ultrazohm/uz_a_ltc2311-16/-5V_PCB/PowerManagement_neg5V/Project Outputs for PowerManagement_neg5V/BOM/BOM_PowerManagement_neg5V_1v03.xls

Quantity | Comment | Designator | MF | MPN | Value | Description | Footprint | Package | Voltage | Dielectric | Supplier 1 | Supplier Part Number 1 | Supplier 2 | Supplier Part Number 2 | Supplier 3 | Supplier Part Number 3
3 | 220µF | C1, C8, C20 | Würth Elektronik | 860020574012 | 220 µF | WCAP-ATG5 Aluminum Electrolytic Capacitors, 8x11.5mm, 35 Vdc, 220 uF | WCAP-ATG5_8x11.5x3.5 |  | 35 Vdc, 35Vdc |  | Mouser | 710-860020574012
2 | 10nF | C2, C14 | Würth | 885012206065 | 10nF |  | CAPC1608X07N | 603 | 25V | X7R | Mouser | 710-885012206065 | Digi-Key | 732-7983-1-ND
2 | 7.5nF | C3, C15 | KEMET | C0603C752J3GACTU | 7.5nF |  | CAPC1608X07N | 603 | 25V | C0G | Mouser | 80-C0603C752J3GACTU
4 | 10µF | C4, C5, C16, C17 | Murata Electronics | GRT31CC8YA106KE01L | 10µF | Capacitor 1206 | C_1206 | 1206 | 35V | X6S | Mouser | 81-GRT31CC8YA106KE1L
7 | 100nF | C6, C9, C21, C31, C32, C33, C34 | Würth | 885012206071 | 100nF |  | CAPC1608X07N | 603 | 25V | X7R | Mouser | 710-885012206071 | Digi-Key, [NoValue] | 732-7989-1-ND, [NoValue]
2 | 0.027µF | C7, C19 | Murata Electronics | GRM3195C1H273JA01D | 0.027µF | Capacitor 1206 | C_1206 | 1206 | 50V | C0G | Mouser | 81-GRM315C1H273JA01D
4 | 47µF | C10, C11, C22, C23 | Murata Electronics | GRM31CR61A476ME15L | 47µF | Capacitor 1206 | C_1206 | 1206 | 10V | X5R | Mouser | 81-GRM31CR61A476ME5L
4 | 1µF | C12, C13, C24, C25 | Murata Electronics | GRT188R61H105KE13D | 1µF |  | CAPC1608X07N | 603 | 50V | X5R | Mouser | 81-GRT188R61H105KE3D | Digi-Key | 490-12330-1-ND
1 | 100nF | C18 | Taiyo Yuden | GMK107B7104KAHT | 100nF |  | CAPC1608X07N | 603 | 35V | X7R | Mouser | 963-GMK107B7104KAHT | Digi-Key | 587-3354-1-ND
2 | 56pF | C26, C30 | Vishay | VJ0603A560JXACW1BC | 56pF |  | CAPC1608X07N | 603 | 50V | C0G | Mouser | 77-VJ0603A560JXACBC
2 | 680pF | C27, C29 | Vishay | VJ0603A681GXJCW1BC | 680pF |  | CAPC1608X07N | 603 | 16V | C0G | Mouser | 77-VJ0603A681GXJCBC
1 | 470pF | C28 | Vishay | VJ0603A471JXJCW1BC | 470pF |  | CAPC1608X07N | 603 | 16V | C0G | Mouser | 77-VJ0603A471JXJCBC
2 | BYS12-90 | D1, D2 | Vishay | BYS12-90-E3/TR3 |  | Schottky Diode | DIOM4227X23N | DO-214AC |  |  | Farnell | 2889144 | Mouser | 625-BYS12-90-E3/TR3 | Digi-Key | BYS12-90-E3/GICT-ND
2 | 1714955 | J1, J2 |  |  |  | Conn Terminal Blocks 2 POS 6.35mm Solder ST Thru-Hole 32A | PHOE-1714955_V |  | 300V |  | Mouser | 651-1714955
2 | TSW-102-07-S-S | J3, J8 |  |  |  | SAMTEC TSW-102-07-S-S CONNECTOR, HEADER, 2 POSITION, 1ROW, 2.54MM | SMTC-TSW-102-07-S-S |  |  |  | Mouser | 200-TSW10207SS
4 | 5-1634503-1 | J4, J5, J6, J7 |  |  |  | BNC Str PCB Skt 50Ohm Nickel Pltd | TECO-5-1634503-1_V |  |  |  | Mouser | 571-5-1634503-1
2 | 600Ω | L1, L3 | Würth Elektronik, Wurth Elektronik | 742792040 | 600Ω | WE-CBF SMD EMI Suppression Ferrite Bead, 0805, 600Ω | WE-CBF_0805_High Current |  |  |  | Farnell | 2761567, 1635735 | Mouser | 710-742792040 | Digi-Key | 732-1620-1-ND
2 | 150µH | L2, L4 | EPCOS / TDK | B82464G4154M | 150µH | SMT power Inductor, 150uH, 320m DRC | SMT_inductor_1050_Performance |  |  |  | Mouser | 871-B82464G4154M
4 | mounting hole 3,4mm | MH1, MH2, MH3, MH4 |  |  |  | Non plated through hole, 3.4mm | MH_3.4
2 | 162k | R1, R7 | Bourns | CR0603-FX-1623ELF | 162k |  | RESC1608X06N | 603 |  |  | Mouser | 652-CR0603-FX1623ELF
2 | 75k | R2, R8 | Yageo | AC0603FR-1375KL | 75k |  | RESC1608X06N | 603 |  |  | Mouser | 603-AC0603FR-1375KL
8 | 1k | R3, R6, R9, R12, R13, R14, R18, R21 | Vishay / Dale | CRCW06031K00JNEAC | 1k |  | RESC1608X06N | 603 |  |  | Mouser | 71-CRCW06031K00JNEAC
4 | dnp | R4, R10, R20, R23 |  |  | dnp |  | RESC1608X06N | 603
2 | 133k | R5, R11 | Bourns | CR0603-FX-1333ELF | 133k |  | RESC1608X06N | 603 |  |  | Mouser | 652-CR0603FX-1333ELF
2 | 24R9 | R15, R17 | Yageo | RC0603FR-1324R9L | 24R9 |  | RESC1608X06N | 603 |  |  | Mouser | 603-RC0603FR-1324R9L
1 | dnp | R16 | ARCOL/Ohmite | APC1206B200RN | dnp | WID SMD 1M 5% 0,25W | RESC3216X65N |  |  |  | Mouser | 284-APC1206B200RN
1 | 0R | R19 | Vishay / Dale | CRCW06030000Z0EBC | 0R |  | RESC1608X06N | 603 |  |  | Mouser | 71-CRCW06030000Z0EBC
2 | 10k | R22, R24 | Vishay / Dale | CRCW060310K0FKEAC | 10k |  | RESC1608X06N | 603 |  |  | Mouser | 71-CRCW060310K0FKEAC
1 | 24V_P | TP1 |  |  |  | Test Point; Compact; THM; PC; .350 L; .125 OD; Heat Resistant Nylon 46; Black | TP_5006 |  |  |  | Mouser | 534-5006
1 | +5V | TP2 |  |  |  | Test Point; Compact; THM; PC; .350 L; .125 OD; Heat Resistant Nylon 46; Black | TP_5006 |  |  |  | Mouser | 534-5006
2 | GND | TP3, TP11 |  |  |  | Test Point; Compact; THM; PC; .350 L; .125 OD; Heat Resistant Nylon 46; Black | TP_5006 |  |  |  | Mouser | 534-5006
1 | SW_N | TP4 |  |  |  | Test Point; Compact; THM; PC; .350 L; .125 OD; Heat Resistant Nylon 46; Black | TP_5006 |  |  |  | Mouser | 534-5006
1 | 24V_N | TP5 |  |  |  | Test Point; Compact; THM; PC; .350 L; .125 OD; Heat Resistant Nylon 46; Black | TP_5006 |  |  |  | Mouser | 534-5006
1 | FB_N | TP6 |  |  |  | Test Point; Compact; THM; PC; .350 L; .125 OD; Heat Resistant Nylon 46; Black | TP_5006 |  |  |  | Mouser | 534-5006
1 | -5V | TP7 |  |  |  | Test Point; Compact; THM; PC; .350 L; .125 OD; Heat Resistant Nylon 46; Black | TP_5006 |  |  |  | Mouser | 534-5006
1 | AMP+ | TP8 |  |  |  | Test Point; Compact; THM; PC; .350 L; .125 OD; Heat Resistant Nylon 46; Black | TP_5006 |  |  |  | Mouser | 534-5006
1 | AMP- | TP9 |  |  |  | Test Point; Compact; THM; PC; .350 L; .125 OD; Heat Resistant Nylon 46; Black | TP_5006 |  |  |  | Mouser | 534-5006
1 | PD | TP10 |  |  |  | Test Point; Compact; THM; PC; .350 L; .125 OD; Heat Resistant Nylon 46; Black | TP_5006 |  |  |  | Mouser | 534-5006
2 | LM5007 | U1, U2 | Texas Instruments | LM5007MM/NOPB |  | Buck Converter, 9-75Vin, 2.5-73Vout | TSOP65P490X110-8N | VSSOP-8 |  |  | Farnell | 3007210 | Mouser | 926-LM5007MM/NOPB | Digi-Key | 296-LM5007MM/NOPBCT-ND
1 | LT6203 | U3 | Analog Devices / Linear Technology | LT6203CMS8#PBF |  | 2 Ch Low Noise, Low Power OpAmp | MSOP8_3x3-8N | MSOP-8 |  |  | Mouser | 584-LT6203CMS8#PBF
1 | THS4521 | U4 |  |  |  | IC AMP RRO NEG OUT VLP 8VSSOP (Single Channel fully differential Amplifier) | DGK0008A_N |  |  |  | Mouser | 595-THS4521IDGKR
