ultrazohm/uz_a_ltc2311-16/Bestuecker_Files/Rev.06/Haushofer_Beistellung_März2022.xlsx

Quantity per PCB | Comment | Designator | MF | Description | Benötigt für 20 PCBs | Aktuell im ZC Lager | Bestellungen | Beigestellte Menge | Shop | Bilanz | ETA
1 | LMK1C1108 | U5 | Texas Instruments | 4-channel output LVCMOS 1.8-V buffer | 20 | 9 | 125 | 25 | digi-key (100) & Mouser (25) | 114 | Mouser delivered | https://www.mouser.de/OrderHistory/OrderDetail.aspx | https://www.digikey.de/MyDigiKey/ReviewOrder | https://wwwapps.ups.com/tracking/tracking.cgi?tracknum=1ZWA47976635939104&requester=ST/trackdetails
1 | LP2985A-25 | U2 | Texas Instruments | 150mA, LDO, Vout = 2.5V, Vin,max = 16V | 20 | 8 | 50 | 50 | Mouser | 38 | delivered | https://www.mouser.de/OrderHistory/OrderDetail.aspx
1 | LT6654-5 | U3 | Analog Devices | 5V Spannungsreferenz | 20 | 0 | 25 | 25 | Mouser | 5 | delivered
1 | BUF634AIDR | U11 | Texas Instruments | IC OP AMP BUFFER 8SOIC | 20 | 0 | 25 | 25 | Mouser | 5 | delivered
8 | THS4561 | U15A, U15B, U15C, U15D, U15E, U15F, U15G, U15H | Texas Instruments | IC AMP RRO NEG OUT VLP 8VSSOP (Single Channel fully differential Amplifier) | 160 | 40 | 130 | 170 | Mouser | 10 | delivered
8 | LT6203 | U7A, U7B, U7C, U7D, U7E, U7F, U7G, U7H | Linear Technology | 2 Ch Low Noise, Low Power OpAmp | 160 | 13 | 170 | 170 | RS | 23 | delivered
1 | IPL1-108-01-L-D-RA-K | X2 | SAMTEC |  | 20 | 0 | 25 | 25 | SAMTEC | 5 | delivered
8 | LTC2311 | U6A, U6B, U6C, U6D, U6E, U6F, U6G, U6H | Analog Devices | 16 Bit SAR ADC, 5MSps | 160 | 80 | 111 | 191 | Verical/Arrow | 31 | delivered on Feb 14 | https://www.verical.com/account/order-detail/WEB-SO2847811 | https://www.fedex.com/fedextrack/?trknbr=566458541843&trkqual=2459621000~566458541843~FX
2 | LM5007 | U1, U4 | Texas Instruments | Buck Converter, 9-75Vin, 2.5-73Vout | 40 | 48 | 44 | 44 | Win-Source | 52 | delivered on Feb 7
1 | TPS7A49 | U9 | Texas Instruments | +36V, +150mA, Ultralow-Noise, Positive LINEAR REGULATOR, DGN0008D | 20 | 10 | 22 | 22 | Win-Source | 12 | delivered on Feb 7
1 | TPS7A30 | U8 | Texas Instruments | -36V, -200mA, Ultralow-Noise, High PSRR, Adjustable -1.18 to -33 V Output, Negative Linear Regulator, 8-pin MSOP (DGN), -40 to 125 degC, Green (RoHS & no Sb/Br) | 20 | 32 |  | 32 |  | 12
1 | LP2985A-50 | U10 | Texas Instruments | 150mA, LDO, Vout = 5V, Vin,max = 16V | 20 | 32 |  | 22 |  | 12
1 | LP2985A-18 | U14 | Texas Instruments | 150mA, LDO, Vout = 1.8V , Vin,max = 16V | 20 | 32 |  | 22 |  | 12
16 | D5V0L1B2WS-7 | D6 | DIODES INCORPORATED | ESD Suppressor Diode TVS Bi-Dir 5V 2-Pin SOD-323 T/R | 320 | 0 | 500 | 500 | Arrow | 180 | delivered | https://www.arrow.com/en/account/order/order-history-detail/WEB-SO25999510
 |  |  |  |  | Number of PCBs | 20
