ultrazohm/uz_a_ltc2311-16/Bode100_Measurements/ADC_Rev05_150kHz_2021-08-10T10_49_16.pdf

## Measurement: Gain / Phase

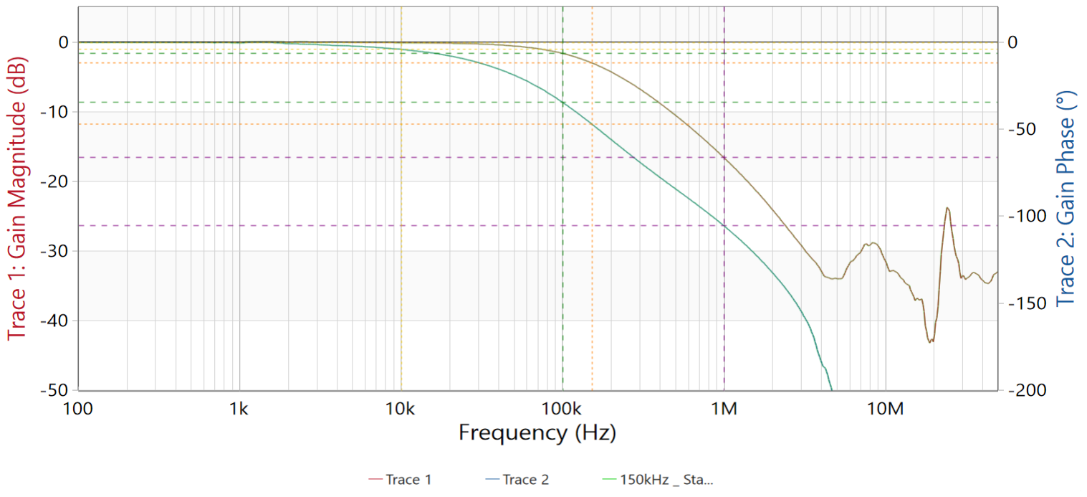
[picture p1: figure]

10.08.2021, 10:49 | ADC_Rev05_150kHz_2021-08-10T10_49_16.pdf | Page 1/1
10kHz | 100kHz | -3dB
Frequency | 10 kHz | 100 kHz | 152,169 kHz
Trace 1 | Magnitude (dB) | Magnitude (dB) | | Magnitude (dB)
Measurement | -104,986 mdB | -1,632 dB | | -3 dB
Trace 2 | Phase (°) | Phase (°) | | Phase (°)
Measurement | -4,184 ° | -34,582 ° | | -47,158 °

1MHz
Frequency | 1 MHz
Trace 1 | Magnitude (dB)
Measurement | -16,572 dB
Trace 2 | Phase (°)
Measurement | -105,458 °
Sweep | | Calibration | Full-Range | User-Range
Start frequency: | 100 Hz | Gain | Active | -
Stop frequency: | 50 MHz
Center frequency: | 25 MHz | Termination | Channel 1 | Channel 2
Span: | 50 MHz | Gain | 1 MΩ | 1 MΩ
Sweep mode: | Logarithmic
Numer of points: | 801 | Attenuator setting | Channel 1 | Channel 2
| | Transmission | 0 dB | 20 dB
Hardware setup
Device type: | Bode100R2 | Probe factor | Channel 1 | Channel 2
Serial number: | PG276H | Gain | 10: 1 | 1: 1
Receiver bandwidth: | 300 Hz
Output level: | 7 dBm
DUT settling time: | 1 ms
