ultrazohm/uz_a_ltc2311-16/-5V_PCB/Measurements/ADC_LTC2311-16_-5VTestingPCB_ExternalPowerSupply_VoltageFollowers.xlsx

Sheet: Single-ended
Single Ended vs GND |  |  |  |  | VCC+ | +5,196 V
Input: 100Ohm in series 100pF to GND, ±5.2V by external power supply |  |  |  |  | VCC- | -5,202 V |  |  |  | ! measurements vary in 10uV scope
Measurement without diff amp (just voltge-follower)
In_P | In_P
In_N | GND
LT1819 |  |  |  |  | AD8092 |  |  |  |  | ADA4851 |  |  |  |  | LT6203
In_P | Buf_P to GND | Buf_N to GND | Buf_P to Buf_N | abs deviation | In_P | Buf_P to GND | Buf_N to GND | Buf_P to Buf_N | abs deviation | In_P | Buf_P to GND | Buf_N to GND | Buf_P to Buf_N | abs deviation | In_P | Buf_P to GND | Buf_N to GND | Buf_P to Buf_N | abs deviation
5.20 | 4.643 | 3.7e-05 | 4.6429 | -557.10 mV | 5.20 | 4.5563 | 0.000368 | 4.5559 | -644.10 mV | 5.20 | 3.6049 | -0.000551 | 3.6047 | -1595.30 mV | 5.20 | 5.1909 | 0.000802 | 5.19 | -10.00 mV
5.10 | 4.643 | 3.8e-05 | 4.649 | -451.00 mV | 5.10 | 4.5563 | 0.00037 | 4.5559 | -544.10 mV | 5.10 | 3.6048 | -0.00055 | 3.6054 | -1494.60 mV | 5.10 | 5.1022 | 0.0008 | 5.1014 | 1.40 mV
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
