ultrazohm/uz_a_ltc2311-16/-5V_PCB/Measurements/ADC_LTC2311-16_-5VTestingPCB_InternalPowerSupply_5.2Vrails.xlsx

Sheet: Single-ended
Single Ended vs GND with 10kOhm, 0.1% feedback resistors |  |  |  | VCC+ | +5,196 V
Input: 100Ohm in series 100pF to GND, ±5.2V by internal power supply |  |  |  | VCC- | -5,203 V | L = 100uH | ! measurements vary in 10uV scope
In_P | In_P
In_N | GND
In_P | Vout P to N | abs deviation | rel deviation | Buf_P to GND | Buf_N to GND | Buf_P to Buf_N
5.20 | 5.14214 | -57.86 mV |  | 5.1856 | 0.000801 | 5.1848
5.10 | 5.10097 | 0.97 mV |  | 5.1022 | 0.000802 | 5.1014
5.00 | 5.0011 | 1.12 mV |  | 5.0021 | 0.000803 | 5.0013
4.90 | 4.9010 | 1.00 mV |  | 4.902 | 0.000804 | 4.9012
4.75 | 4.7512 | 1.20 mV |  | 4.7522 | 0.000803 | 4.7514
4.60 | 4.6011 | 1.07 mV |  | 4.602 | 0.000803 | 4.6013
4.50 | 4.5009 | 0.95 mV |  | 4.5019 | 0.000801 | 4.502
4.40 | 4.4009 | 0.87 mV |  | 4.4018 | 0.000802 | 4.401
4.00 | 3.9999 | -0.12 mV |  | 4.0009 | 0.000802 | 4.0009
3.75 | 3.7499 | -0.07 mV |  | 3.7509 | 0.0008 | 3.7501
3.50 | 3.5000 | 0.02 mV |  | 3.501 | 0.000799 | 3.5003
3.25 | 3.2498 | -0.20 mV |  | 3.2508 | 0.000799 | 3.25
3.00 | 2.9999 | -0.10 mV |  | 3.0009 | 0.000798 | 3.0001
2.00 | 1.9996 | -0.40 mV |  | 2.0006 | 0.000795 | 1.9998
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
