ultrazohm/uz_a_ltc2311-16/-5V_PCB/Measurements/ADC_LTC2311-16_-5VTestingPCB_InternalPowerSupply_5.2Vrails_BestFitCurve.xlsx

Sheet: Single-ended
Single Ended vs GND with 10kOhm, 0.1% feedback resistors |  |  |  |  | VCC+ | +5,196 V
Input: 100Ohm in series 100pF to GND, ±5.2V by internal power supply |  |  |  |  | VCC- | -5,203 V | L = 100uH | ! measurements vary in 10uV scope
In_P | In_P
In_N | GND
 |  |  | y = 0,9988x + 0,0001
In_P | Vout P to N | abs deviation | fitted formula x=(y-0,0001)/0,9988 | rel deviation %
5.20 | 5.14214 | -57.86 mV | 5.206147377 | -0.1182187856
5.10 | 5.10097 | 0.97 mV | 5.106027233 | -0.1181810329
5.00 | 5.0011 | 1.12 mV | 5.005907089 | -0.1181417701
4.90 | 4.9010 | 1.00 mV | 4.905786944 | -0.1181009048
4.75 | 4.7512 | 1.20 mV | 4.755606728 | -0.1180363805
4.60 | 4.6011 | 1.07 mV | 4.605426512 | -0.1179676481
4.50 | 4.5009 | 0.95 mV | 4.505306368 | -0.1179192809
4.40 | 4.4009 | 0.87 mV | 4.405186223 | -0.1178687152
4.00 | 3.9999 | -0.12 mV | 4.004705647 | -0.1176411694
3.75 | 3.7499 | -0.07 mV | 3.754405286 | -0.1174743025
3.50 | 3.5000 | 0.02 mV | 3.504104926 | -0.1172835975
3.25 | 3.2498 | -0.20 mV | 3.253804565 | -0.1170635532
3.00 | 2.9999 | -0.10 mV | 3.003504205 | -0.1168068349
2.00 | 1.9996 | -0.40 mV | 2.002302763 | -0.1151381658
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
