ultrazohm/uz_a_ltc2311-16/-5V_PCB/Measurements/ADC_LTC2311-16_-5VTestingPCB_InternalPowerSupply_BufferLT6203.xlsx

Sheet: Single-ended
Single Ended vs GND with 10kOhm, 0.1% feedback resistors |  |  |  |  |  | VCC+ | +5,196 V
Input: 100Ohm in series 100pF to GND, ±5.2V by internal power supply |  |  |  |  |  | VCC- | -5,203 V | L = 100uH |  |  |  | ! measurements vary in 10uV scope
In_P | In_P
In_N | GND
Measurement with diff amp connected to the LT6203 |  |  |  |  |  |  | Measurement without diff amp (just LT6203)
In_P | Vout P to N | abs deviation | Buf_P to GND | Buf_N to GND | Buf_P to Buf_N |  | In_P | Buf_P to GND | Buf_N to GND | Buf_P to Buf_N | IN P to N (after RC)
5.20 | 5.14214 | -57.86 mV | 5.1856 | 0.000801 | 5.1848 |  | 5.20 | 5.1909 | 0.000802 | 5.19 | 5.1997
5.10 | 5.10097 | 0.97 mV | 5.1022 | 0.000802 | 5.1014 |  | 5.10 | 5.1022 | 0.0008 | 5.1014 | 5.1
5.00 | 5.0011 | 1.12 mV | 5.0021 | 0.000803 | 5.0013 |  | 5.00 | 5.0021 | 0.0008 | 5.0013 | 4.9999
4.90 | 4.9010 | 1.00 mV | 4.902 | 0.000804 | 4.9012 |  | 4.90 | 4.902 | 0.0008 | 4.9012 | 4.8998
4.75 | 4.7512 | 1.20 mV | 4.7522 | 0.000803 | 4.7514 |  | 4.75 | 4.7522 | 0.0008 | 4.7514 | 4.75
4.60 | 4.6011 | 1.07 mV | 4.602 | 0.000803 | 4.6013 |  | 4.60 | 4.6021 | 0.0008 | 4.6013 | 4.5999
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
