ultrazohm/uz_a_ltc2311-16/-5V_PCB/Measurements/ADC_LTC2311-16_-5VTestingPCB_ExternalPowerSupply_FBresistors.xlsx

Sheet: 1kOhm 1%
Single Ended vs GND with 1kOhm, 1% feedback resistors
Input: 100pF to GND, ±5.0V by power supply unit
In_P | In_P
In_N | GND
In_P | Vout P to N | abs deviation | rel deviation
5.00 | 4.885 | -115.50 mV
4.90 | 4.883 | -17.27 mV
4.75 | 4.752 | 2.03 mV
4.60 | 4.602 | 1.66 mV
4.50 | 4.501 | 1.40 mV
4.40 | 4.401 | 1.14 mV
4.00 | 4.000 | 0.22 mV
3.00 | 2.998 | -2.10 mV
2.00 | 1.996 | -3.90 mV
1.00 | 0.995 | -5.33 mV
0.75 | 0.744 | -5.51 mV
0.50 | 0.494 | -6.04 mV
0.25 | 0.244 | -6.20 mV
0.10 | 0.093 | -6.51 mV
0.05 | 0.043 | -6.62 mV
0.02 | 0.013 | -6.53 mV
0.01 | 0.003 | -6.62 mV
0.00 | -0.006 | -6.33 mV
-0.01 | -0.017 | -6.92 mV
-0.02 | -0.027 | -6.98 mV
-0.05 | -0.057 | -6.86 mV
-0.10 | -0.107 | -6.84 mV
-0.25 | -0.257 | -6.72 mV
-0.50 | -0.506 | -6.21 mV
-0.75 | -0.756 | -6.08 mV
-1.00 | -1.006 | -5.90 mV
-2.00 | -2.004 | -4.30 mV
-3.00 | -3.003 | -3.50 mV
-4.00 | -4.003 | -2.82 mV
-4.40 | -4.403 | -2.68 mV
-4.50 | -4.503 | -2.67 mV
-4.60 | -4.603 | -2.64 mV
-4.75 | -4.753 | -2.62 mV
-4.90 | -4.881 | 19.35 mV
-5.00 | -4.884 | 115.93 mV
 | ! Negative In_P measurements might be better (reference GND of power supply unit)
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
