ultrazohm/uz_a_ltc2311-16/-5V_PCB/Measurements/ADC_LTC2311-16_-5VTestingPCB_InternalPowerSupply_5.0Vrails.xlsx

Sheet: Single-ended
Single Ended vs GND with 10kOhm, 0.1% feedback resistors |  |  |  | VCC+ | +5,005 V
Input: 100pF to GND, ±5.0V by internal power supply |  |  |  | VCC- | -5,001 V | L = 100uH | ! measurements vary in 10uV scope
In_P | In_P
In_N | GND
In_P | Vout P to N | abs deviation | rel deviation | Buf_P to GND | Buf_N to GND | Buf_P to Buf_N
5.00 | 4.9526 | -47.40 mV |  | 4.995 | 0.000624 | 4.9943
4.90 | 4.9014 | 1.40 mV |  | 4.9268 | 0.000625 | 4.9349
4.75 | 4.7516 | 1.65 mV |  | 4.7524 | 0.000625 | 4.7518
4.60 | 4.6015 | 1.50 mV |  | 4.6023 | 0.000625 | 4.6016
4.50 | 4.5014 | 1.40 mV |  | 4.5022 | 0.000627 | 4.5016
4.40 | 4.4013 | 1.29 mV |  | 4.4021 | 0.000625 | 4.4014
4.00 | 4.0009 | 0.87 mV |  | 4.0017 | 0.000626 | 4.001
3.75 | 3.7502 | 0.20 mV |  | 3.751 | 0.000627 | 3.7504
3.50 | 3.5003 | 0.30 mV |  | 3.5011 | 0.000627 | 3.5005
3.25 | 3.2500 | 0.02 mV |  | 3.2508 | 0.000625 | 3.2502
3.00 | 3.0000 | 0.04 mV |  | 3.0009 | 0.000625 | 3.0003
2.00 | 1.9997 | -0.28 mV |  | 2.0006 | 0.000625 | 2
1.00 | 0.9997 | -0.28 mV |  | 1.00063 | 0.000625 | 1
0.75 | 0.7499 | -0.09 mV |  | 0.75084 | 0.000625 | 0.7502
0.50 | 0.4997 | -0.27 mV |  | 0.50066 | 0.000625 | 0.50004
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
