ultrazohm/uz_a_ltc2311-16/-5V_PCB/Measurements/ADC_LTC2311-16_3v2_BufferAmplifiers.xlsx

Single Ended vs GND with 1kOhm, 0.1% feedback resistors |  |  |  |  | VCC+ | +5,196 V
±5.2V by internal power supply (without TVS-diode) |  |  |  |  | VCC- | -5,202 V
Tested on adapter board 3v02
In_P | In_P
In_N | GND
LT6203 |  |  |  |  |  | ADA4807
In_P | Buf_P to Buf_N | abs deviation | Out_P to Out_N | abs deviation |  | In_P | Buf_P to Buf_N | abs deviation | Out_P to Out_N | abs deviation
5.20 | 5.1851 | -14.90 mV | 5.09392 | -106.08 mV |  | 5.20 | 5.1858 | -14.20 mV | 5.09605 | -103.95 mV
5.10 | 5.1011 | 1.10 mV | 5.04148 | -58.52 mV |  | 5.10 | 5.0997 | -0.30 mV | 5.04191 | -58.09 mV
5.00 | 5.001 | 1.00 mV | 4.97523 | -24.77 mV |  | 5.00 | 5.0001 | 0.10 mV | 4.97588 | -24.12 mV
4.90 | 4.9009 | 0.90 mV | 4.90042 | 0.42 mV |  | 4.90 | 4.9 | 0.00 mV | 4.90052 | 0.52 mV
4.75 | 4.7511 | 1.10 mV | 4.75068 | 0.68 mV |  | 4.75 | 4.7502 | 0.20 mV | 4.75074 | 0.74 mV
4.60 | 4.601 | 1.00 mV | 4.60057 | 0.57 mV |  | 4.60 | 4.6001 | 0.10 mV | 4.60057 | 0.57 mV
4.50 | 4.5009 | 0.90 mV | 4.5005 | 0.50 mV |  | 4.50 | 4.5 | 0.00 mV | 4.50042 | 0.42 mV
4.40 | 4.4008 | 0.80 mV | 4.4004 | 0.40 mV |  | 4.40 | 4.3999 | -0.10 mV | 4.40031 | 0.31 mV
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
