ultrazohm/uz_a_ltc2311-16/-5V_PCB/Comparison_Circuit_FlaviuPoppNowak/ADDA5M_sch.pdf

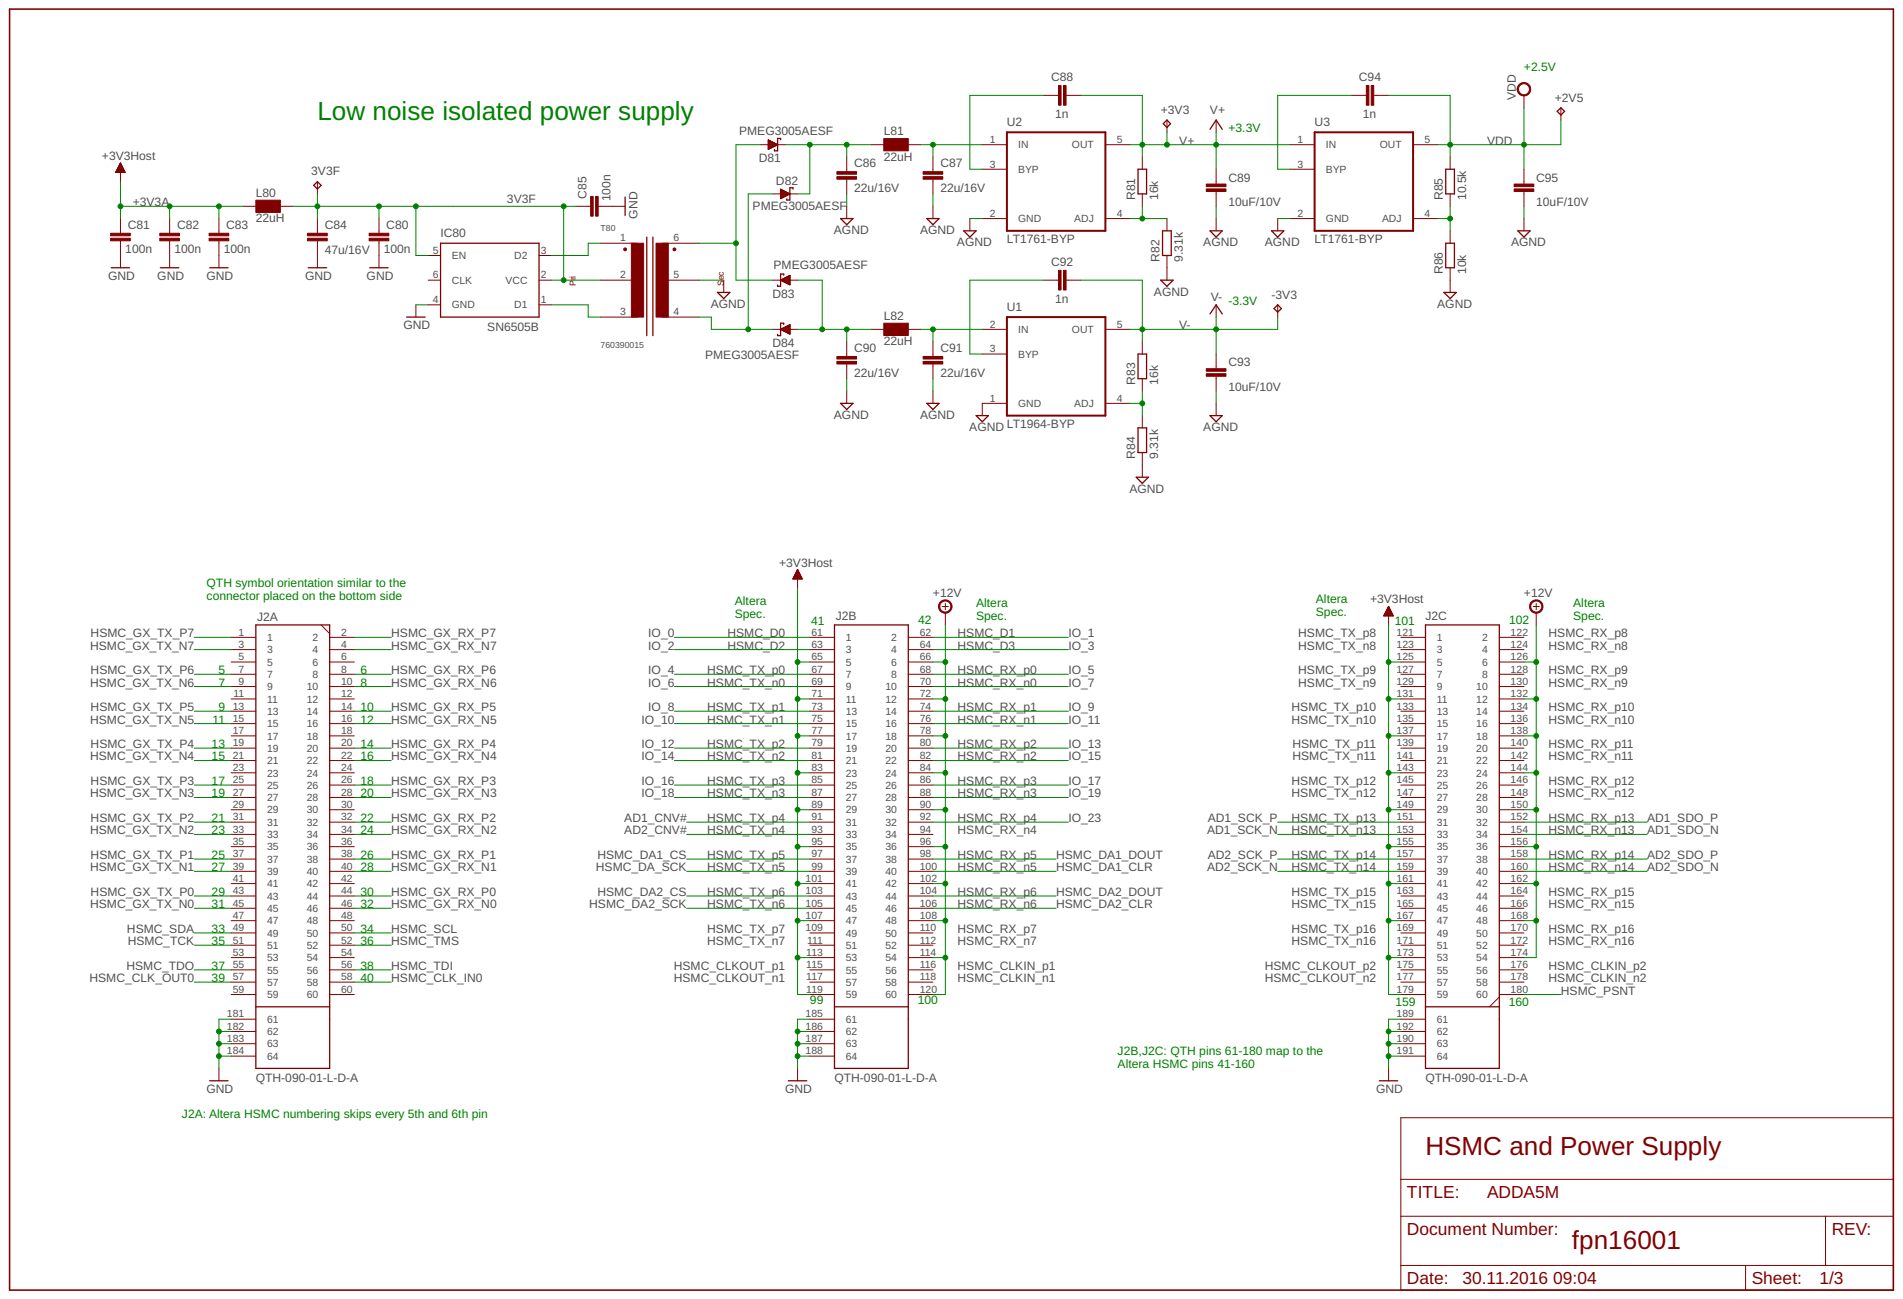
[picture p2: page 1]

+2.5V Low noise isolated power supply

QTH symbol orientation similar to the
connector placed on the bottom side
HSMC_GX_TX_P7 HSMC_GX_TX_N7 HSMC_GX_TX_P6 HSMC_GX_TX_N6 HSMC_GX_TX_P5 HSMC_GX_TX_N5 HSMC_GX_TX_P4 HSMC_GX_TX_N4 HSMC_GX_TX_P3 HSMC_GX_TX_N3 HSMC_GX_TX_P2 HSMC_GX_TX_N2 HSMC_GX_TX_P1 HSMC_GX_TX_N1

J2B,J2C: QTH pins 61-180 map to the Altera HSMC pins 41-160

J2A: Altera HSMC numbering skips every 5th and 6th pin

HSMC and Power Supply

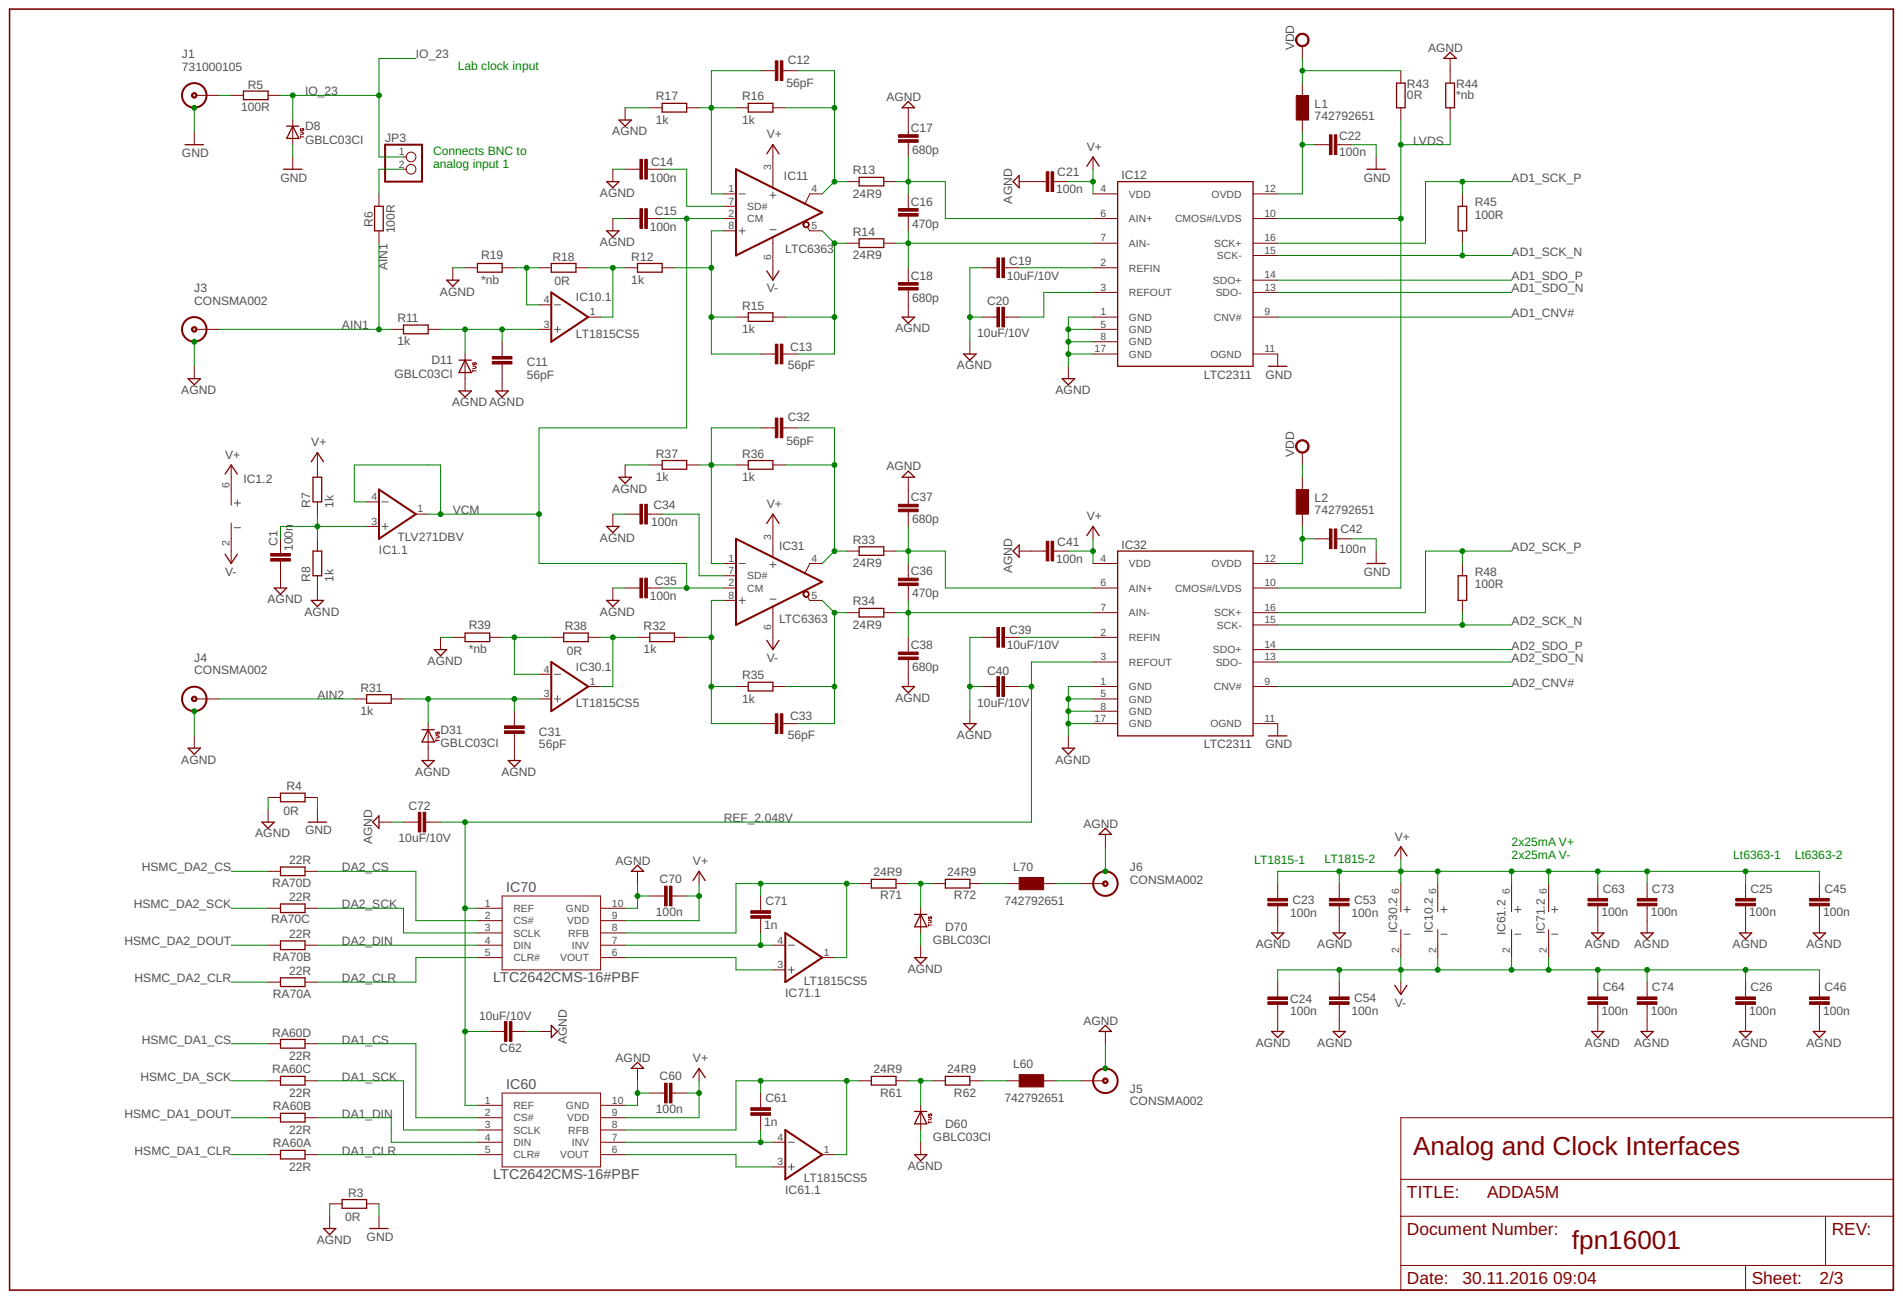
[picture p3: page 2]

Analog and Clock Interfaces

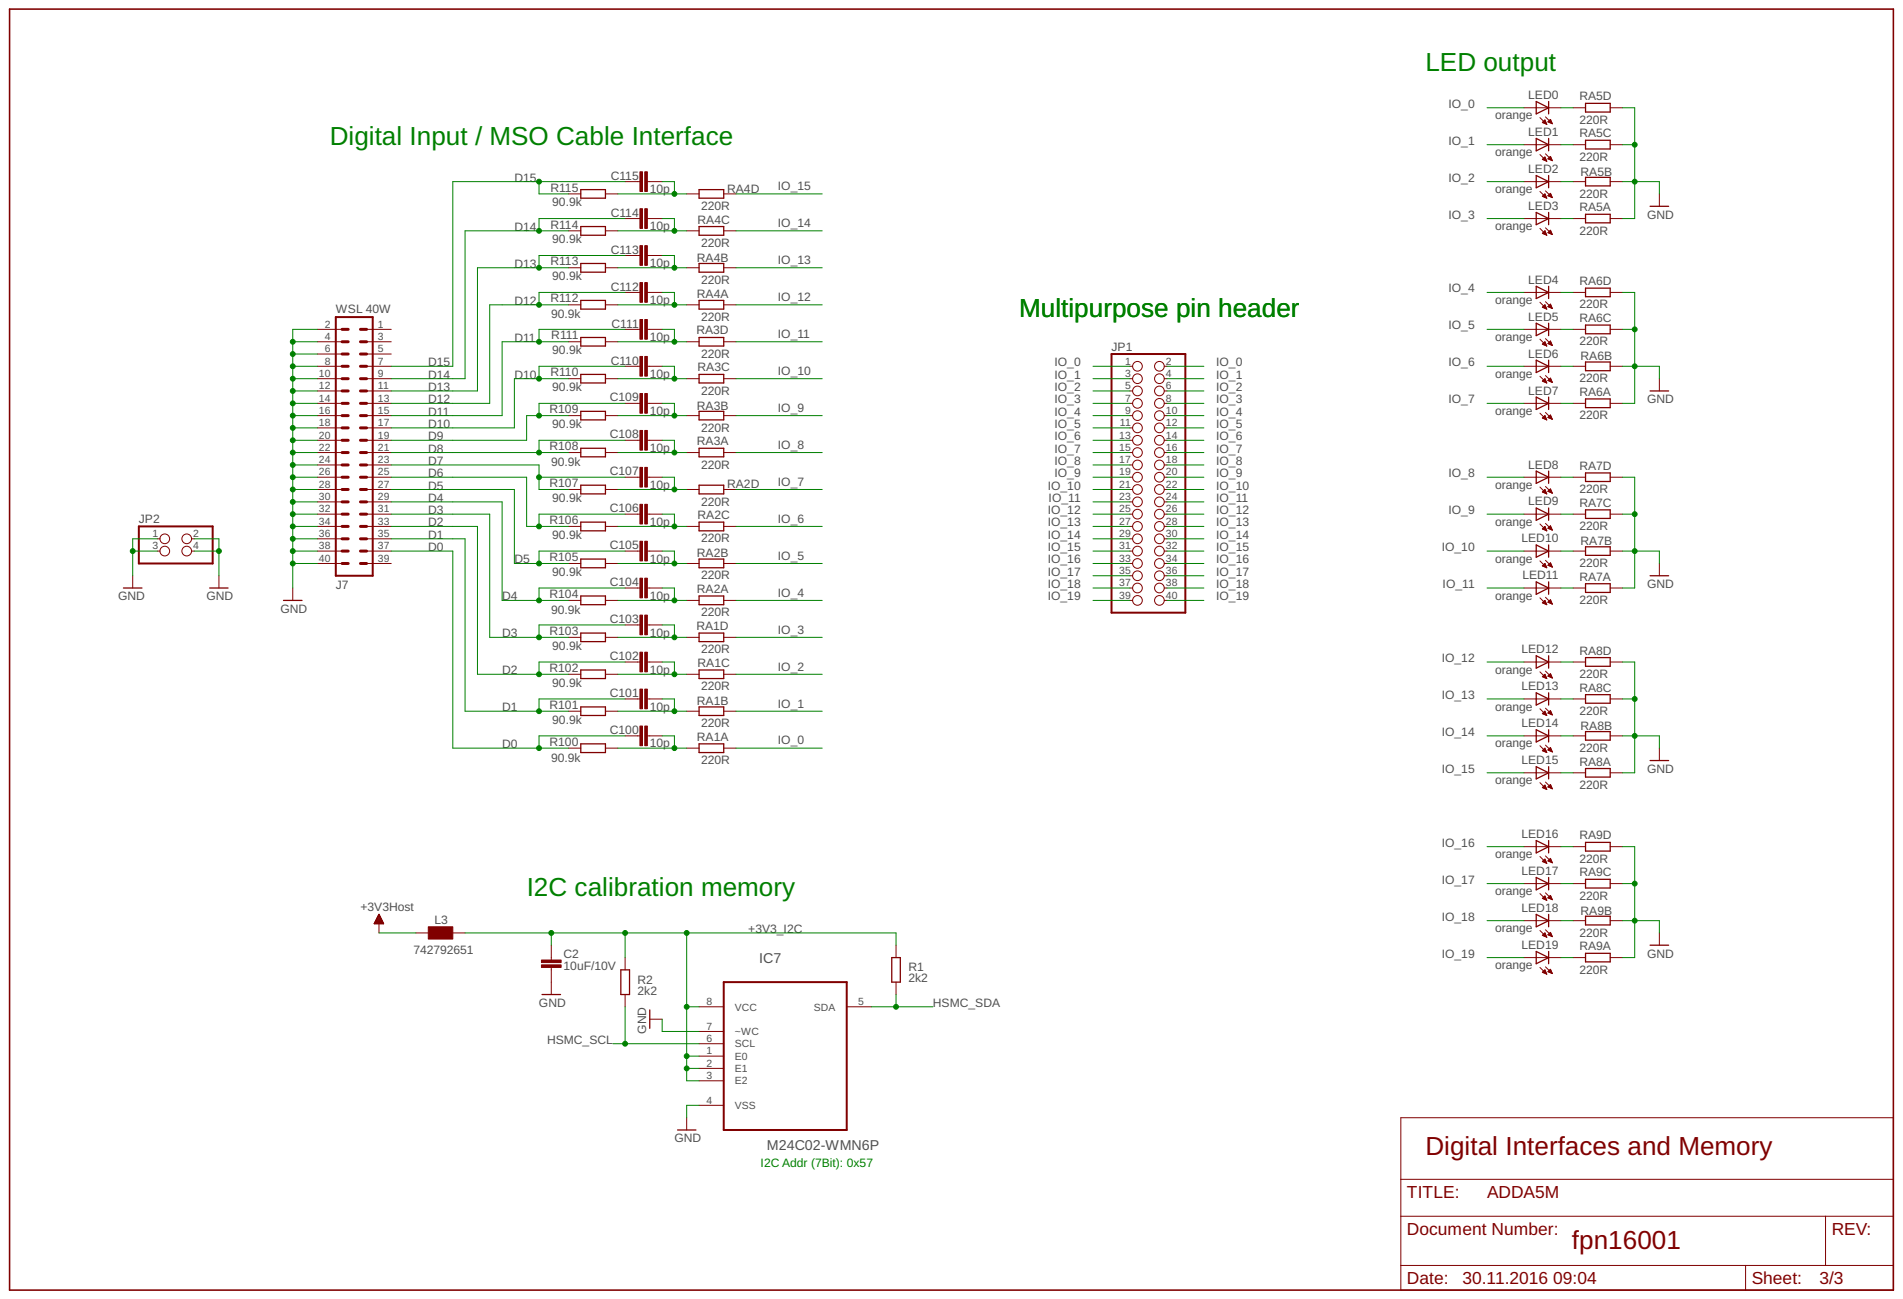
[picture p4: page 3]
