ultrazohm/uz_a_ltc2311-16/-5V_PCB/PowerManagement_neg5V/Project Outputs for PowerManagement_neg5V/SCH_PowerManagement_neg5V_1v03.PDF

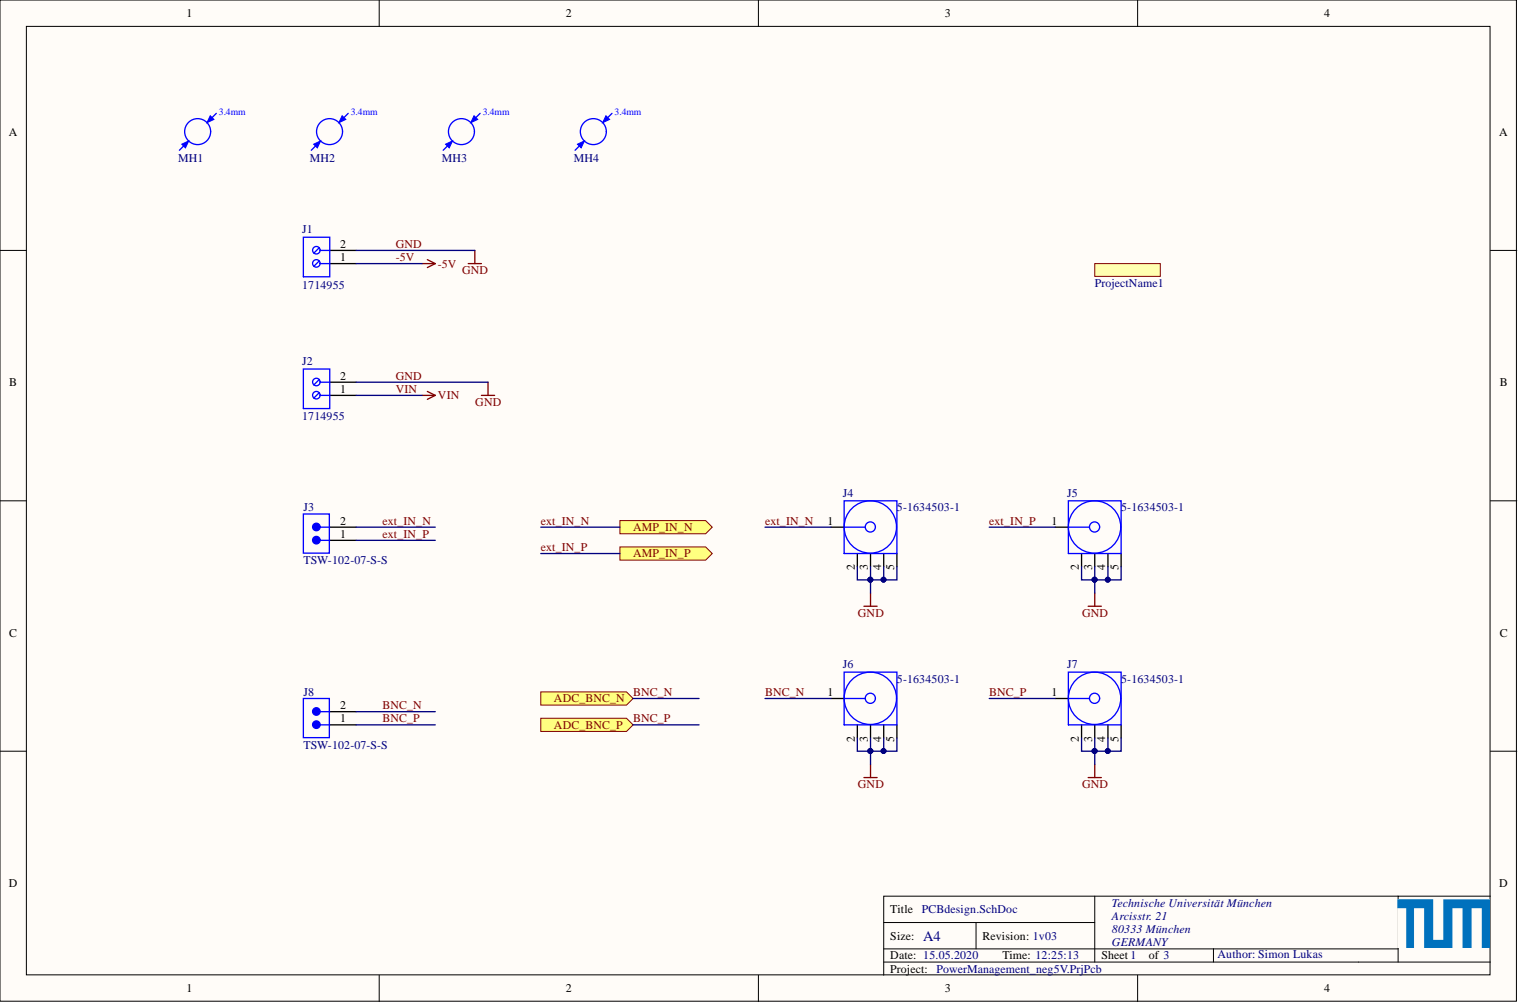
[picture p5: page 1]

Title PCBdesign.SchDoc | Technische Universität München Arcisstr. 21 80333 München GERMANY

Size: A4 | Revision: 1v03
Date: 15.05.2020 Time: 12:25:13 | Sheet of 3 | Author: Simon Lukas

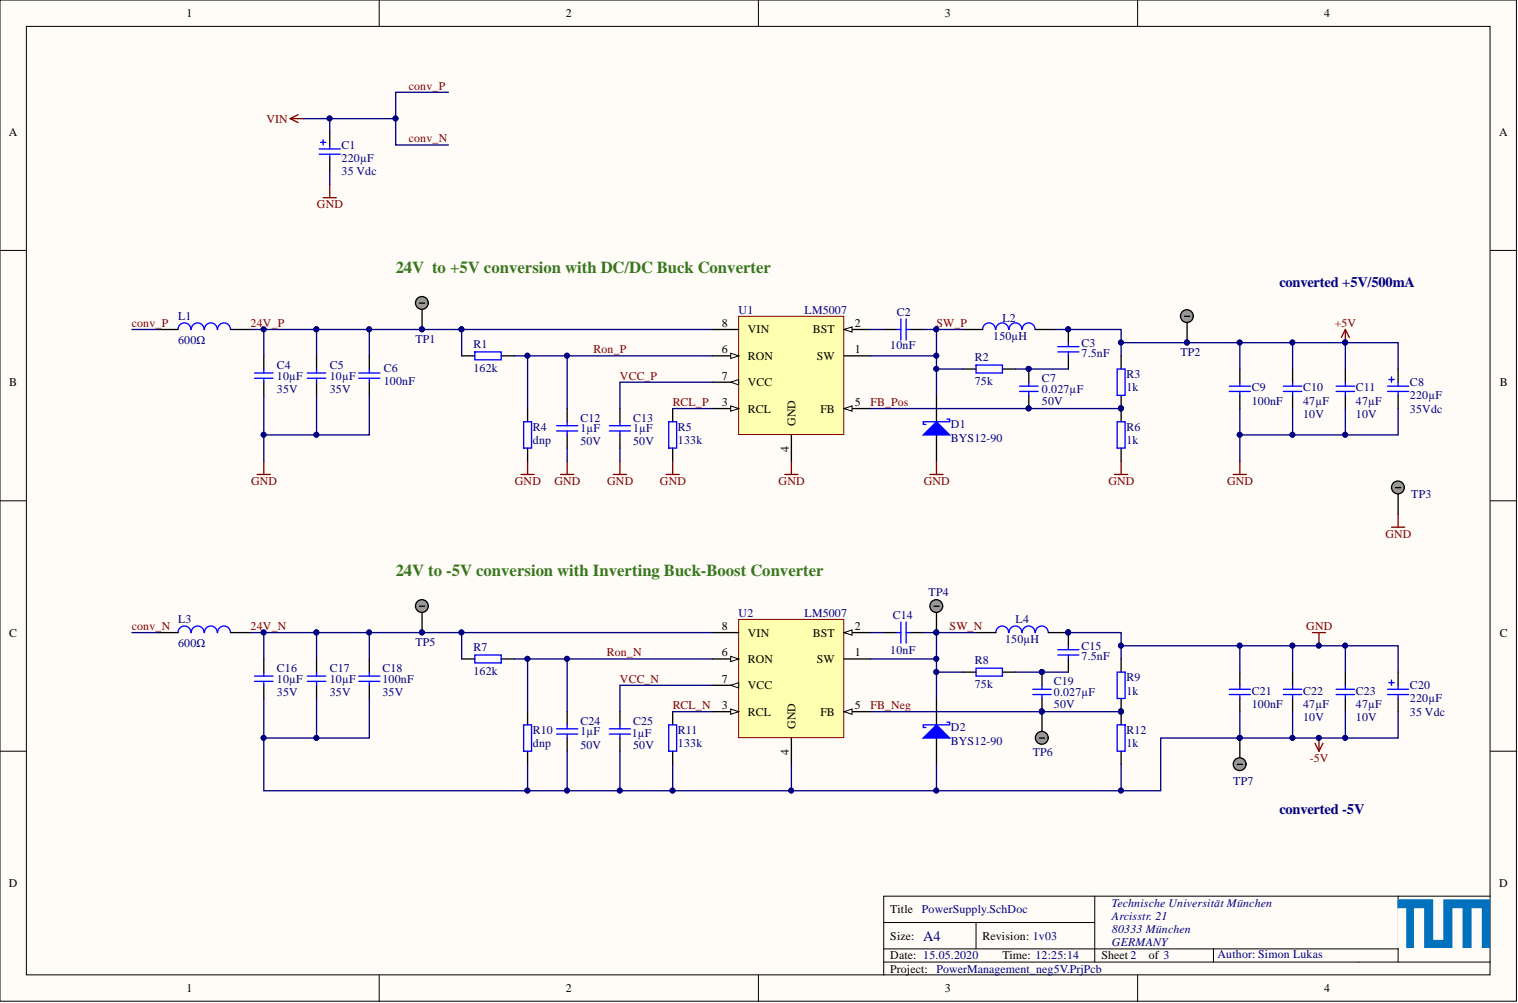
[picture p6: page 2]

24V to +5V conversion with DC/DC Buck Converter

VCC_P | VCC 7

RCL_P | | RCL 3

24V to -5V conversion with Inverting Buck-Boost Converter

VCC_N | VCC 7

RCL_N | | RCL 3

Title PowerSupply.SchDoc | Technische Universität München Arcisstr. 21 80333 München GERMANY

Size: A4 | Revision: 1v03
Date: 15.05.2020 Time: 12:25:14 | Sheet of 3 | Author: Simon Lukas

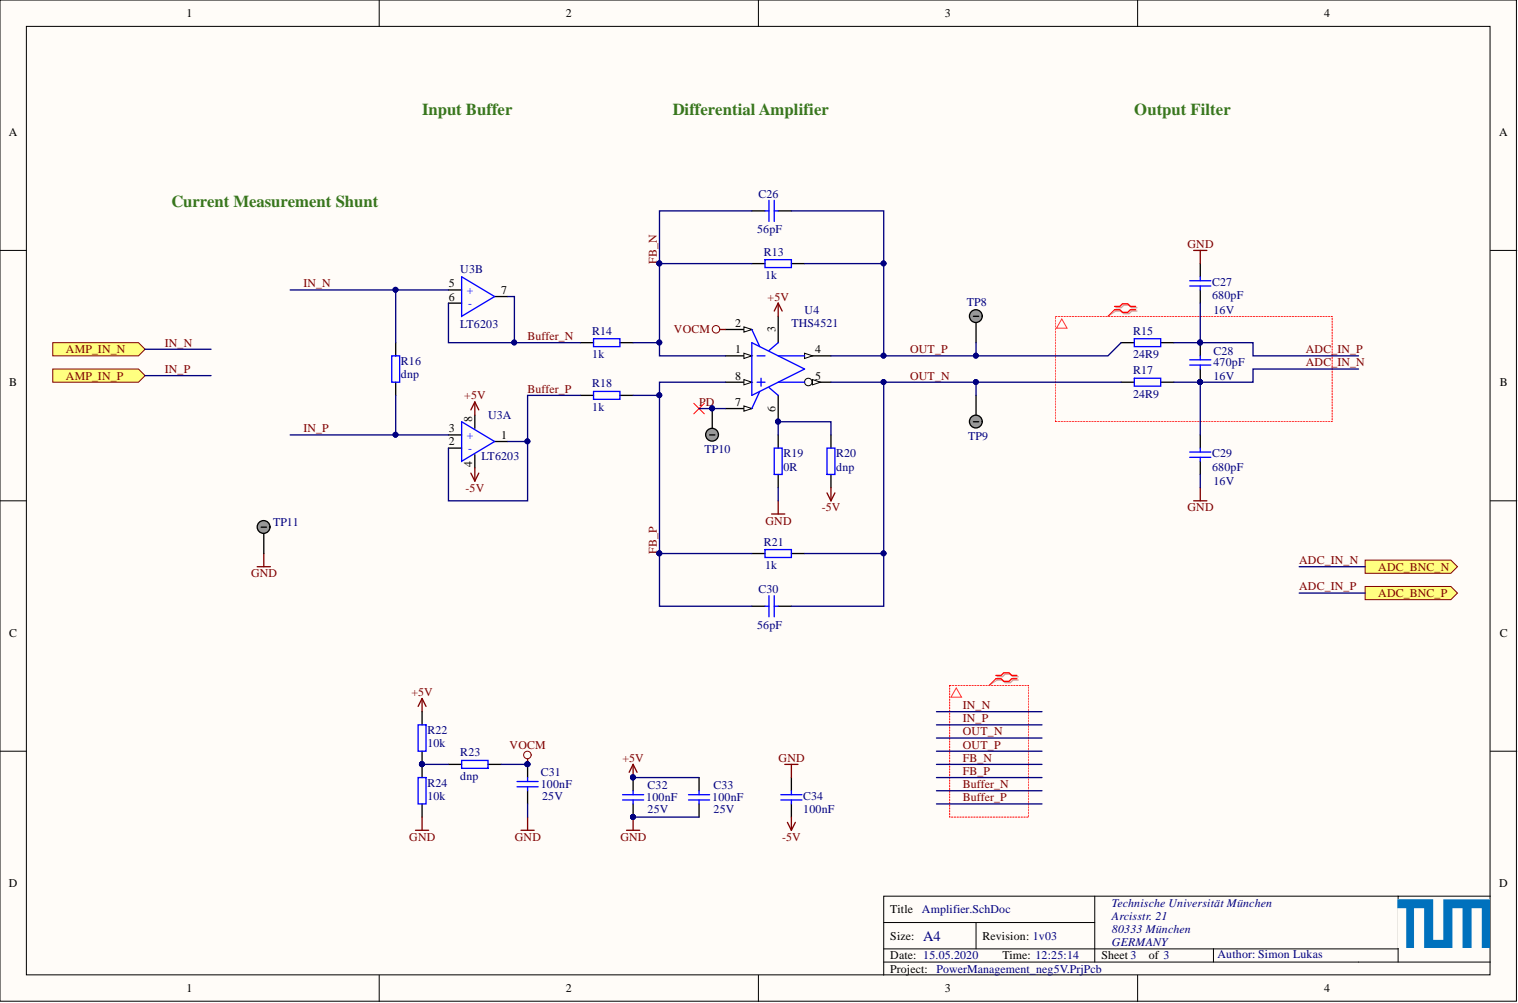
[picture p7: page 3]

T i t l e Amp l ifier.Sch D o c | Tech n i sche Un ivers i t ä t M ü nchen A rci s s t r. 2 1 3 M ü nchen G ER MANY

A | Rev i s i o n : v
5.0 5.2 T ime: : : | Sheet o f | A u t h or: Simo n L u kas
