ultrazohm/uz_a_ltc2311-16/-5V_PCB/Comparison_Circuit_FlaviuPoppNowak/ADDA5M2.pdf

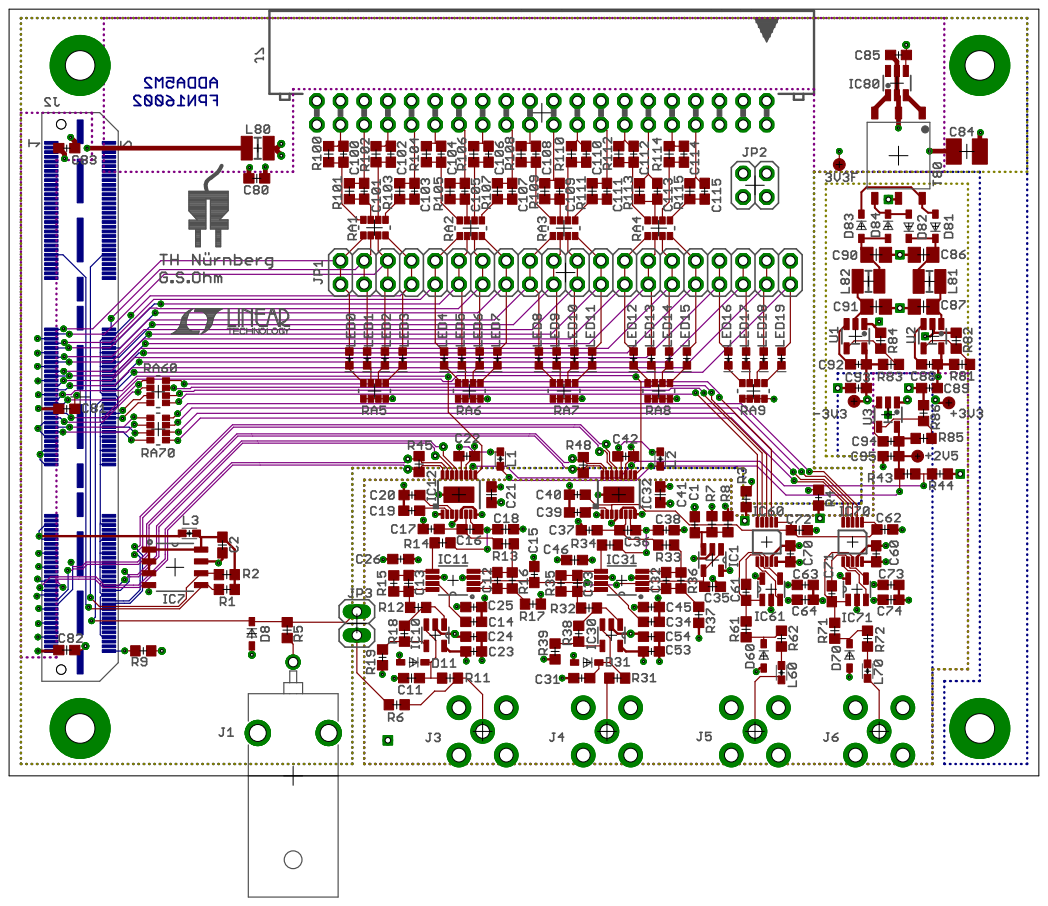
[picture p8: page 1]
