ultrazohm/uz_a_ltc2311-16/-5V_PCB/PowerManagement_neg5V/Project Outputs for PowerManagement_neg5V/ASM_PowerManagement_neg5V_1v03.PDF

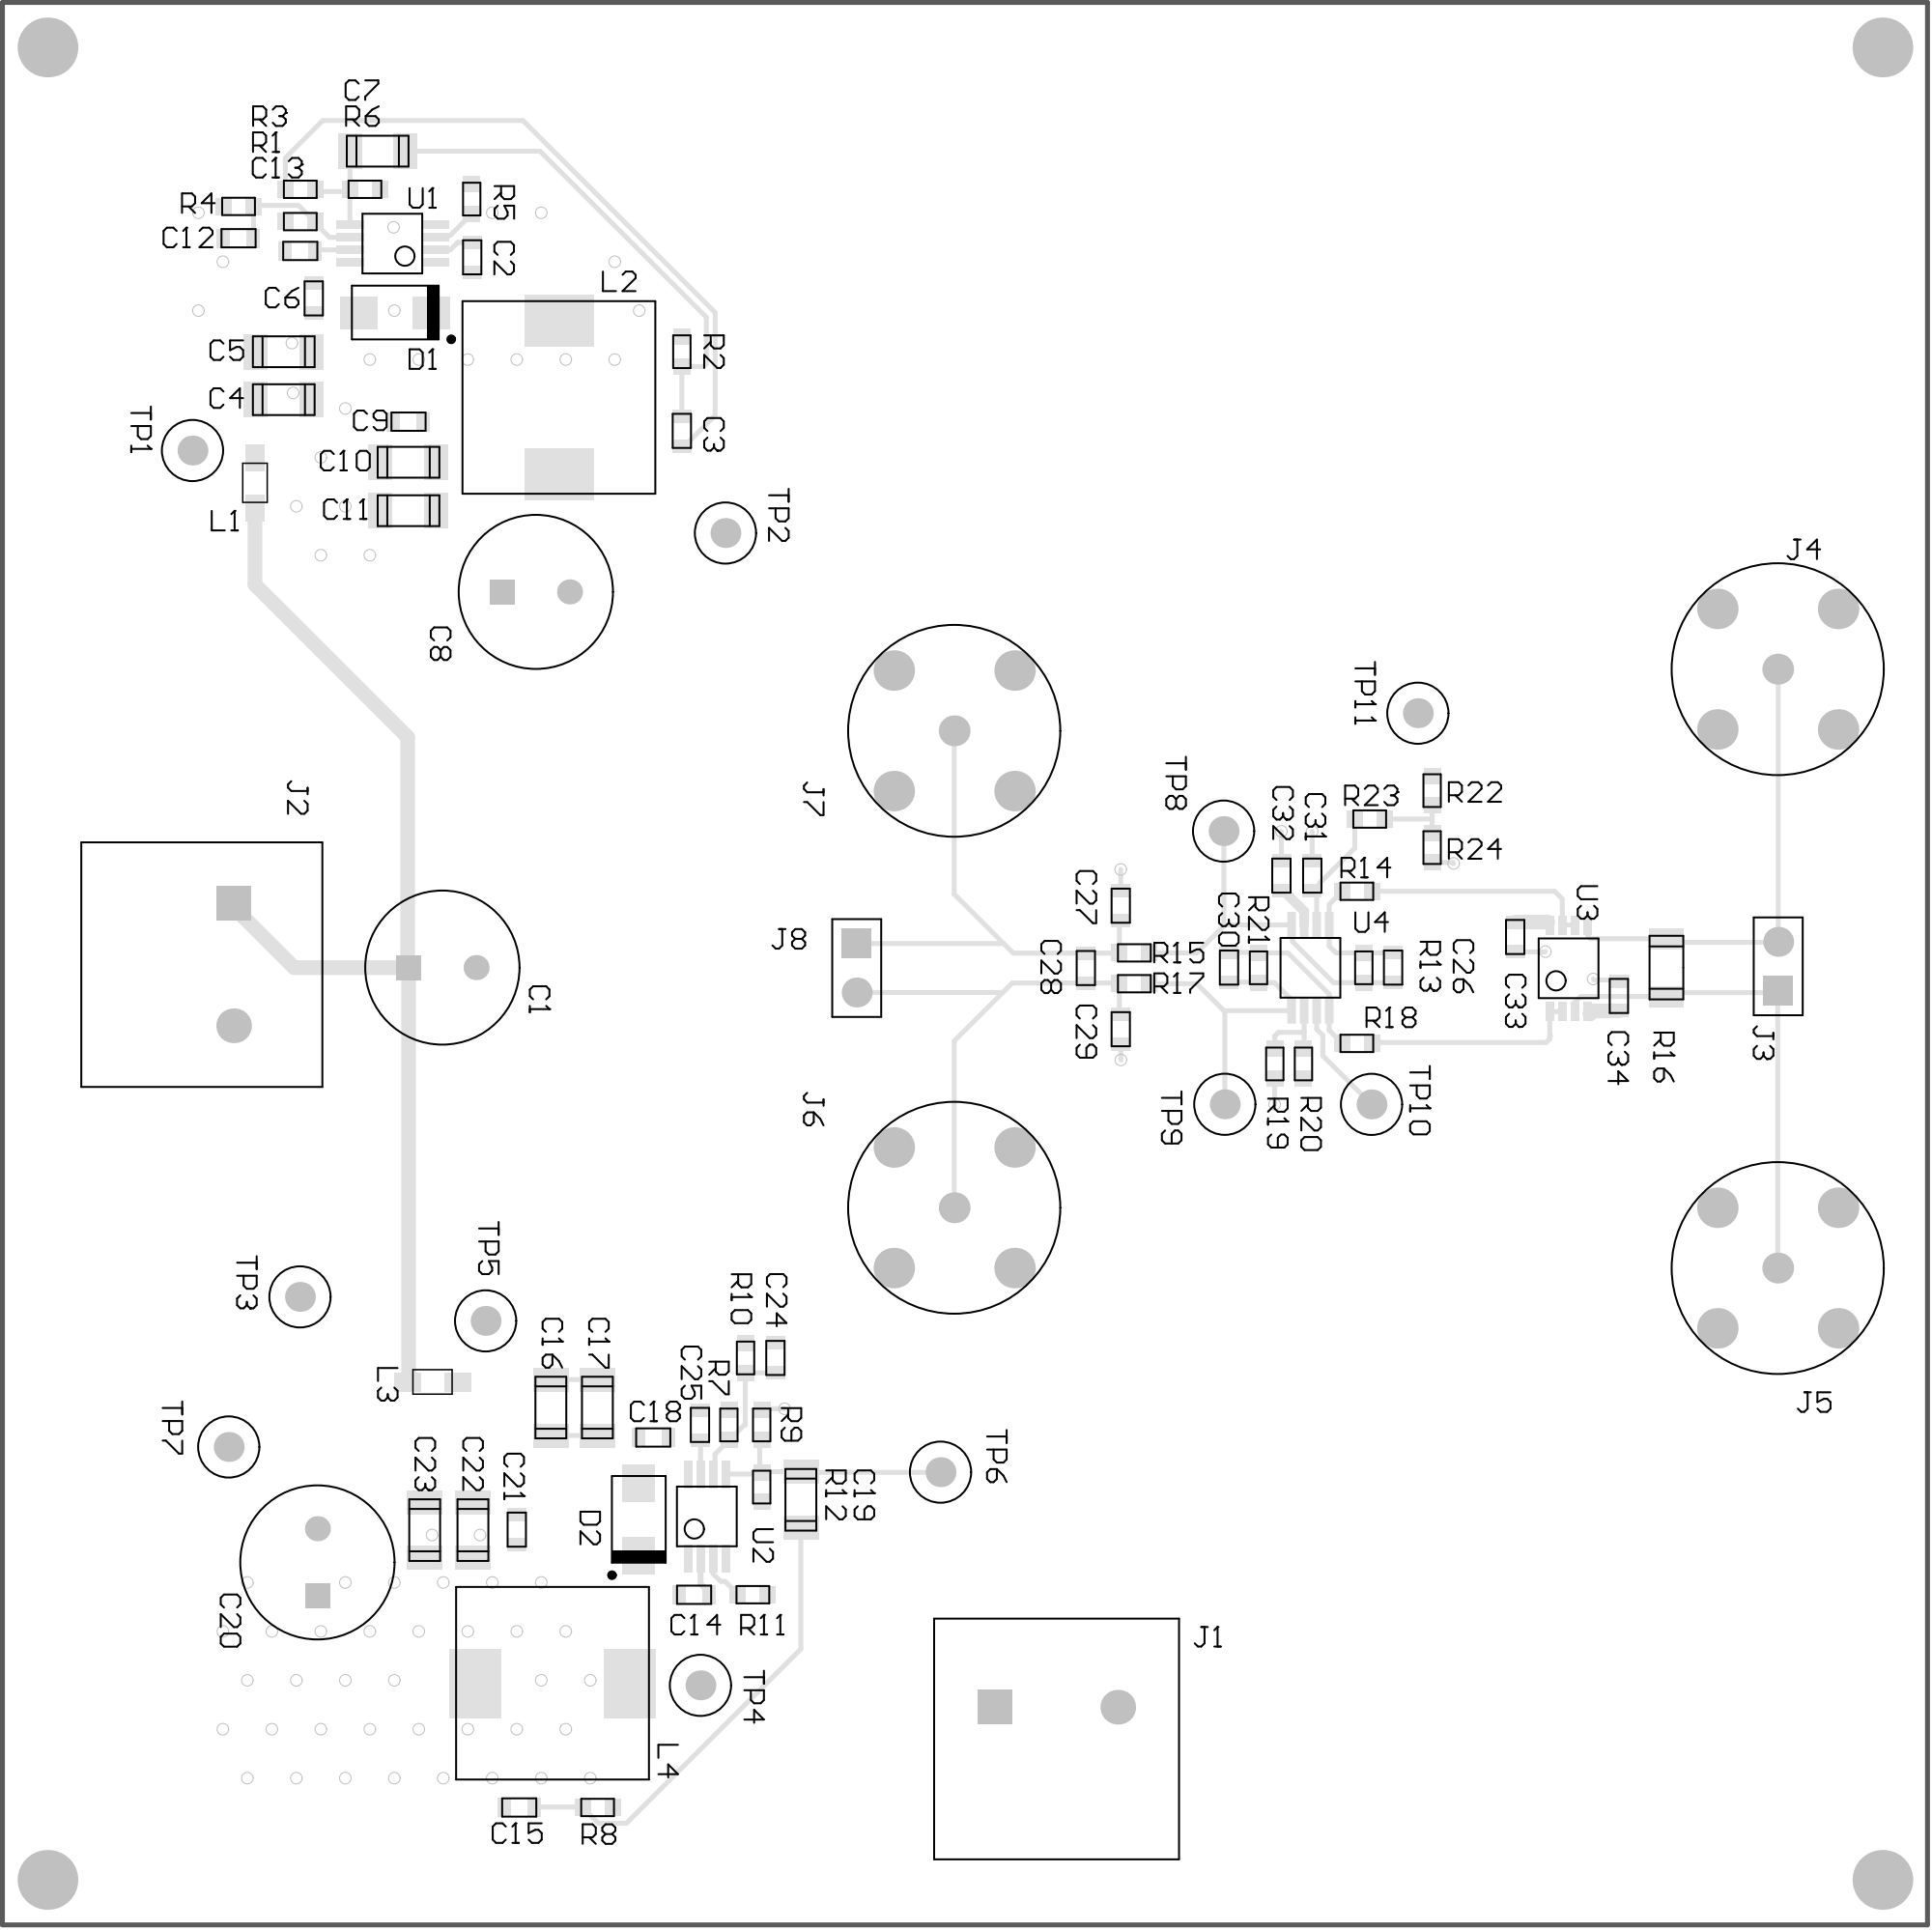
[picture p9: page 1]

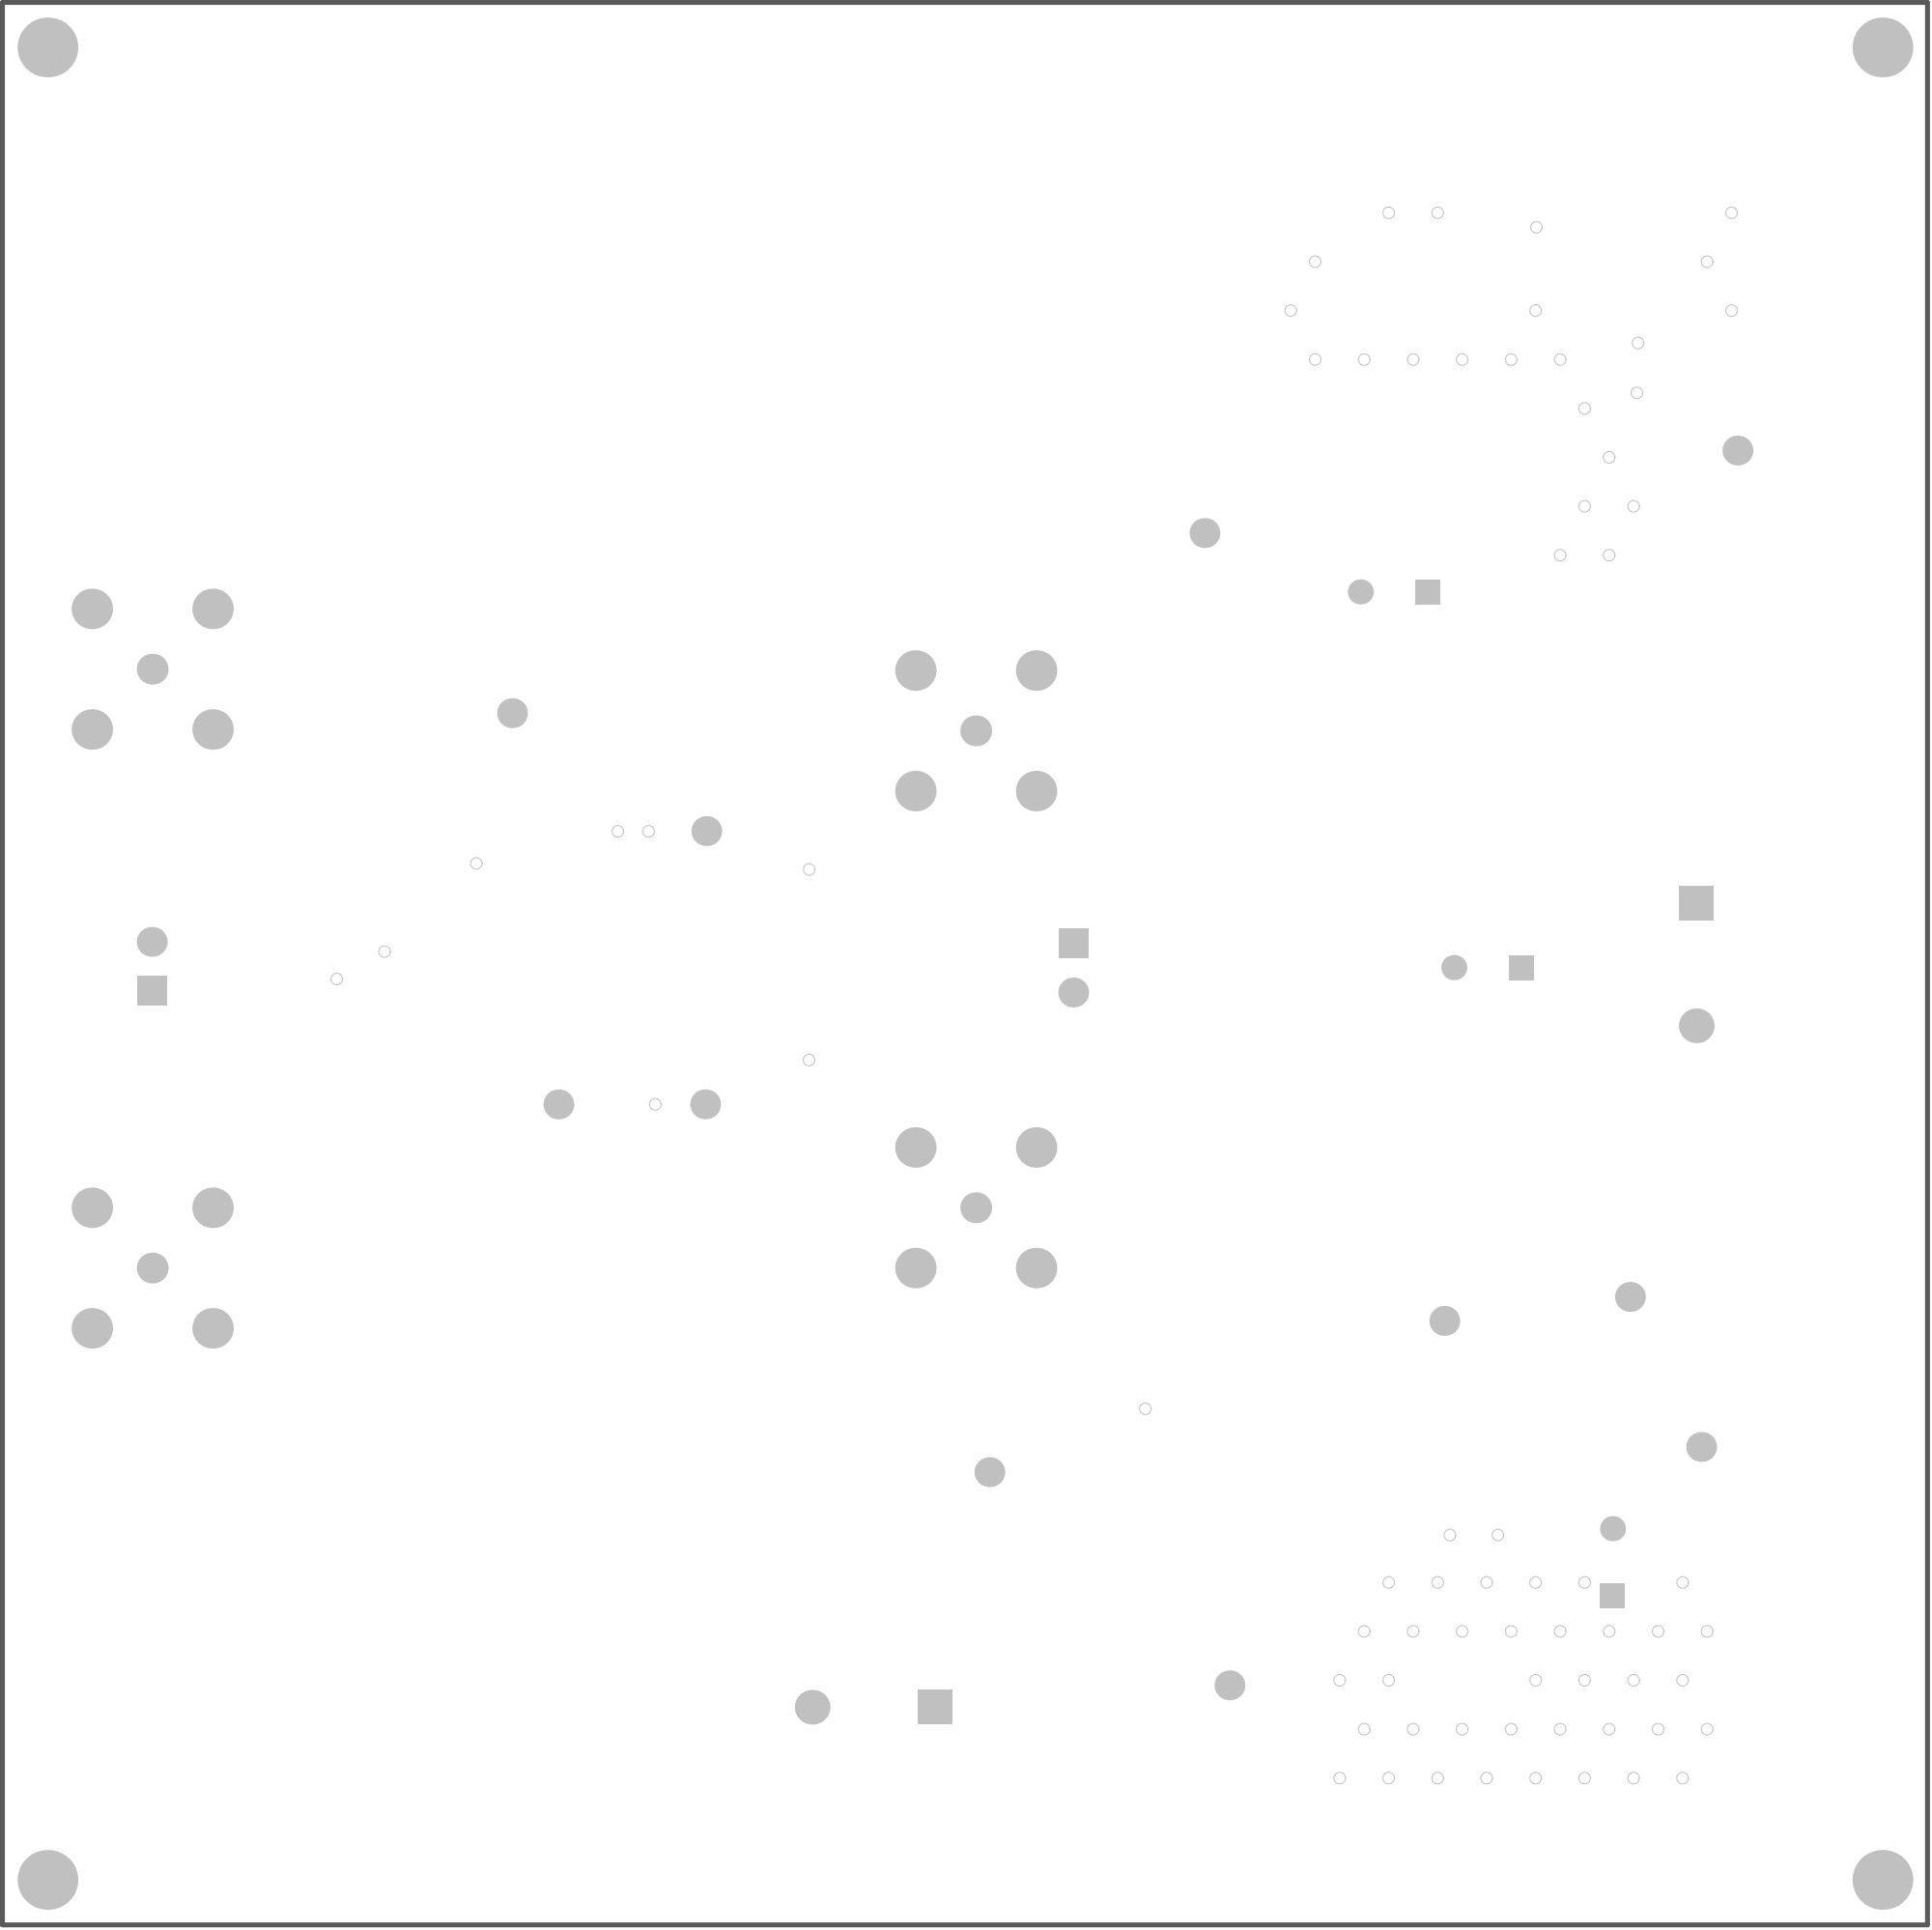
[picture p10: page 2]
