ultrazohm/uz_a_ltc2311-16/Project Outputs for UZ_A_LTC2311/Rev07/SCH_UZ_A_LTC2311_Standard_Rev07.PDF

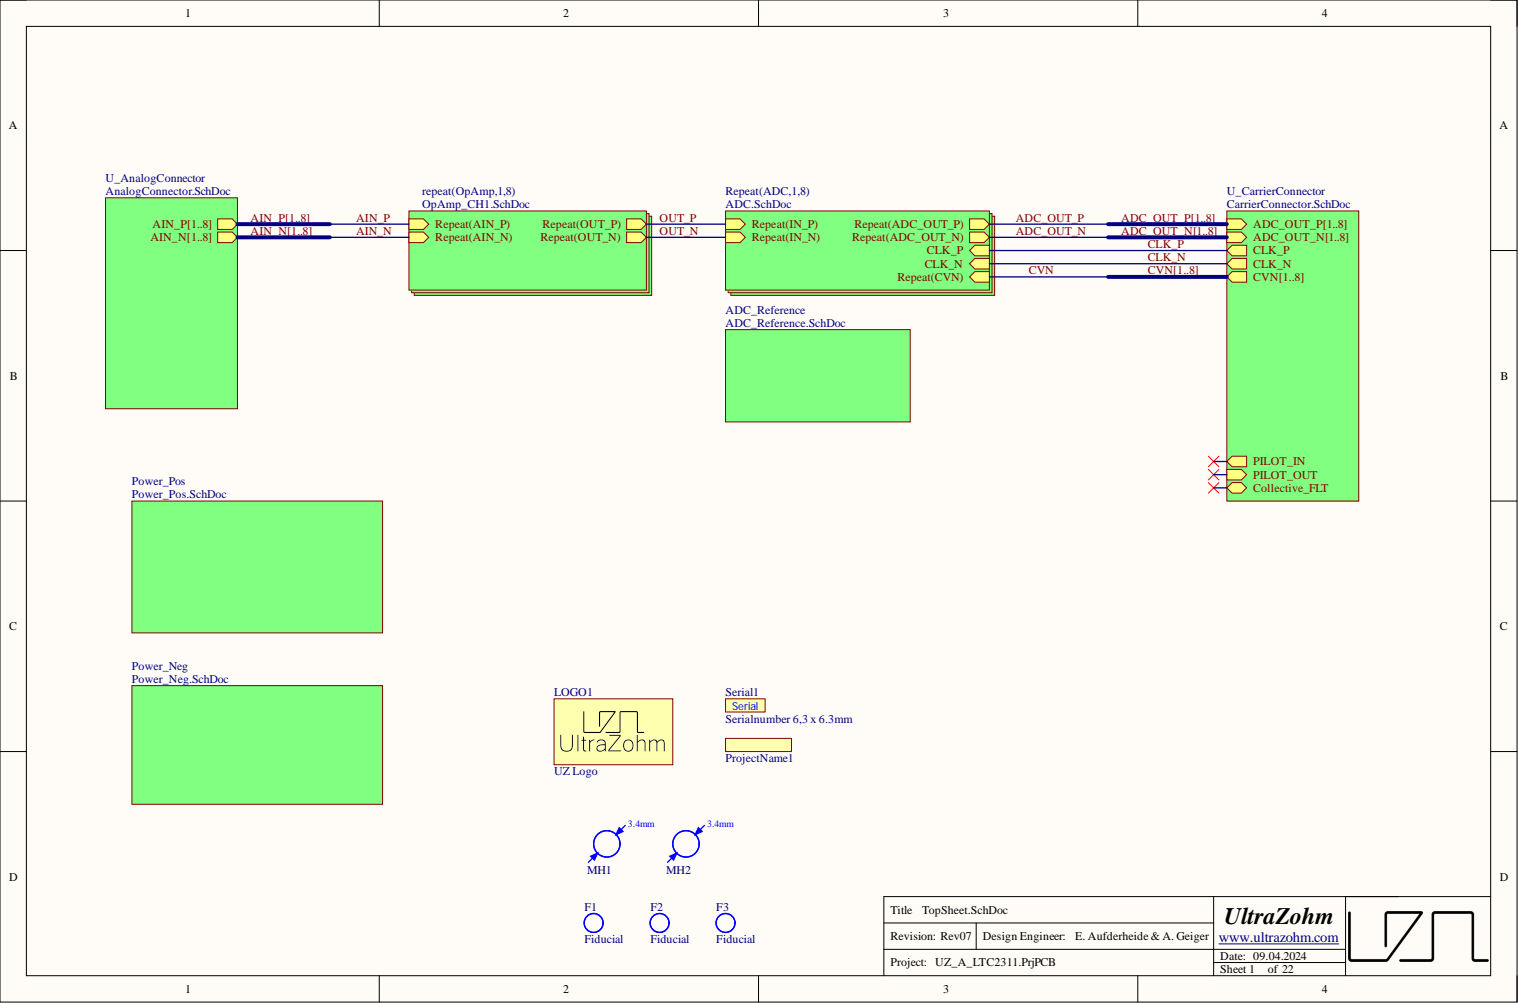
[picture p13: page 1]

Revision:

Date: 09.04.2024

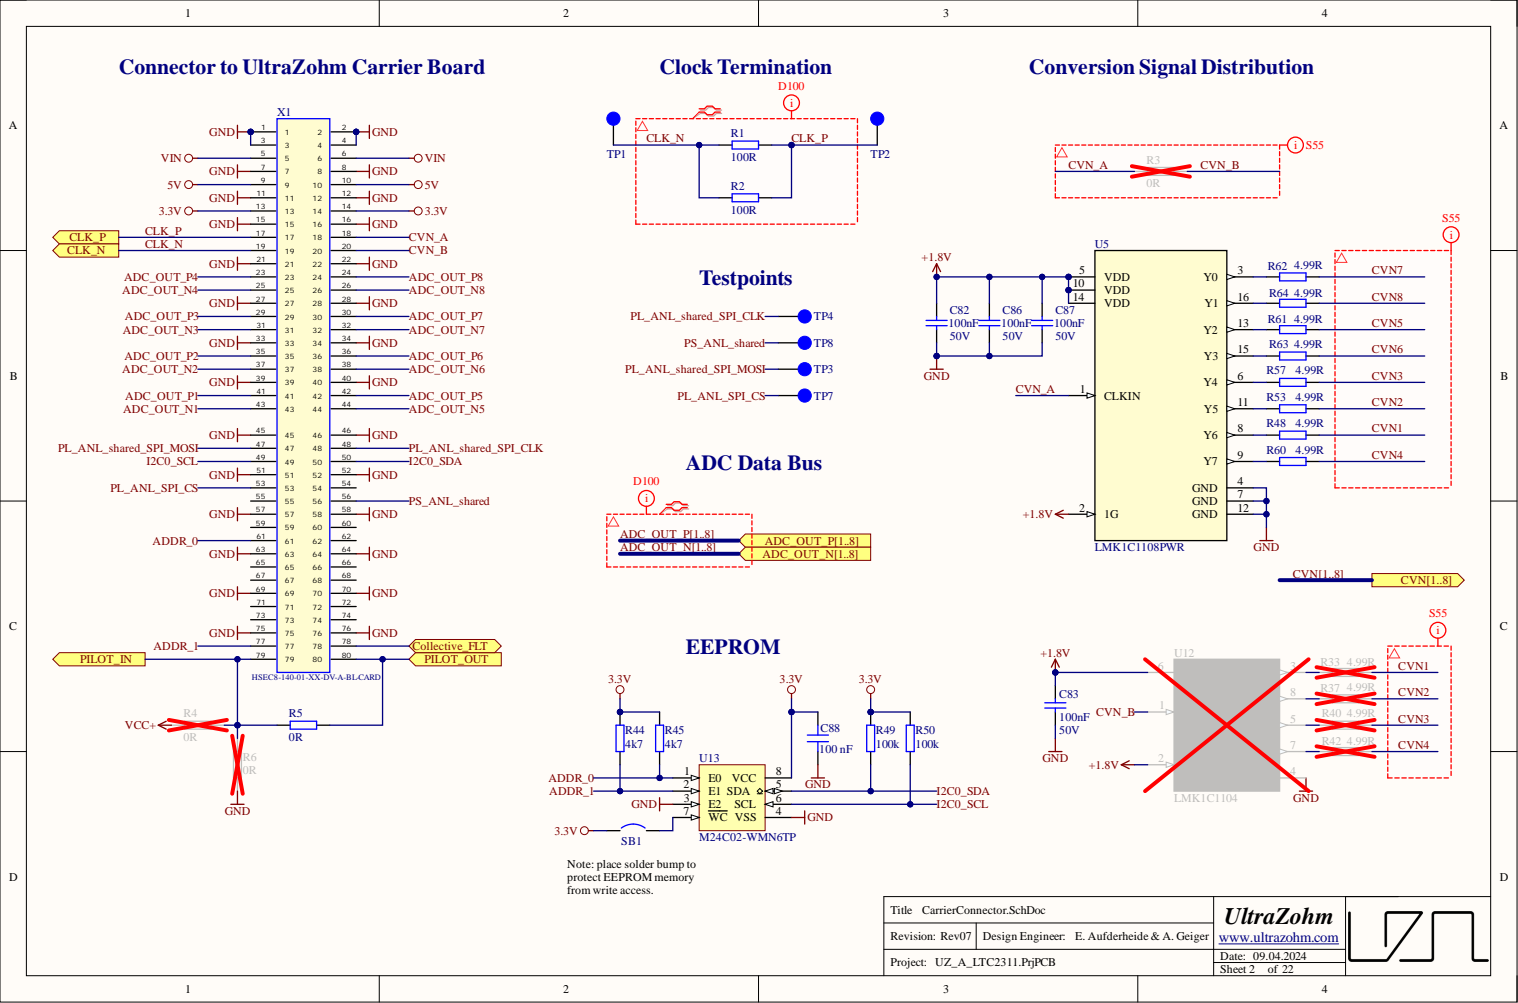
[picture p14: page 2]

Connector to UltraZohm Carrier Board

HSEC8-140-01-XX-DV-A-BL-CARD

Note: place solder bump to
protect EEPROM memory
from write access.

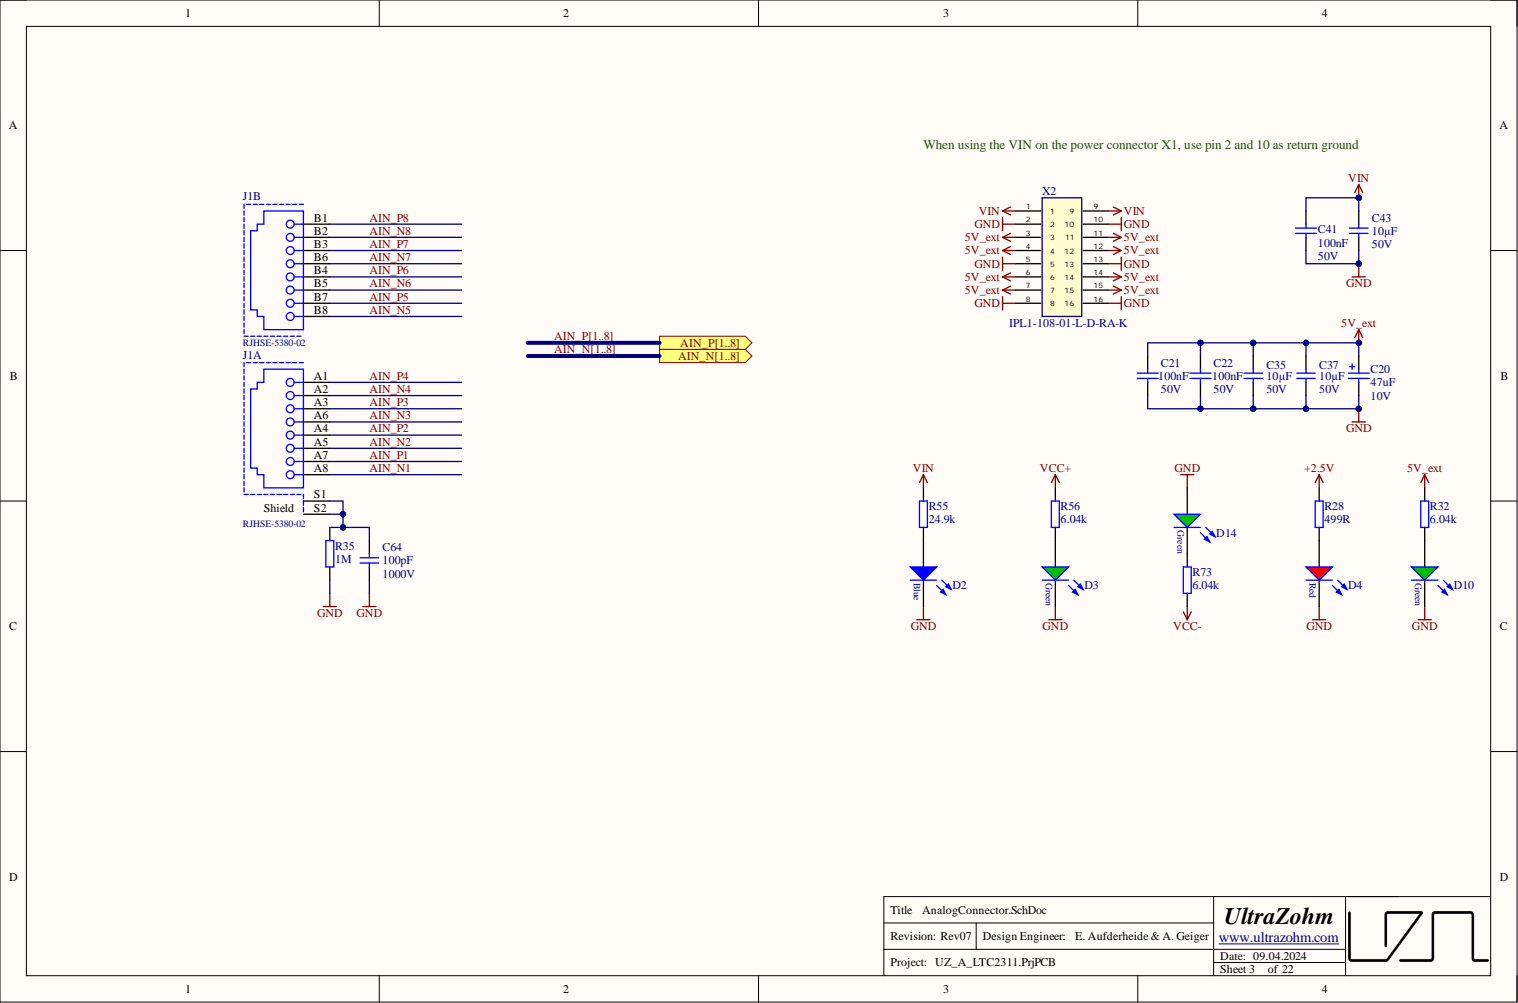
[picture p15: page 3]

Rev i s n

Dat e :

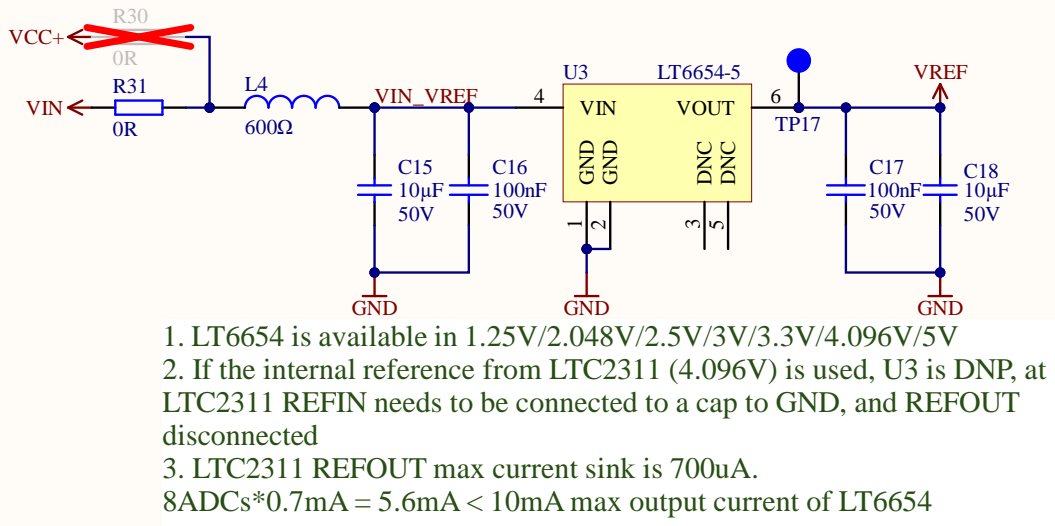
[picture p16: page 4]

max output current of

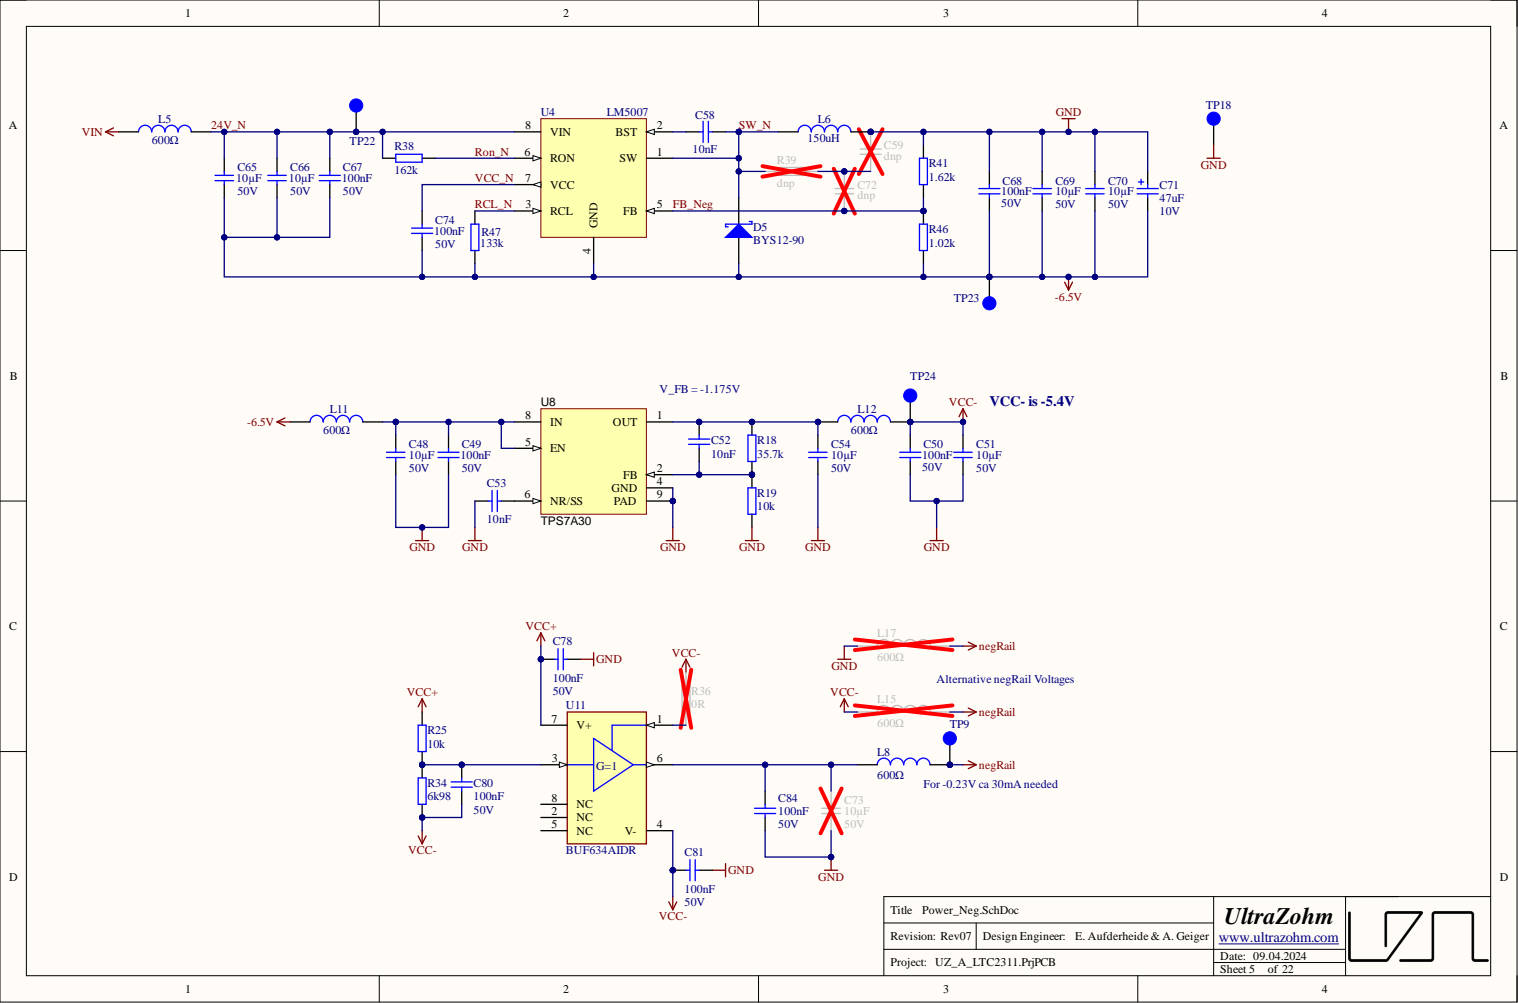
[picture p17: page 5]

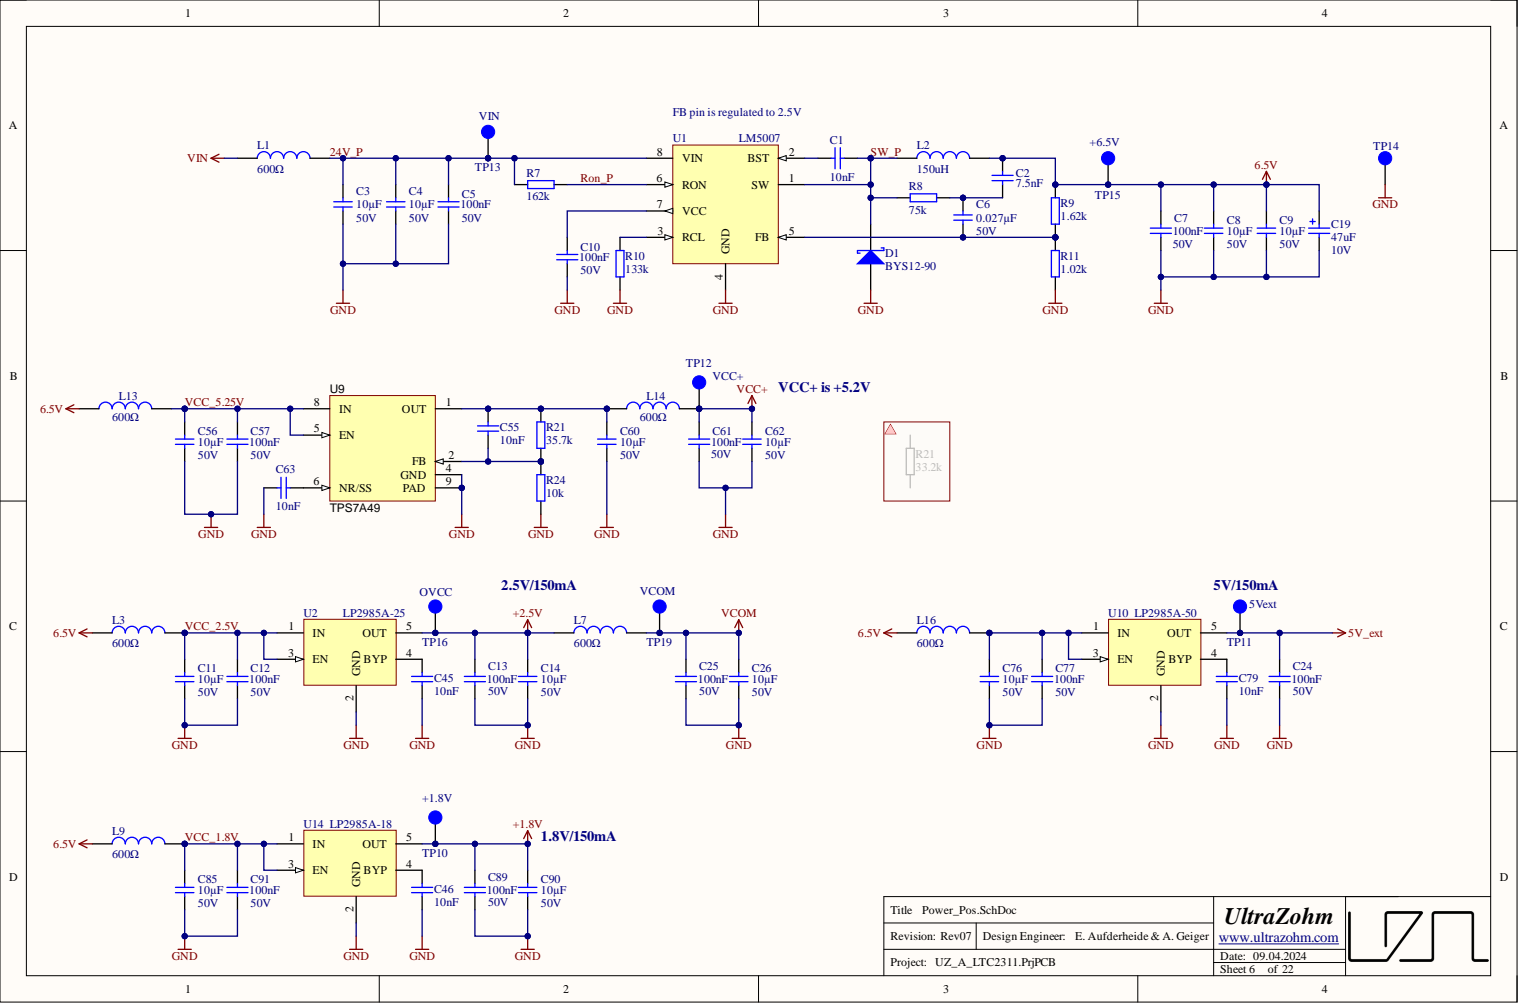
[picture p18: page 6]

FB pin is regulated to 2.5V

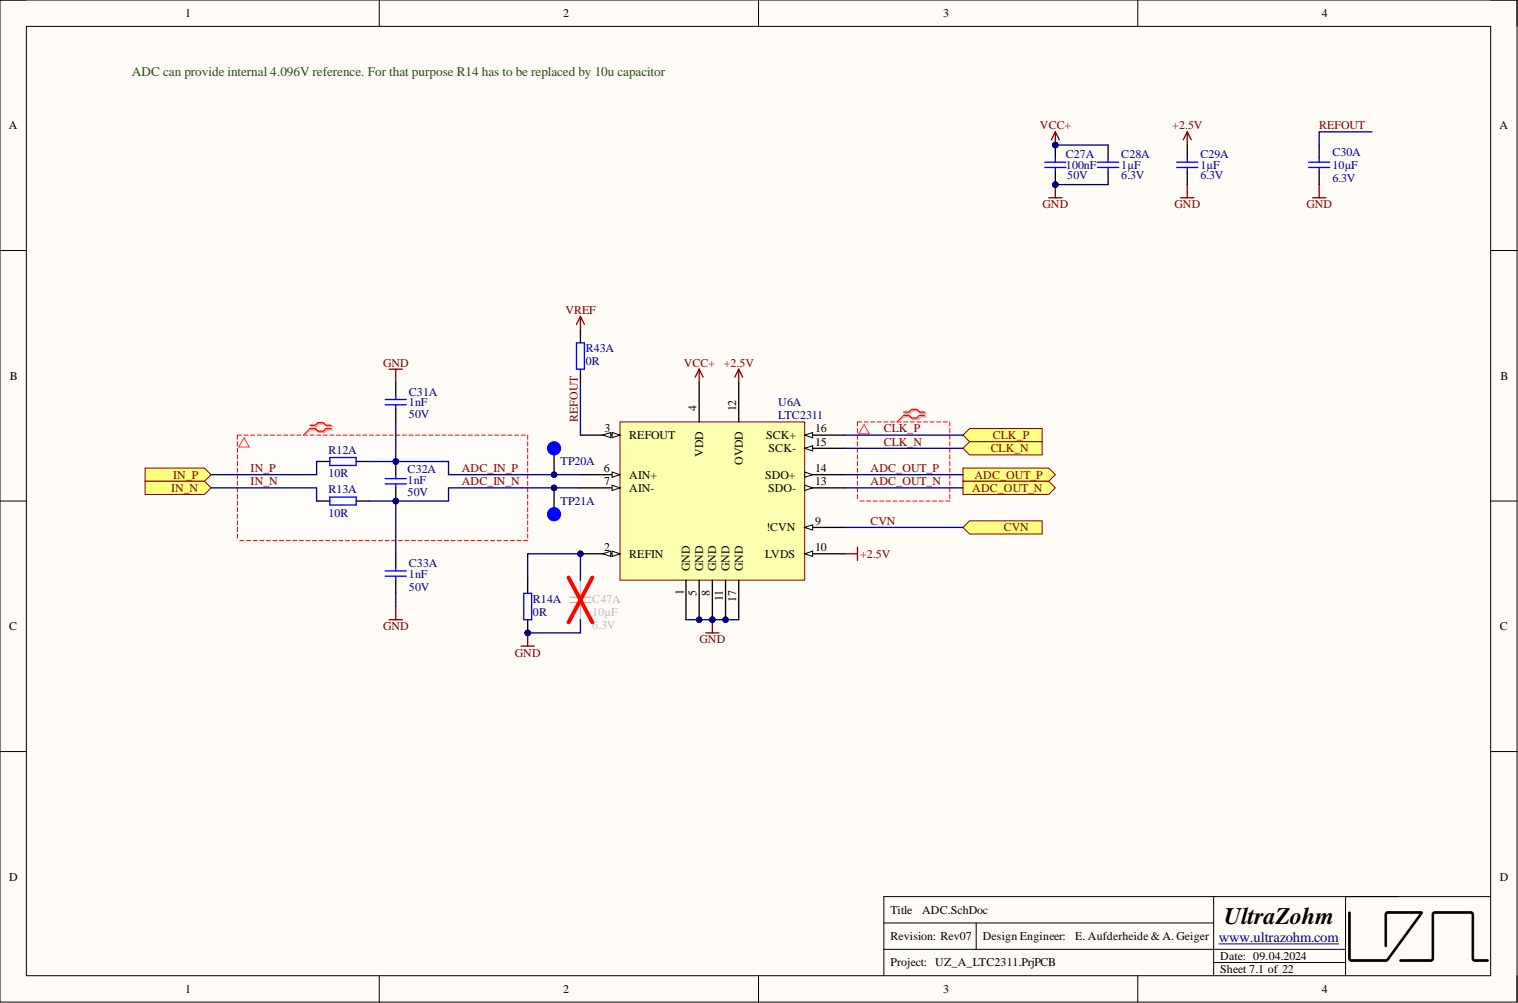
[picture p19: page 7]

IN _P | 1 n F
IN _N A DC_ IN_N | 7

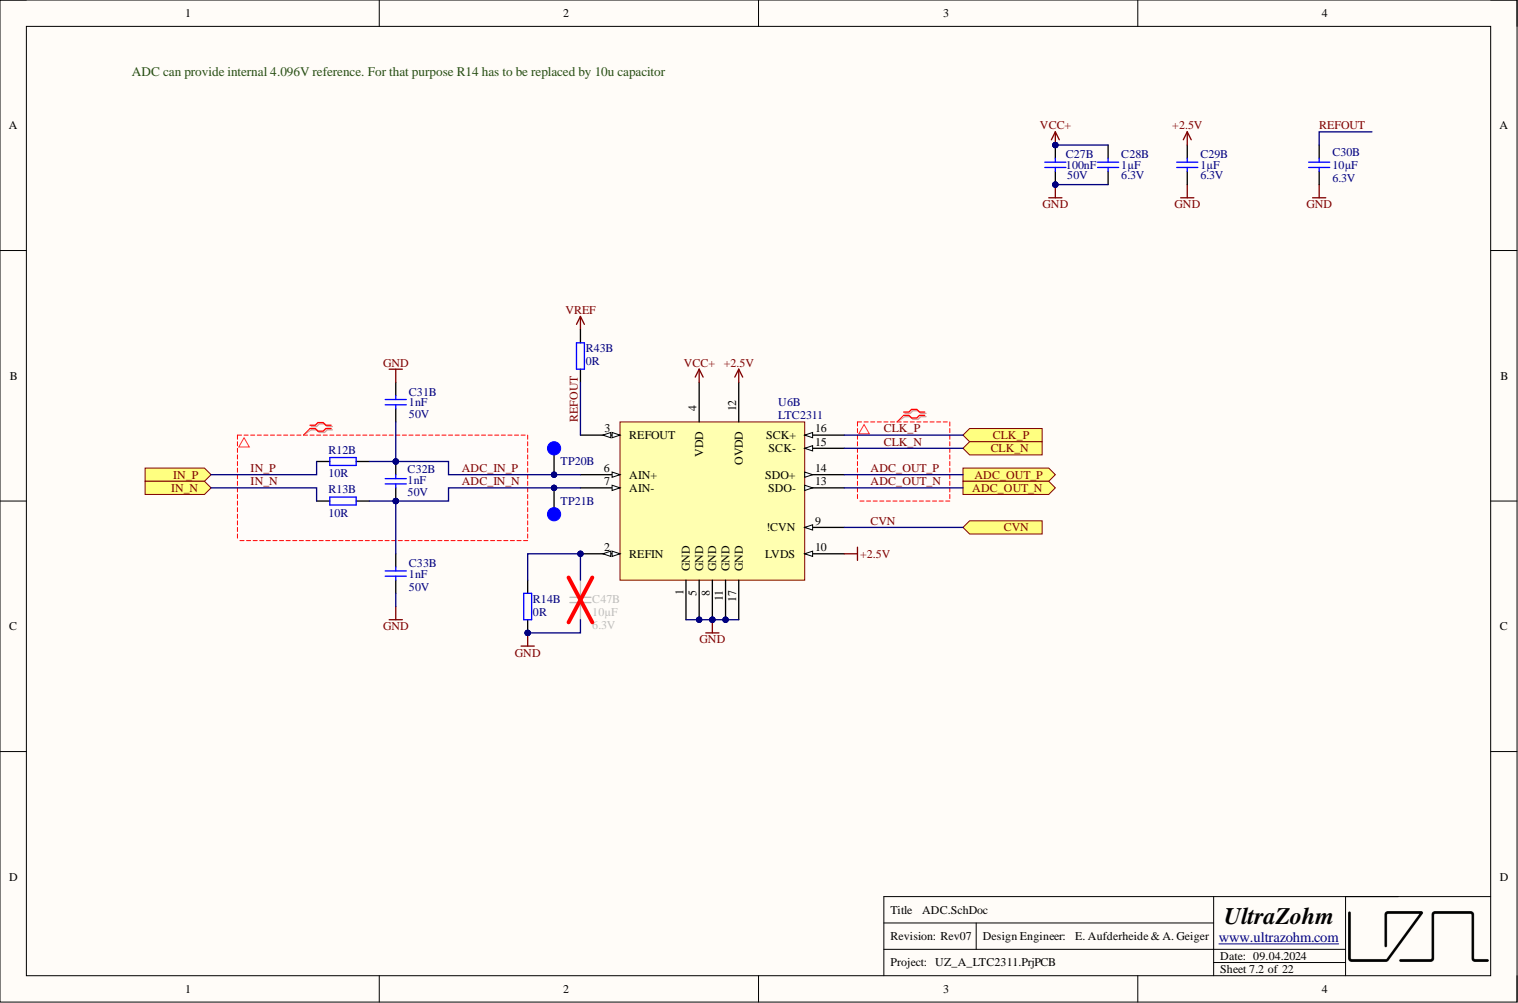
[picture p20: page 8]

IN _P | 1 n F
IN _N A DC_ IN_N | 7

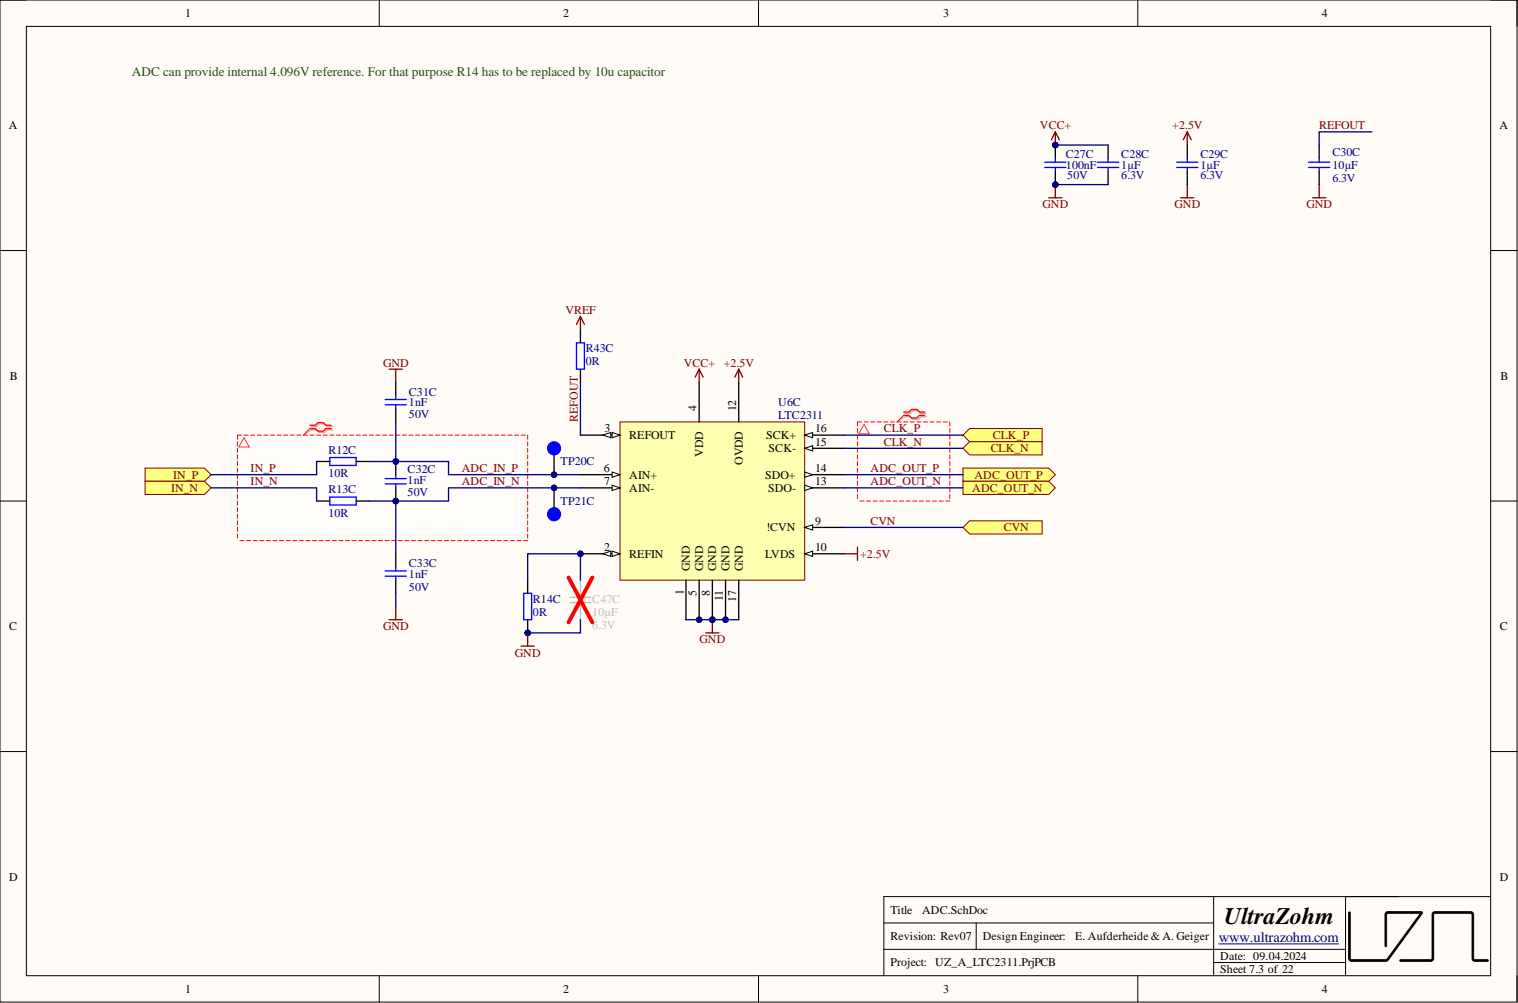
[picture p21: page 9]

IN _P | 1 n F
IN _N A DC_ IN_N | 7

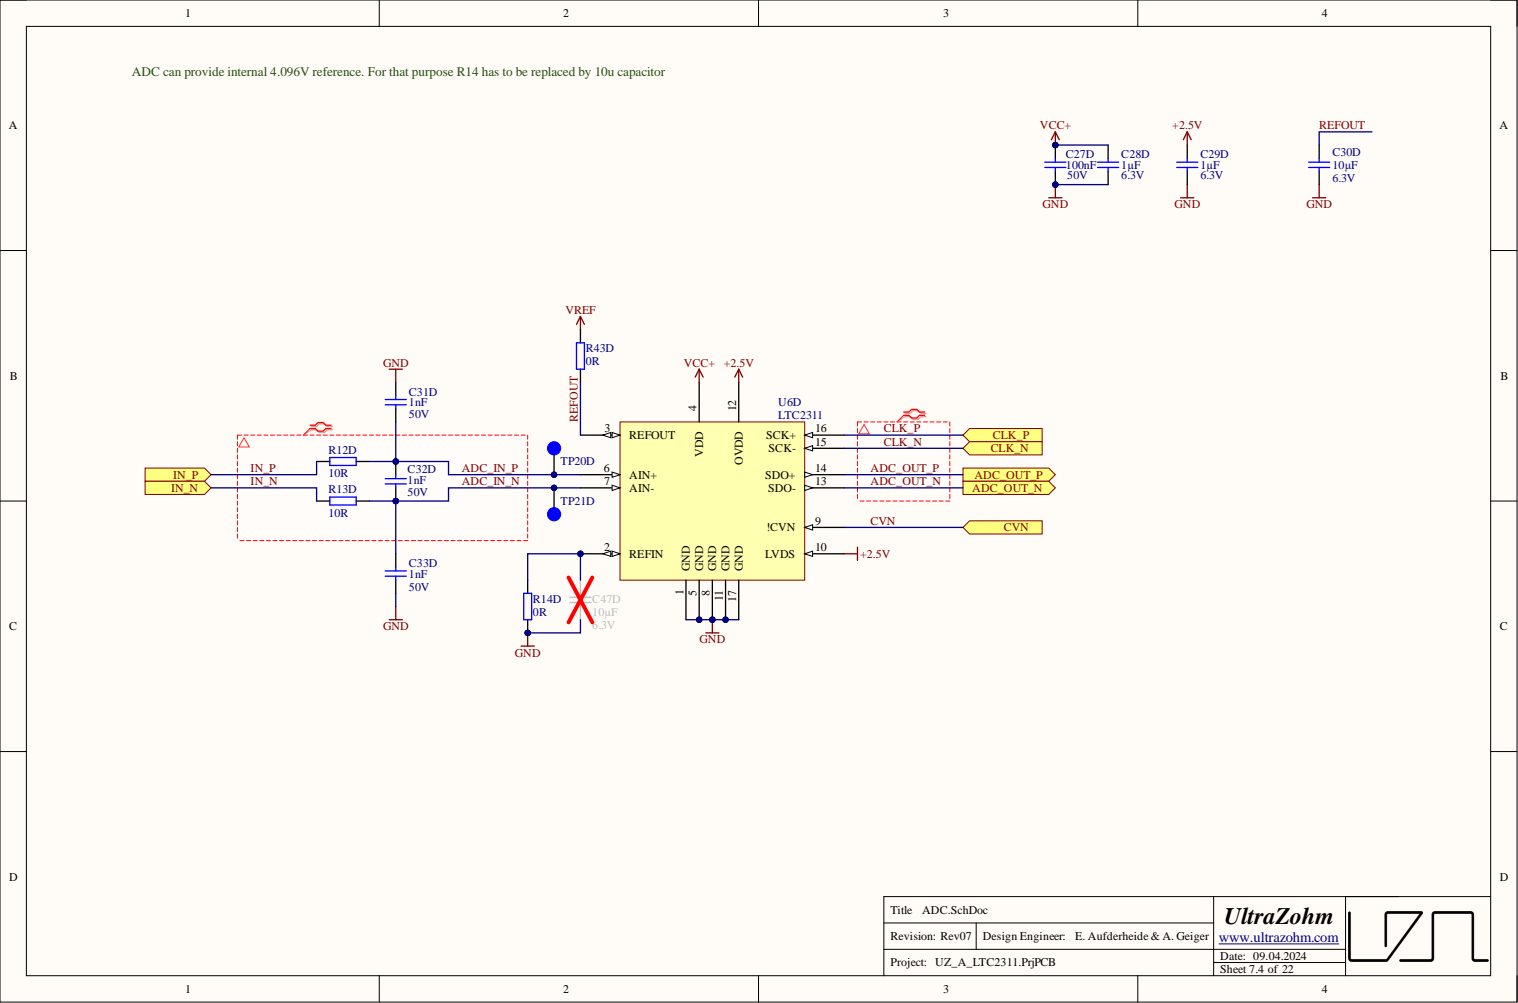
[picture p22: page 10]

IN _P | 1 n F
IN _N A DC_ IN_N | 7

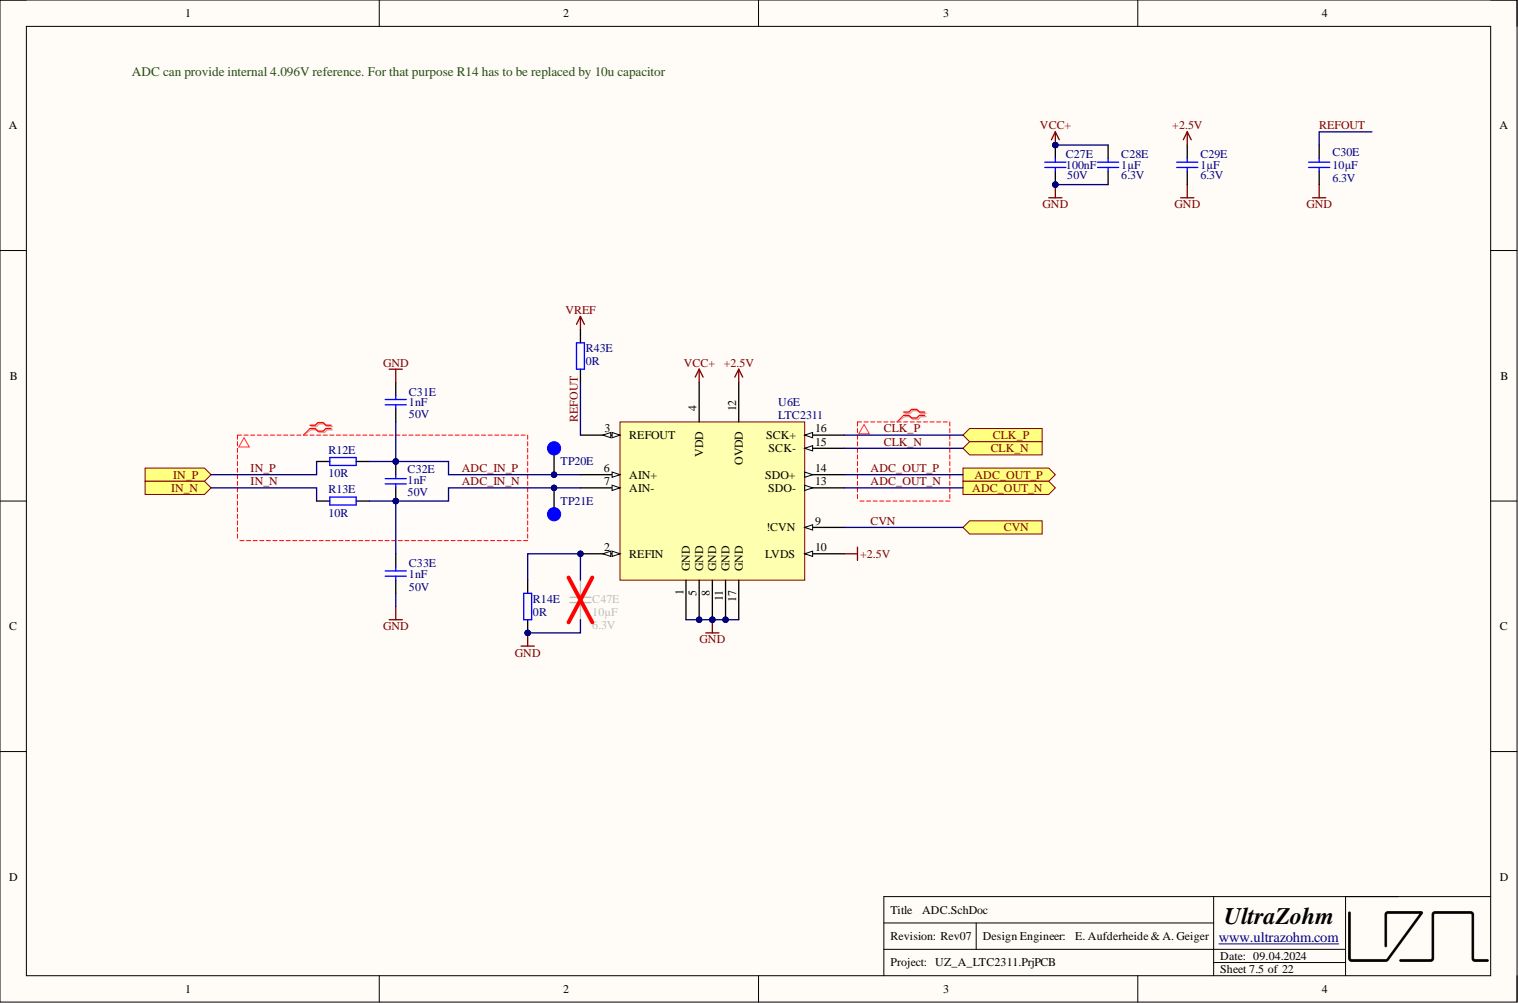
[picture p23: page 11]

IN _P | 1 n F
IN _N A DC_ IN_N | 7

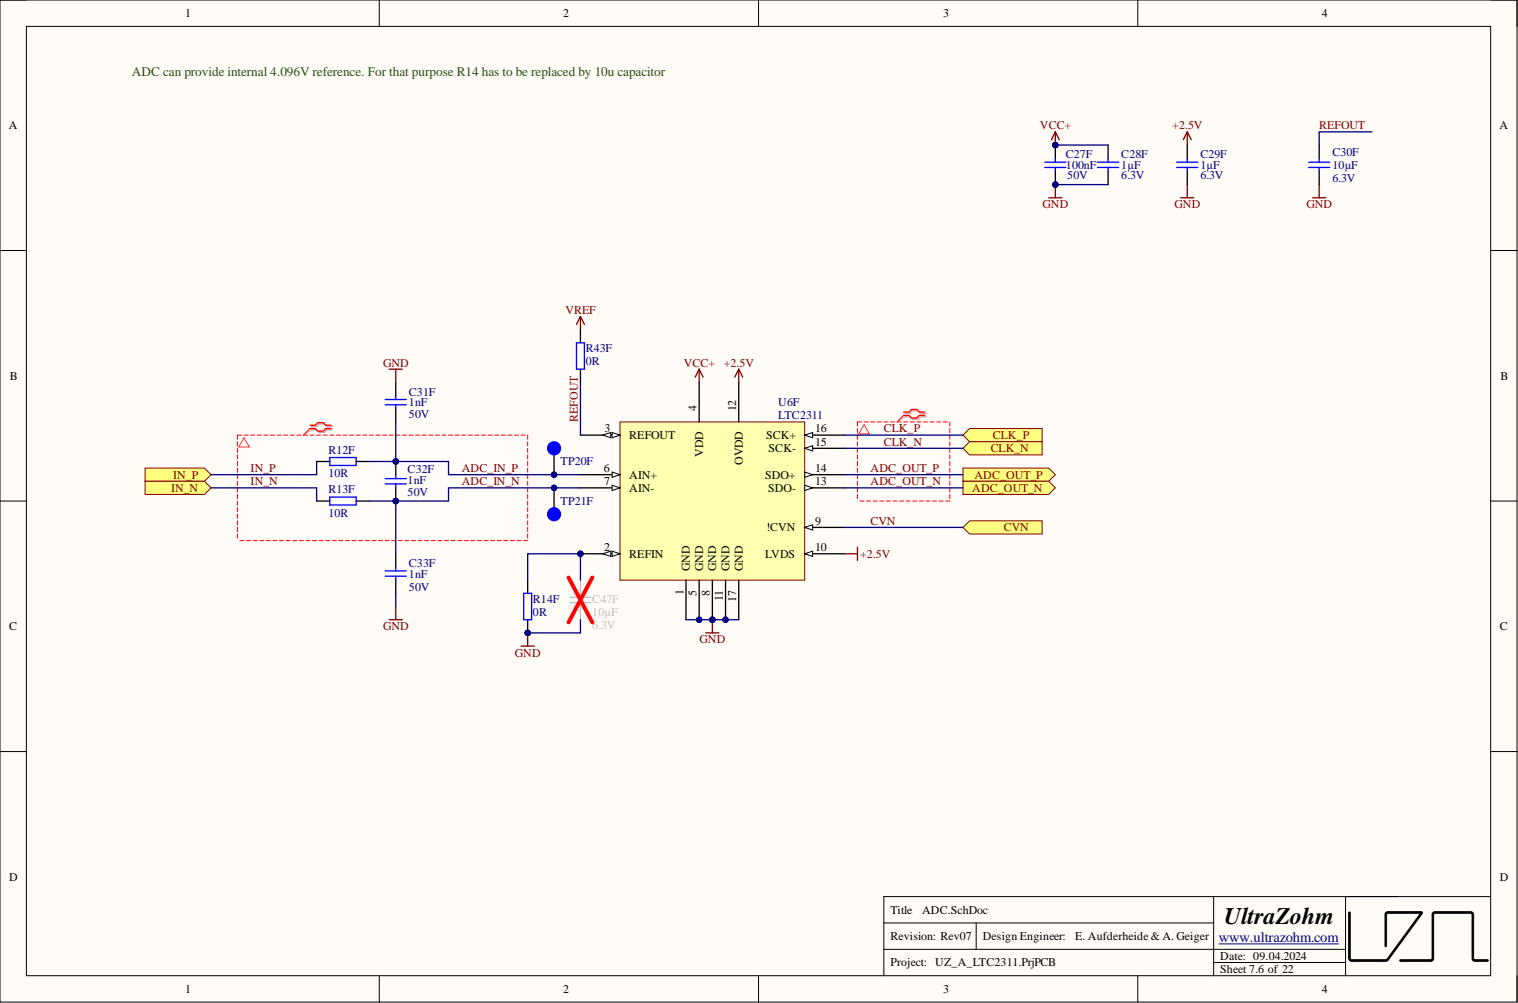
[picture p24: page 12]

IN _P | 1 n F
IN _N A DC_ IN_N | 7

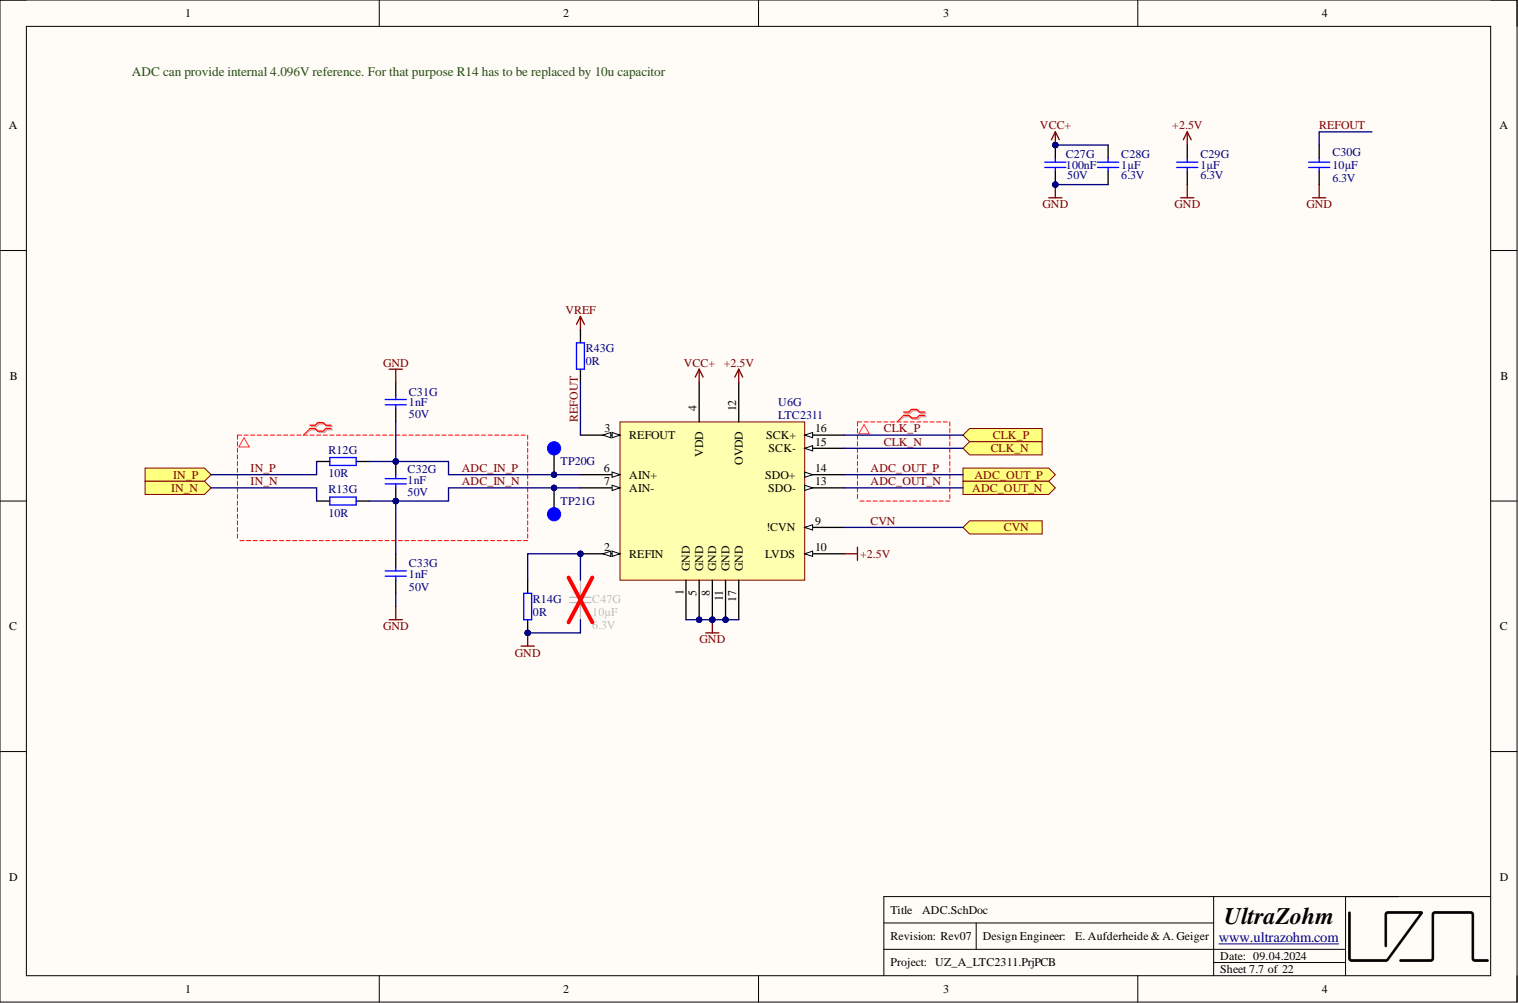
[picture p25: page 13]

IN _P | 1 n F
IN _N A DC_ IN_N | 7

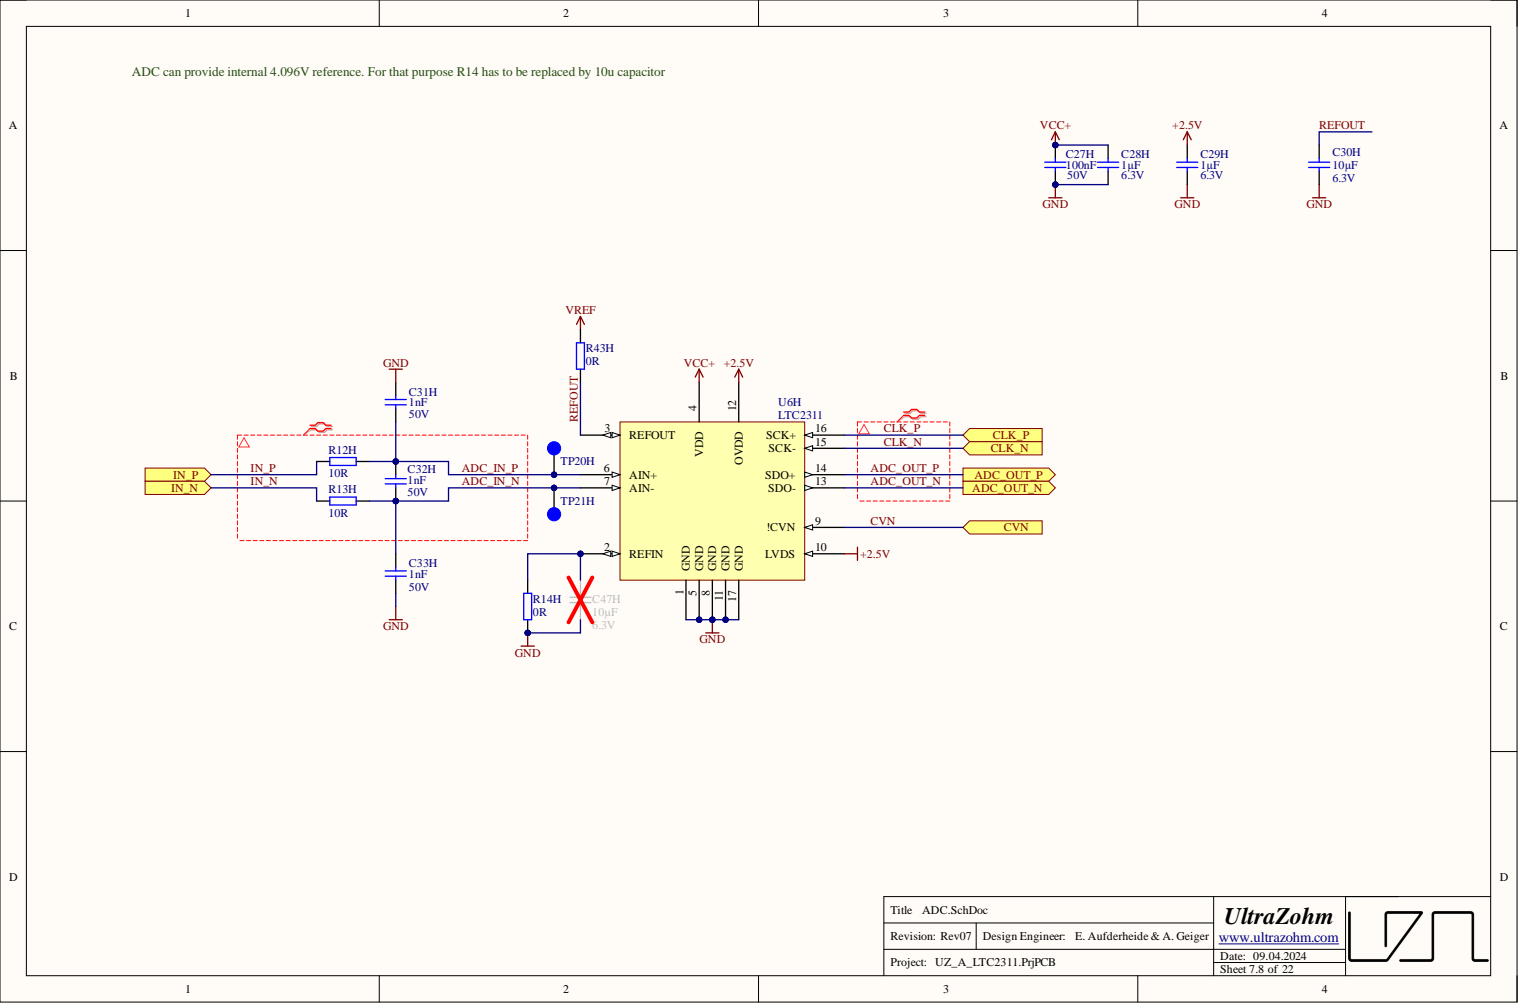
[picture p26: page 14]

IN _P | 1 n F
IN _N A DC_ IN_N | 7

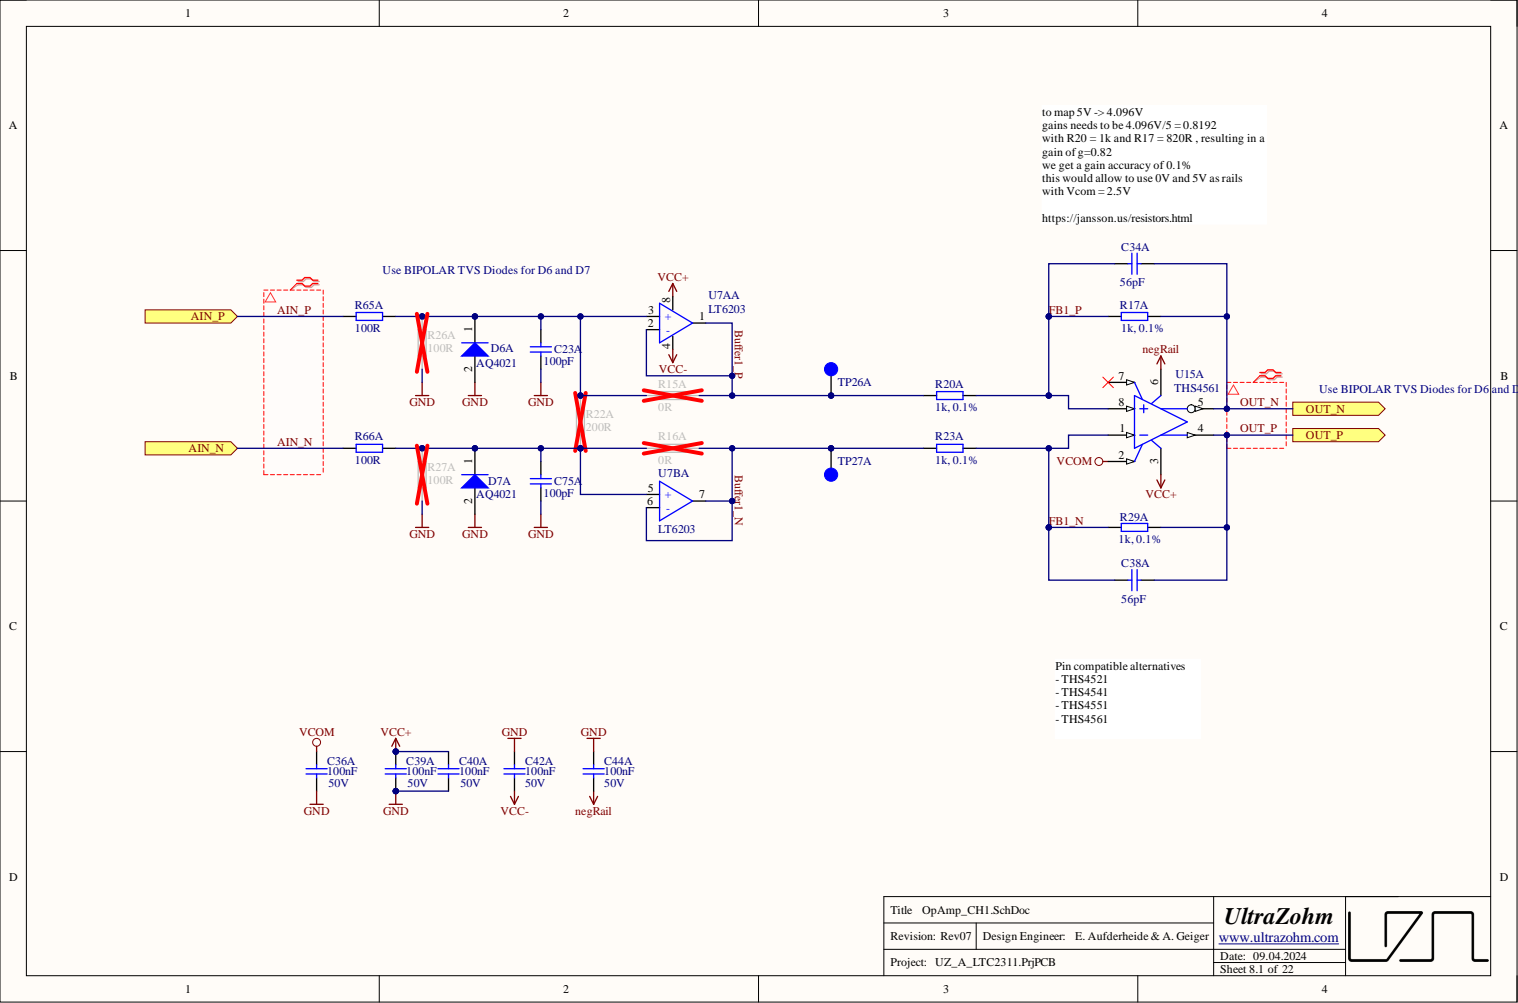
[picture p27: page 15]

to map 5V -> 4.096V
gains needs to be 4.096V/5 = 0.8192
with R20 = 1k and R17 = 820R , resulting in a
gain of g=0.82
we get a gain accuracy of 0.1%
this would allow to use 0V and 5V as rails
with Vcom = 2.5V

https://jansson.us/resistors.html

Use BIPOLAR TVS Diodes for D6 and D7

VCC-
R15A

Use BIPOLAR TVS Diodes for D6 and D8
OUT_N

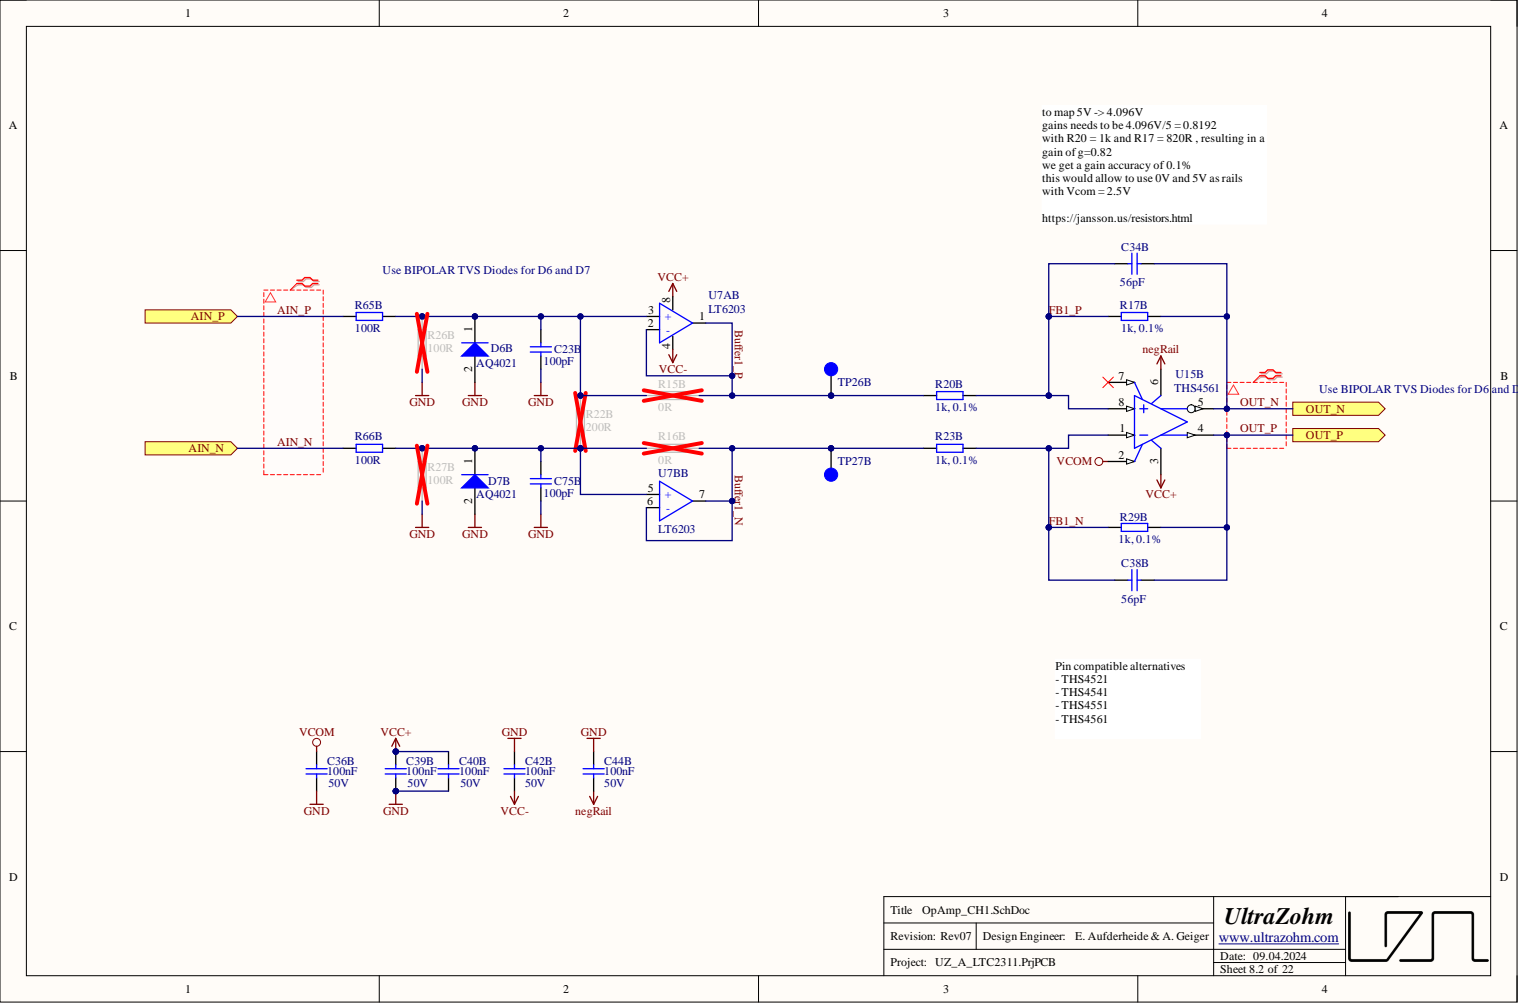
[picture p28: page 16]
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

https://jansson.us/resistors.html

Use BIPOLAR TVS Diodes for D6 and D7

VCC-
R15B

Use BIPOLAR TVS Diodes for D6 and D8
OUT_N

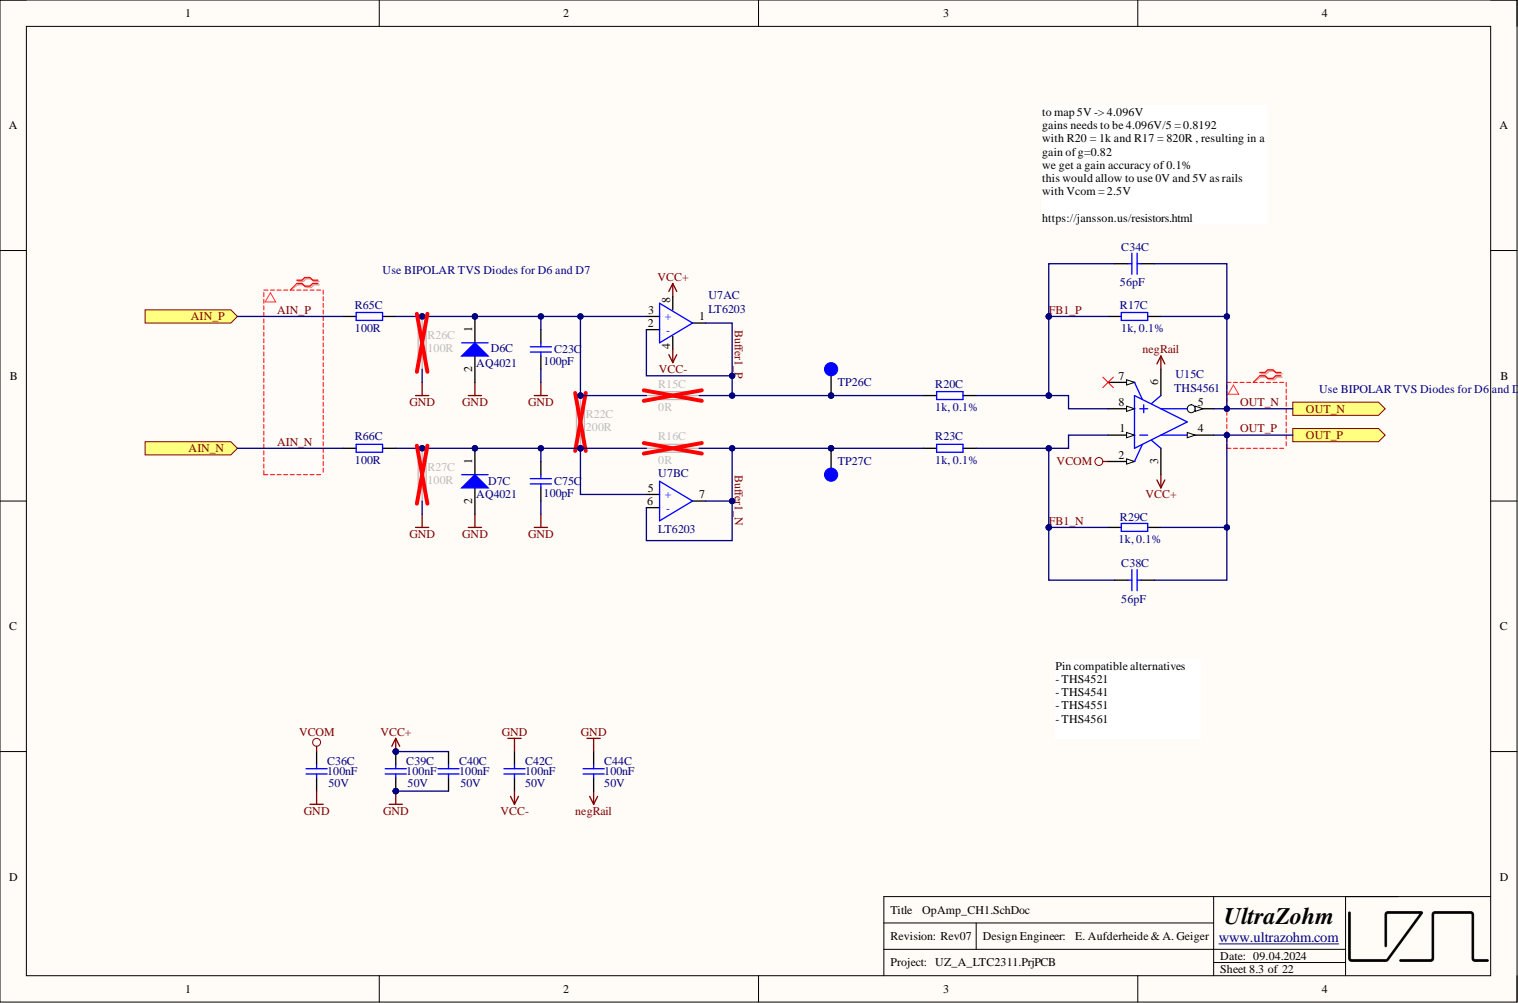
[picture p29: page 17]
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

https://jansson.us/resistors.html

Use BIPOLAR TVS Diodes for D6 and D7

VCC-
R15C

Use BIPOLAR TVS Diodes for D6 and D8
OUT_N

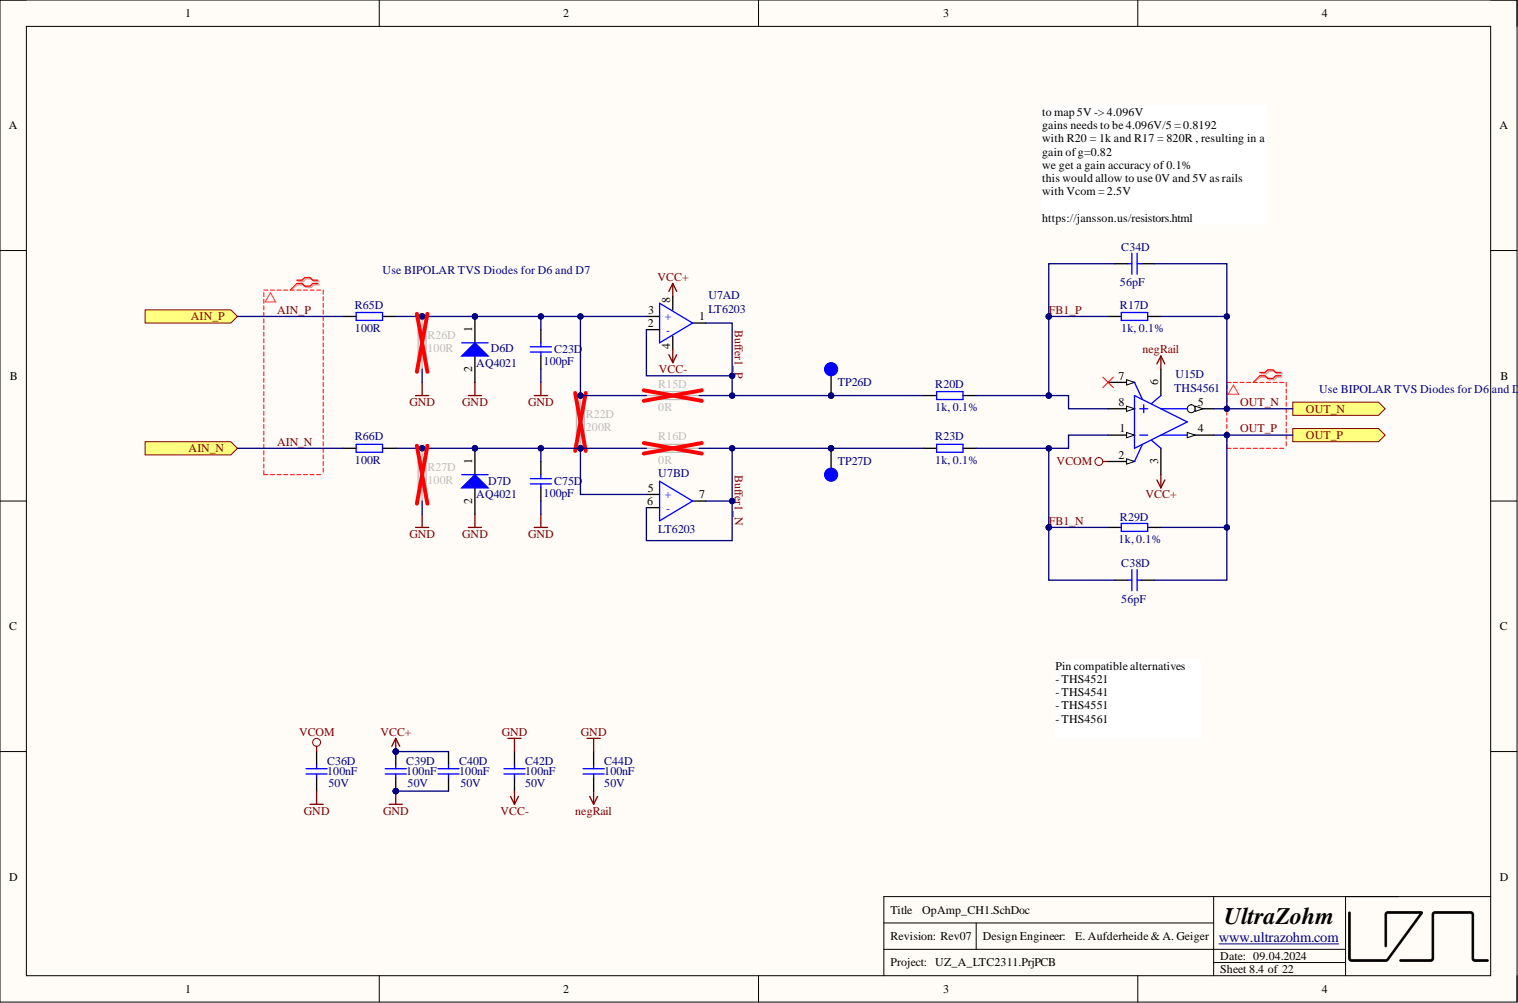
[picture p30: page 18]
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

https://jansson.us/resistors.html

Use BIPOLAR TVS Diodes for D6 and D7

VCC-
R15D

Use BIPOLAR TVS Diodes for D6 and D8
OUT_N

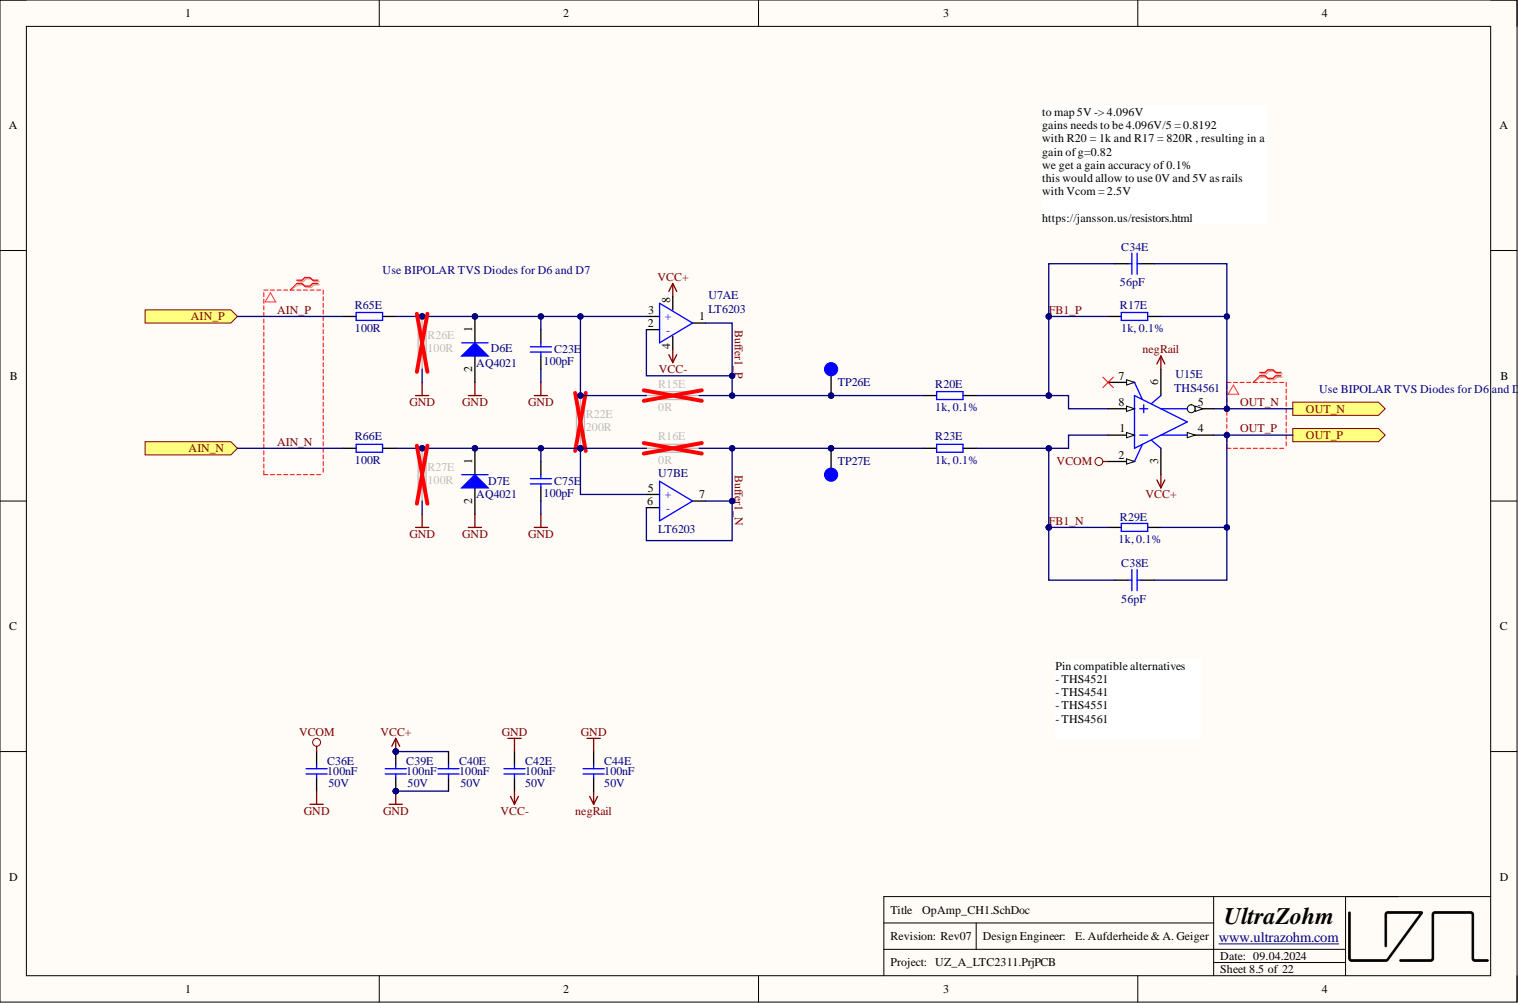
[picture p31: page 19]
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

https://jansson.us/resistors.html

Use BIPOLAR TVS Diodes for D6 and D7

VCC-
R15E

Use BIPOLAR TVS Diodes for D6 and D8
OUT_N

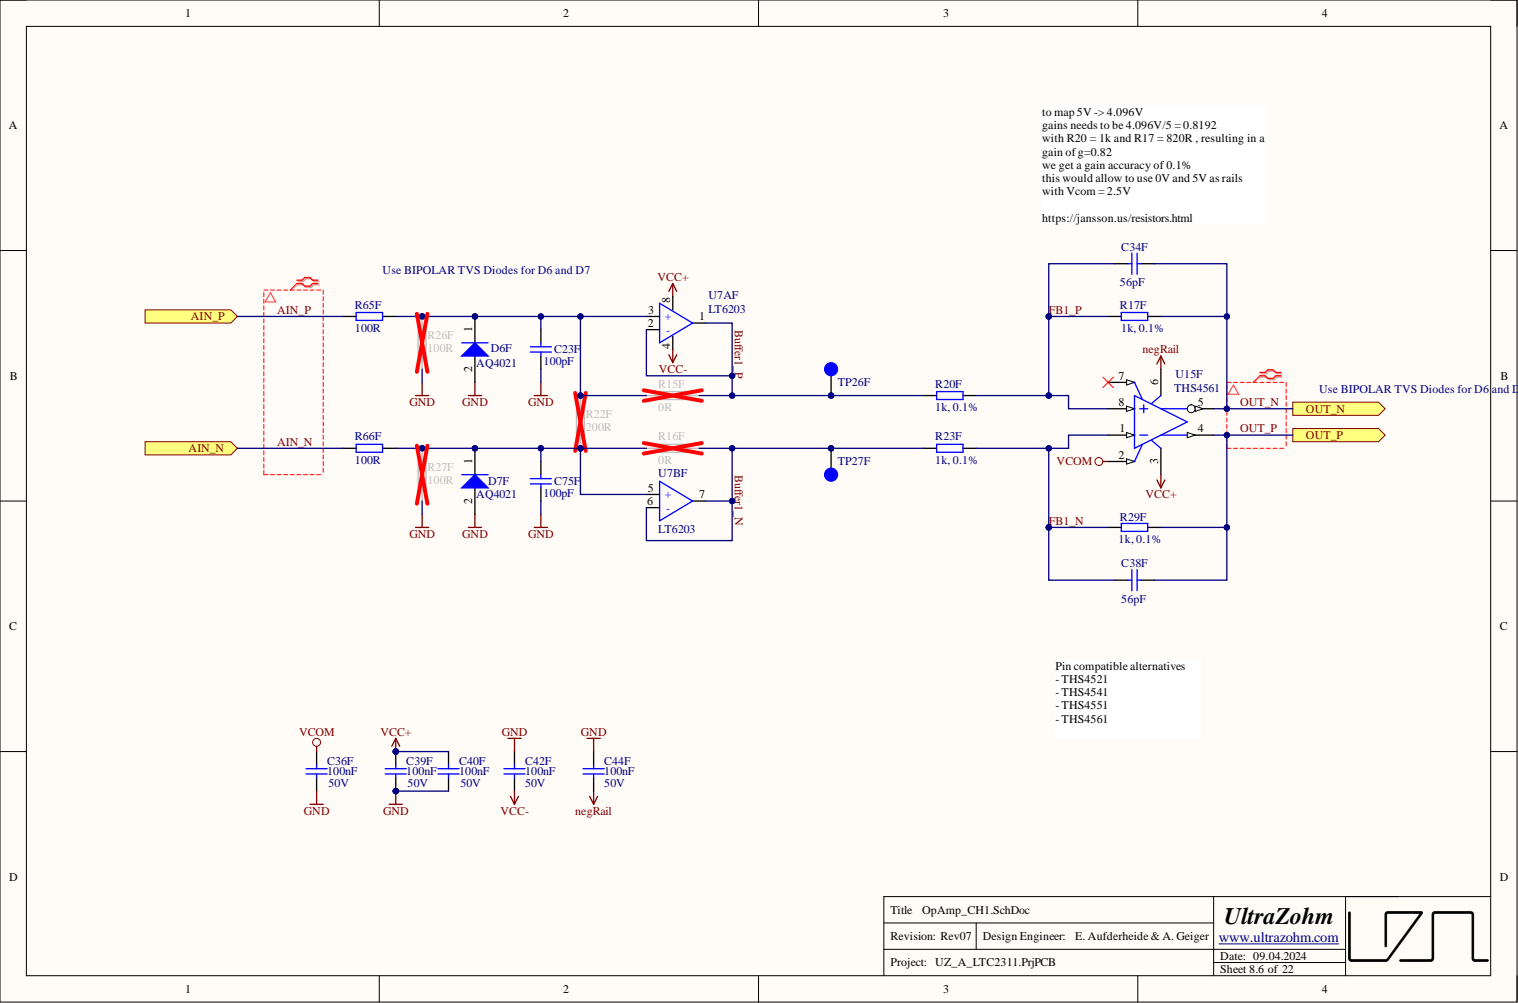
[picture p32: page 20]
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

https://jansson.us/resistors.html

Use BIPOLAR TVS Diodes for D6 and D7

VCC-
R15F

Use BIPOLAR TVS Diodes for D6 and D8
OUT_N

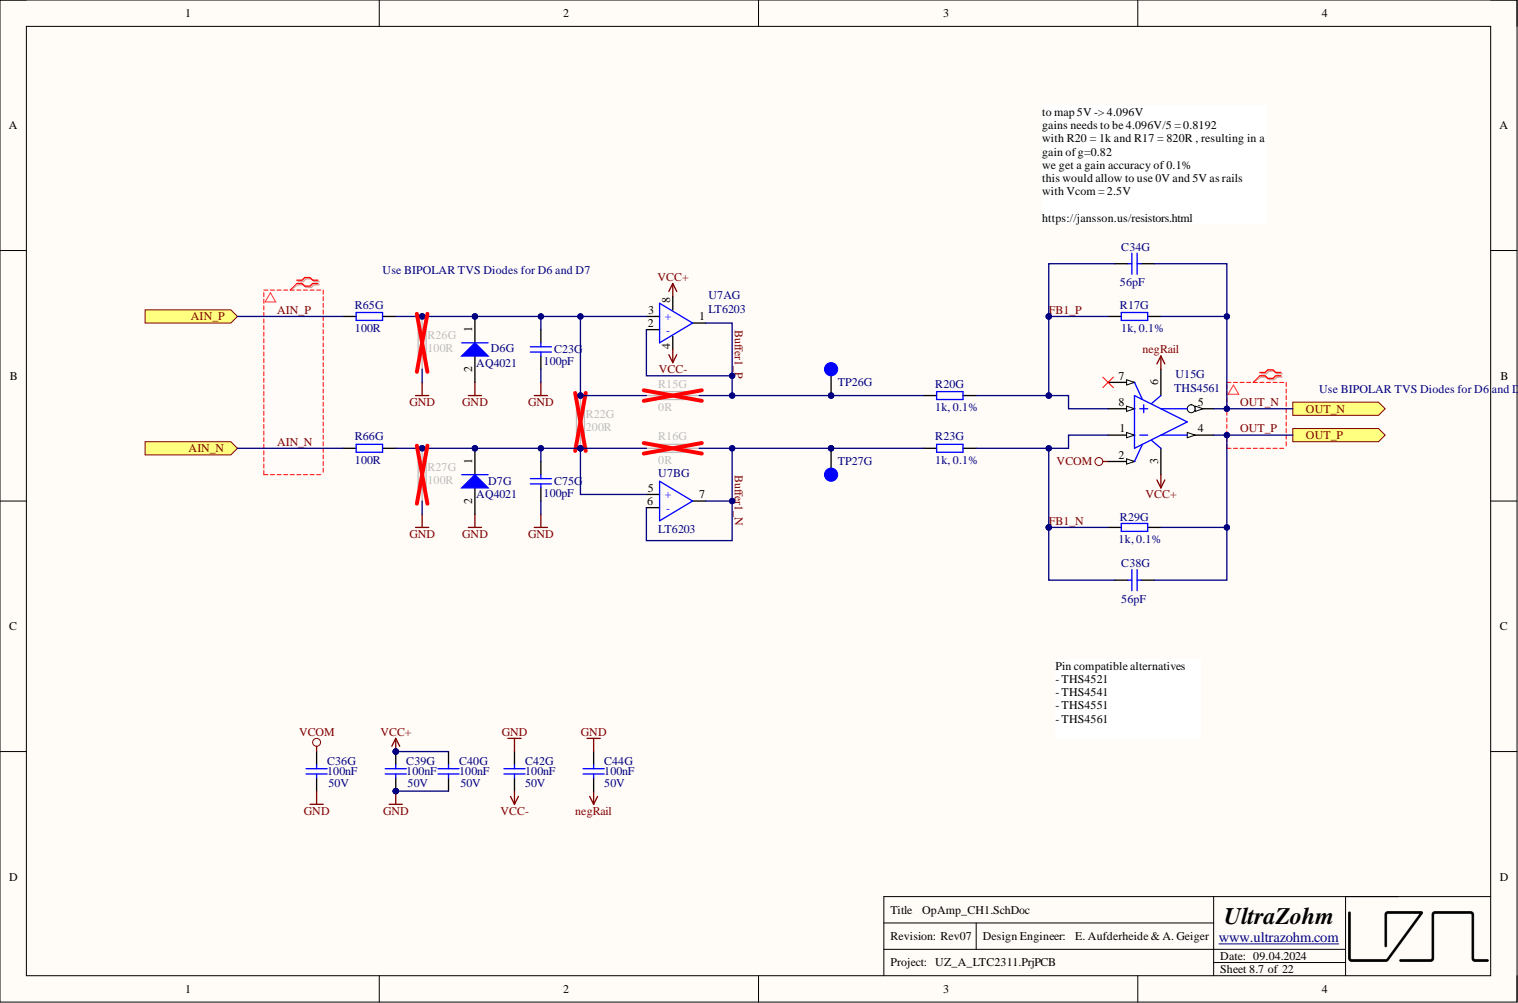
[picture p33: page 21]
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

https://jansson.us/resistors.html

Use BIPOLAR TVS Diodes for D6 and D7

VCC-
R15G

Use BIPOLAR TVS Diodes for D6 and D8
OUT_N

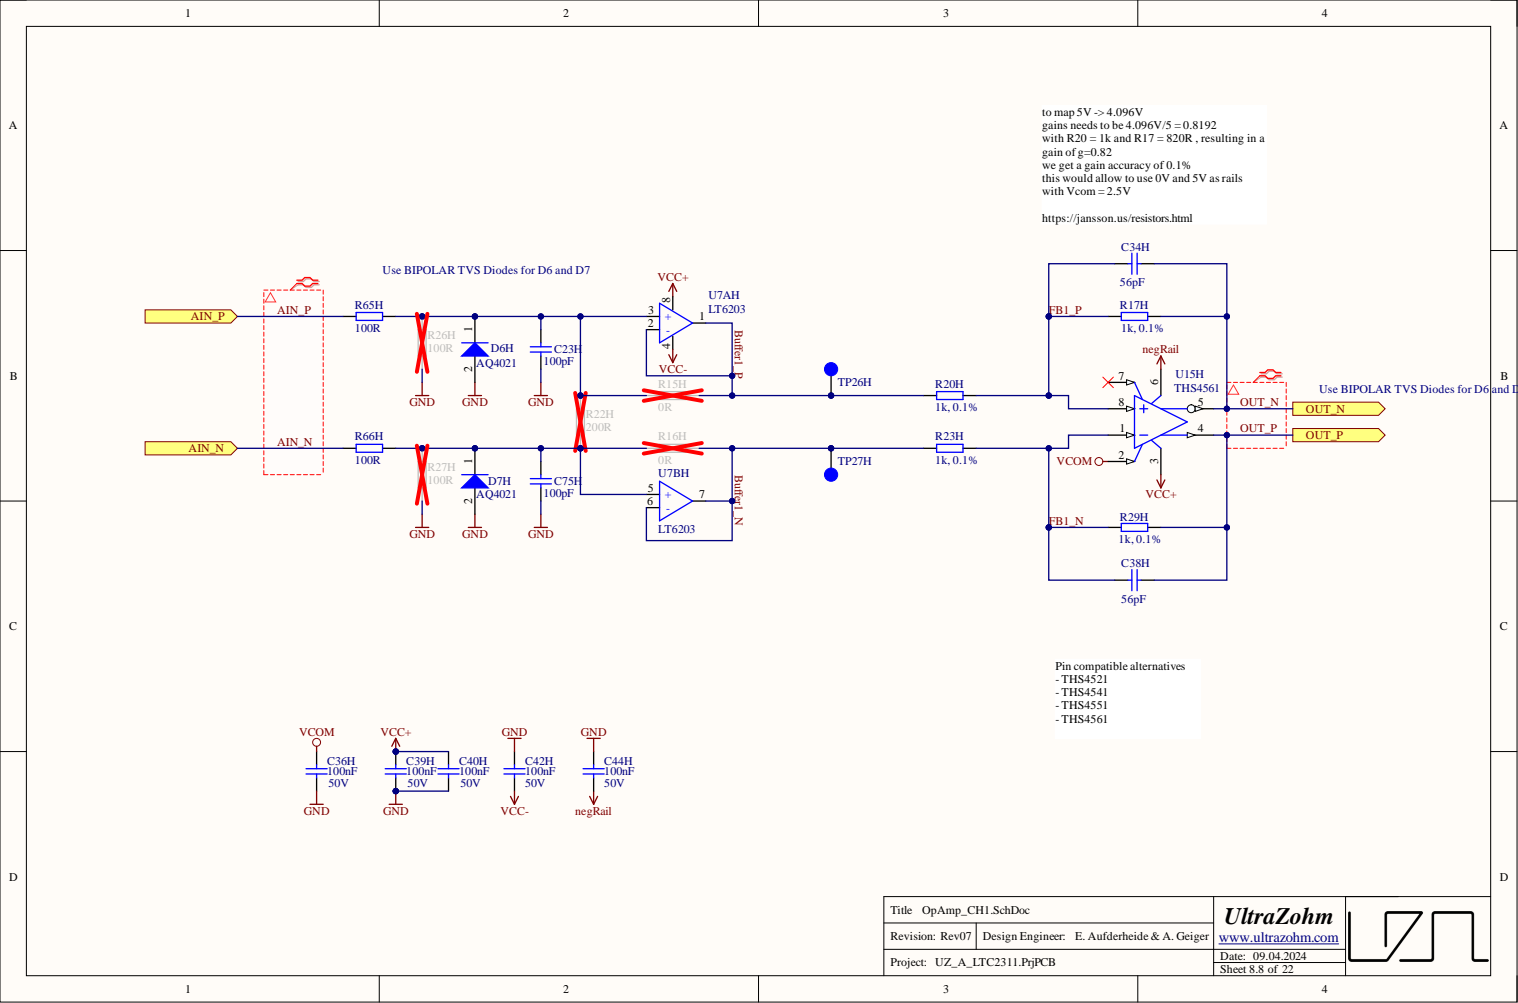
[picture p34: page 22]
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

https://jansson.us/resistors.html

Use BIPOLAR TVS Diodes for D6 and D7

VCC-
R15H

Use BIPOLAR TVS Diodes for D6 and D8
OUT_N
