ultrazohm/uz_a_ltc2311-16/Project Outputs for UZ_A_LTC2311/Rev06/SCH_UZ_A_LTC2311_Standard_Rev06.PDF

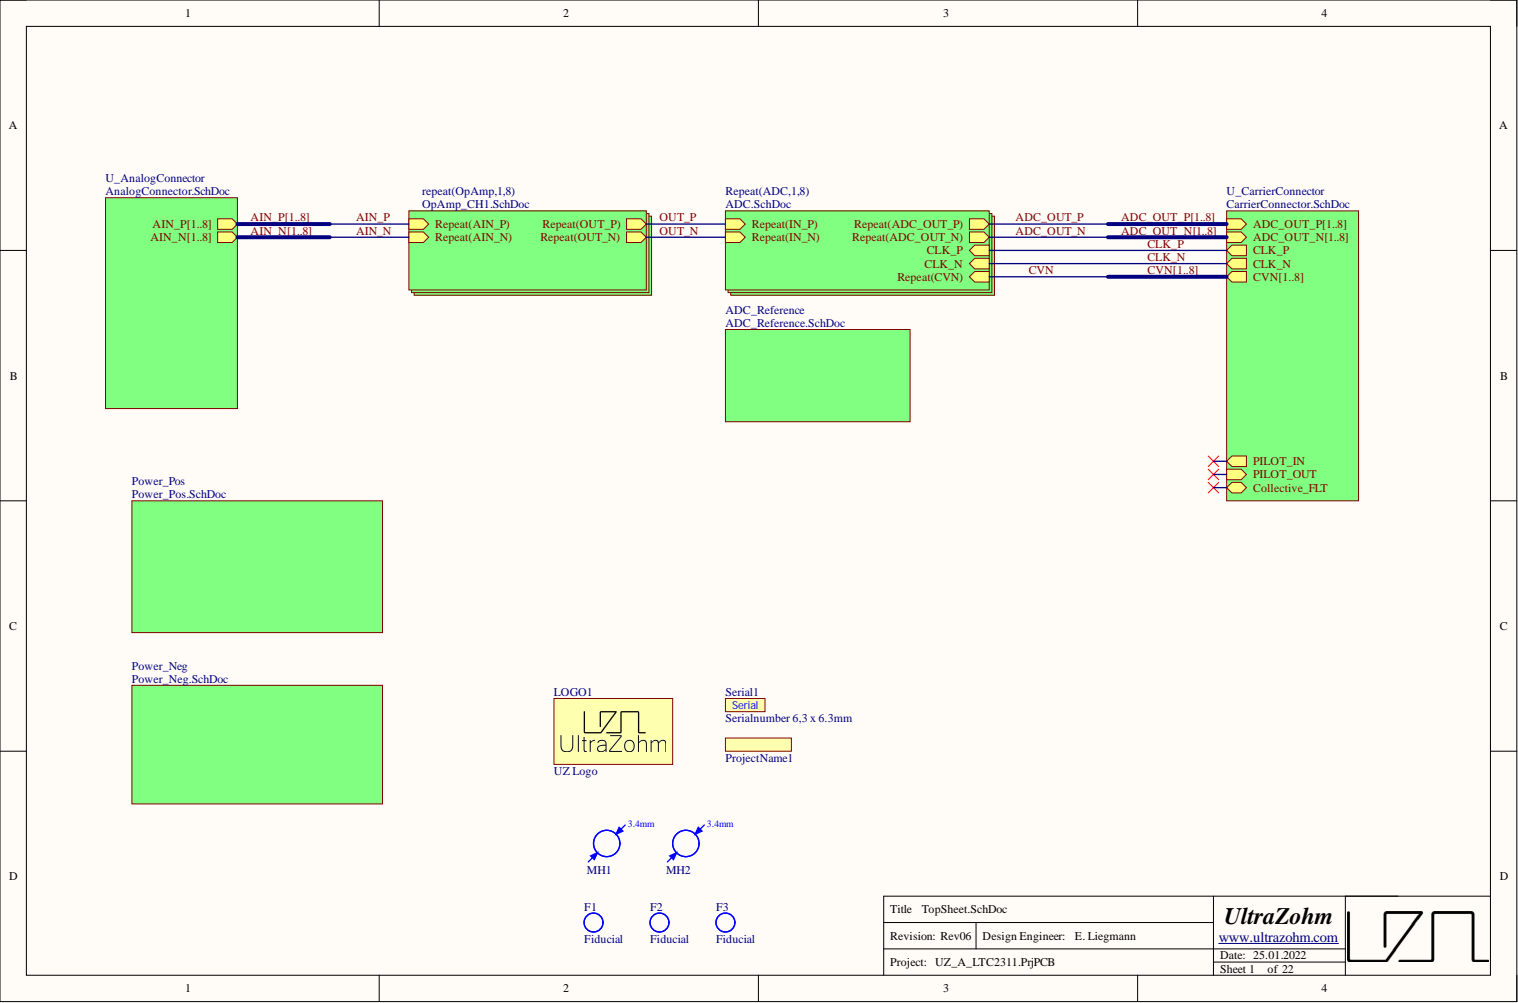
[picture p35: page 1]

Revision:

Date: 25.01.2022

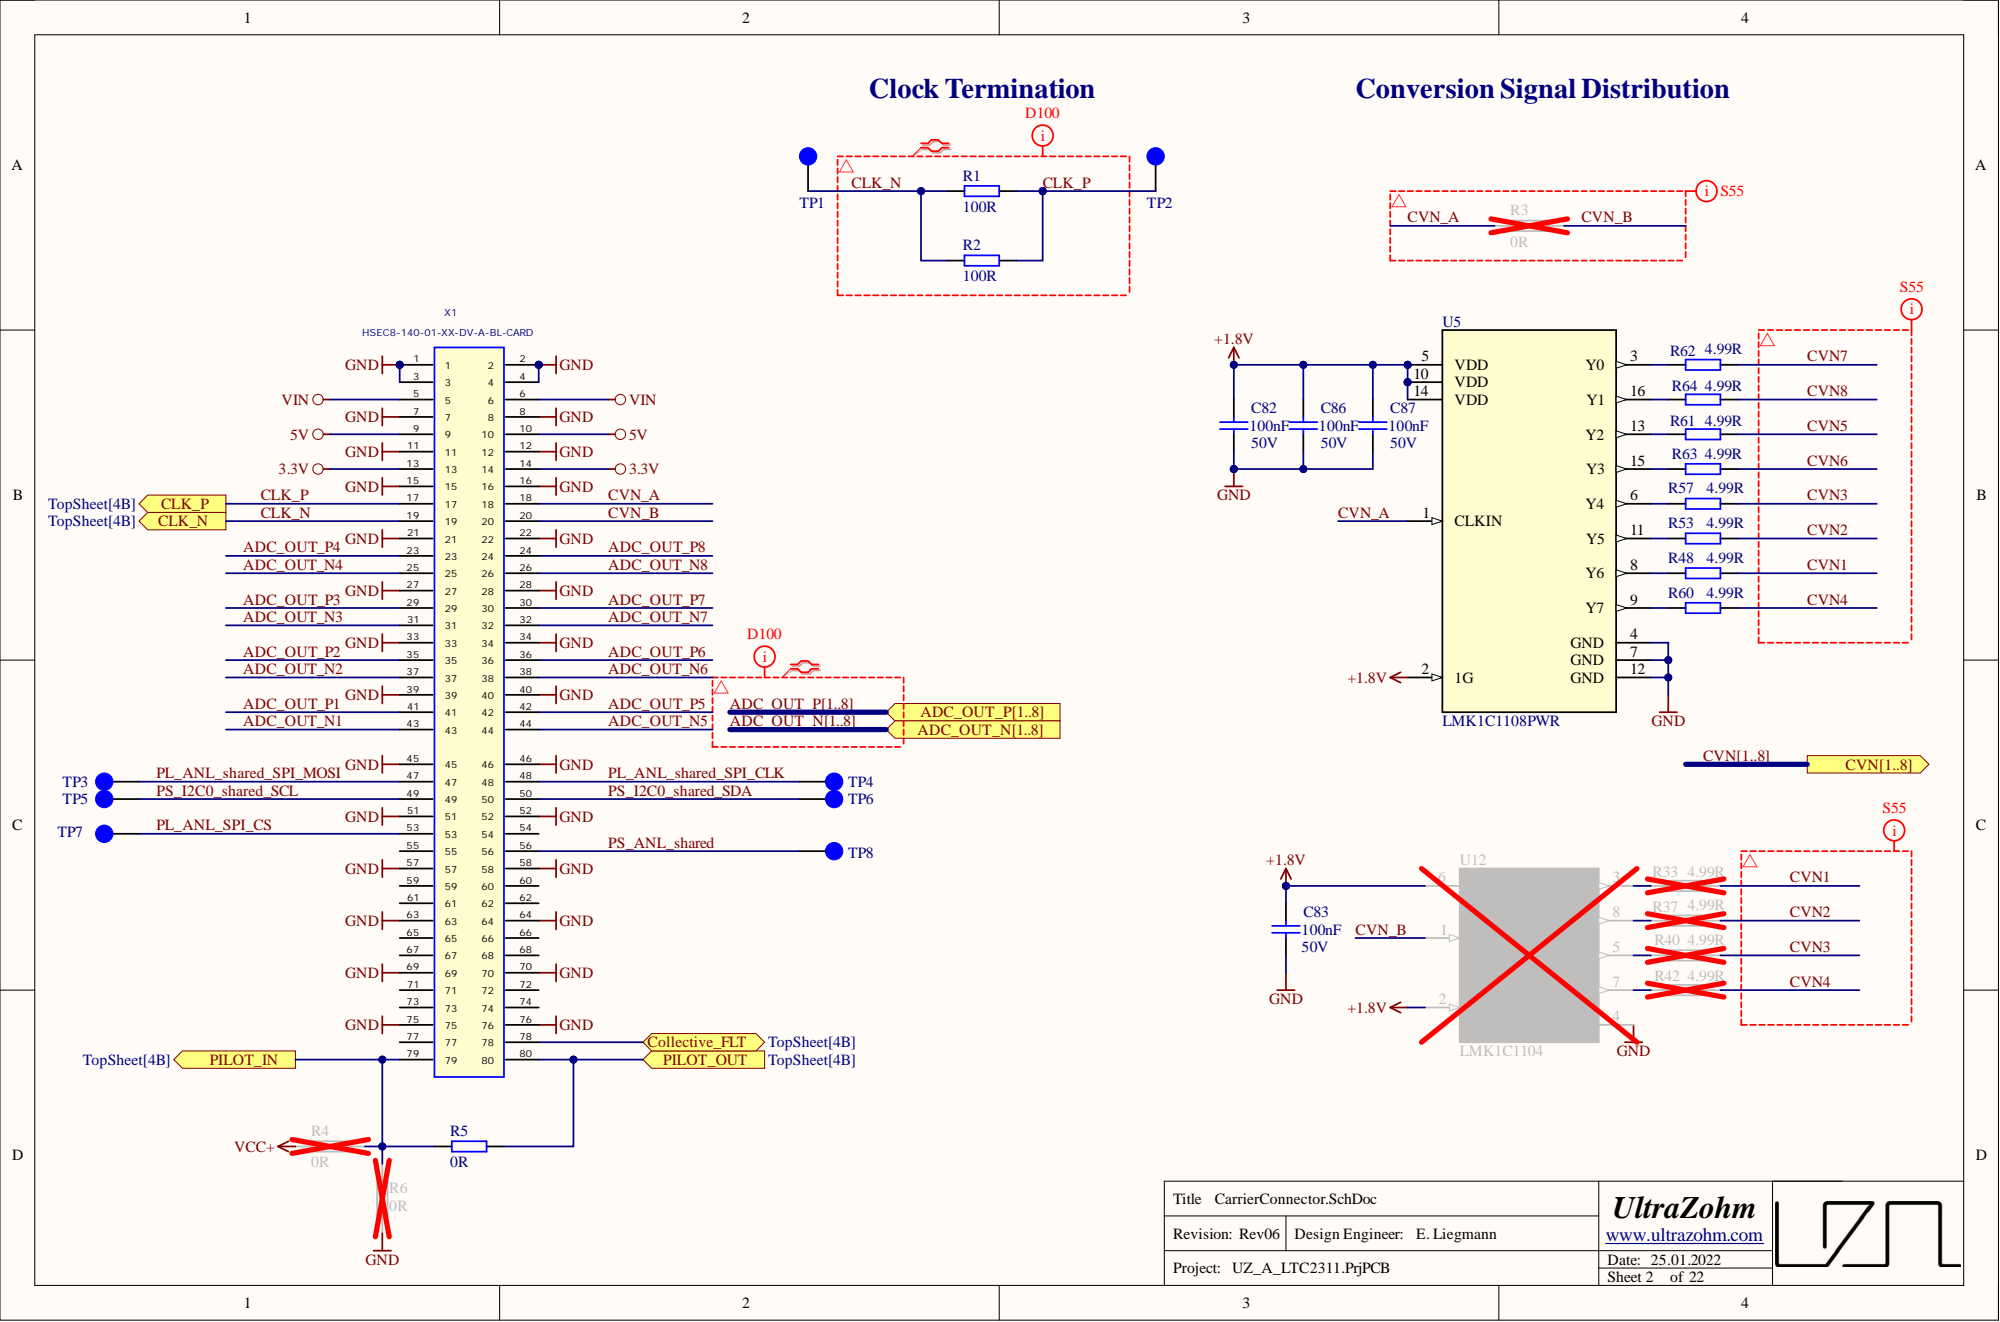
[picture p36: page 2]

HSEC8-140-01-XX-DV-A-BL-CARD

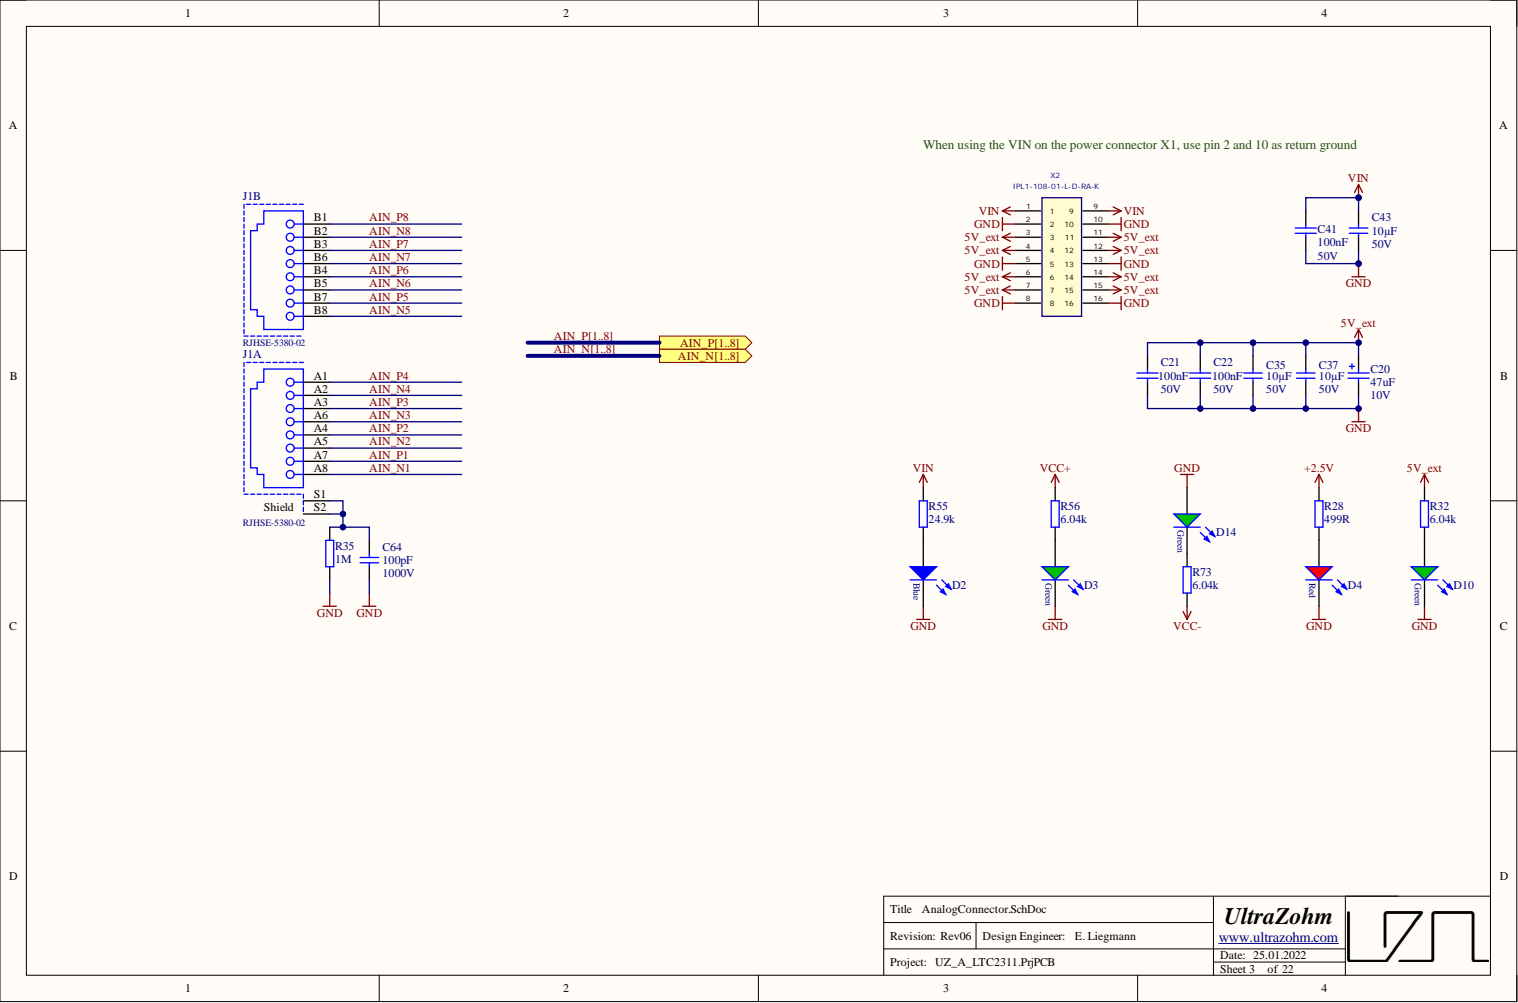
[picture p37: page 3]

Rev i s n

Dat e :

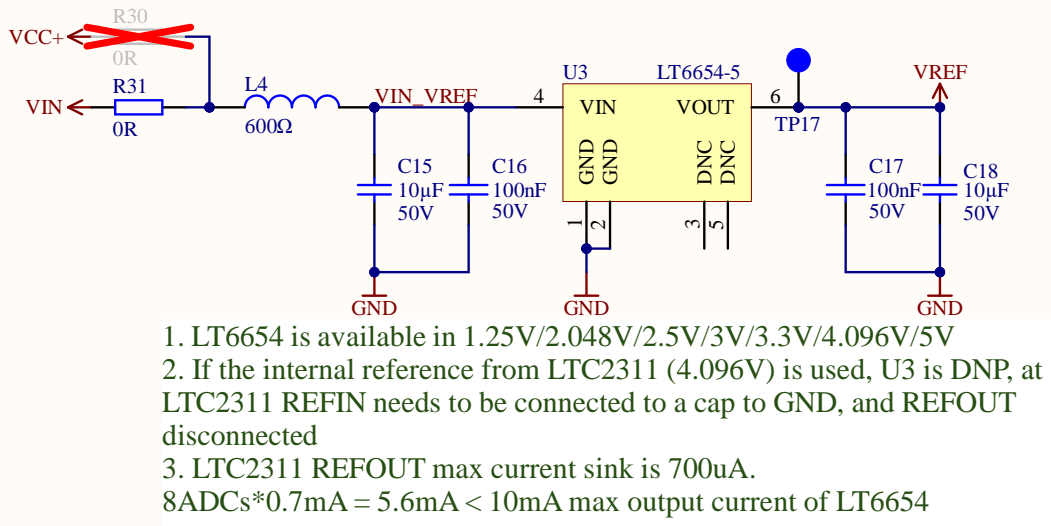
[picture p38: page 4]

max output current of

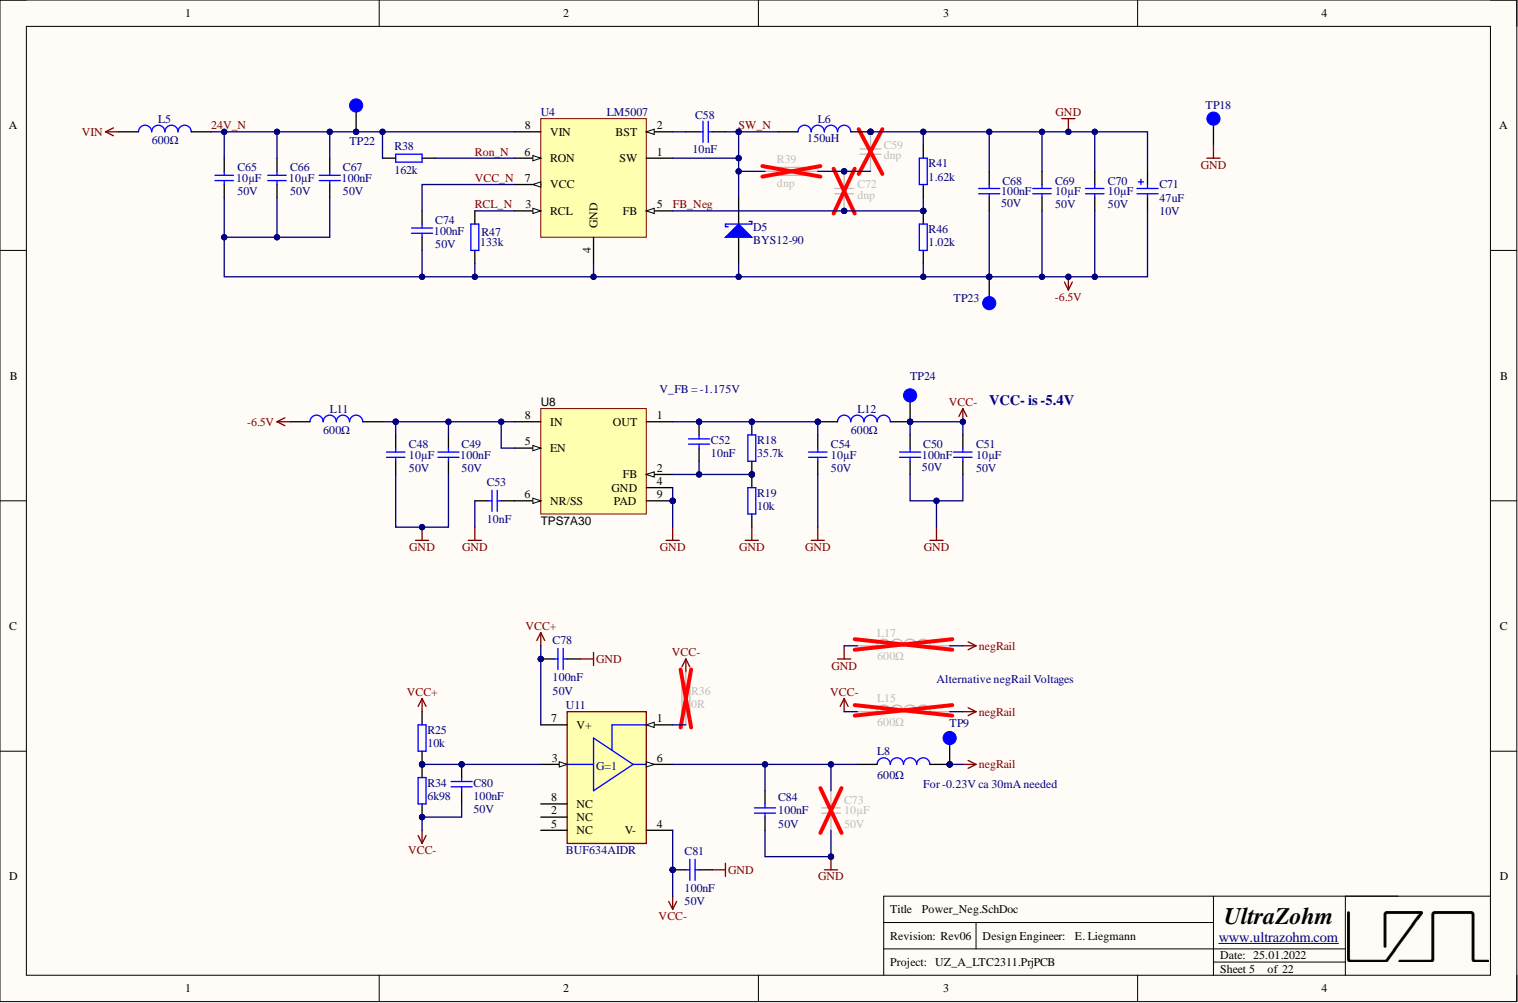
[picture p39: page 5]

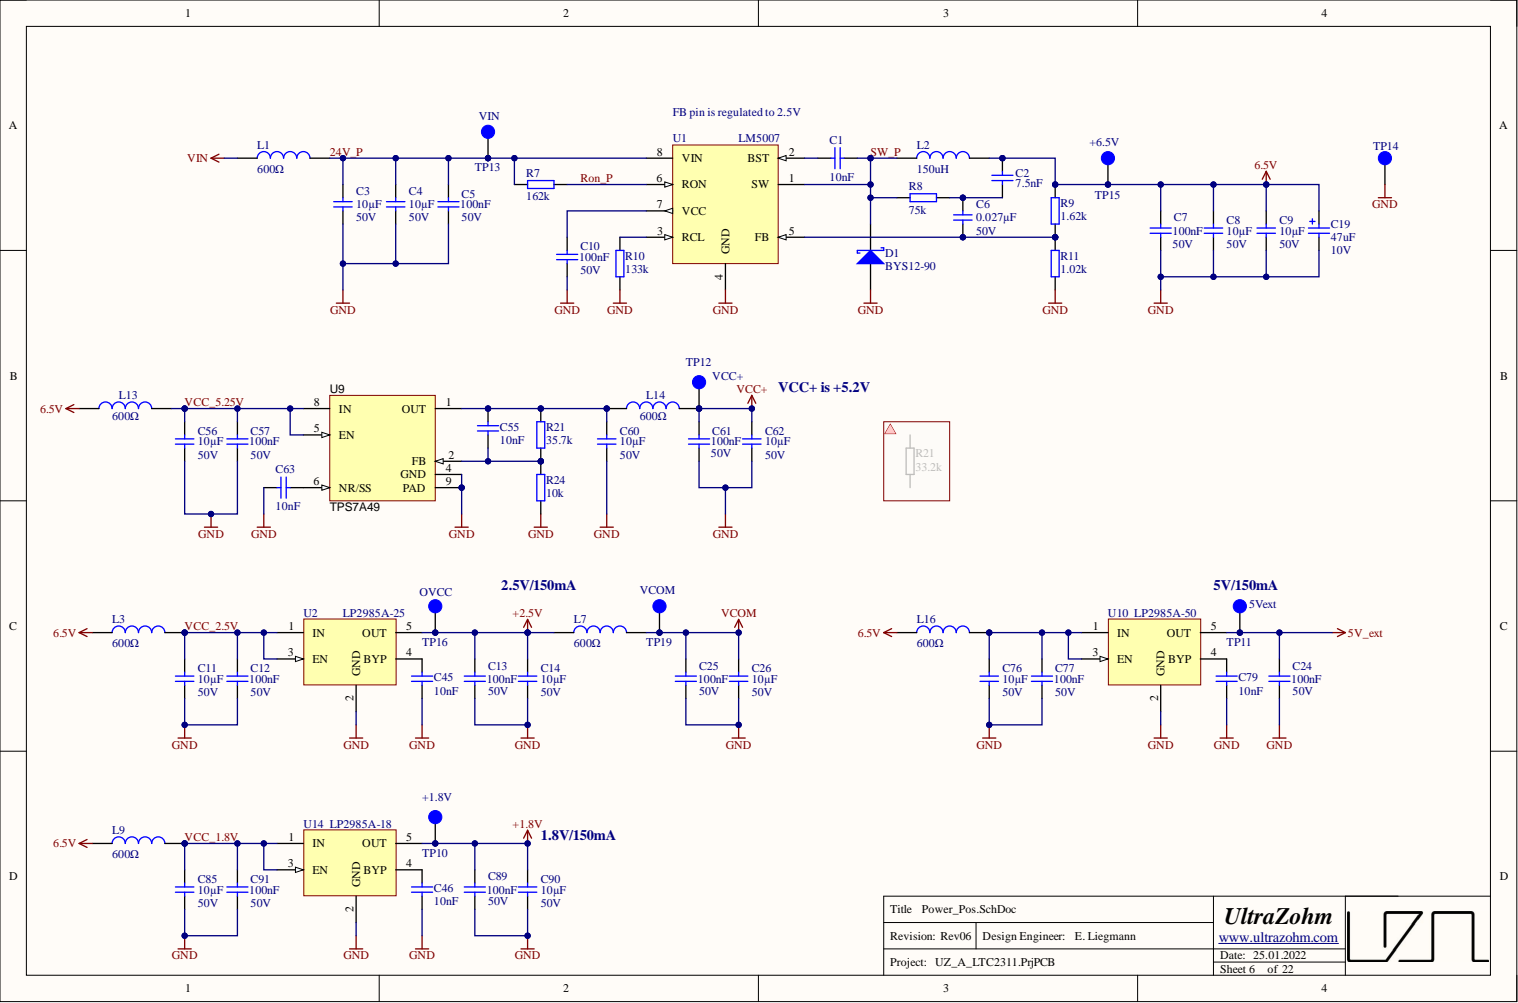
[picture p40: page 6]

FB pin is regulated to 2.5V

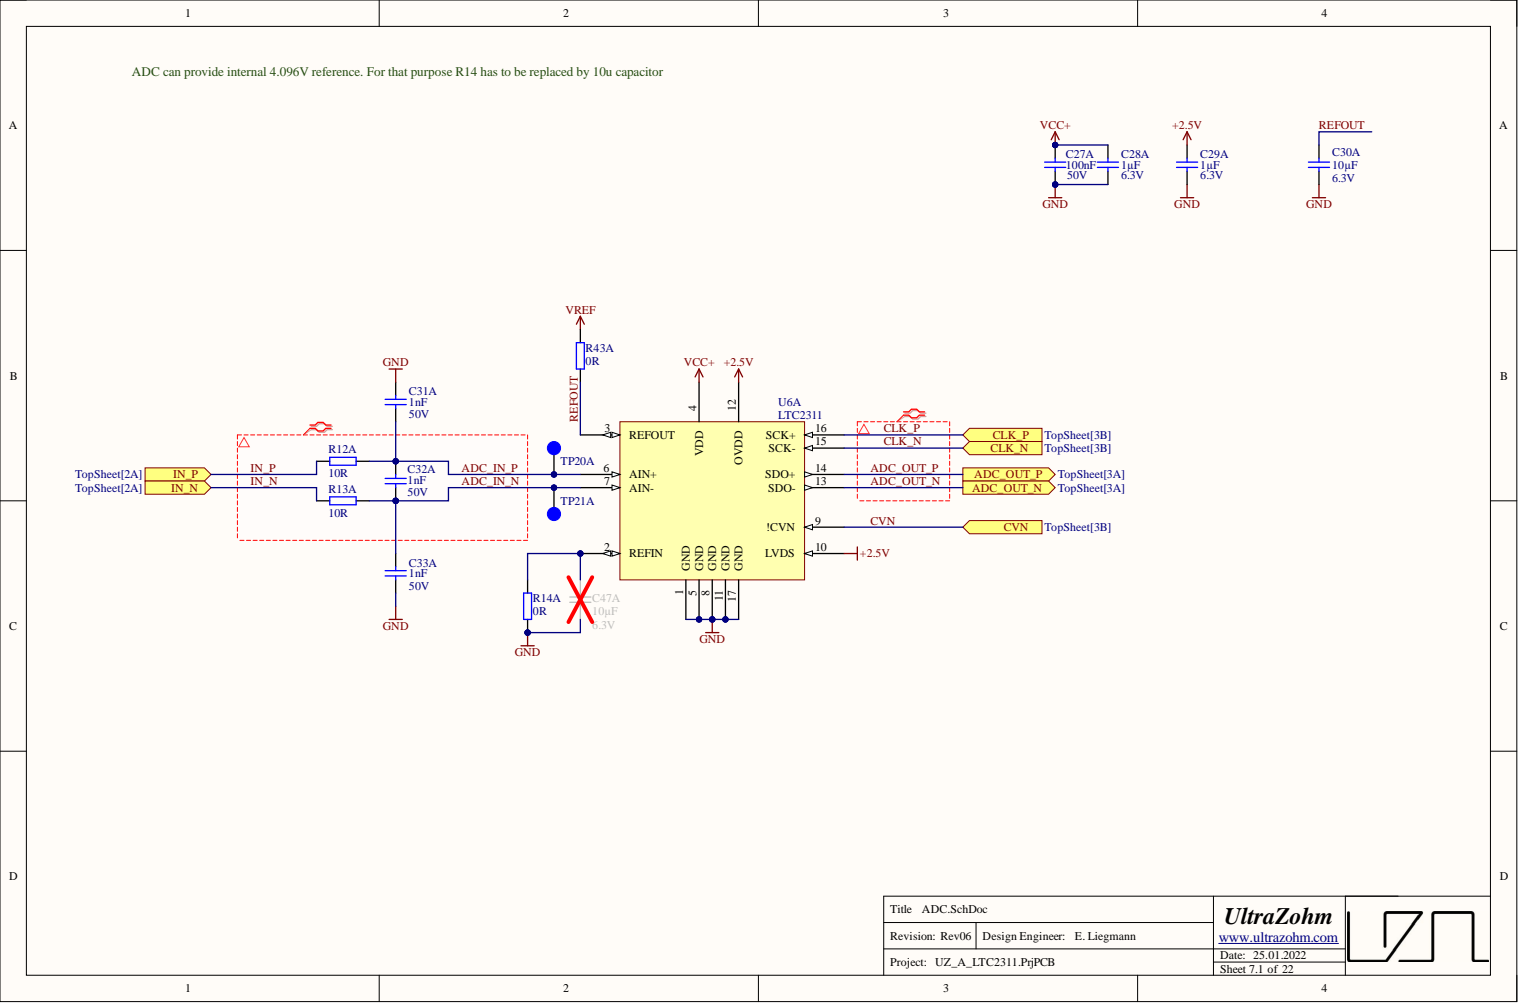
[picture p41: page 7]

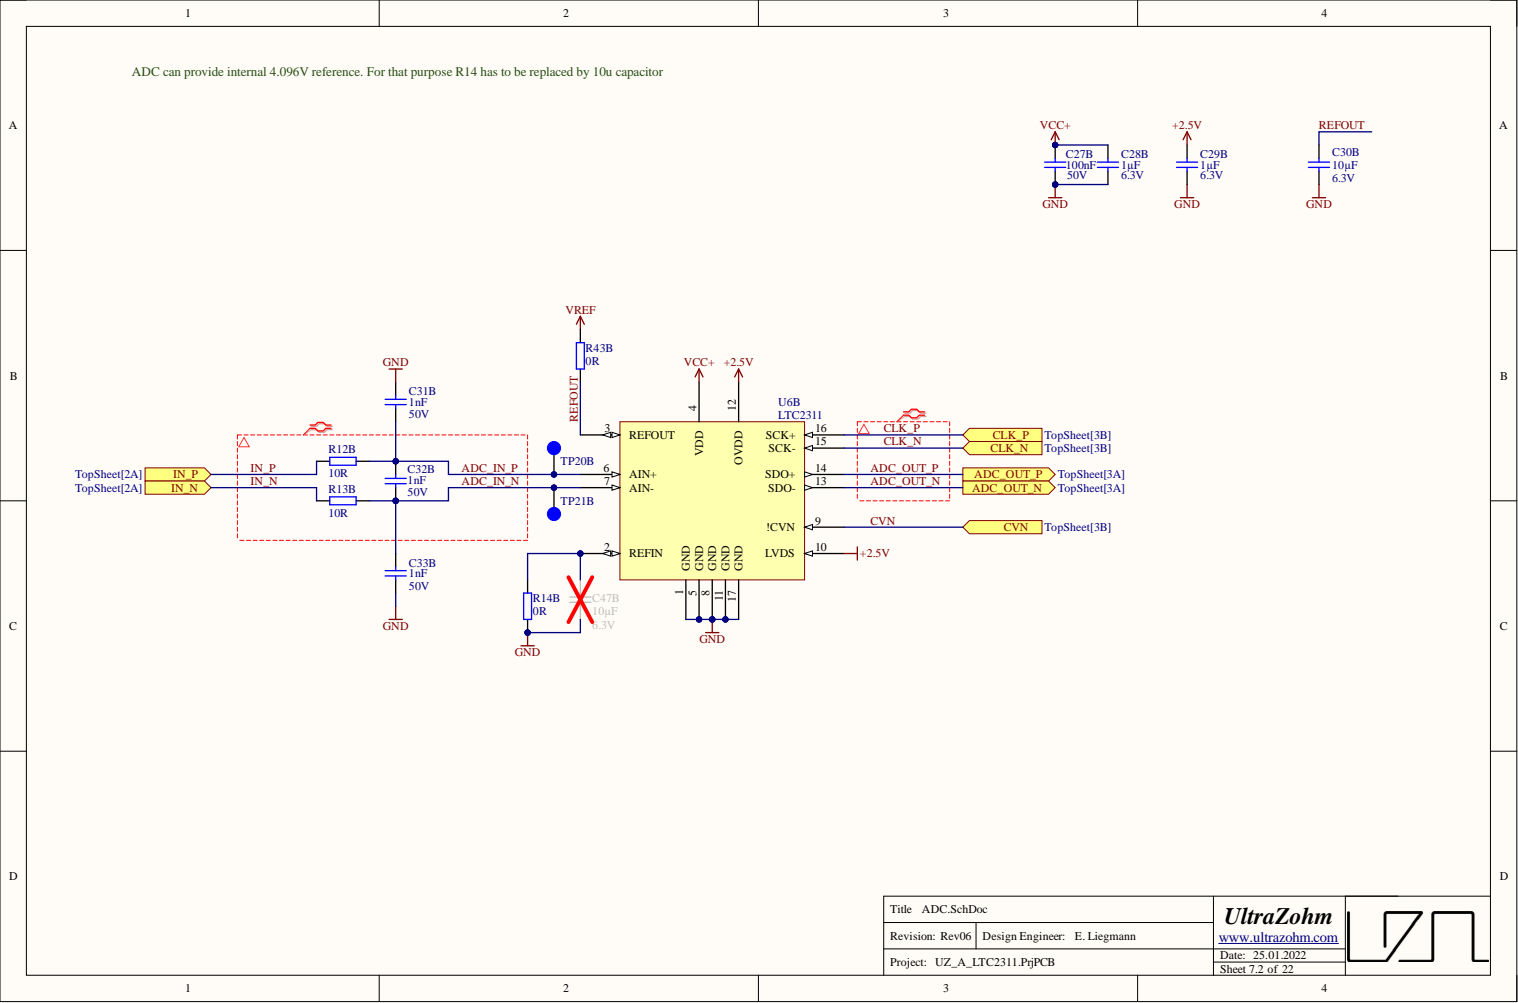
[picture p42: page 8]

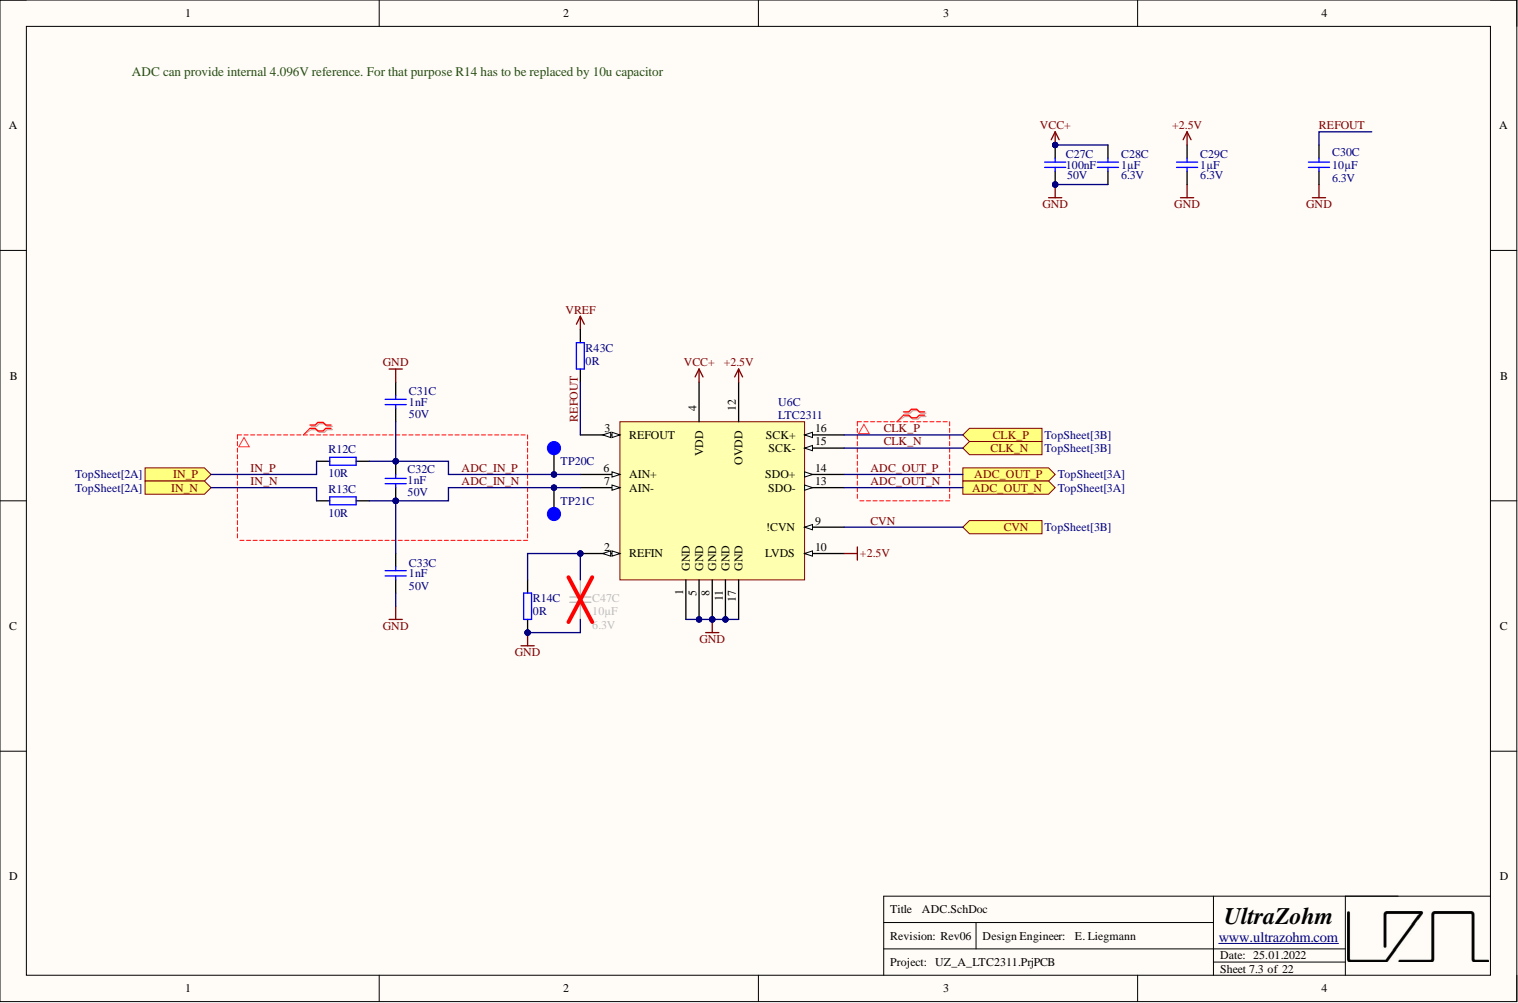
[picture p43: page 9]

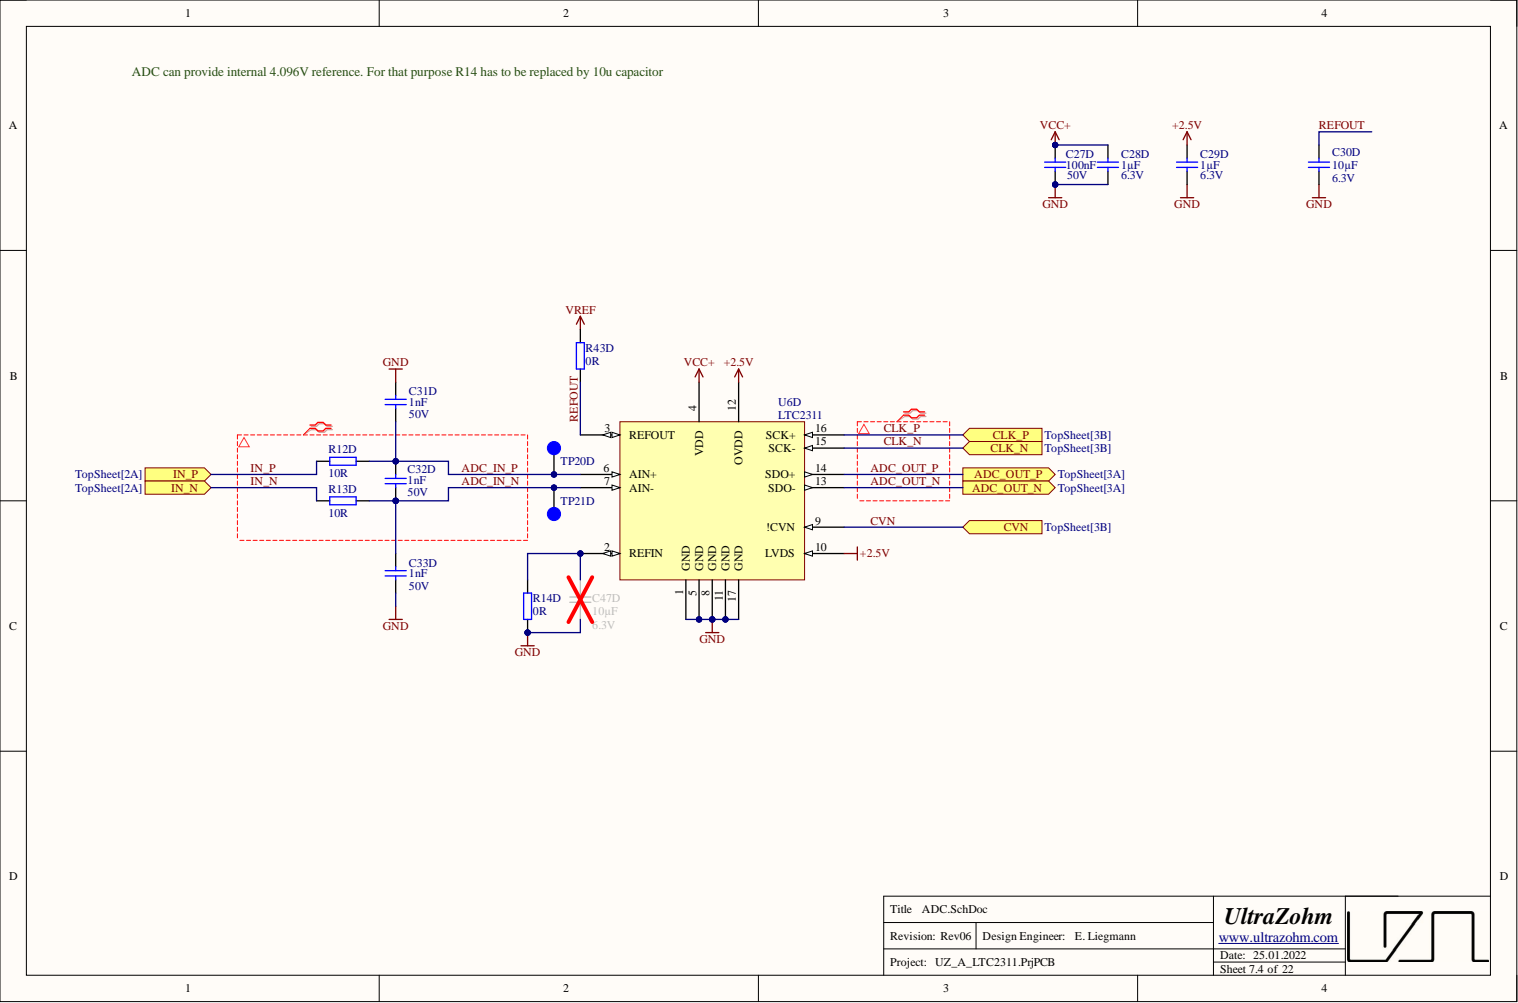
[picture p44: page 10]

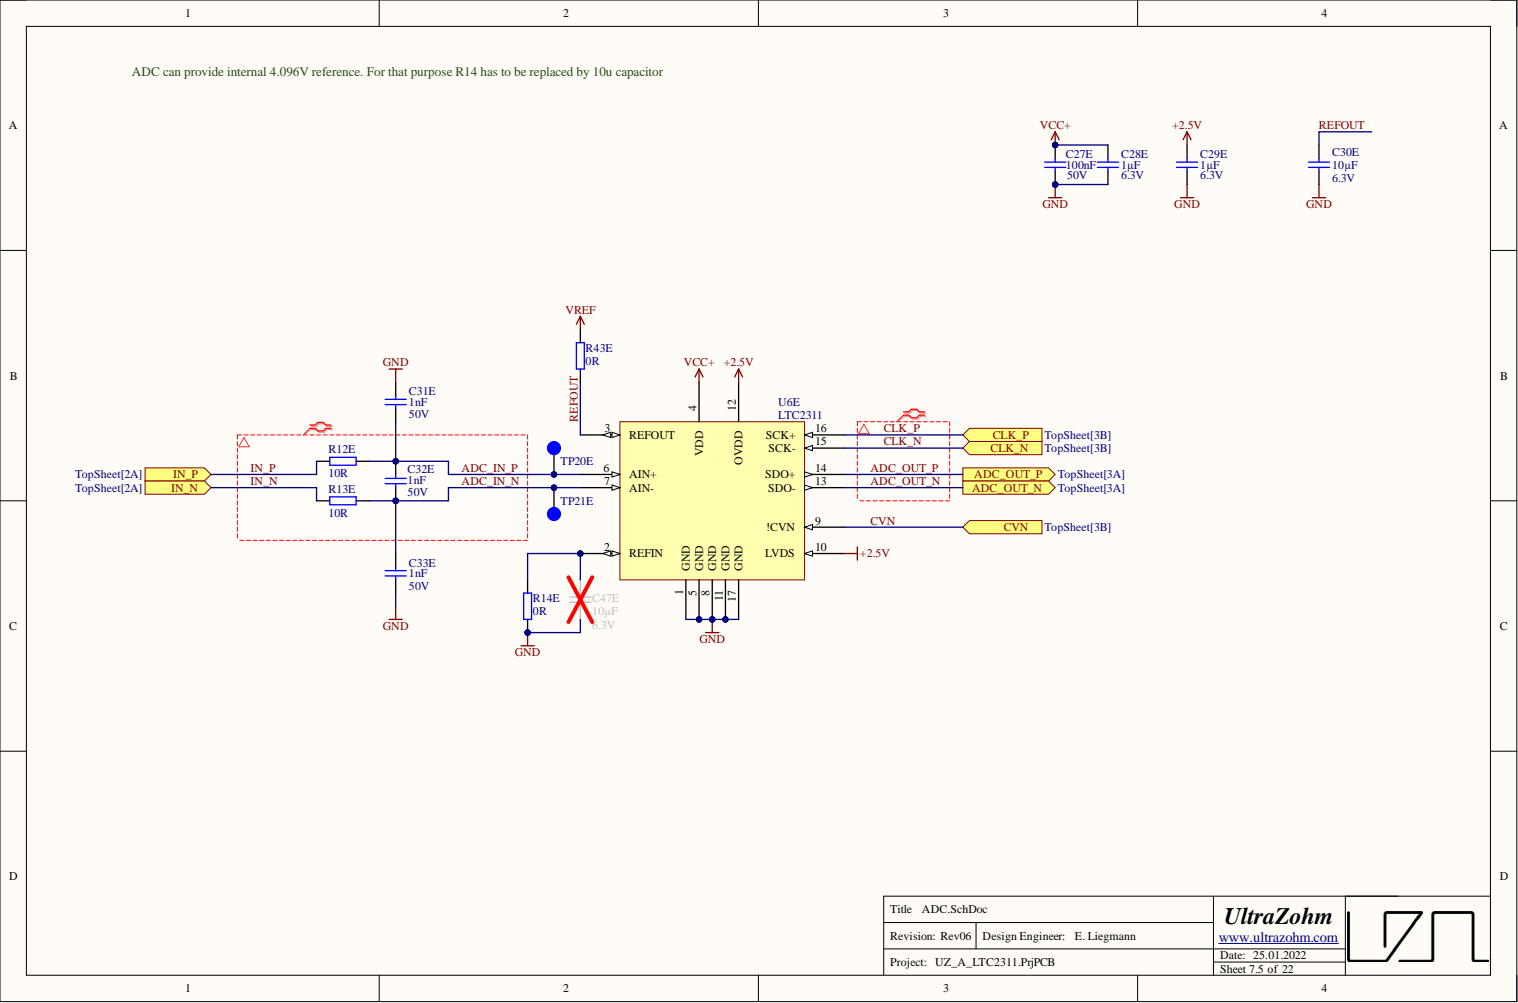
[picture p45: page 11]

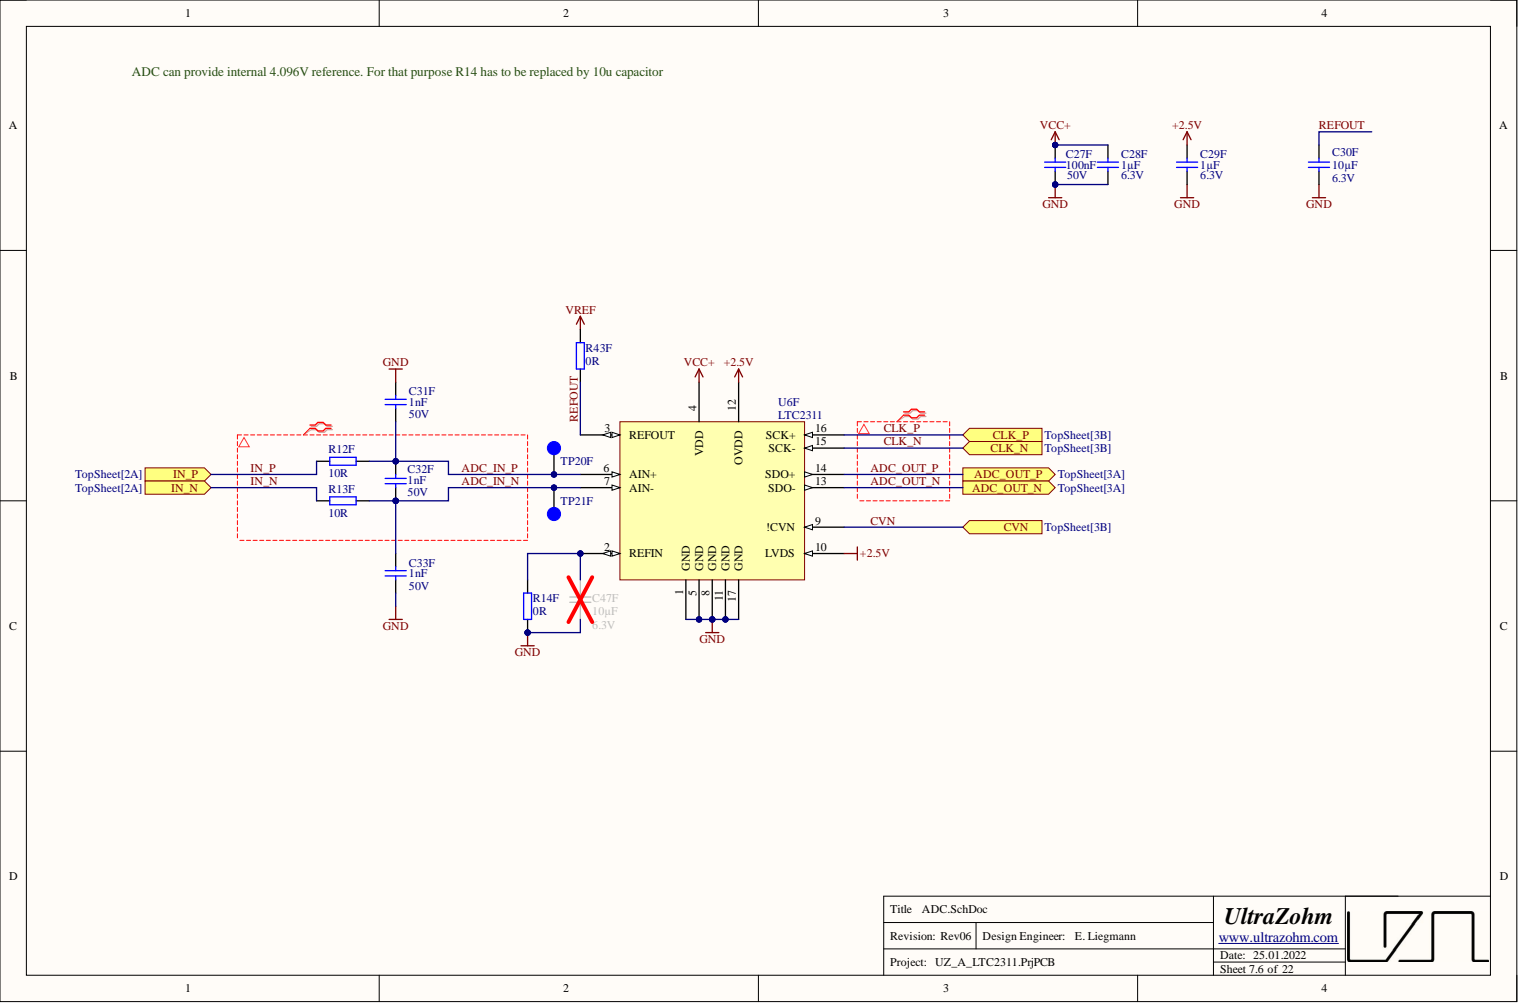
[picture p46: page 12]

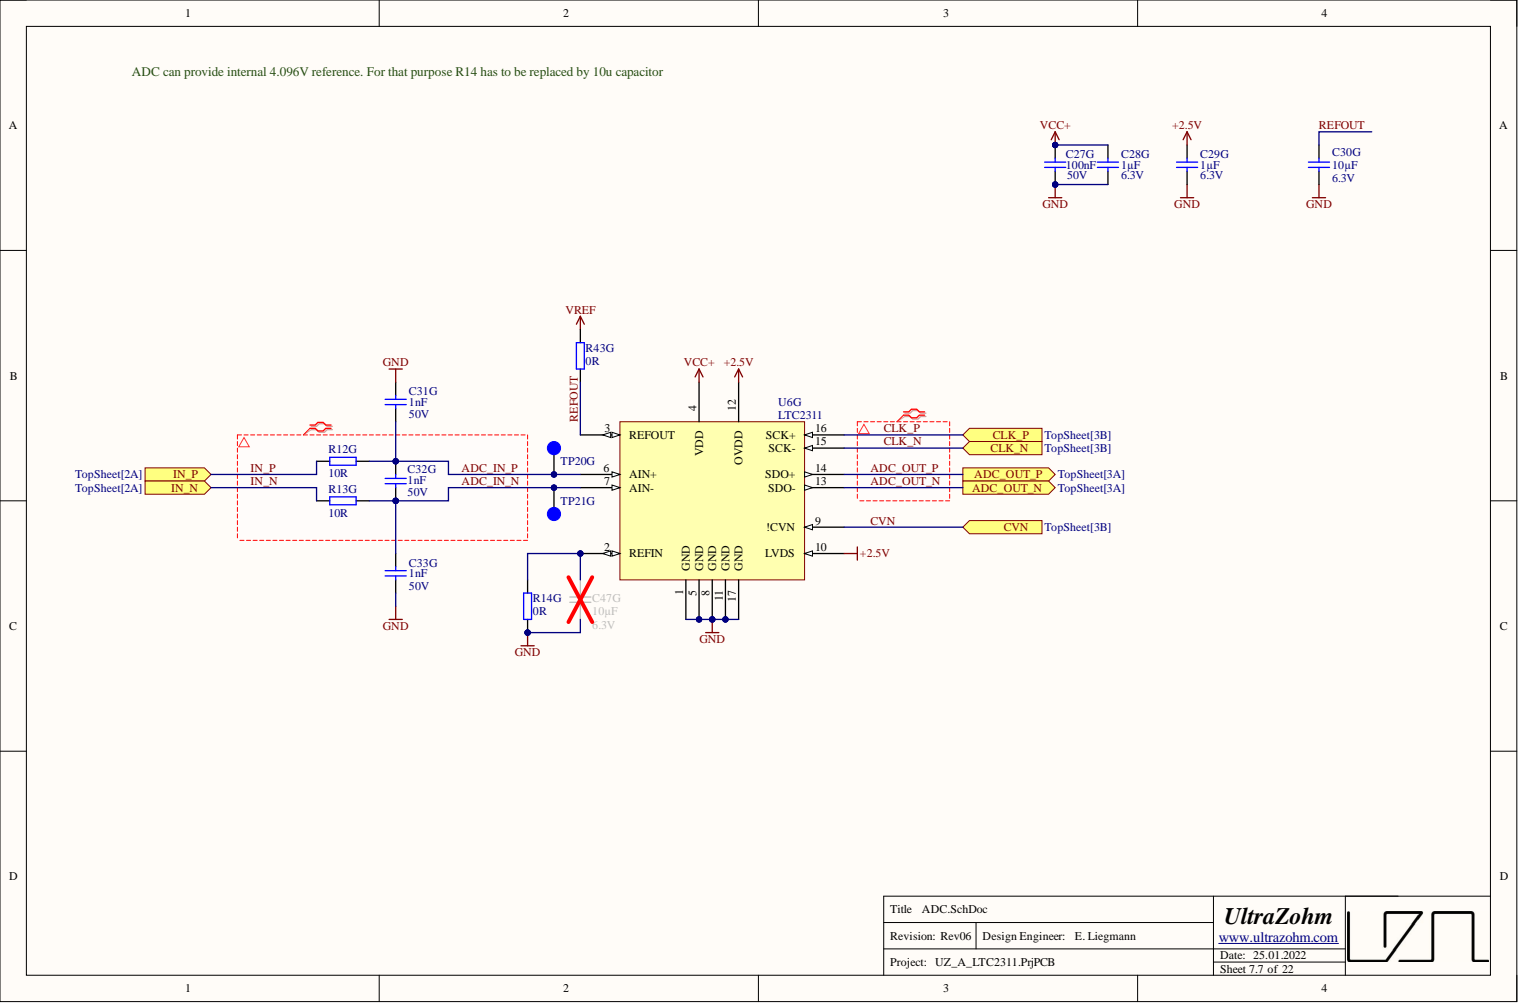
[picture p47: page 13]

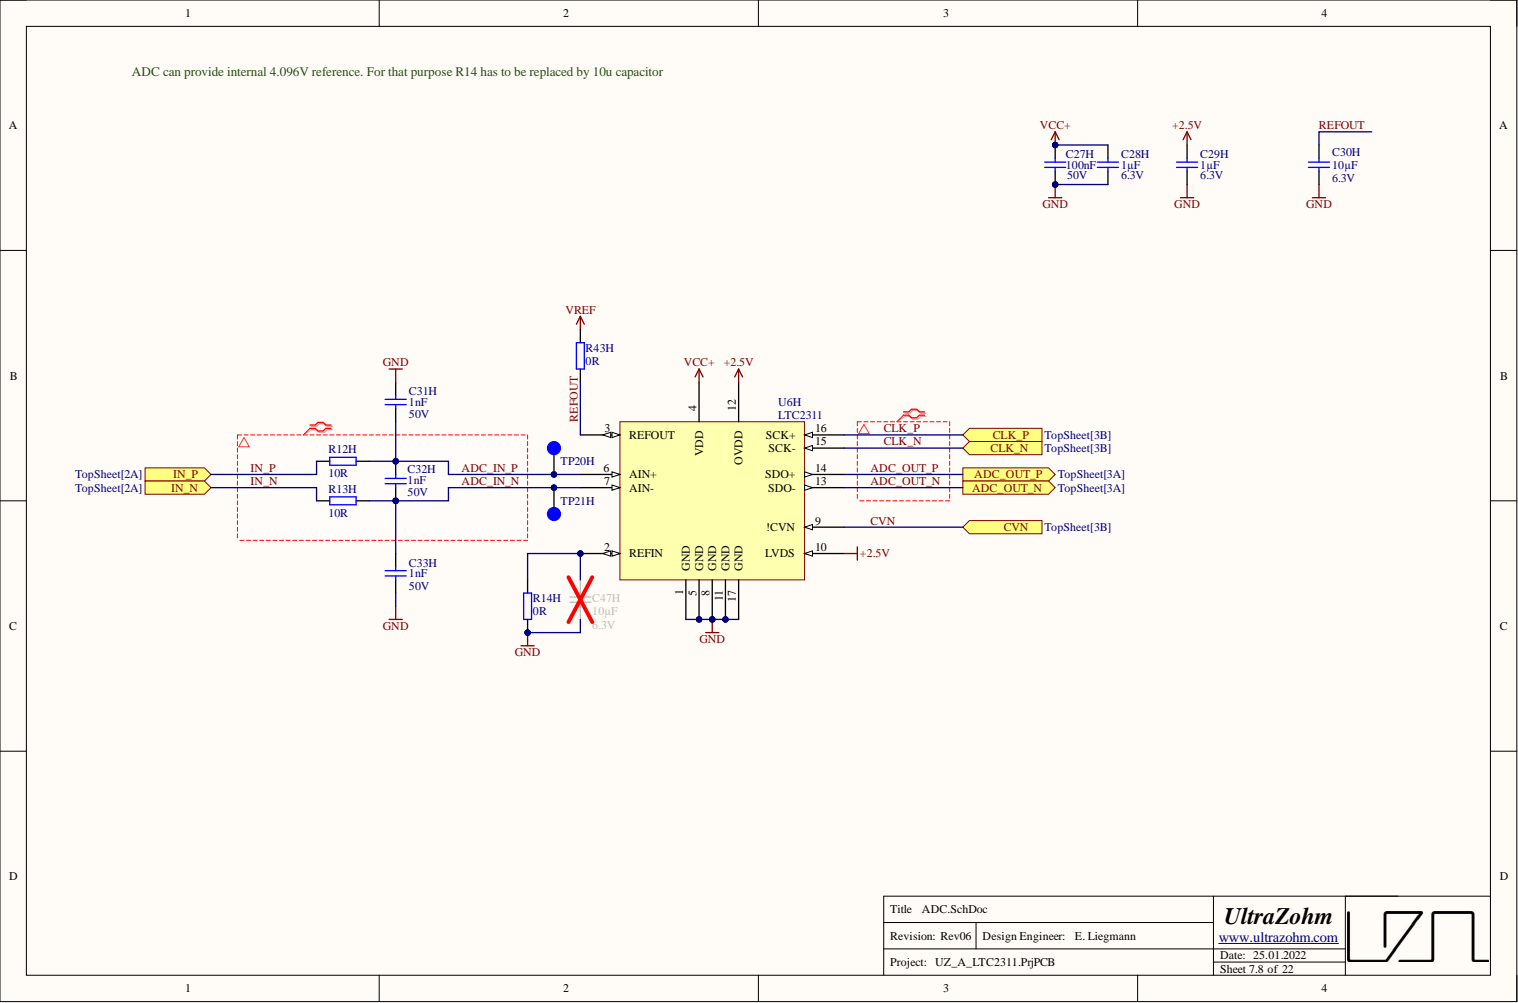
[picture p48: page 14]

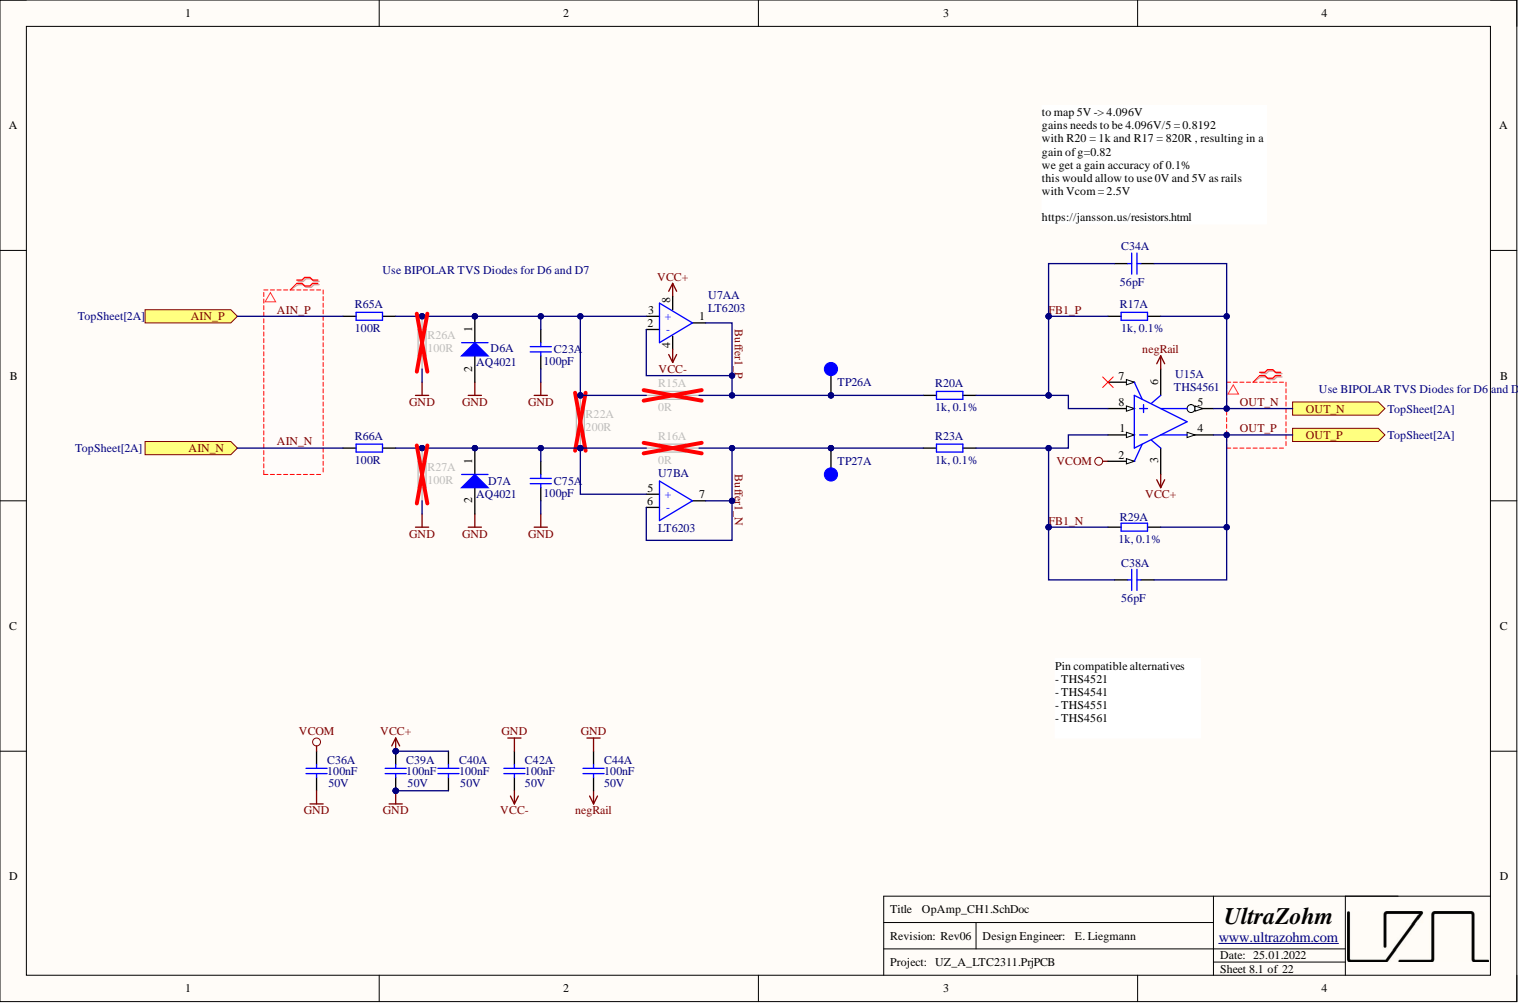
[picture p49: page 15]

to map 5V -> 4.096V
gains needs to be 4.096V/5 = 0.8192
with R20 = 1k and R17 = 820R , resulting in a
gain of g=0.82
we get a gain accuracy of 0.1%
this would allow to use 0V and 5V as rails
with Vcom = 2.5V

https://jansson.us/resistors.html

Use BIPOLAR TVS Diodes for D6 and D7

VCC-
R15A

Use BIPOLAR TVS Diodes for D6 and D8

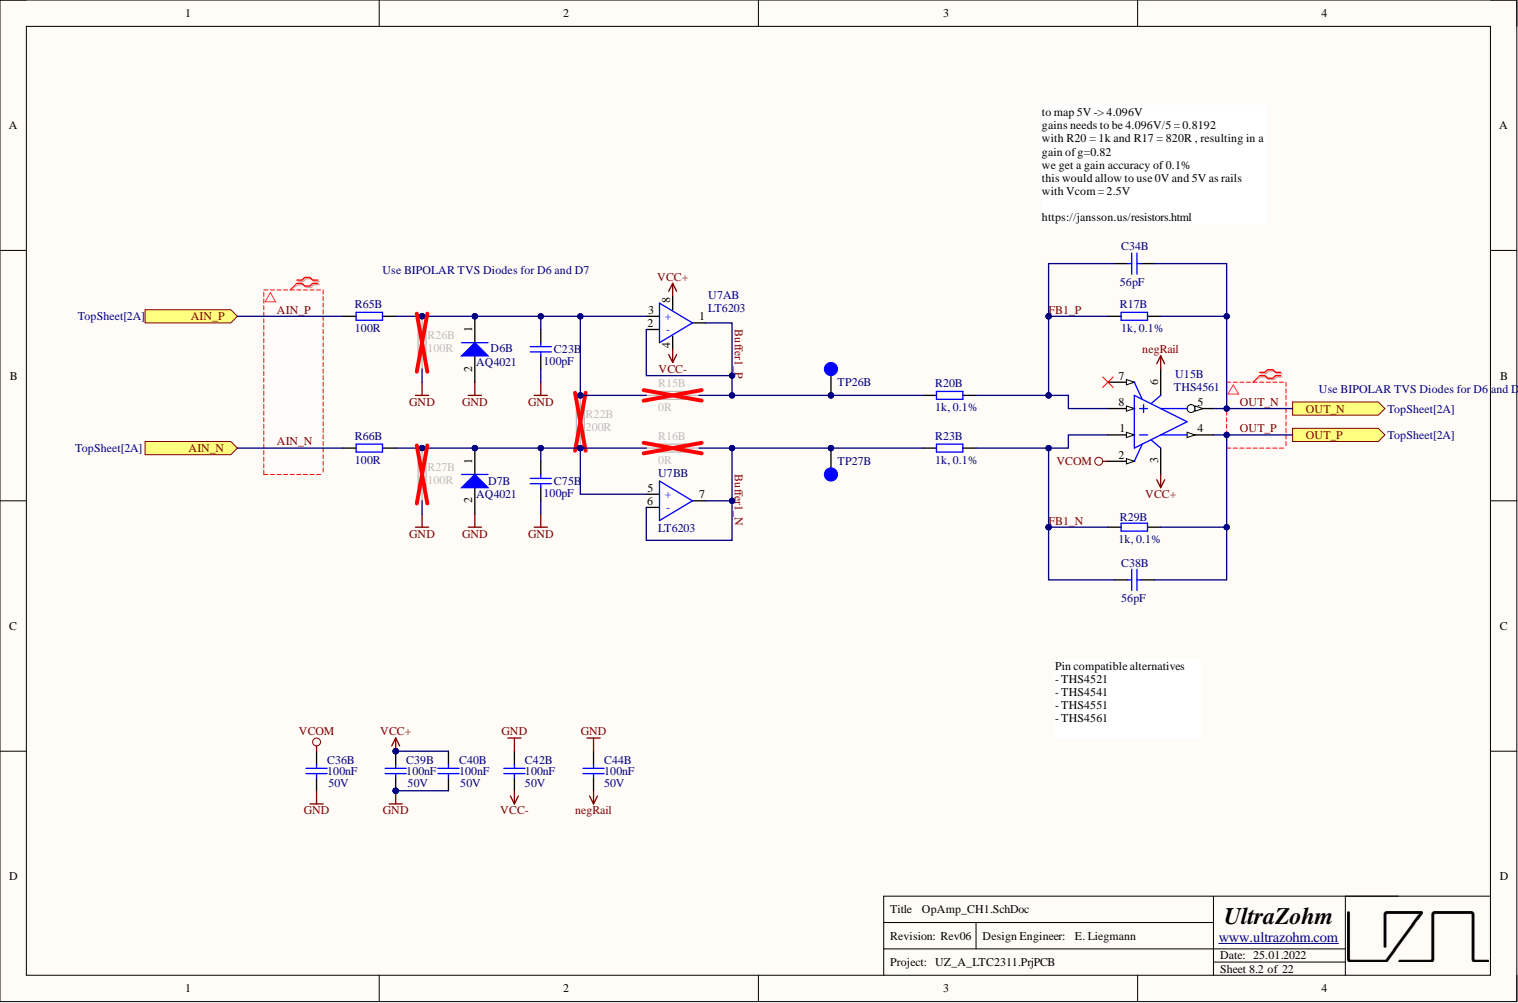
[picture p50: page 16]
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

https://jansson.us/resistors.html

Use BIPOLAR TVS Diodes for D6 and D7

VCC-
R15B

Use BIPOLAR TVS Diodes for D6 and D8

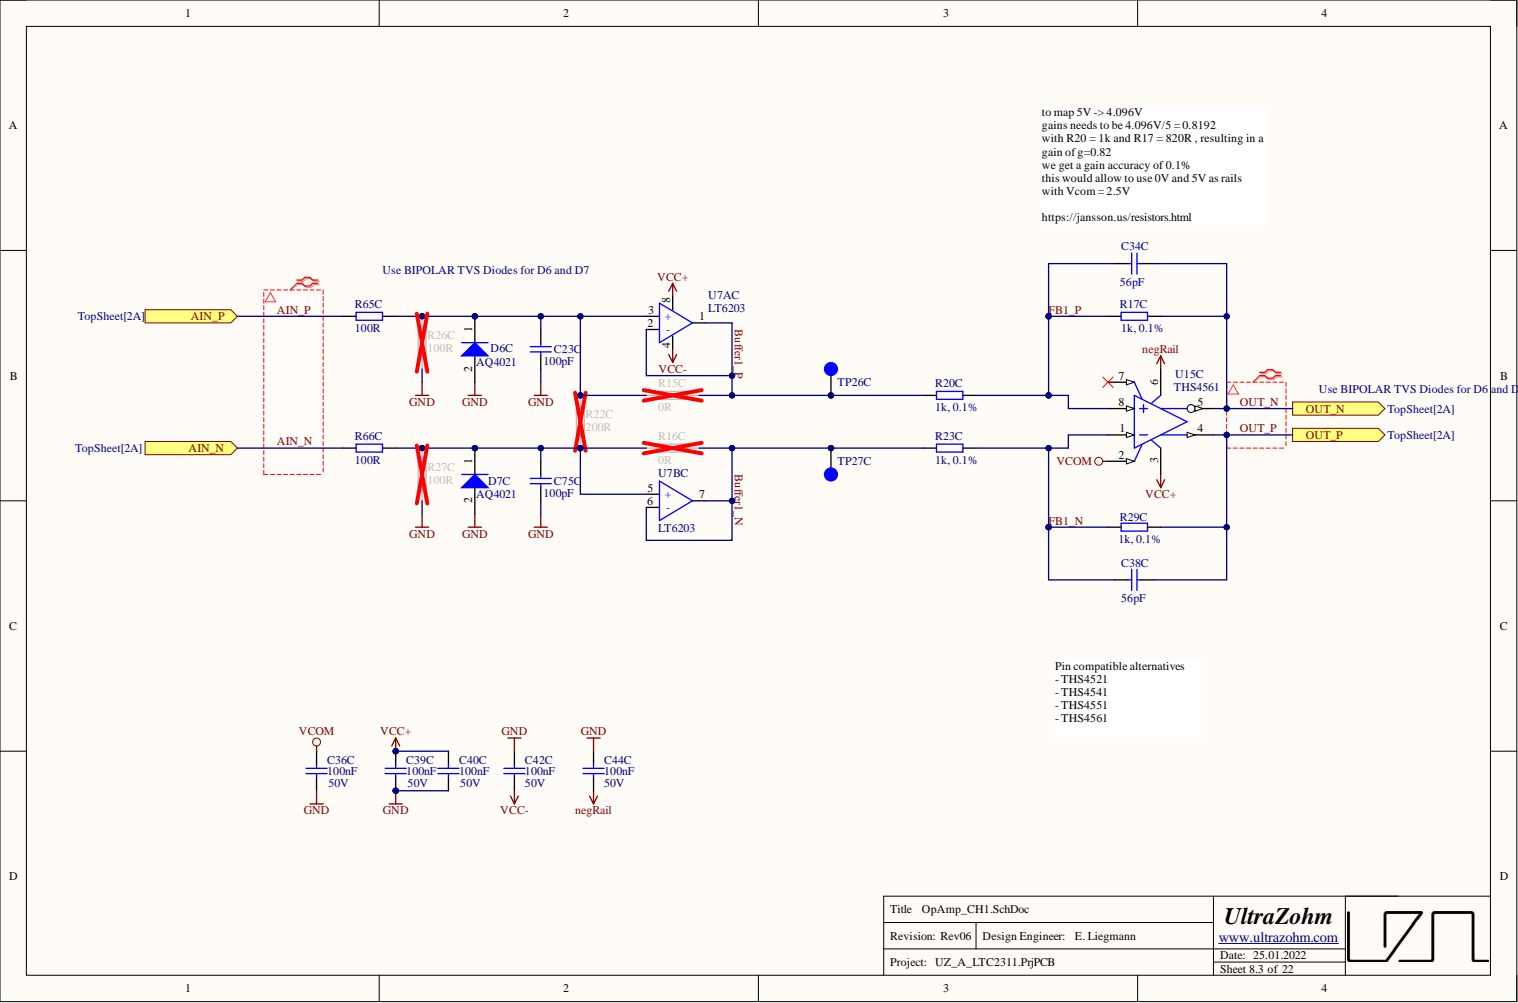
[picture p51: page 17]
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

https://jansson.us/resistors.html

Use BIPOLAR TVS Diodes for D6 and D7

VCC-
R15C

Use BIPOLAR TVS Diodes for D6 and D8

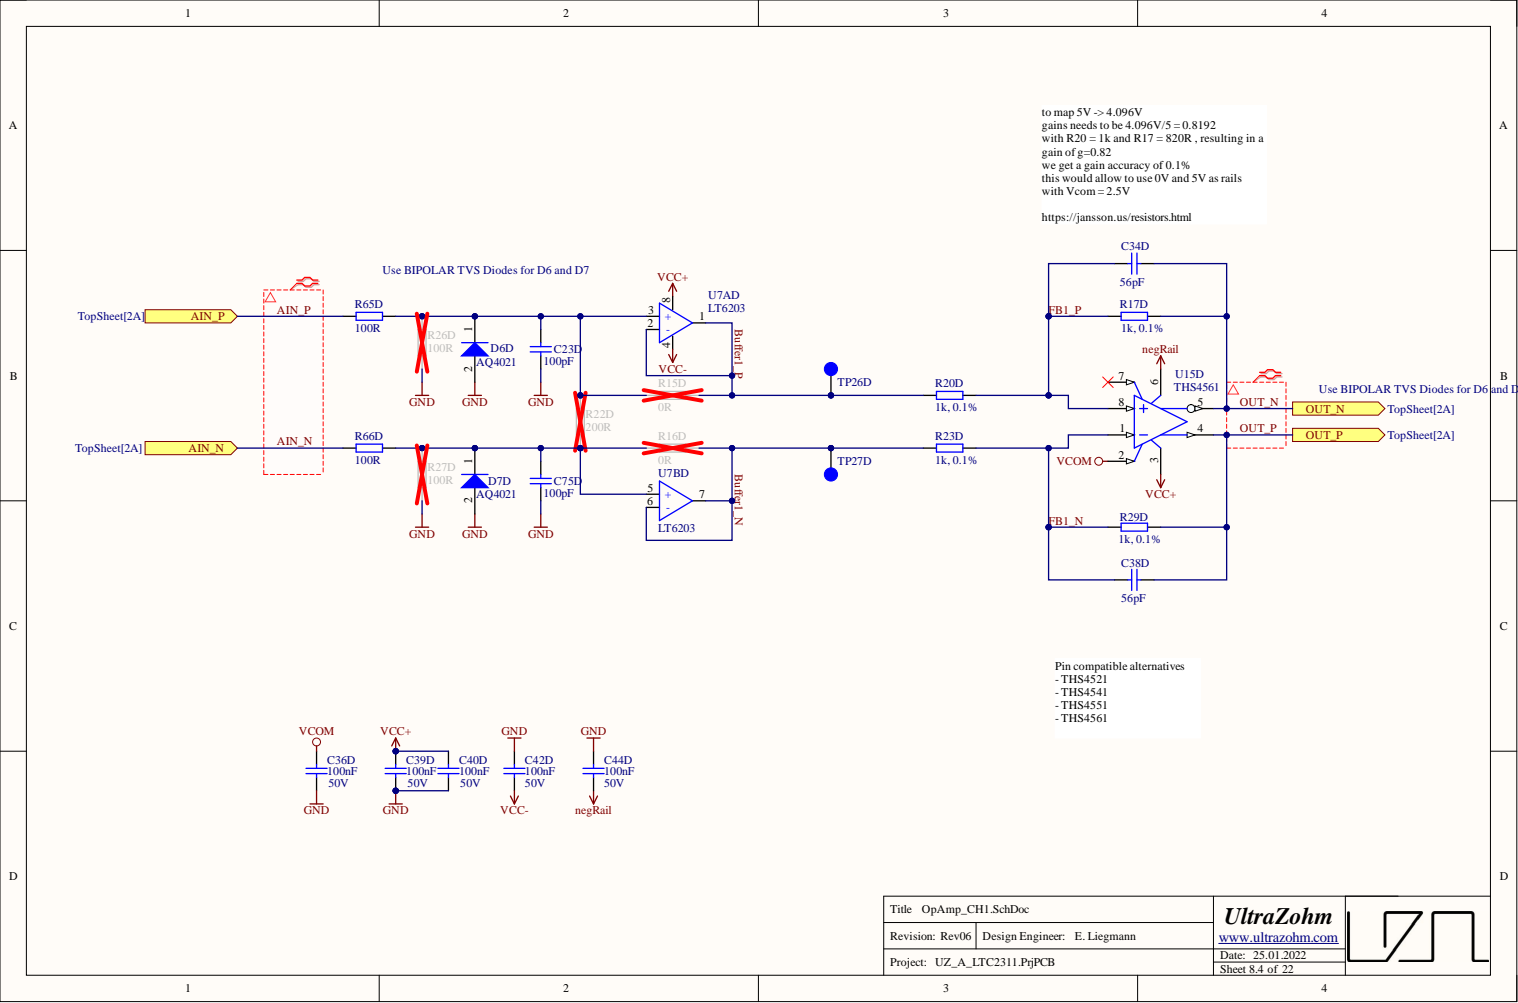
[picture p52: page 18]
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

https://jansson.us/resistors.html

Use BIPOLAR TVS Diodes for D6 and D7

VCC-
R15D

Use BIPOLAR TVS Diodes for D6 and D8

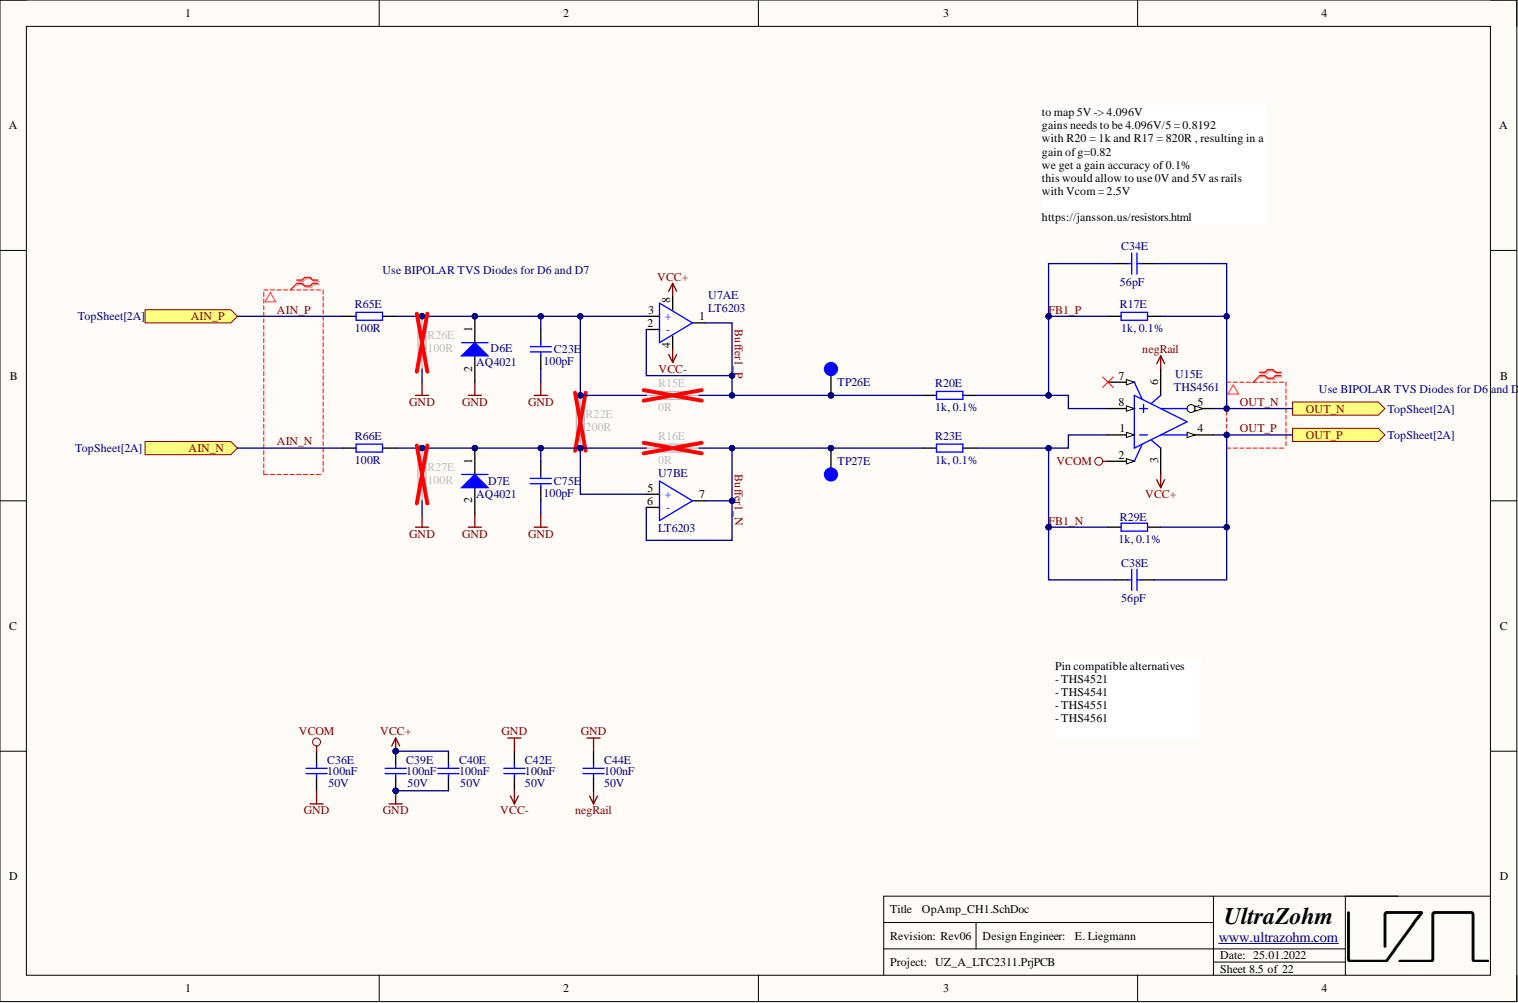
[picture p53: page 19]
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

https://jansson.us/resistors.html

Use BIPOLAR TVS Diodes for D6 and D7

VCC-
R15E

Use BIPOLAR TVS Diodes for D6 and D8

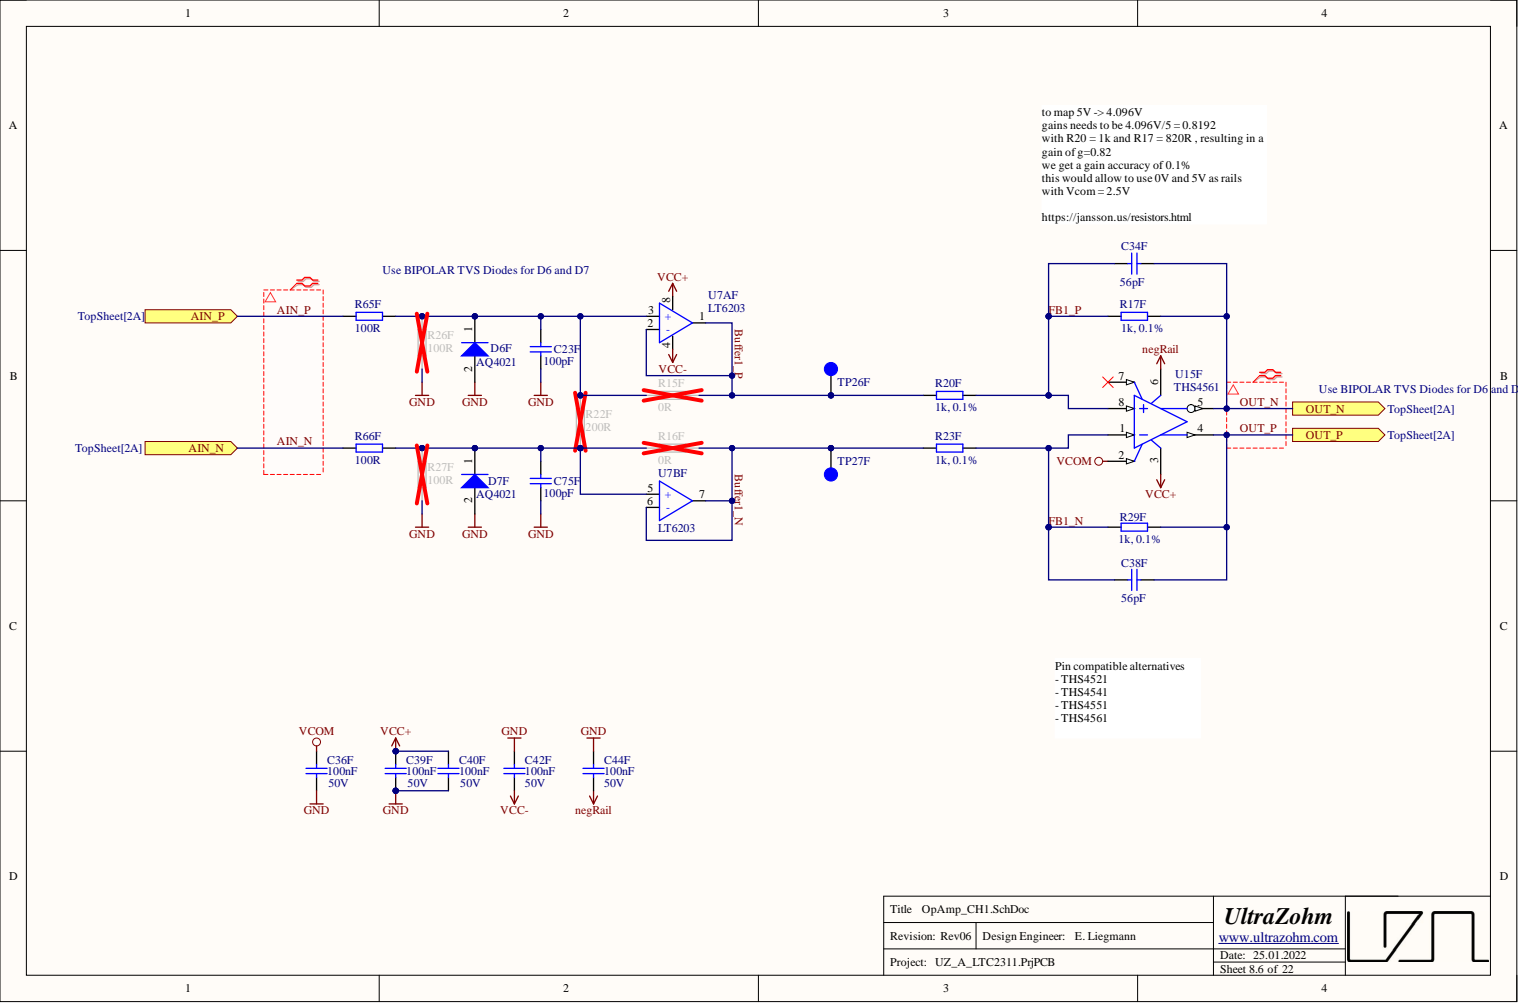
[picture p54: page 20]
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

https://jansson.us/resistors.html

Use BIPOLAR TVS Diodes for D6 and D7

VCC-
R15F

Use BIPOLAR TVS Diodes for D6 and D8

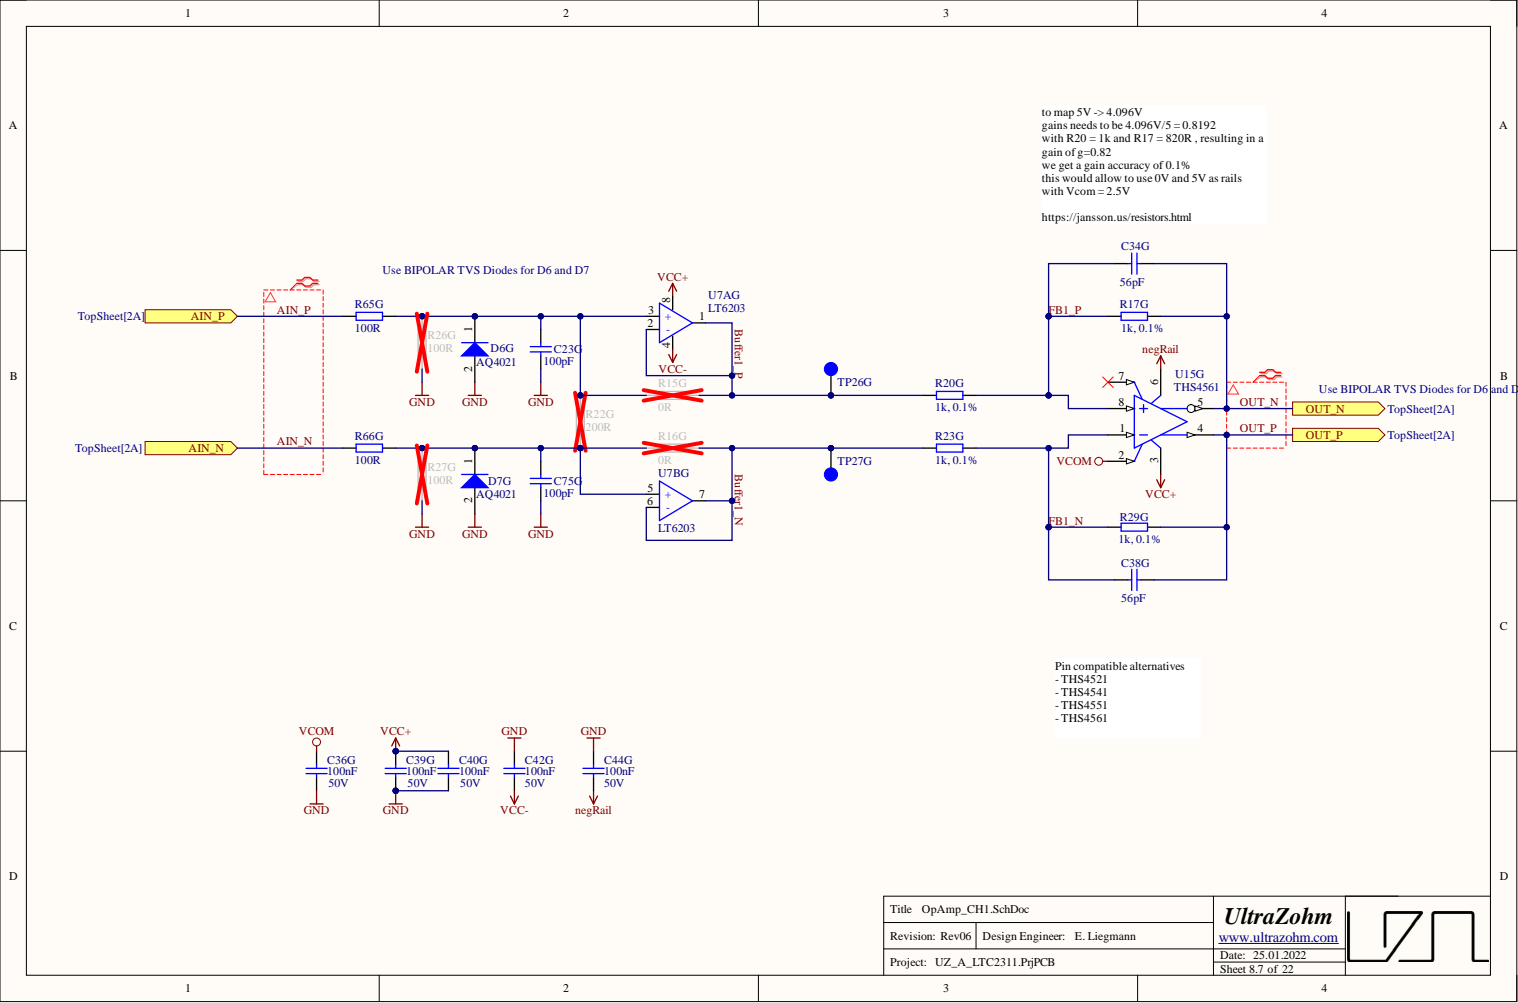
[picture p55: page 21]
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

https://jansson.us/resistors.html

Use BIPOLAR TVS Diodes for D6 and D7

VCC-
R15G

Use BIPOLAR TVS Diodes for D6 and D8

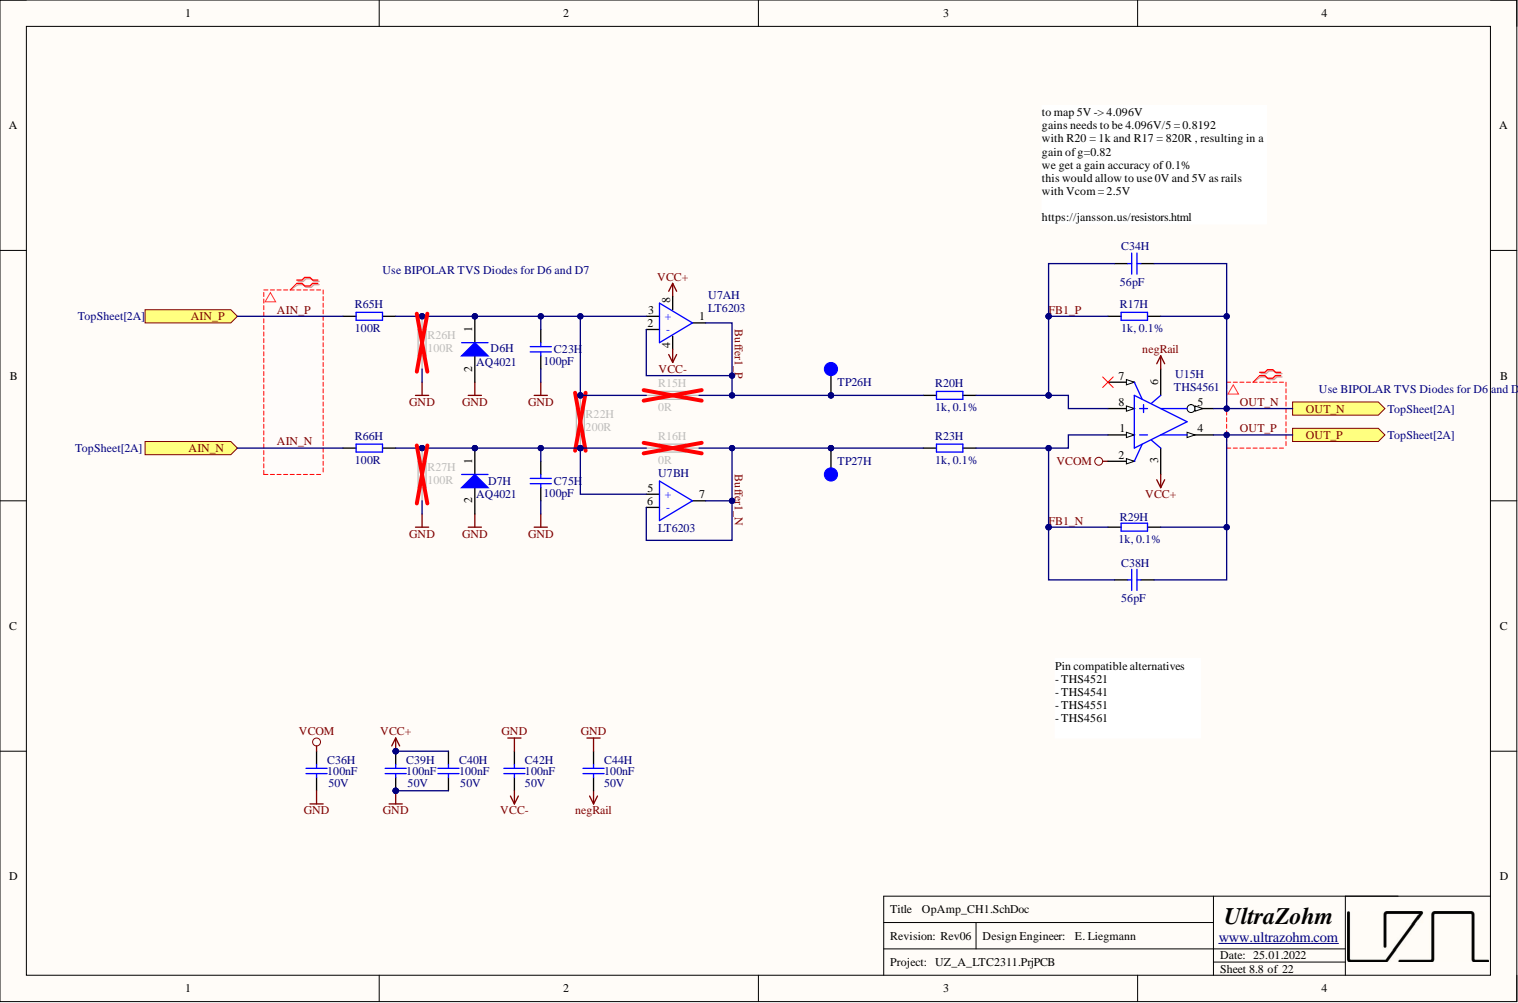
[picture p56: page 22]
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

https://jansson.us/resistors.html

Use BIPOLAR TVS Diodes for D6 and D7

VCC-
R15H

Use BIPOLAR TVS Diodes for D6 and D8
