ultrazohm/uz_a_ltc2311-16/Bestuecker_Files/Rev.05/SCH_UZ_A_LTC2311_Standard_Rev05.PDF

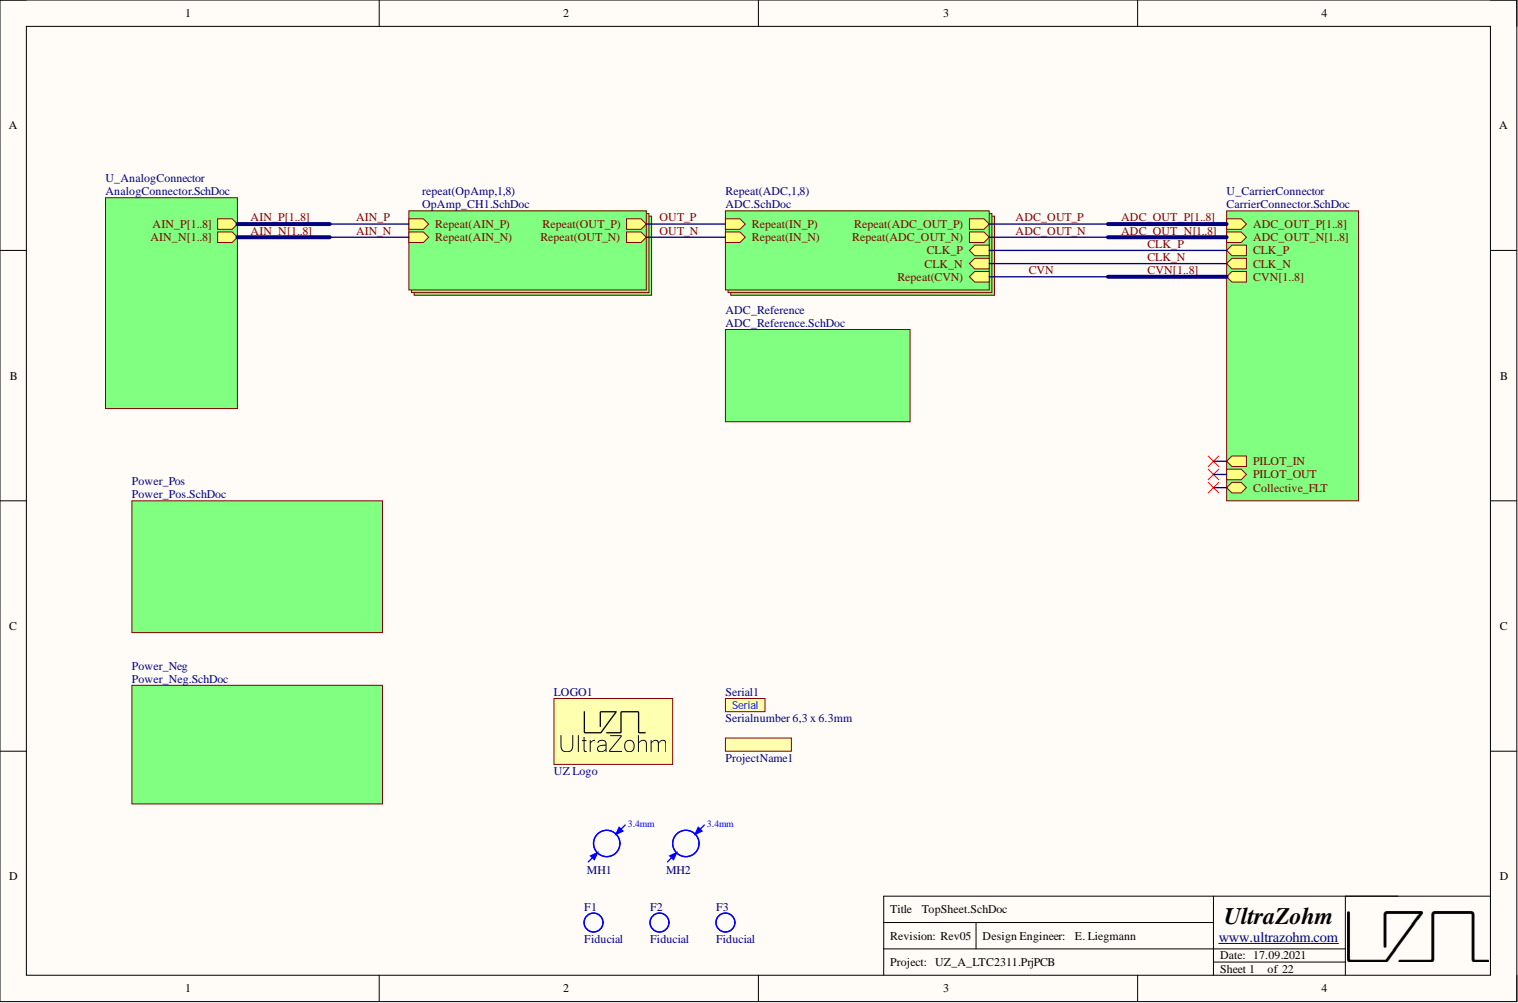
[picture p57: page 1]

Revision:

Date: 17.09.2021

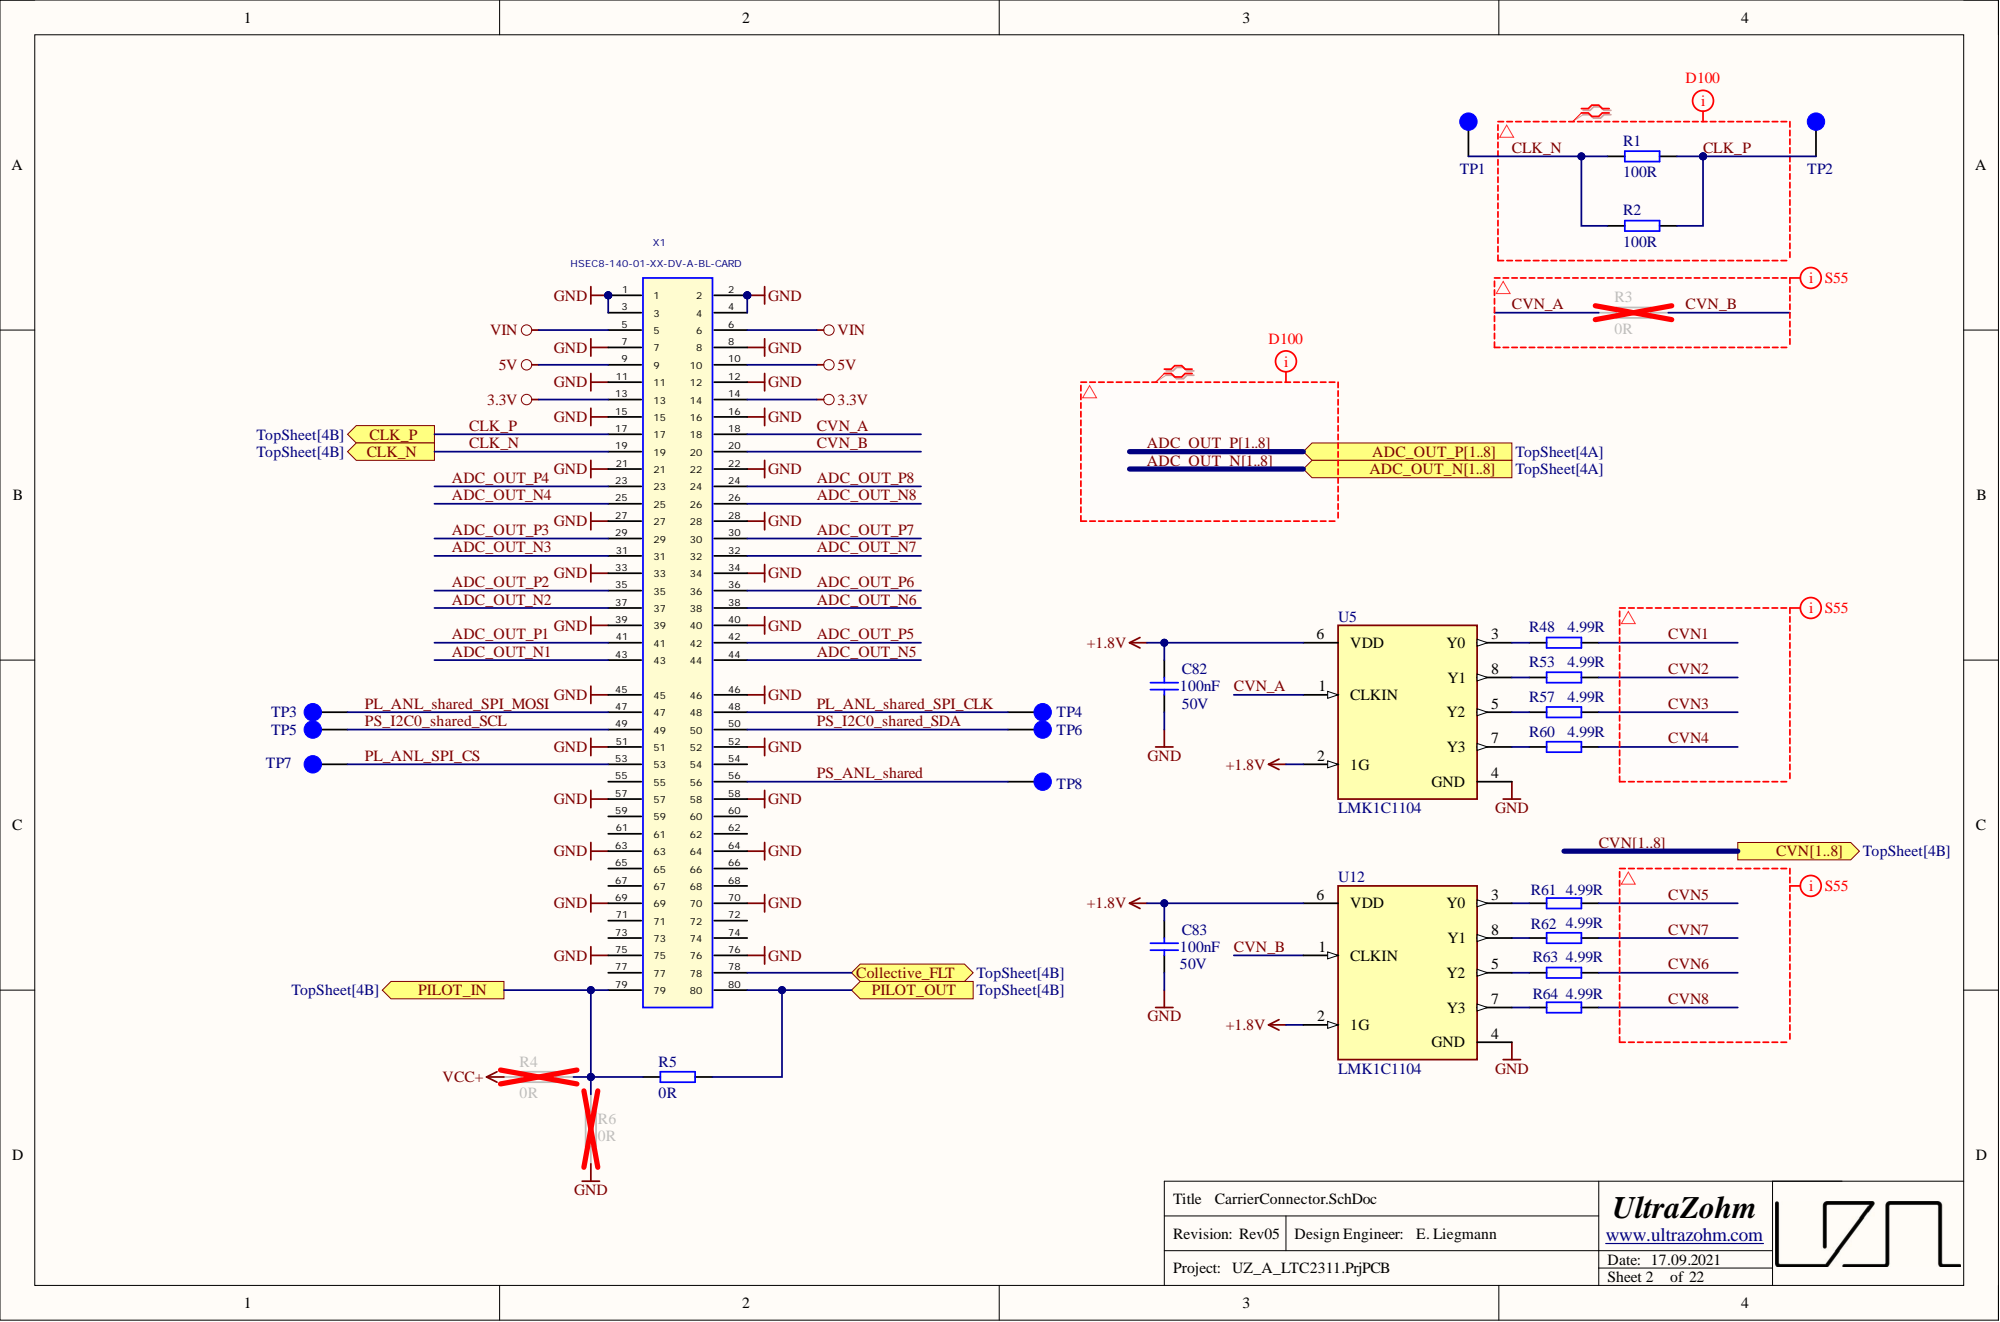
[picture p58: page 2]

HSEC8-140-01-XX-DV-A-BL-CARD

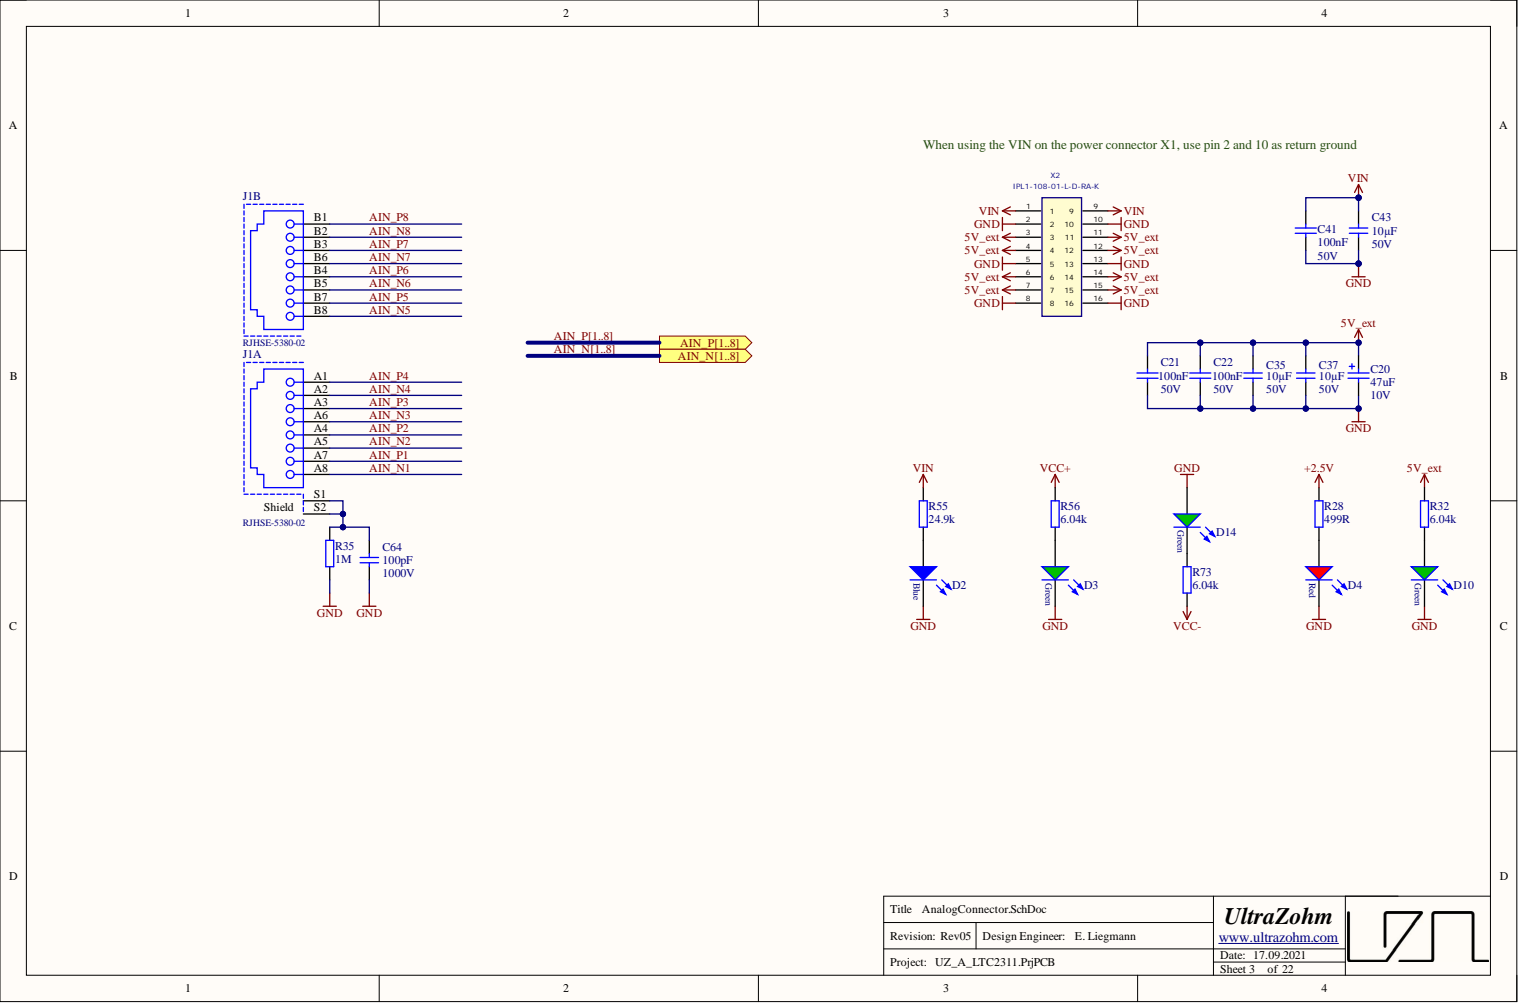
[picture p59: page 3]

Rev s n

Dat e :


max output current of

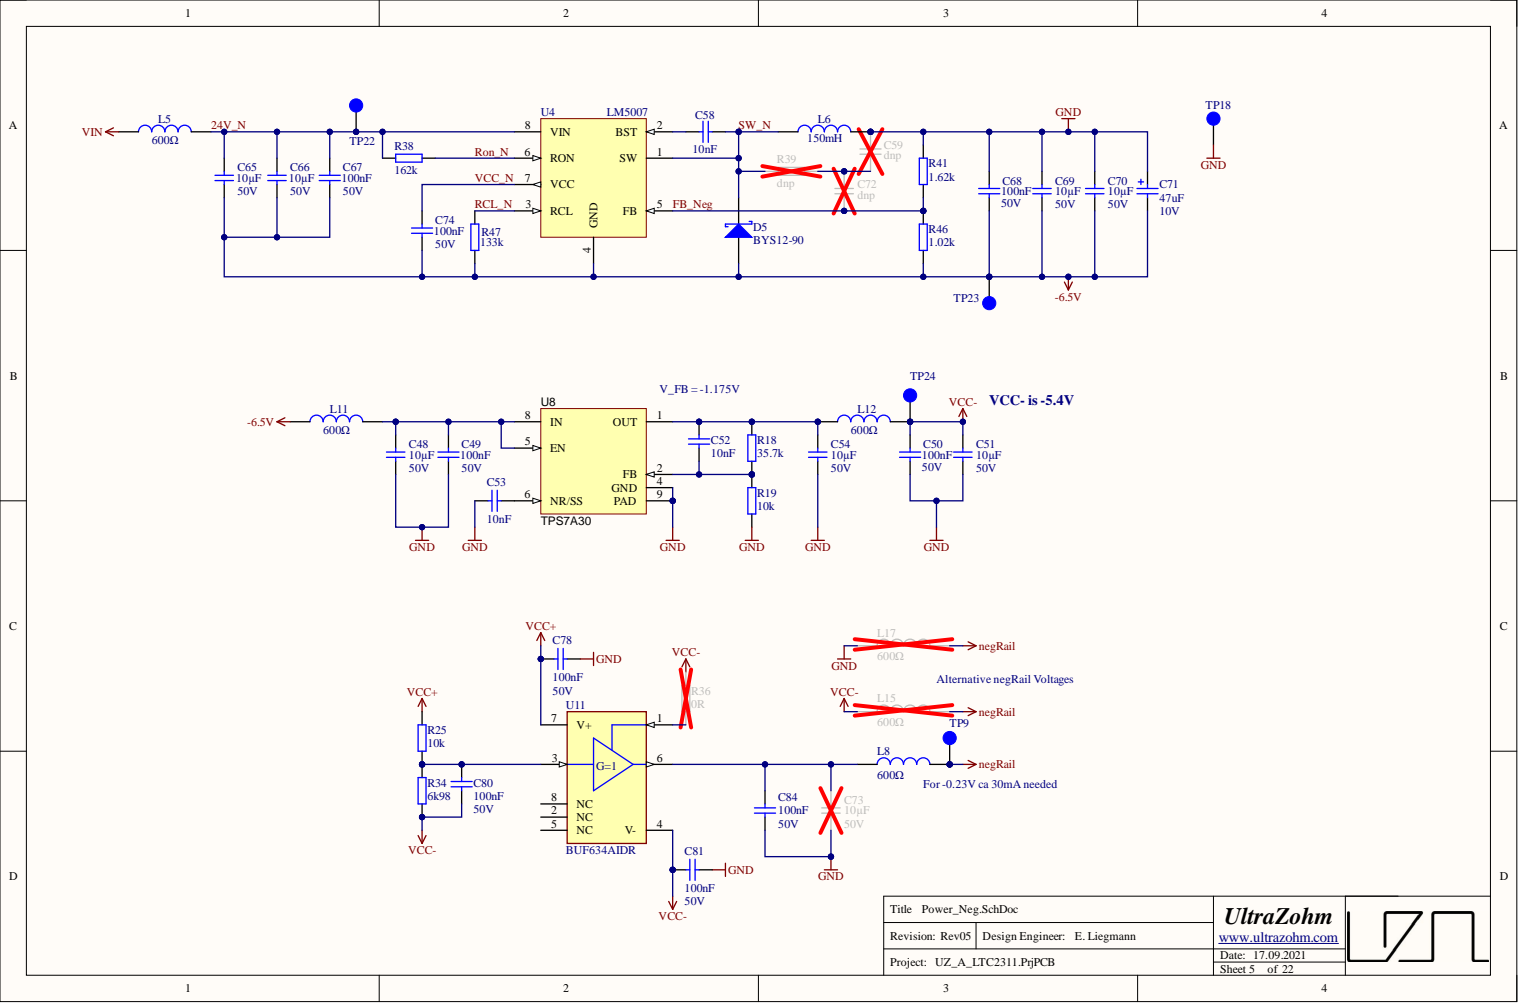
[picture p60: page 5]

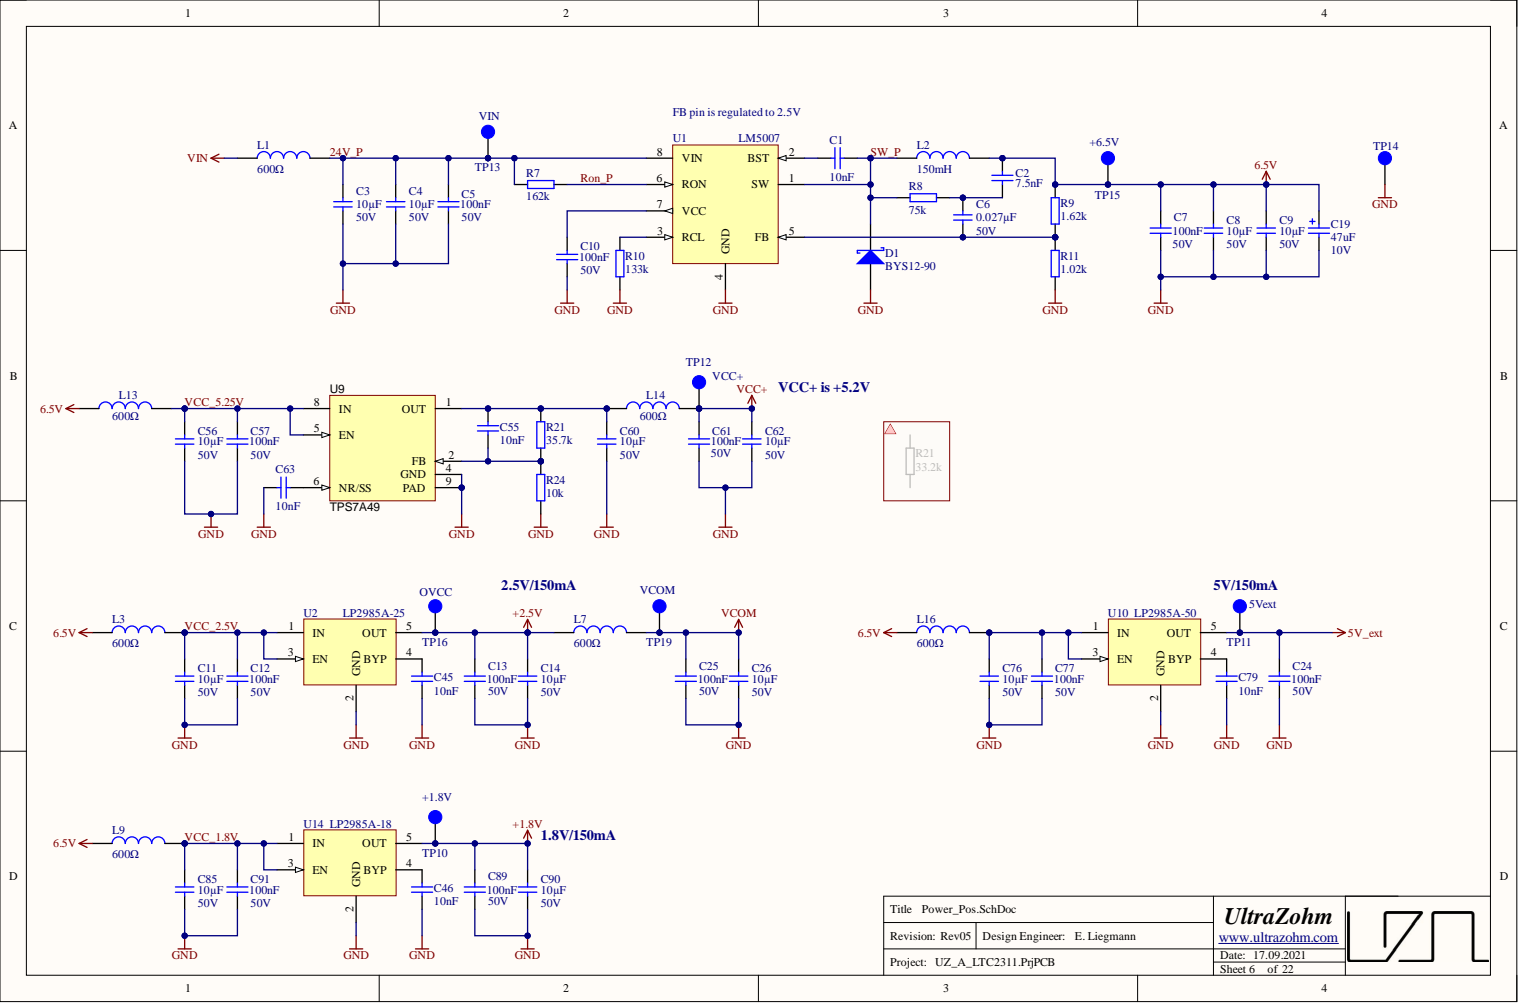
[picture p61: page 6]

FB pin is regulated to 2.5V

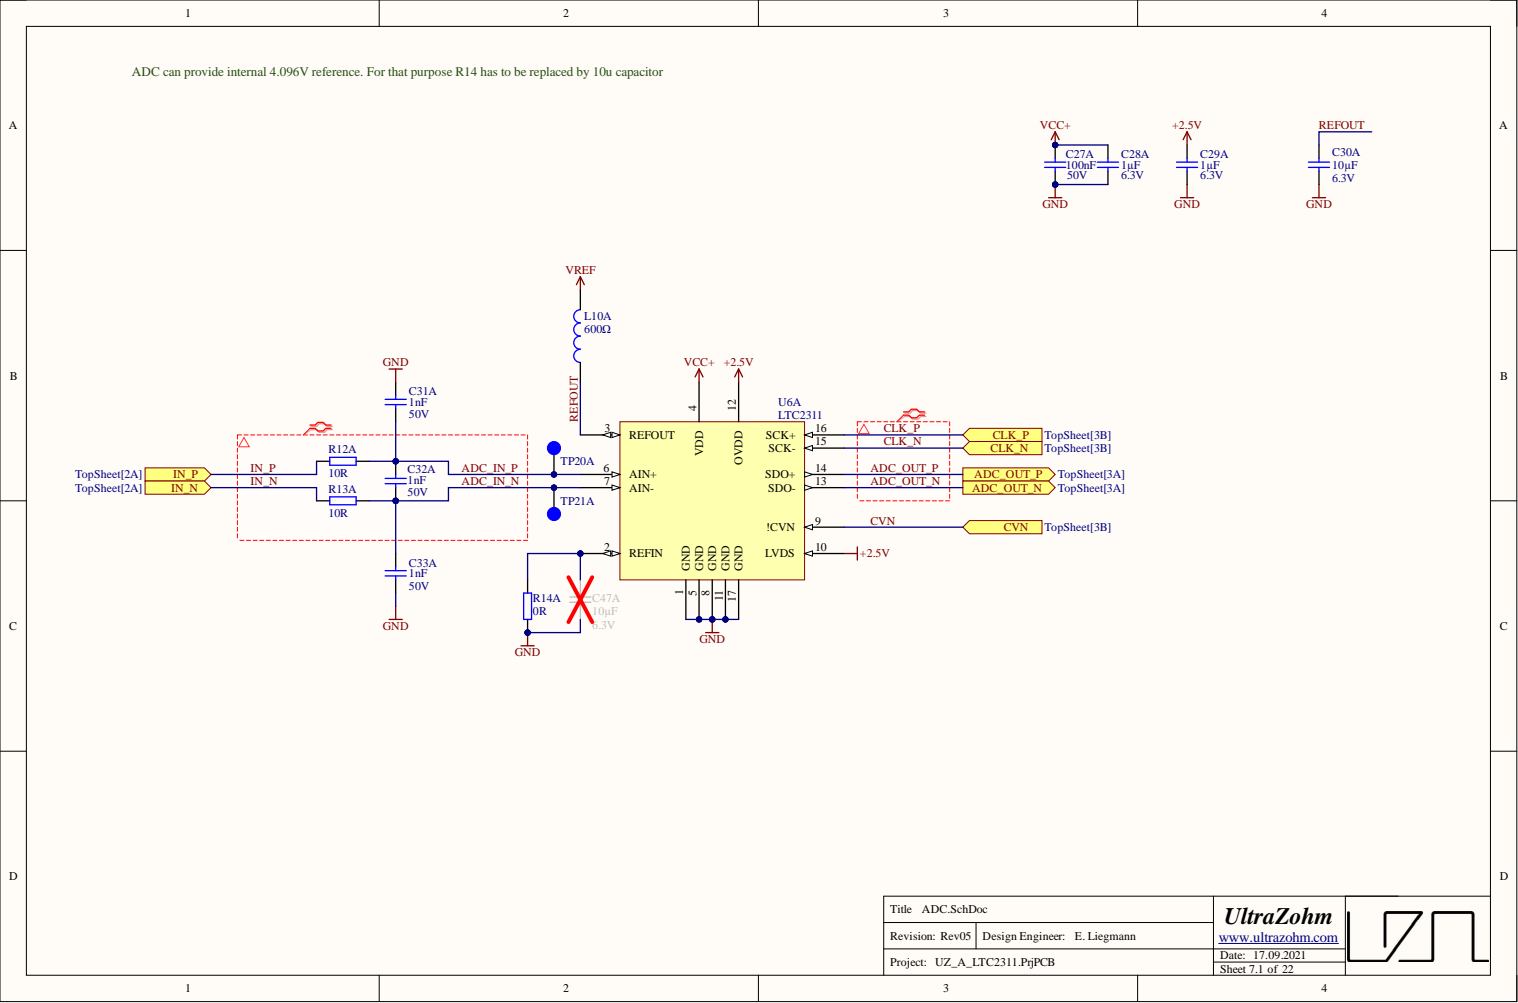
[picture p62: page 7]

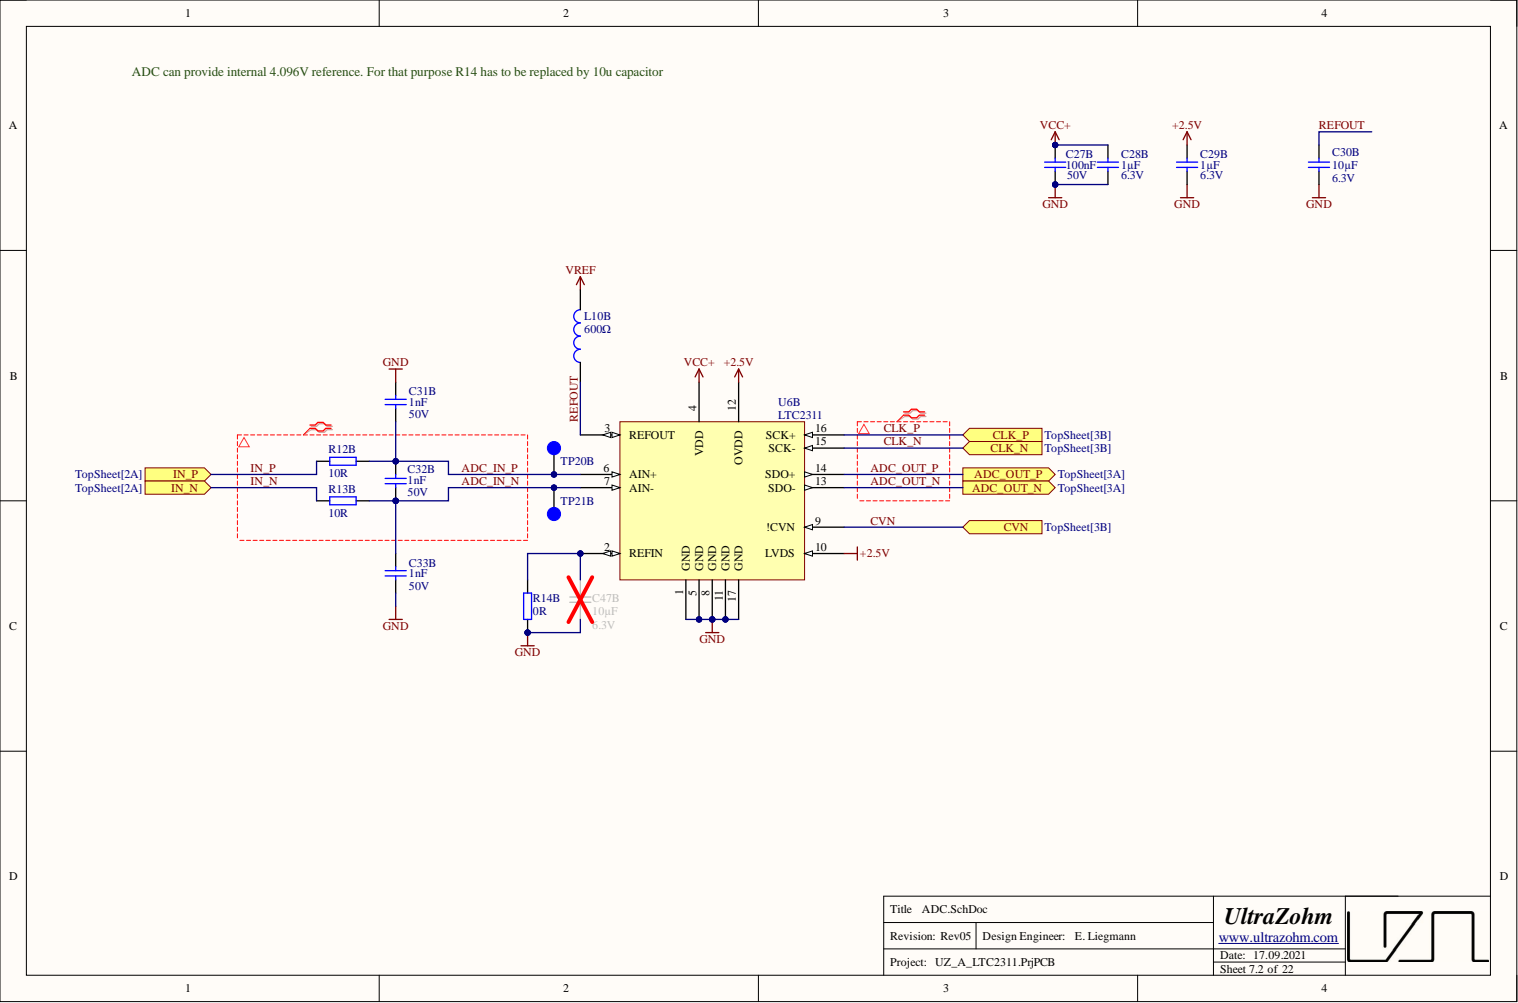
[picture p63: page 8]

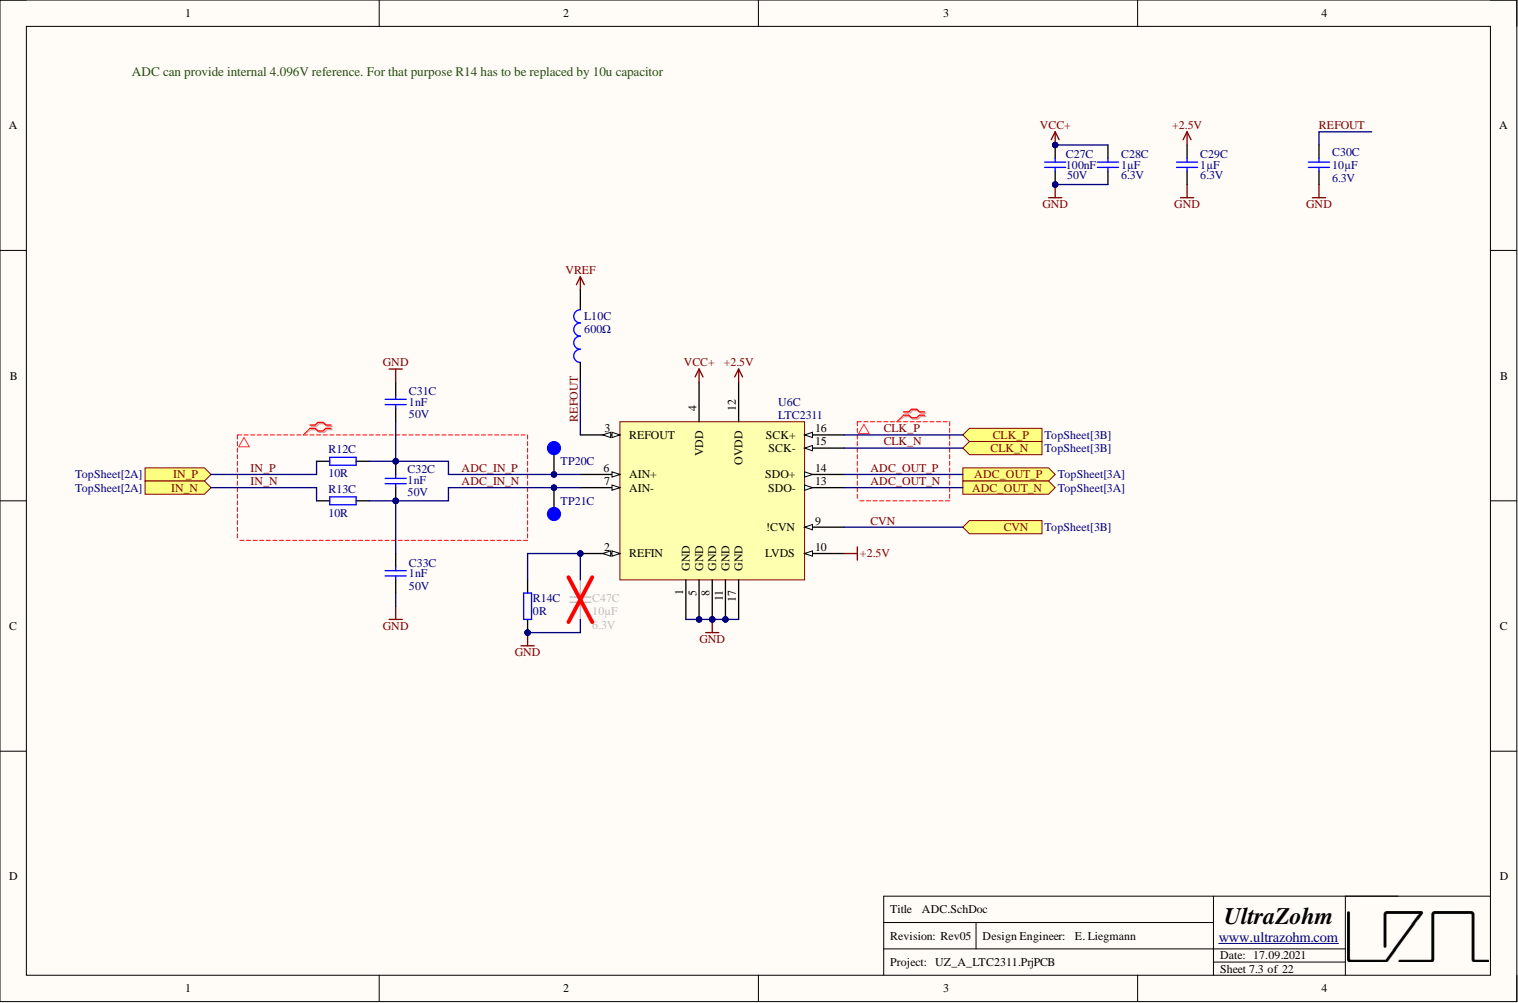
[picture p64: page 9]

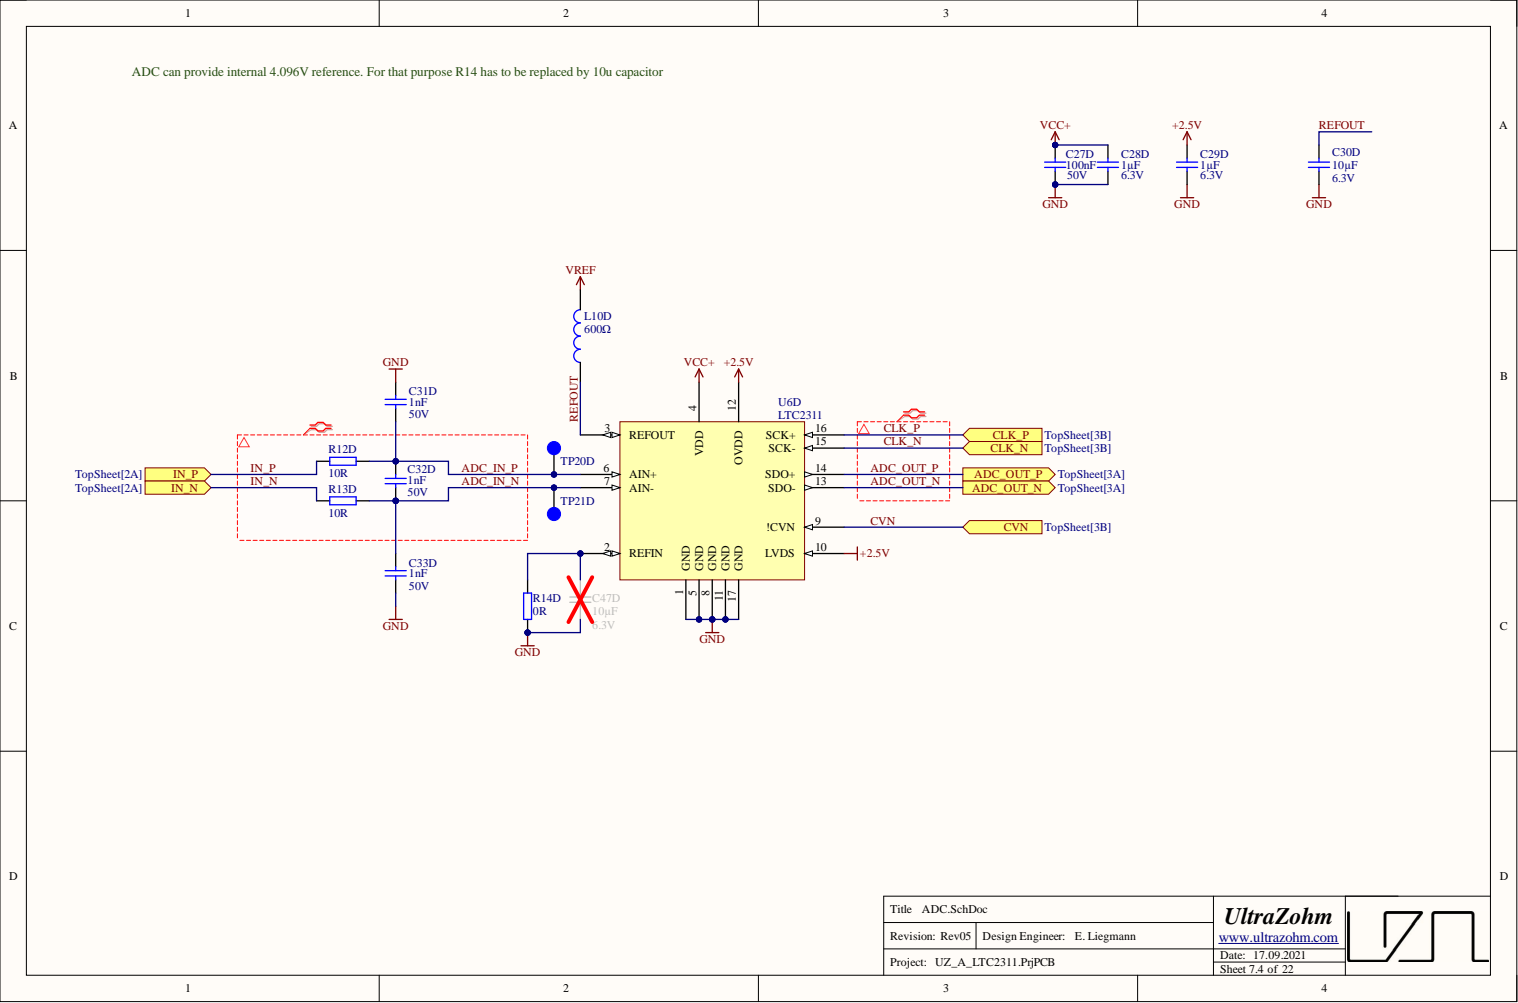
[picture p65: page 10]

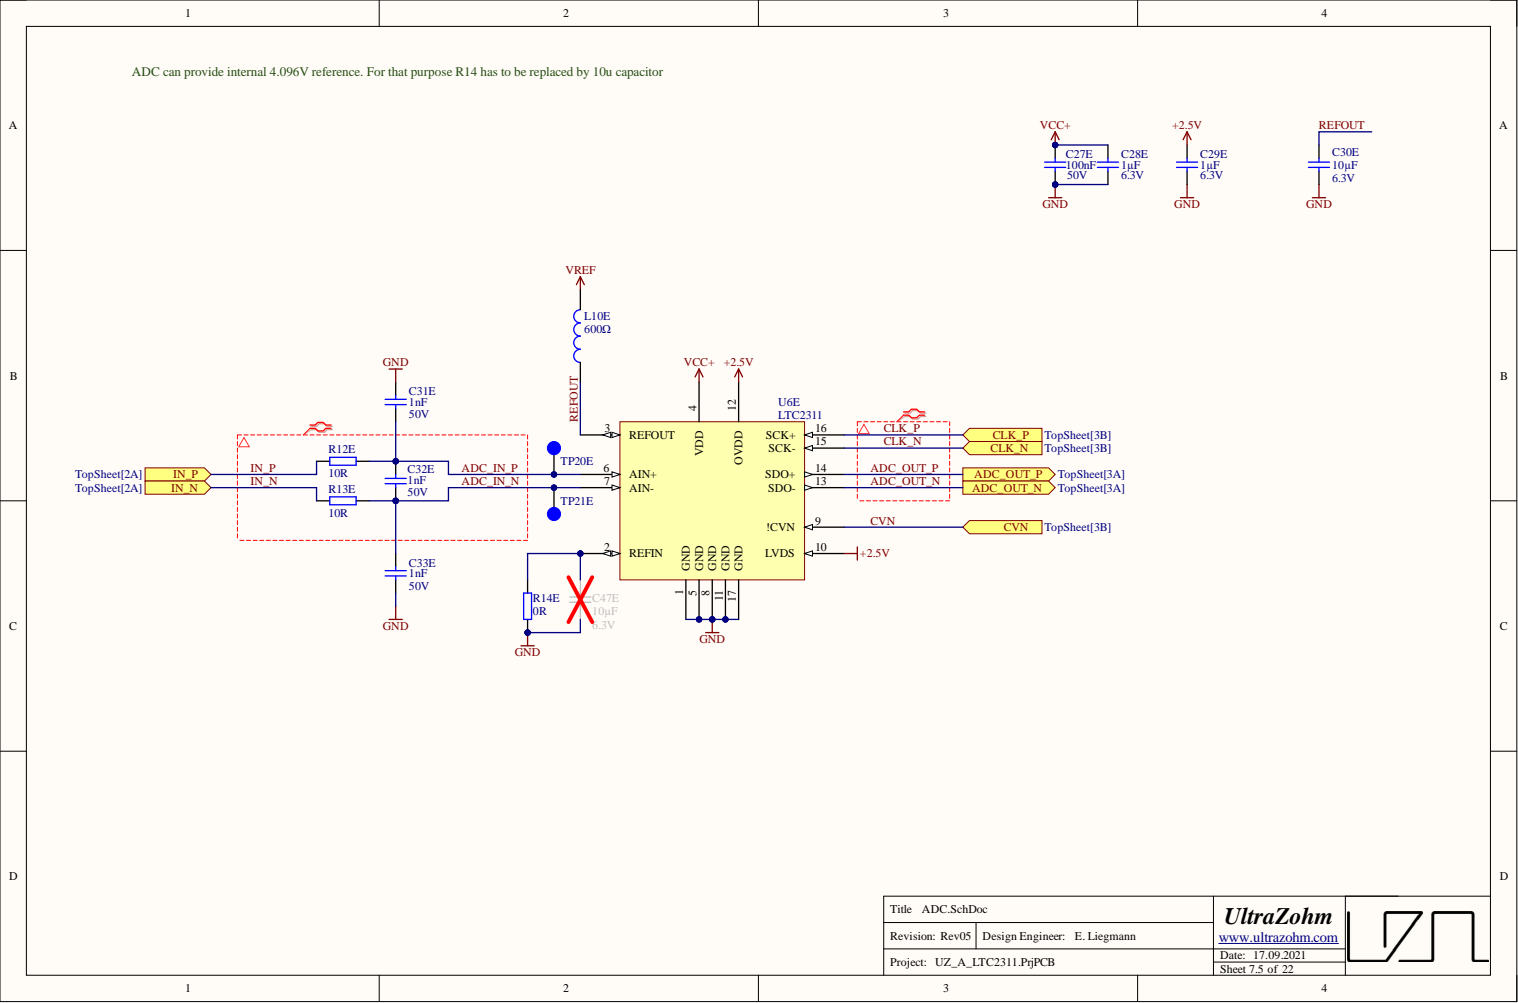
[picture p66: page 11]

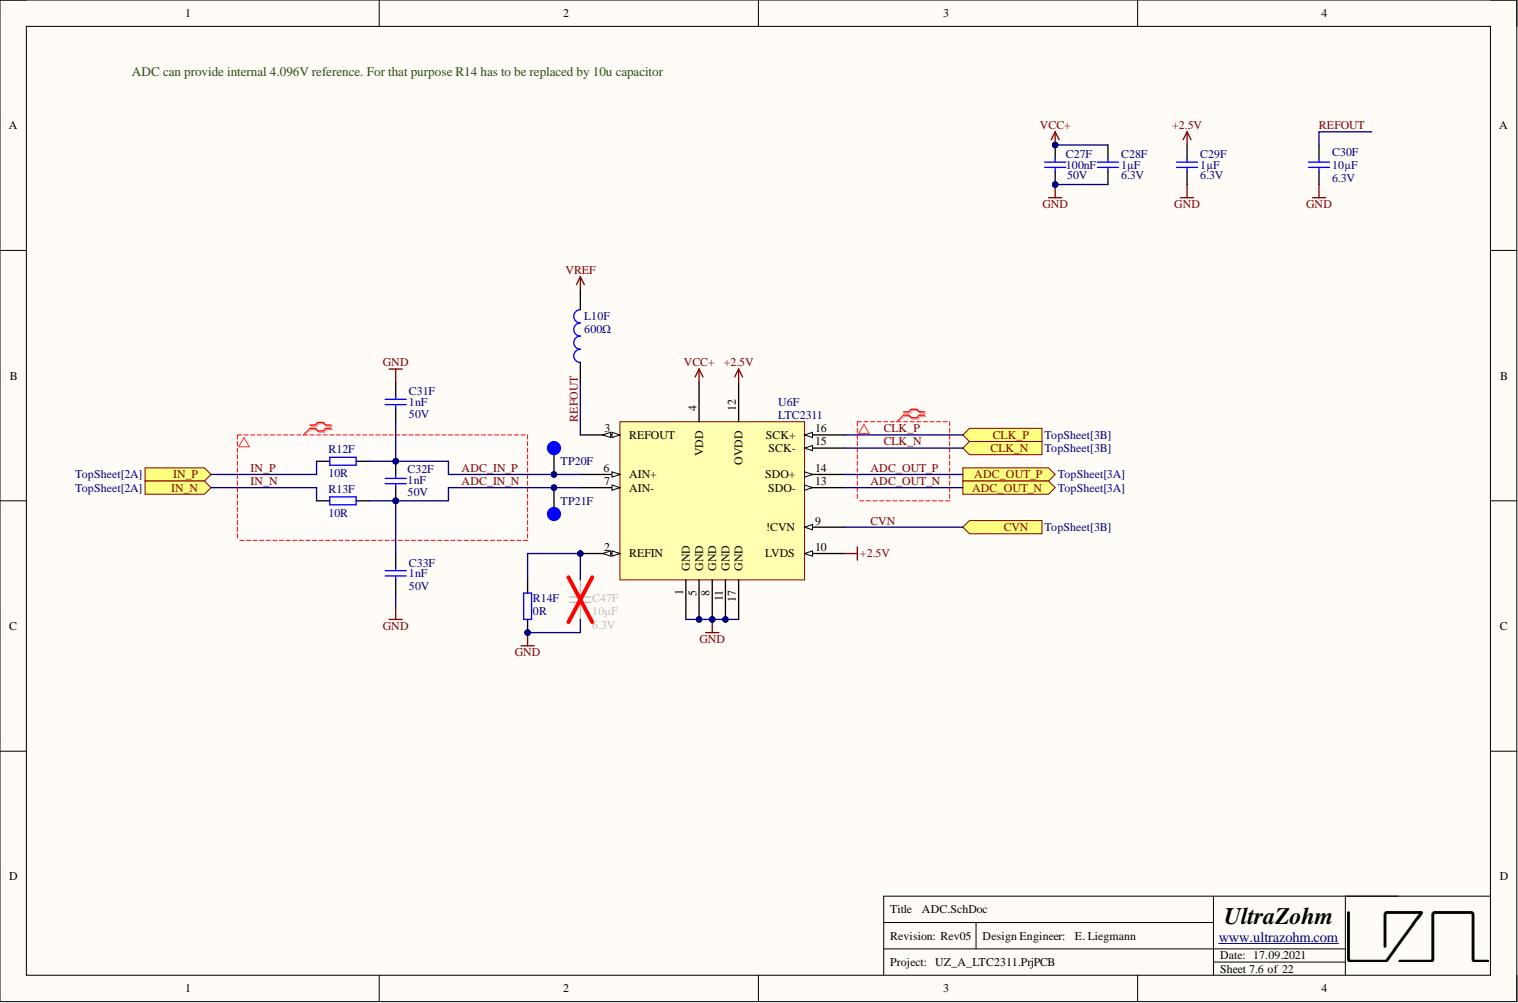
[picture p67: page 12]

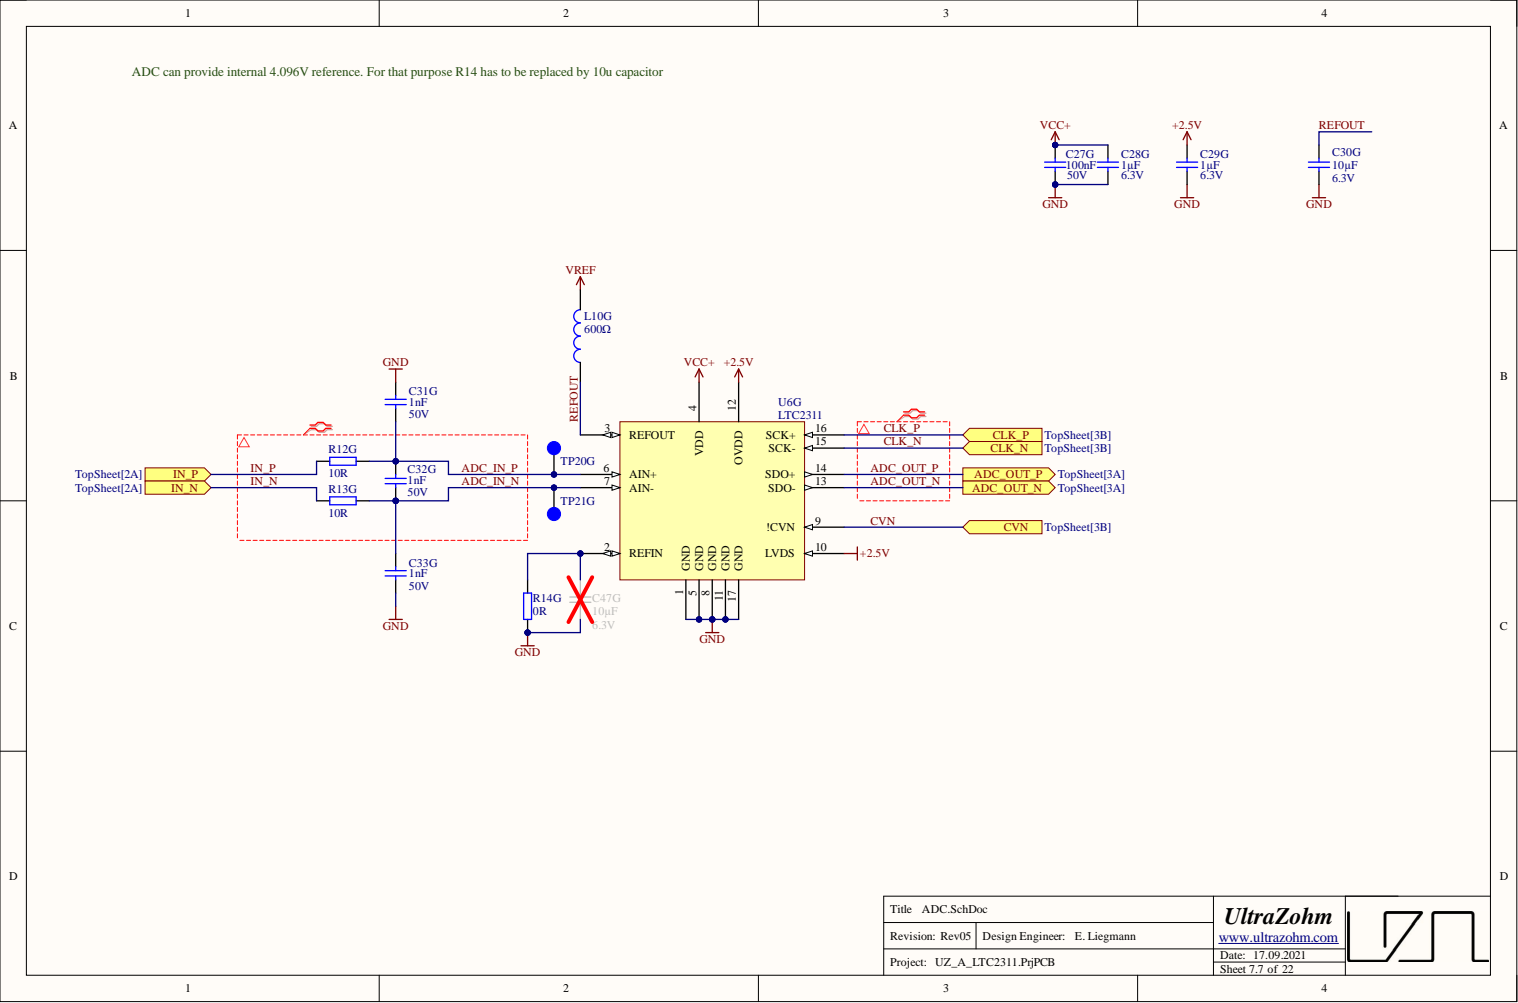
[picture p68: page 13]

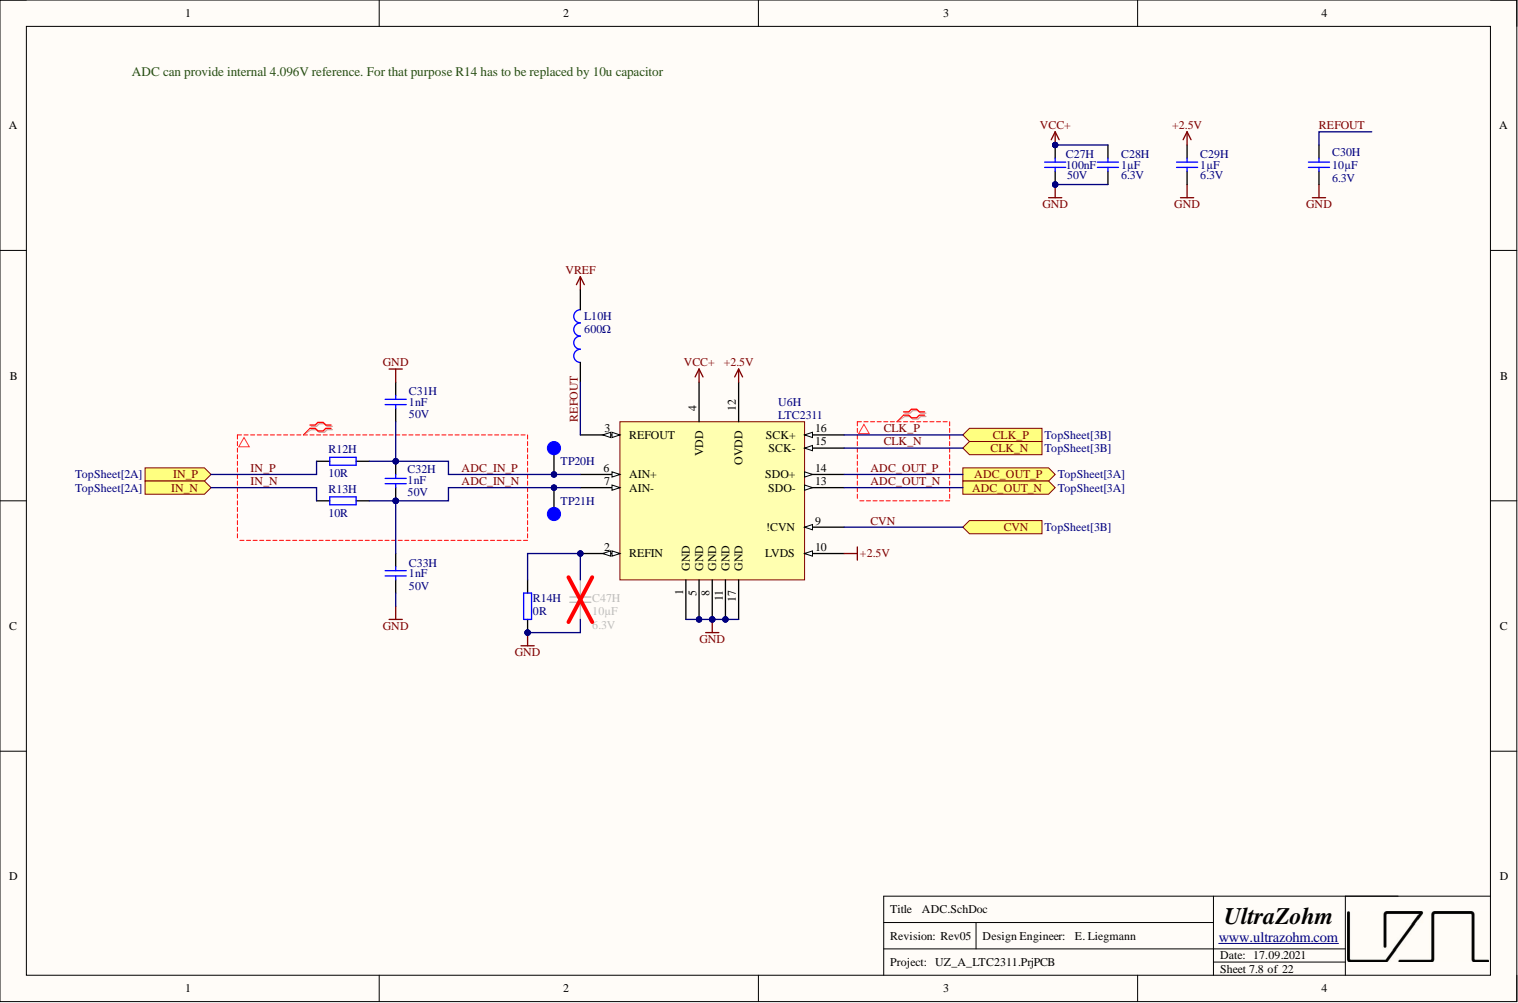
[picture p69: page 14]

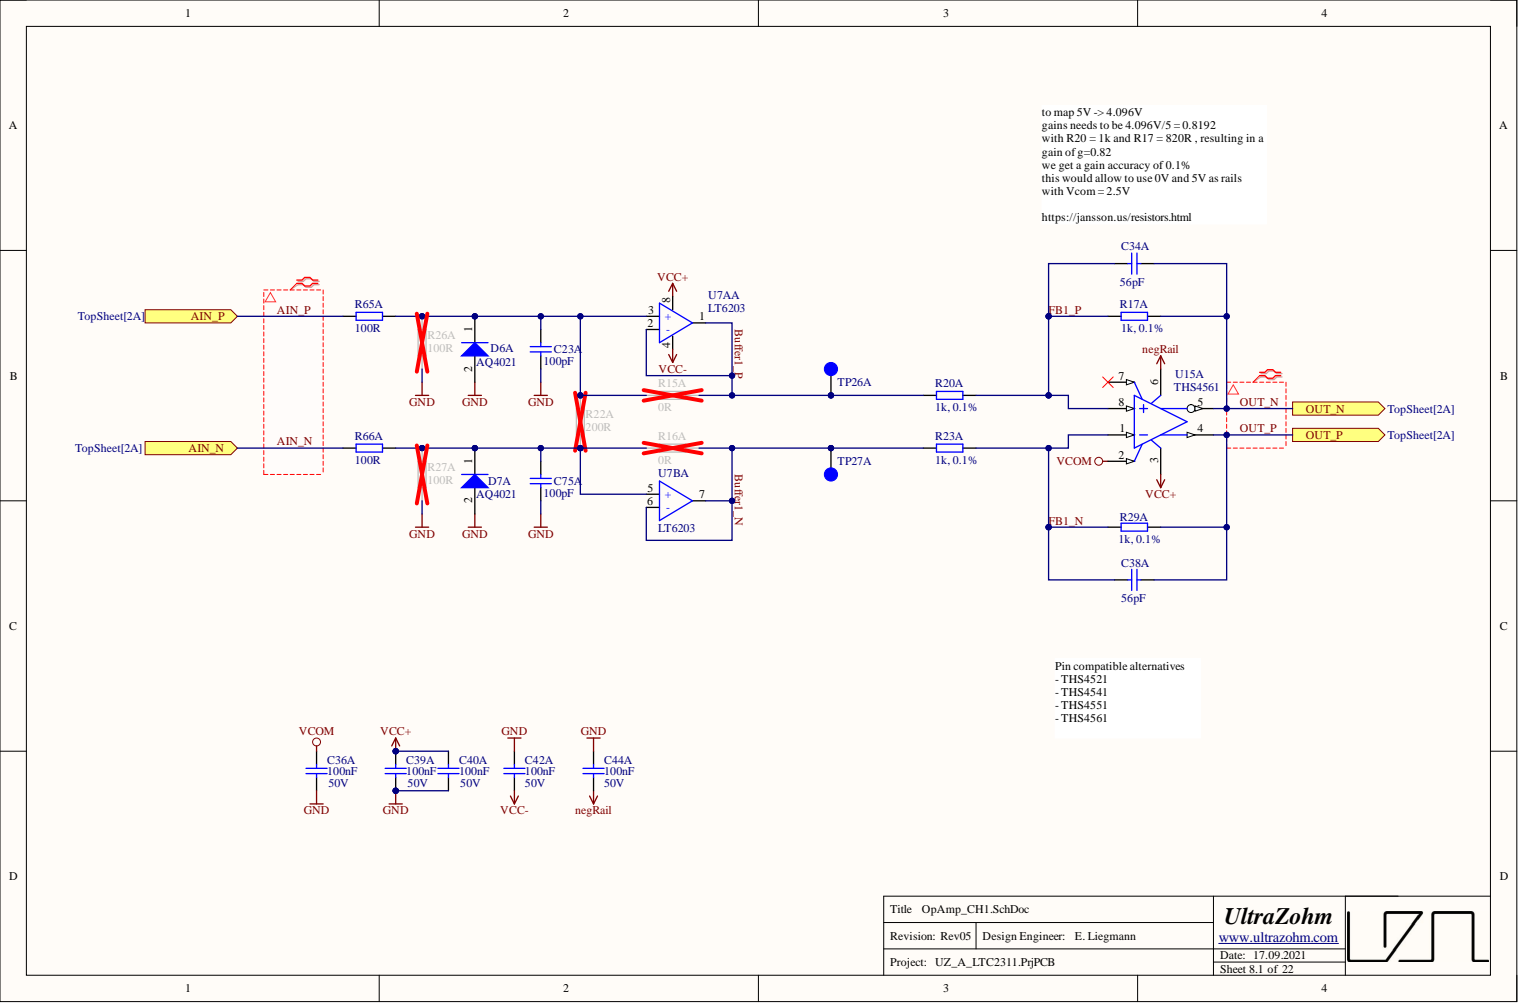
[picture p70: page 15]

to map 5V -> 4.096V
gains needs to be 4.096V/5 = 0.8192
with R20 = 1k and R17 = 820R , resulting in a
gain of g=0.82
we get a gain accuracy of 0.1%
this would allow to use 0V and 5V as rails
with Vcom = 2.5V

https://jansson.us/resistors.html

VCC-
R15A

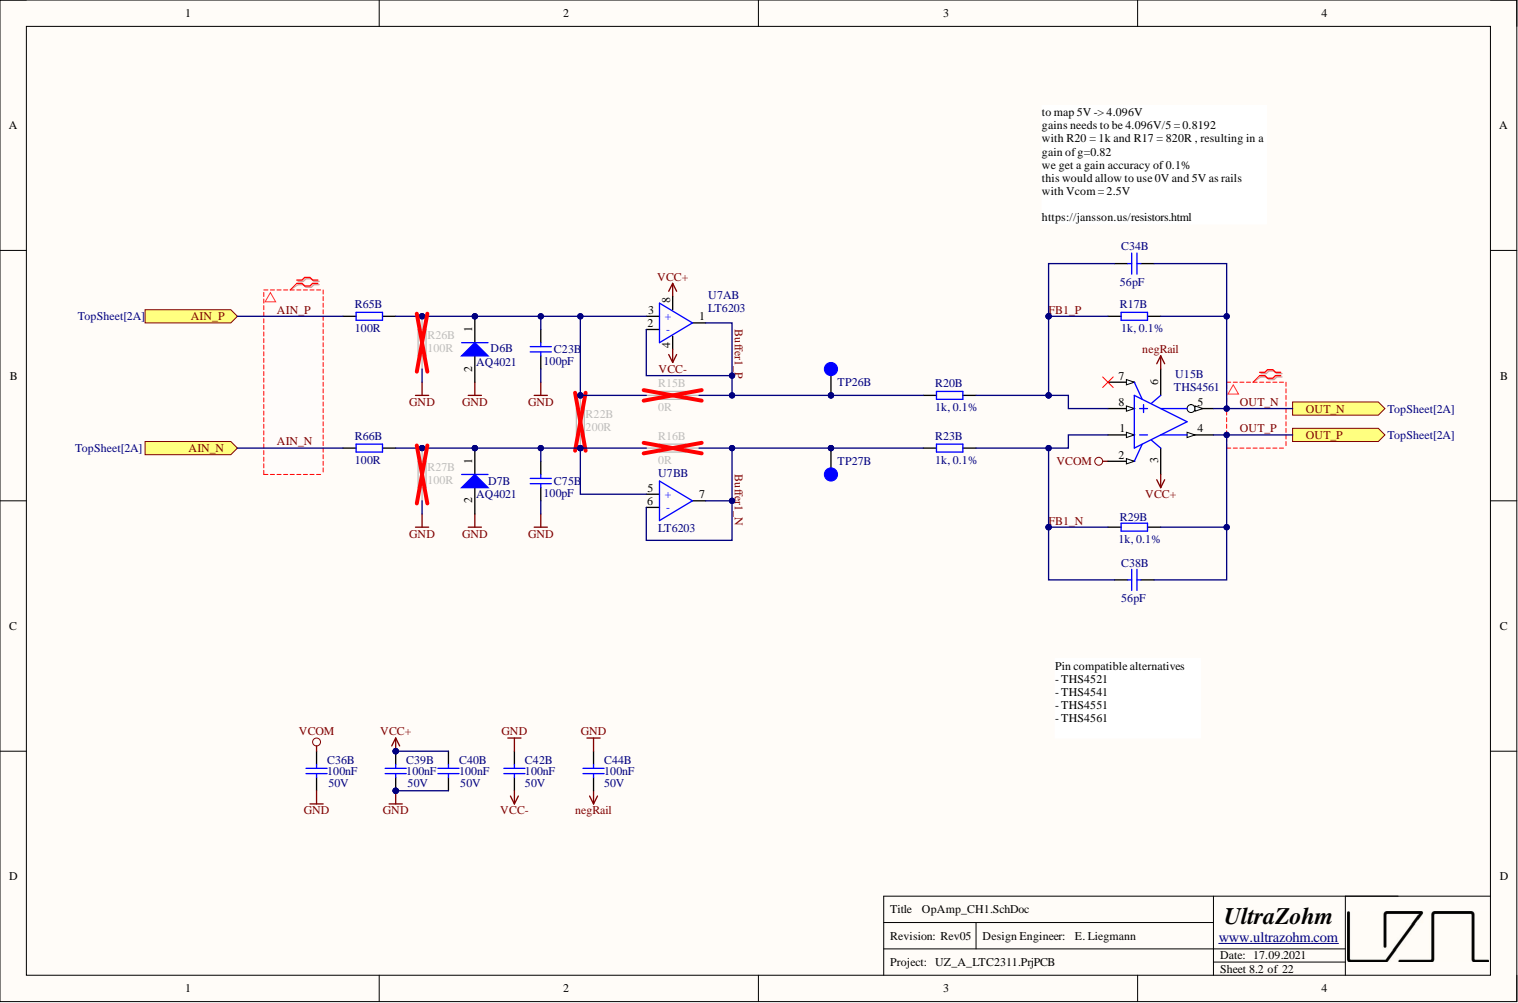
[picture p71: page 16]
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

https://jansson.us/resistors.html

VCC-
R15B

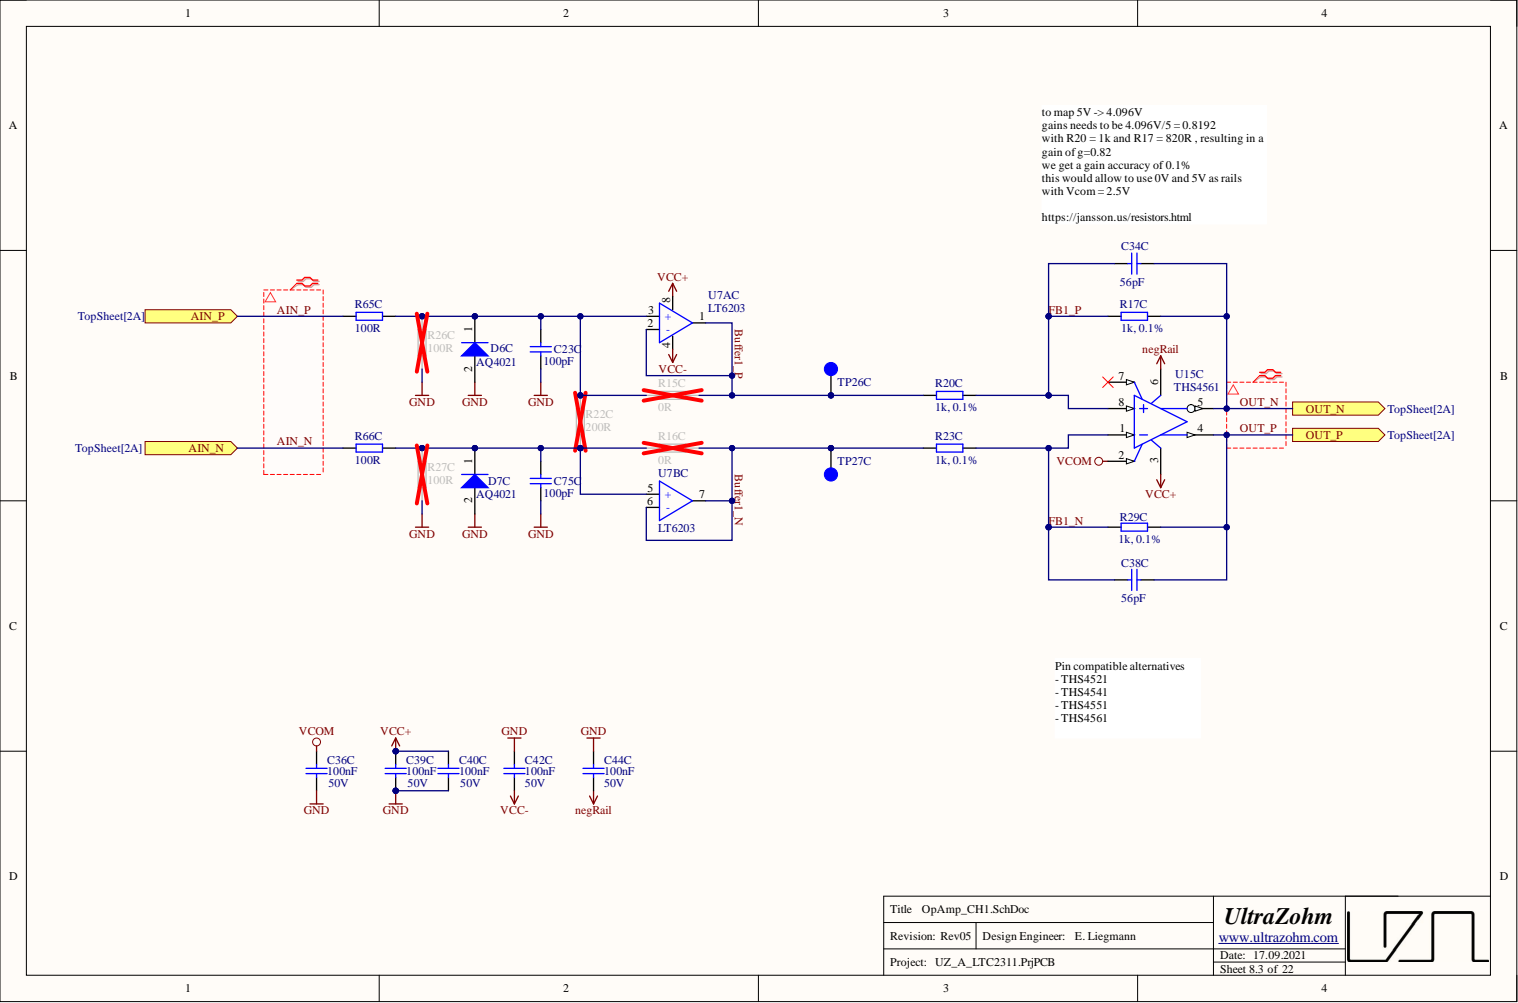
[picture p72: page 17]
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

https://jansson.us/resistors.html

VCC-
R15C

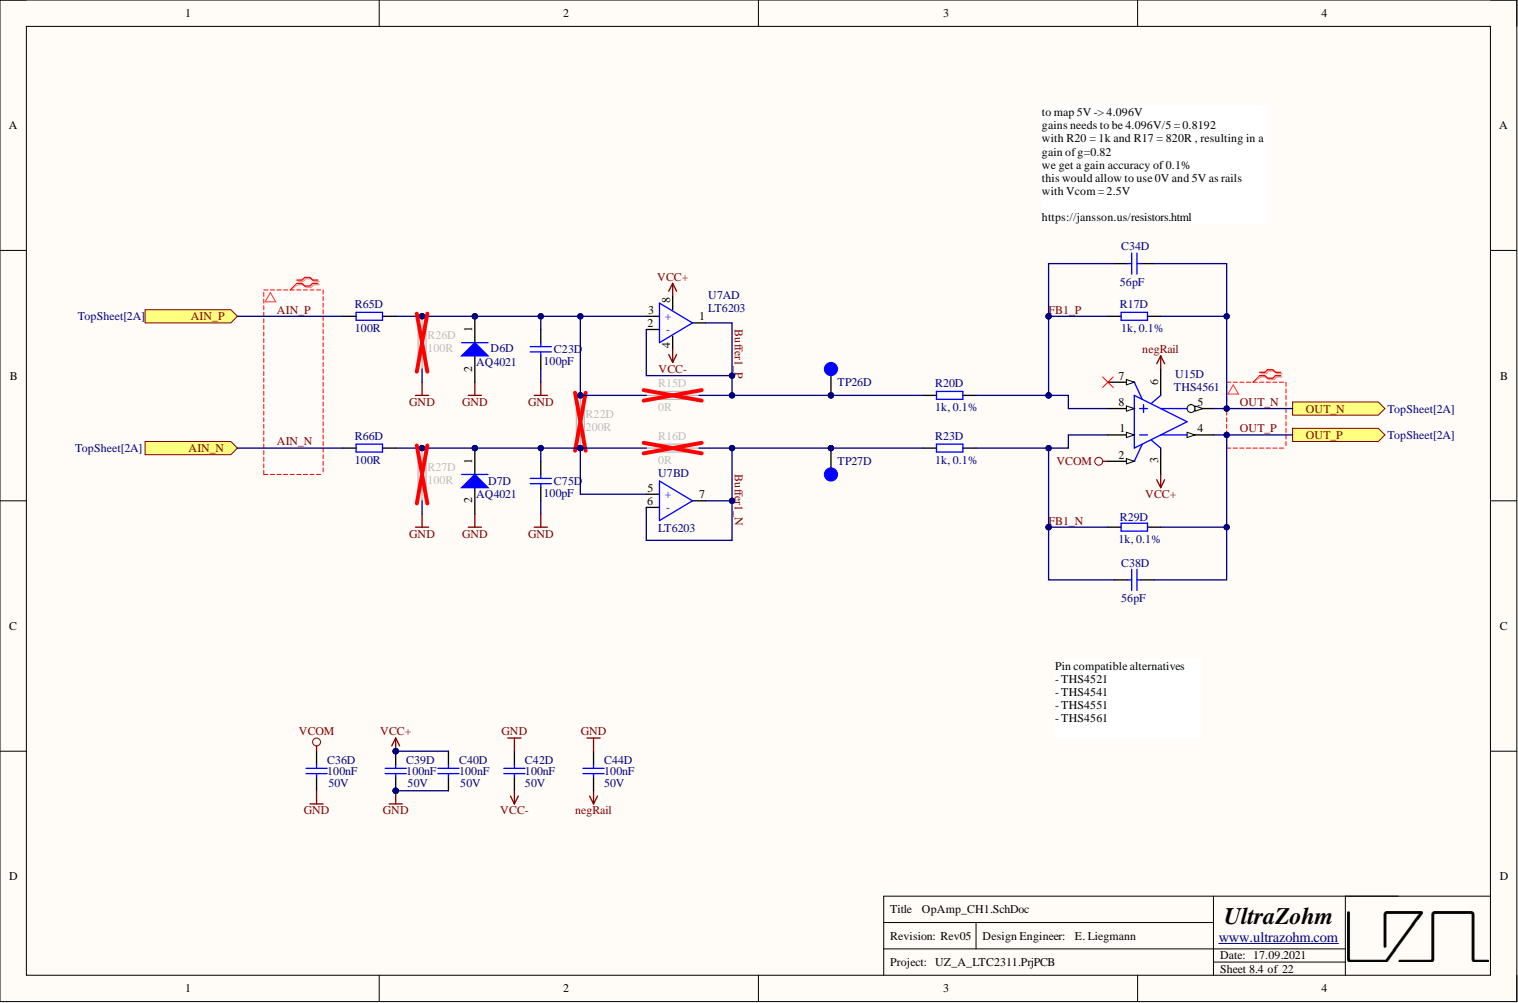
[picture p73: page 18]
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

https://jansson.us/resistors.html

VCC-
R15D

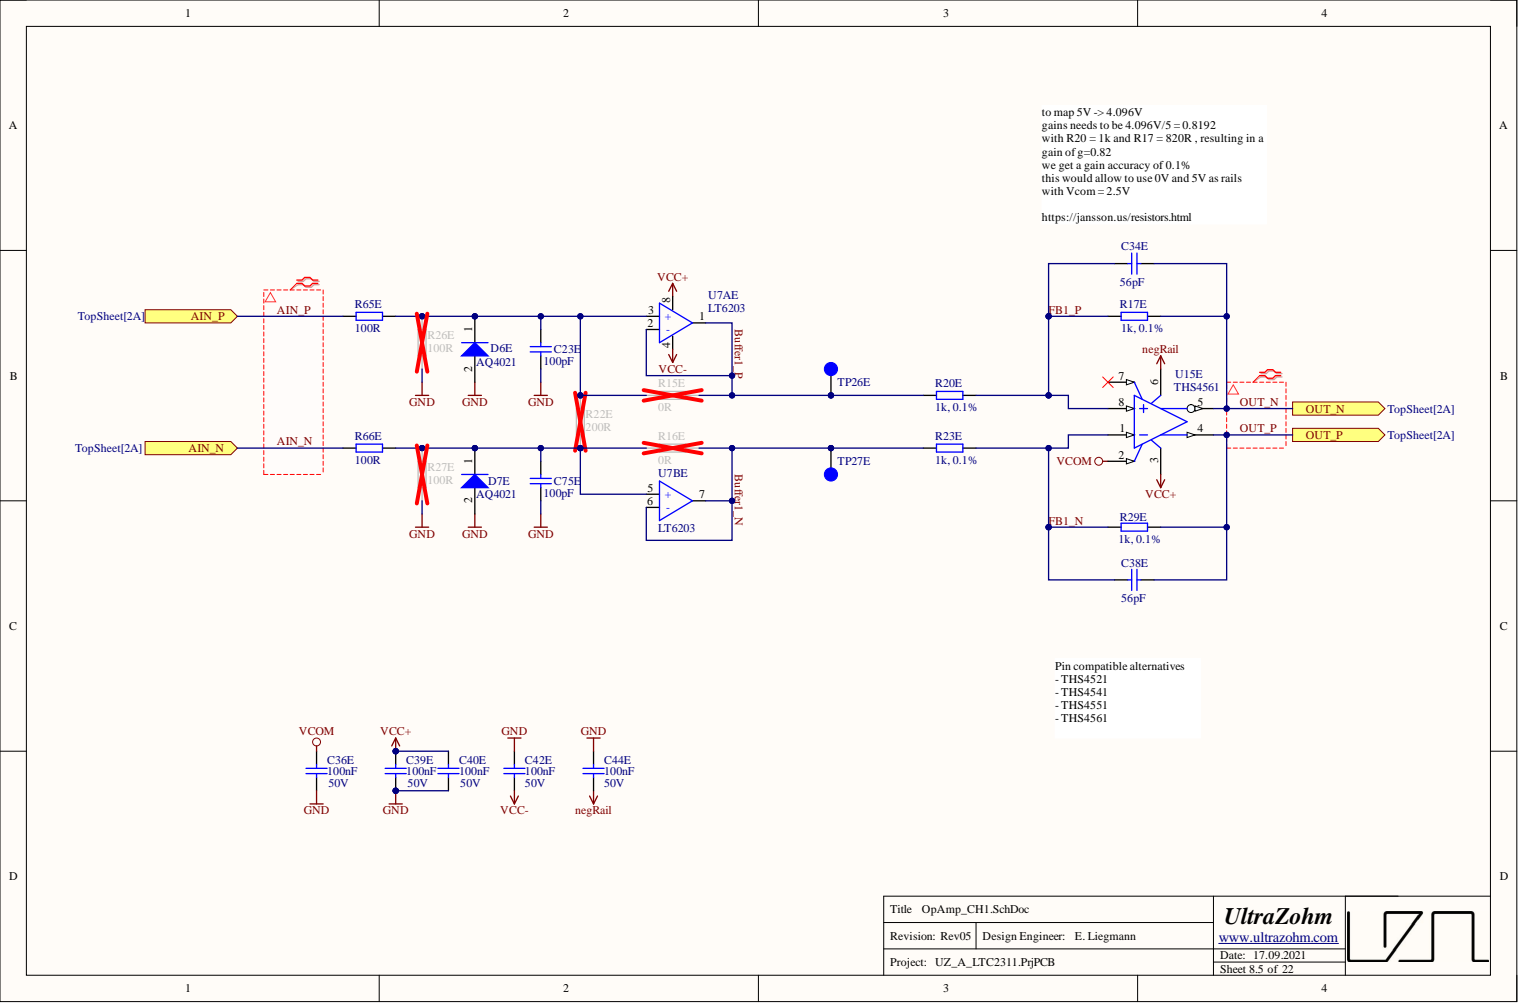
[picture p74: page 19]
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

https://jansson.us/resistors.html

VCC-
R15E

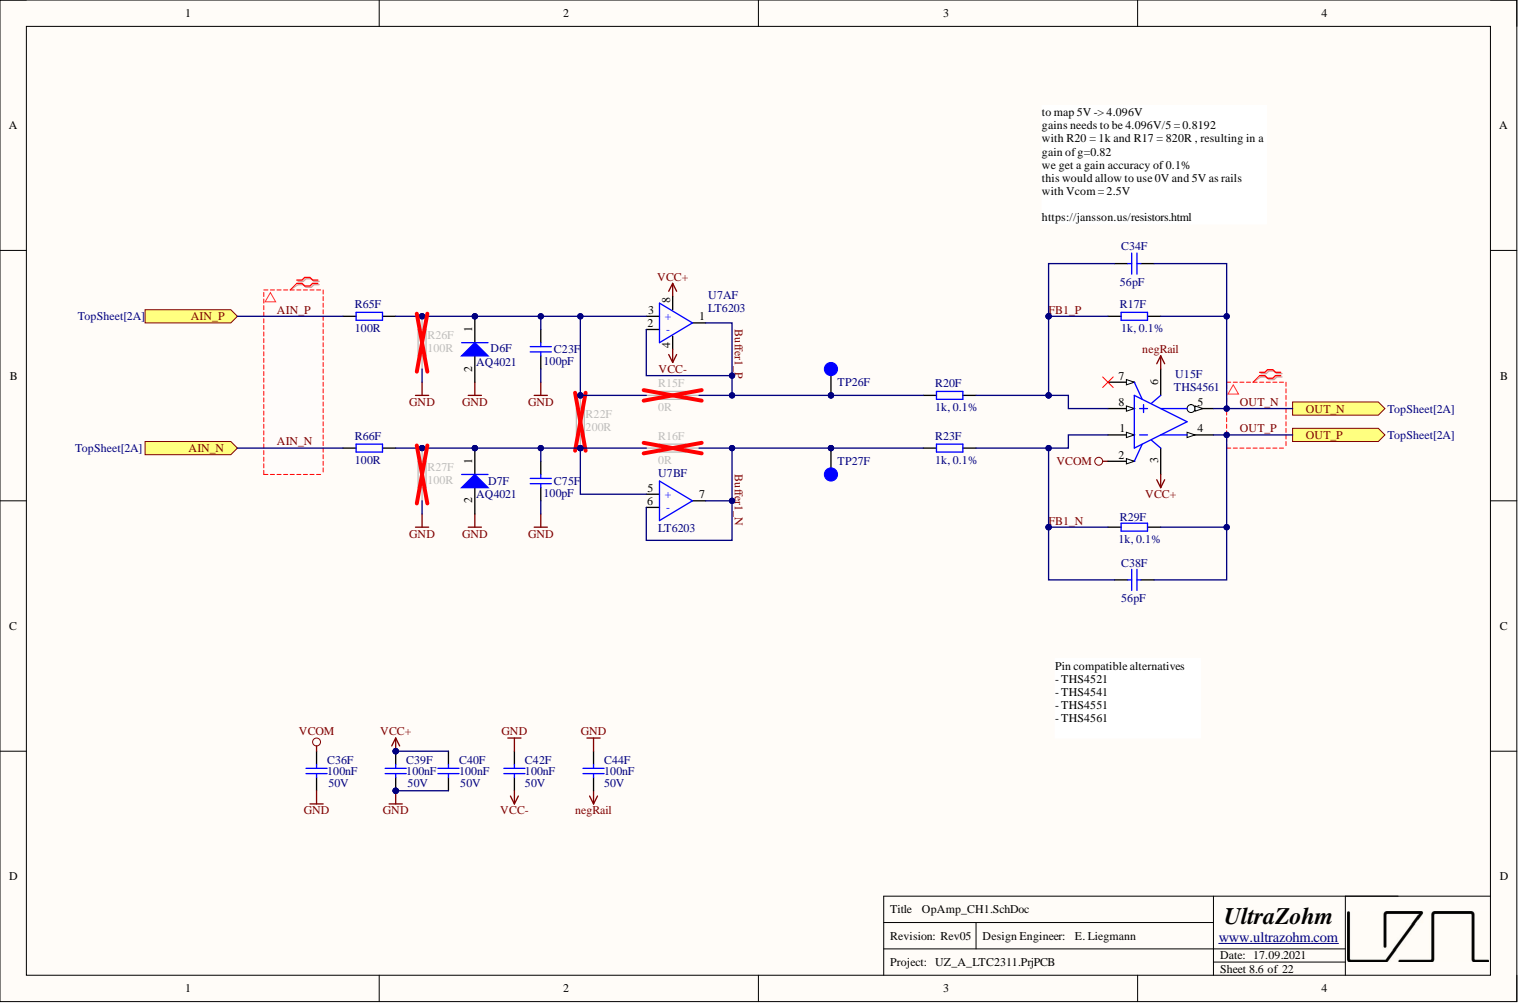
[picture p75: page 20]
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

https://jansson.us/resistors.html

VCC-
R15F

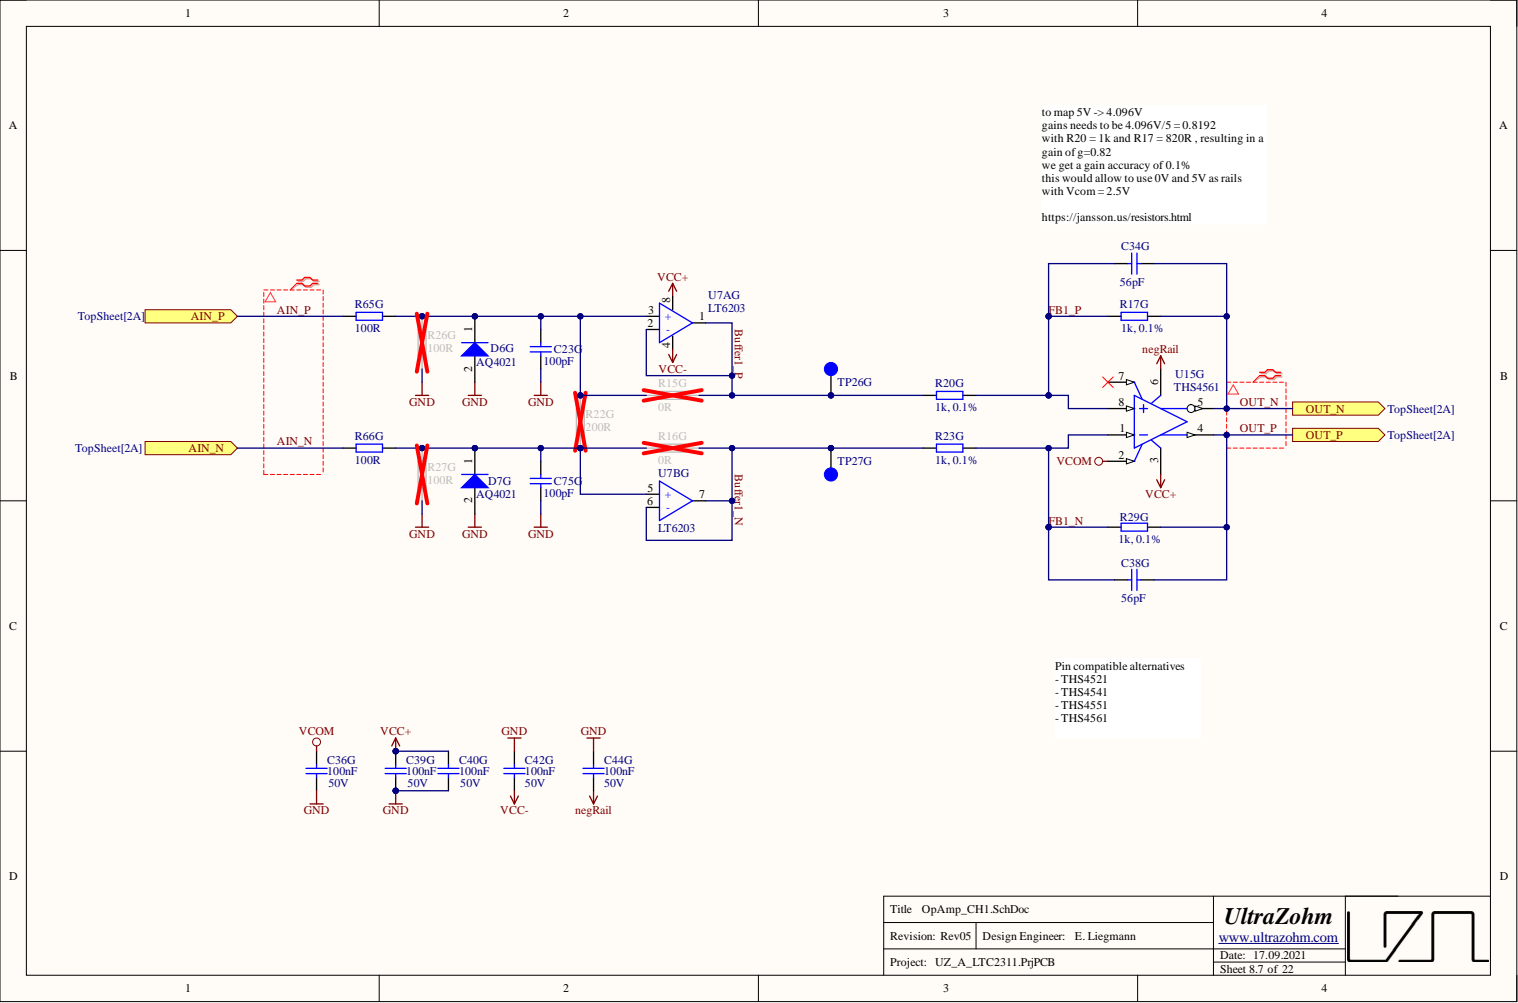
[picture p76: page 21]
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

https://jansson.us/resistors.html

VCC-
R15G

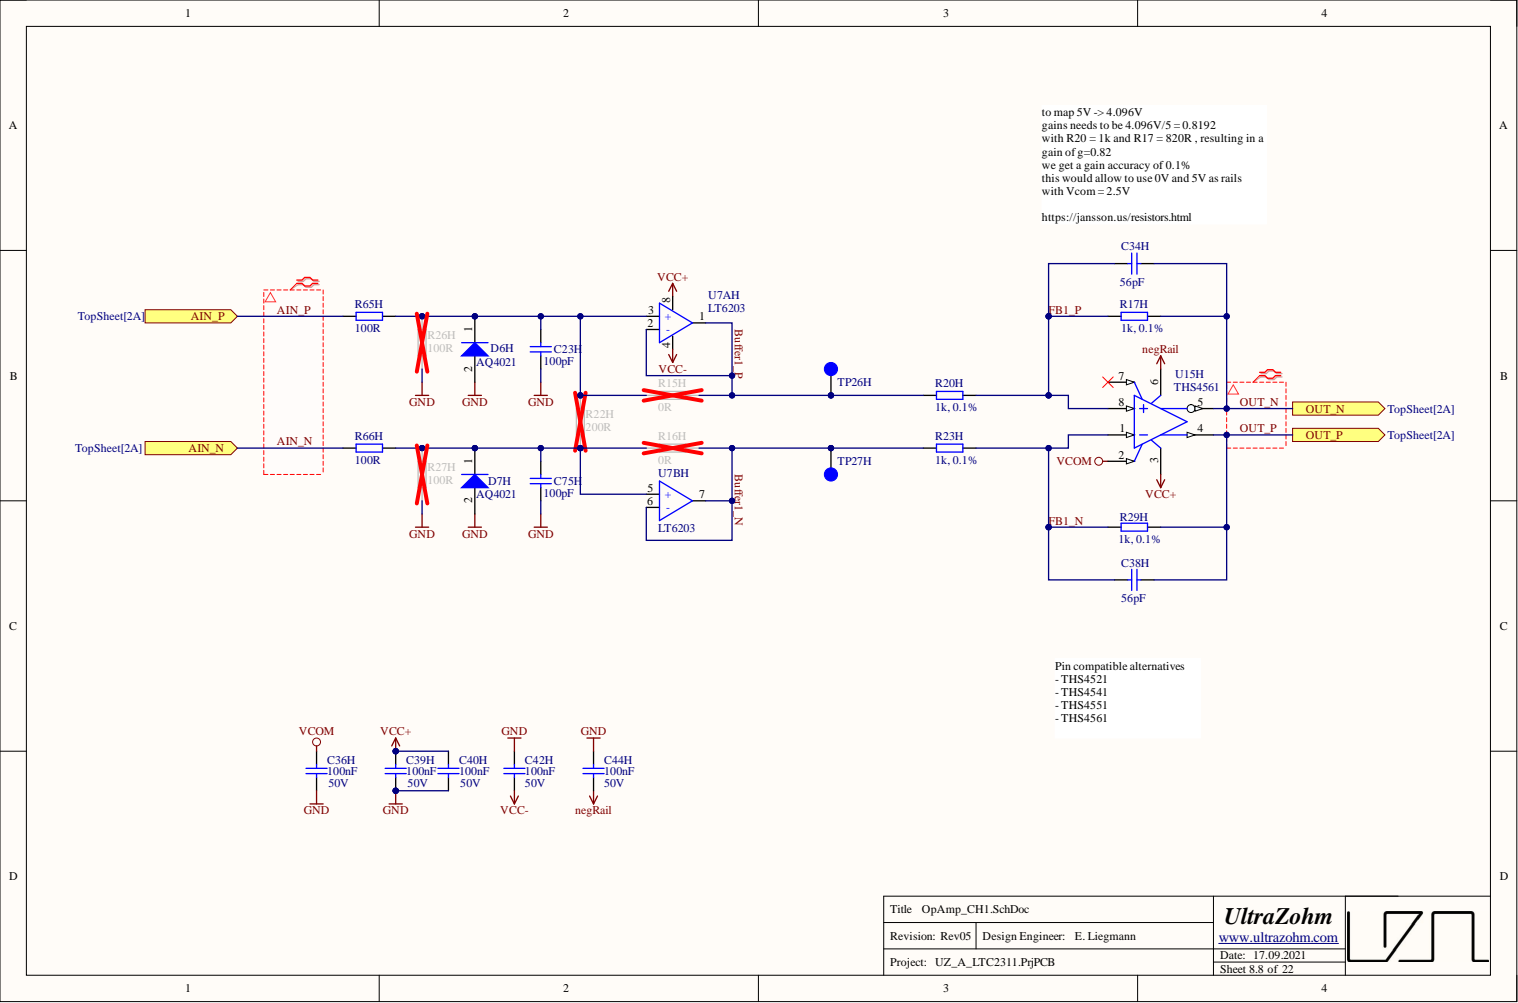
[picture p77: page 22]
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

https://jansson.us/resistors.html

VCC-
R15H
