ultrazohm/uz_a_ltc2311-16/Project Outputs for UZ_A_LTC2311/Rev04/SCH_UZ_A_LTC2311_Standard_Rev04.PDF

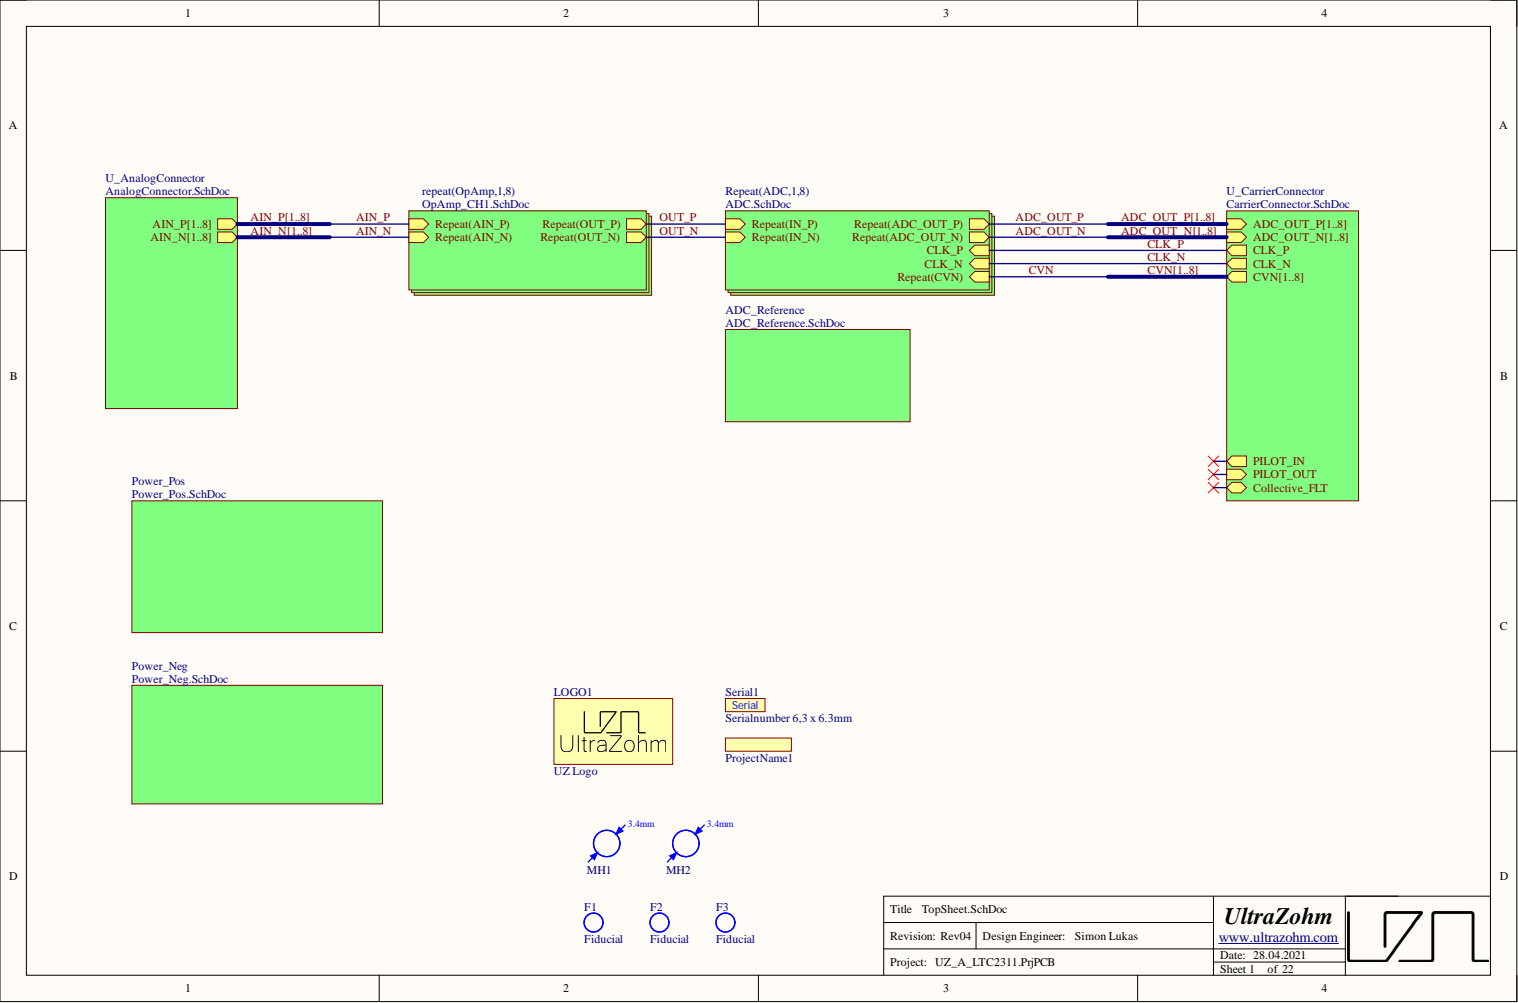
[picture p78: page 1]

Revision:

Date: 28.04.2021

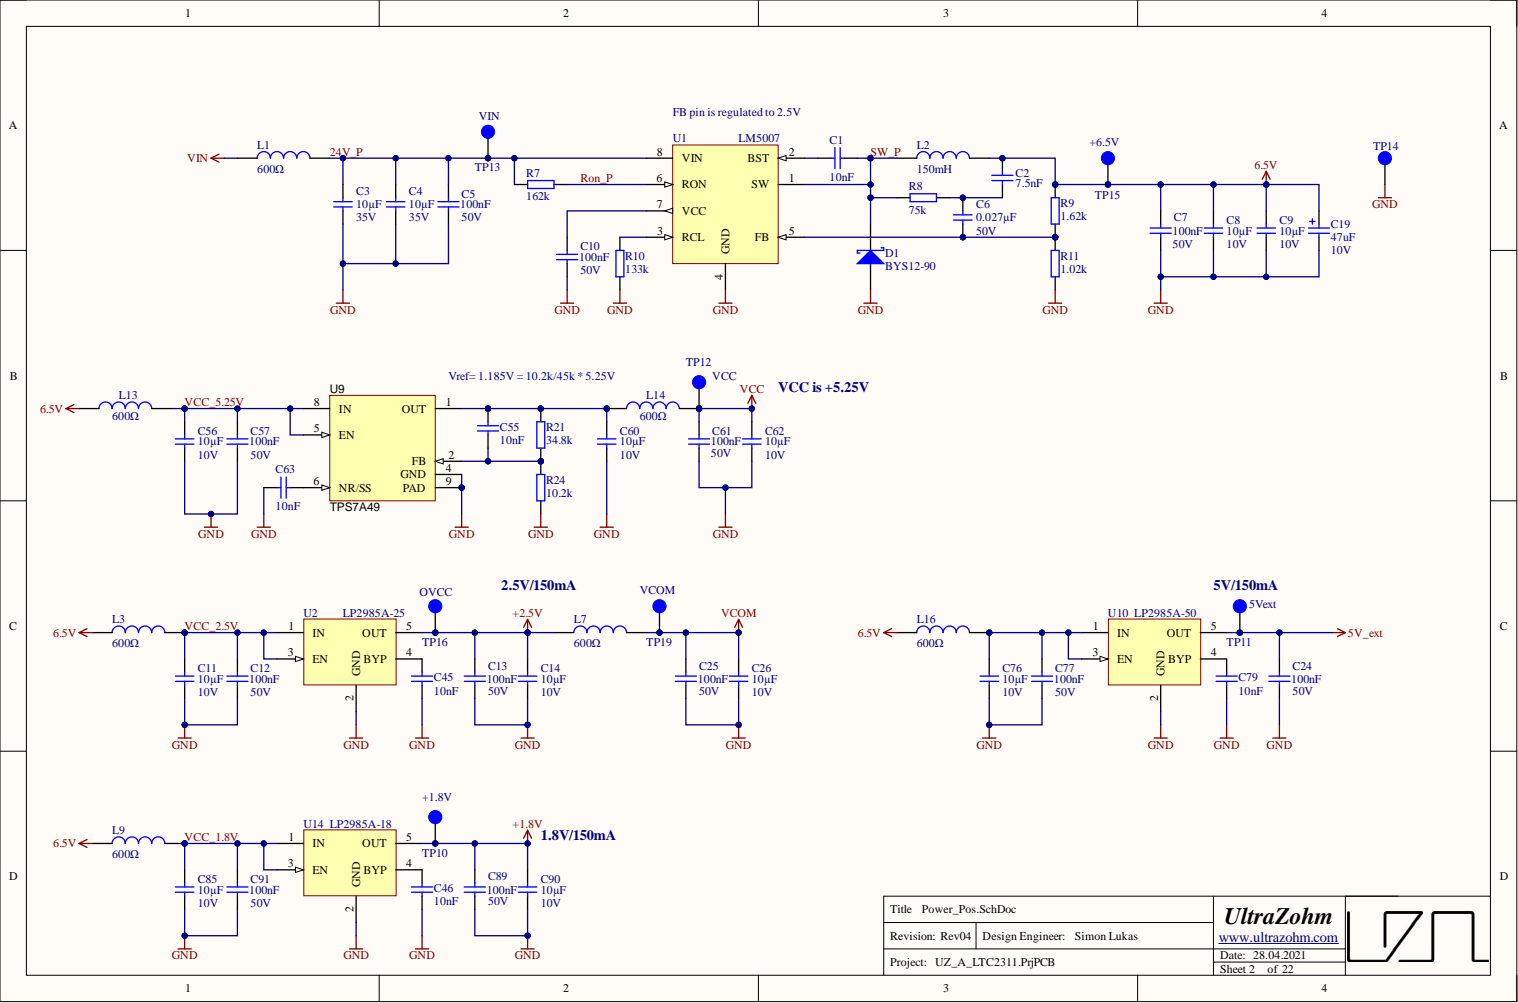
[picture p79: page 2]

FB pin is regulated to 2.5V

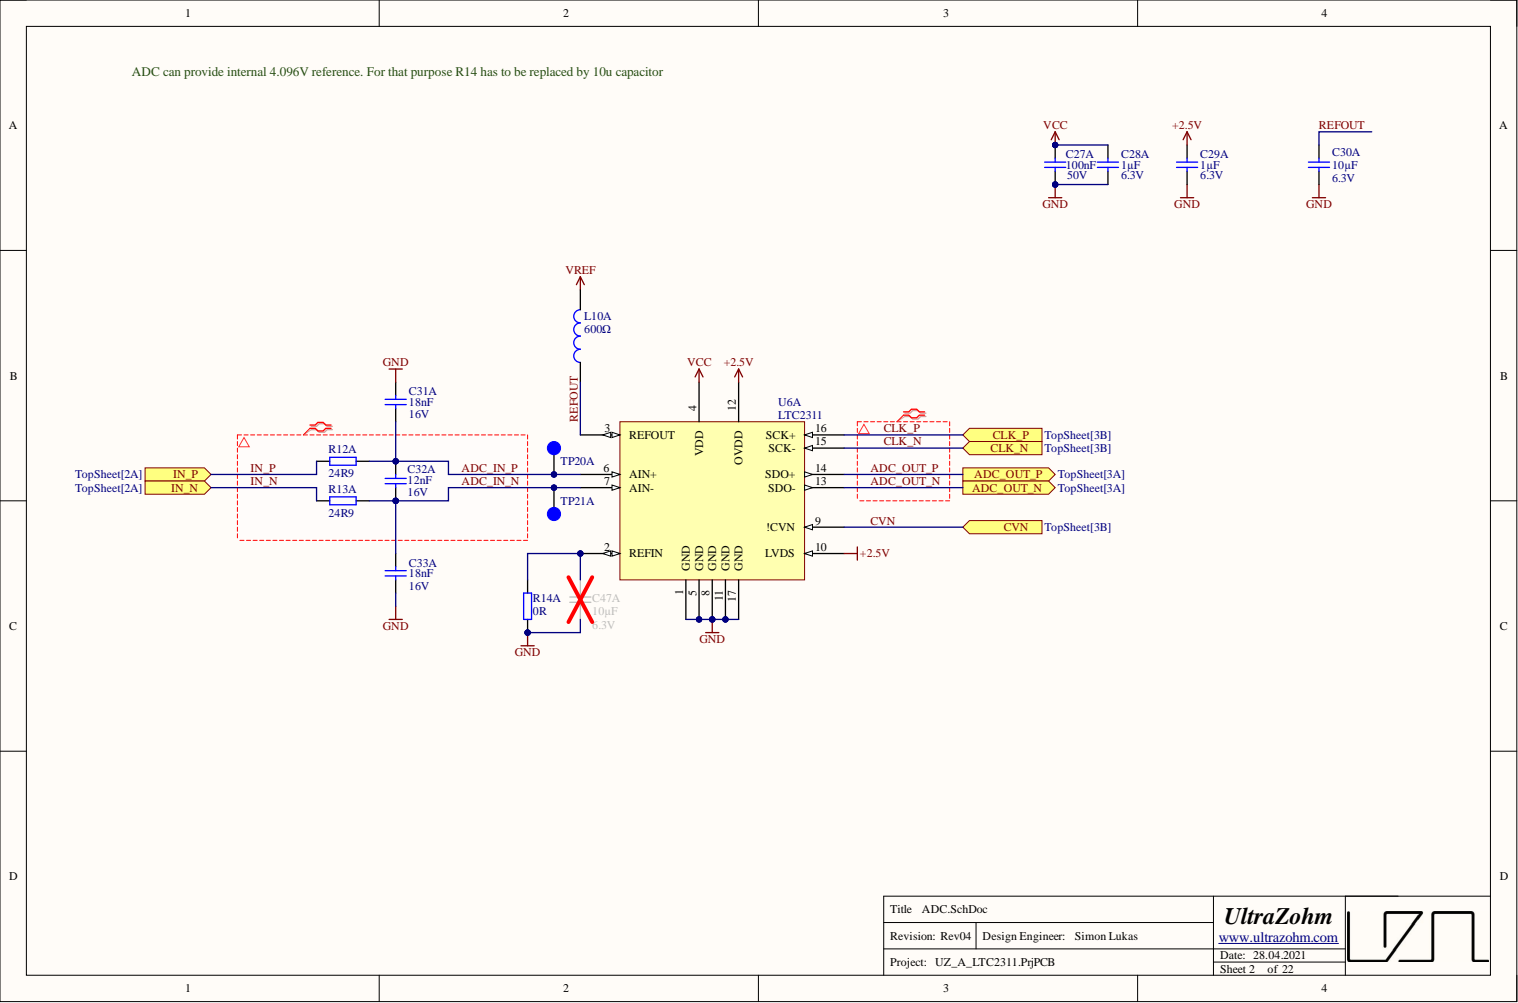
[picture p80: page 3]

ADC can provide internal 4.096V reference. For that purpose R14 has to be replaced by 10u capacitor

IN_P
IN_N ADC_IN_N | | AIN- 7

16V | | | REFIN 2

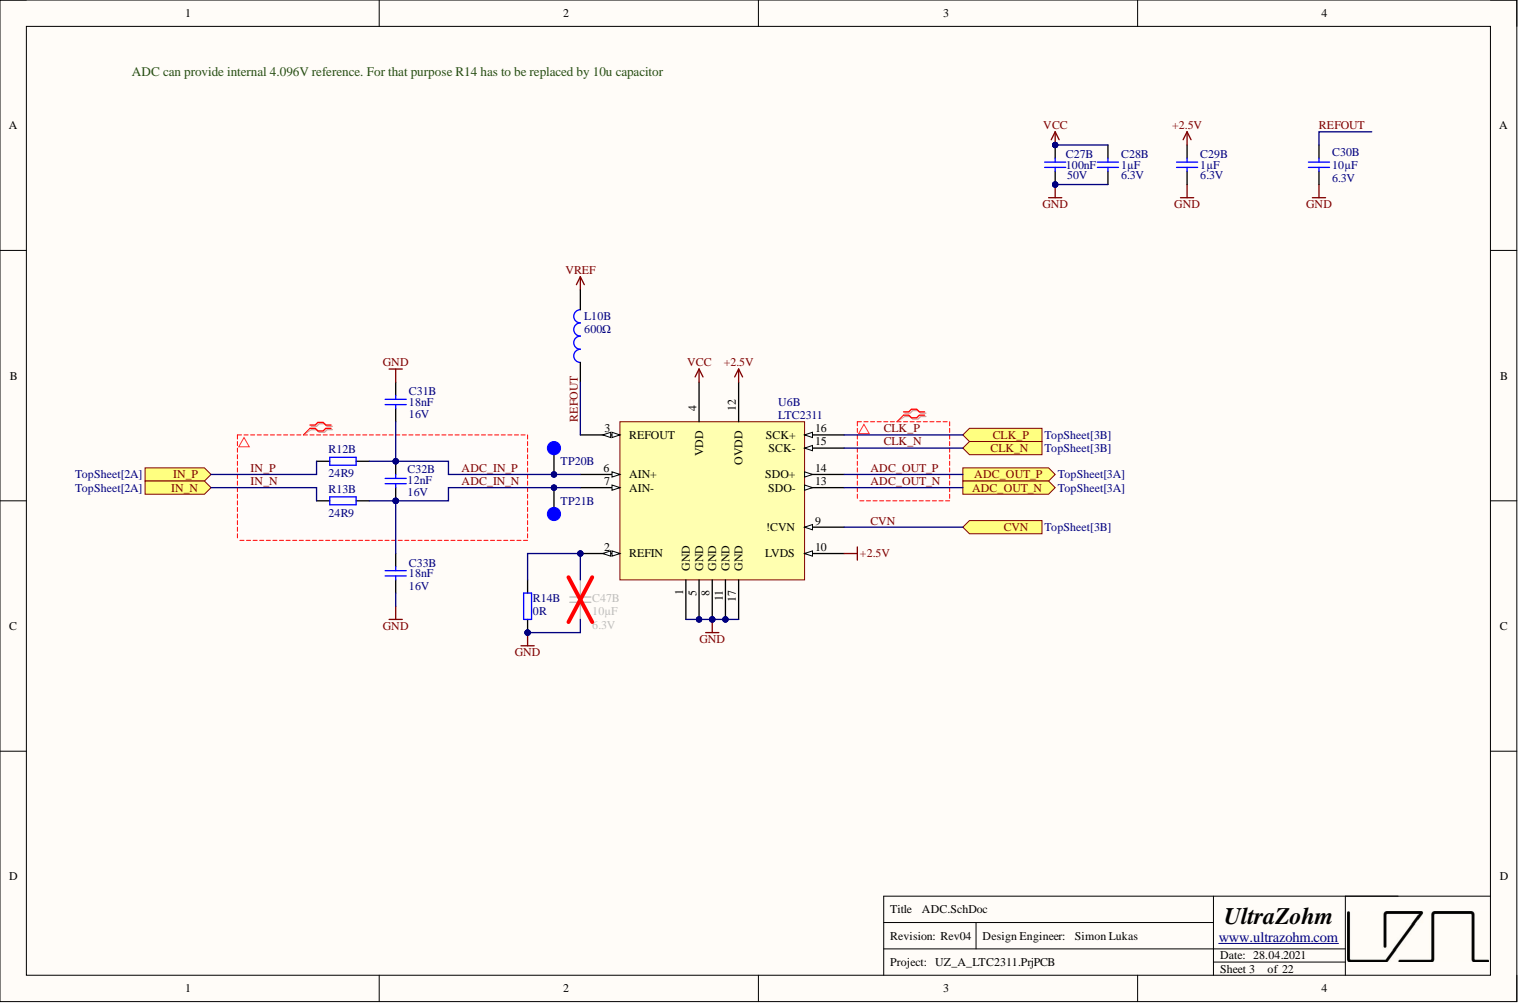
[picture p81: page 4]

Rev i s n

Dat e :

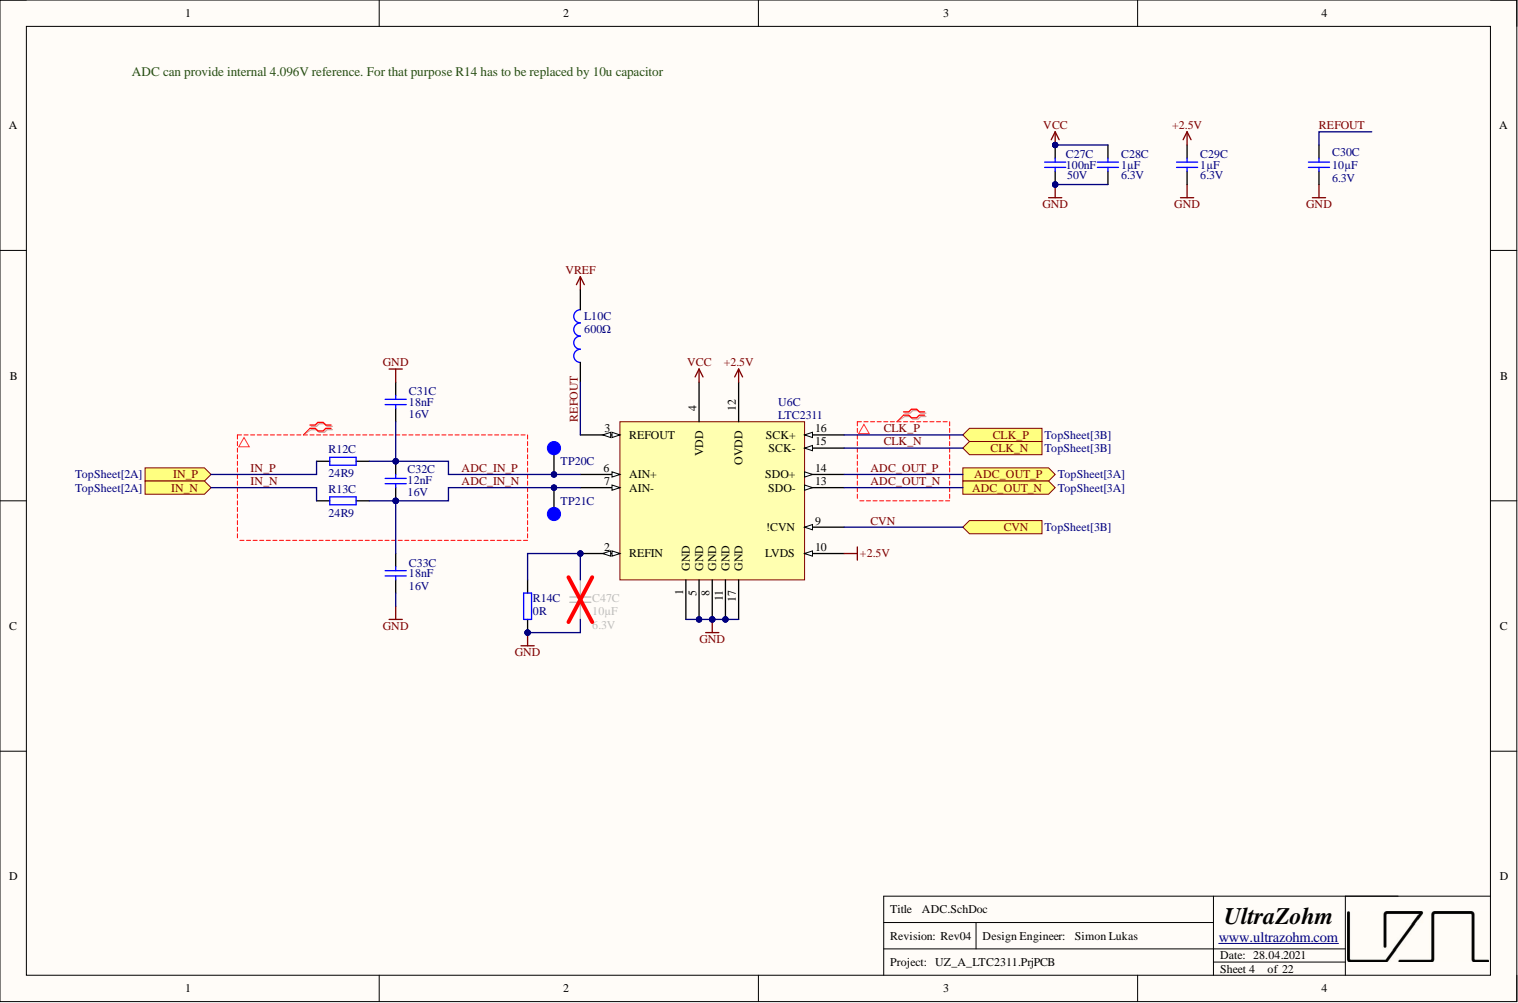
[picture p82: page 5]

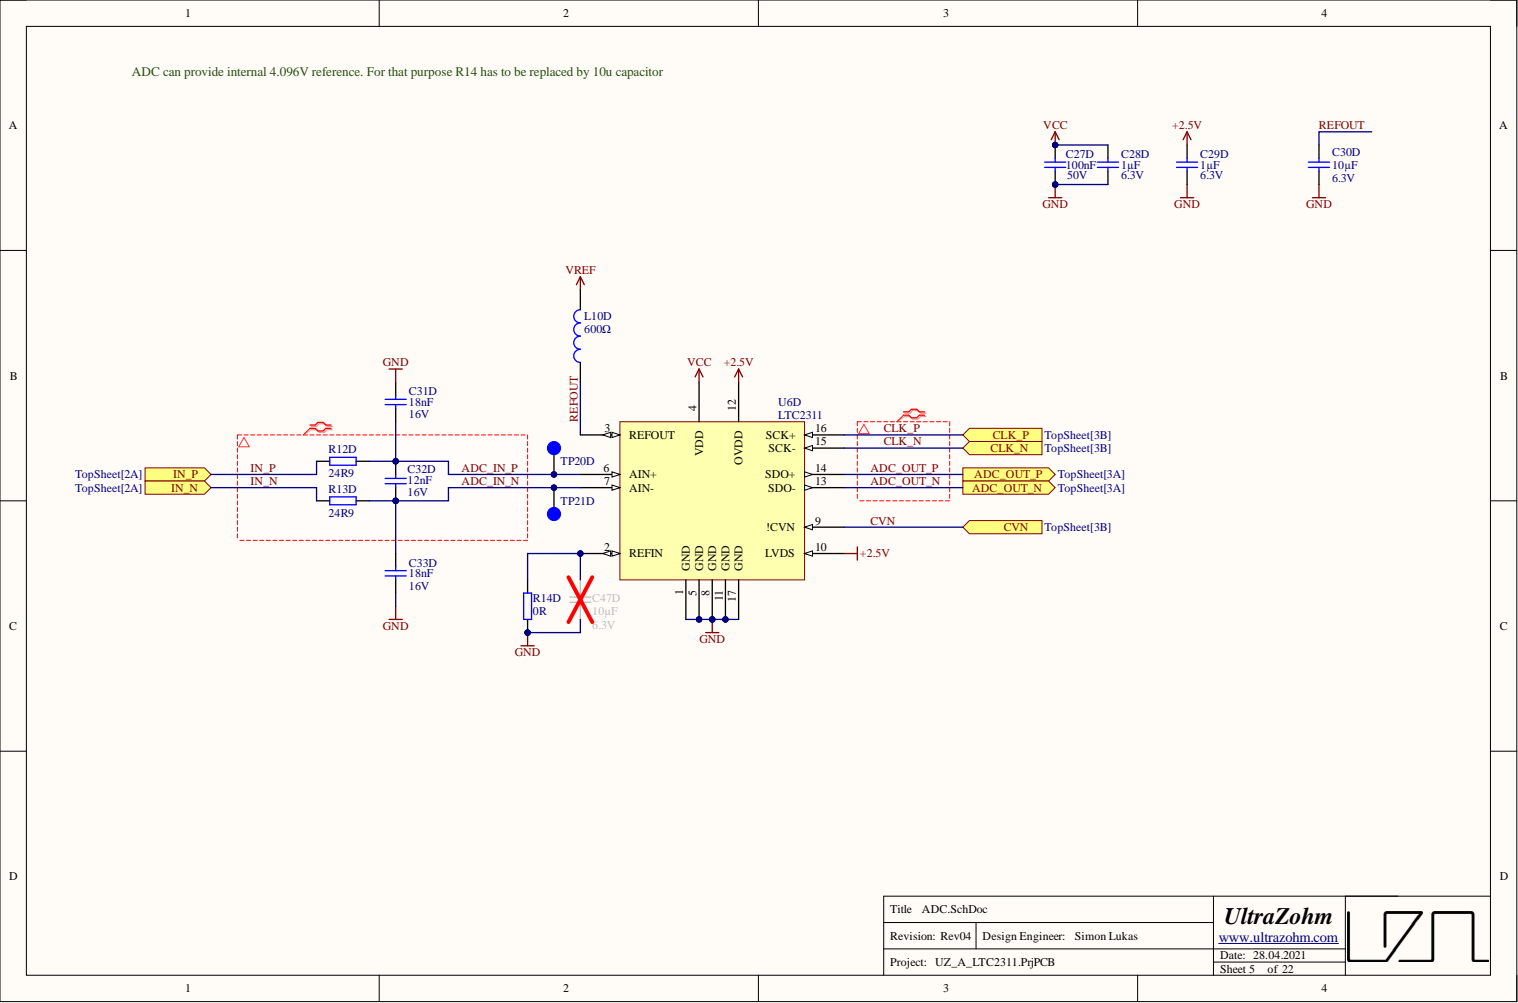
[picture p83: page 6]

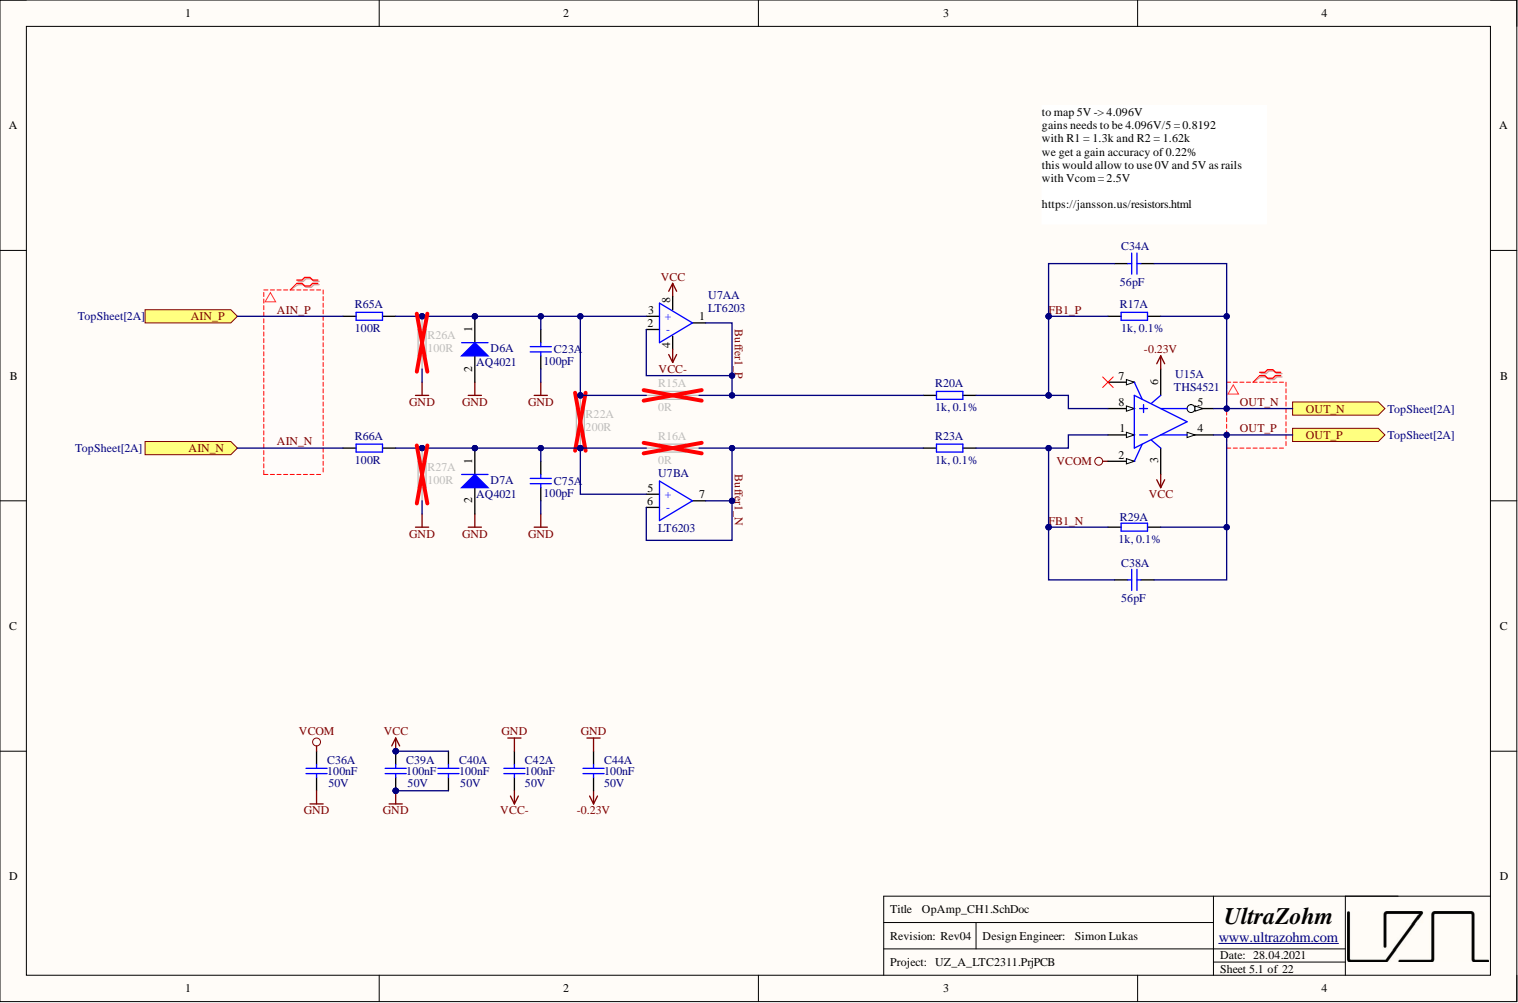
[picture p84: page 7]

to map 5V -> 4.096V
gains needs to be 4.096V/5 = 0.8192
with R1 = 1.3k and R2 = 1.62k
we get a gain accuracy of 0.22%
this would allow to use 0V and 5V as rails
with Vcom = 2.5V

https://jansson.us/resistors.html

VCC-
R15A

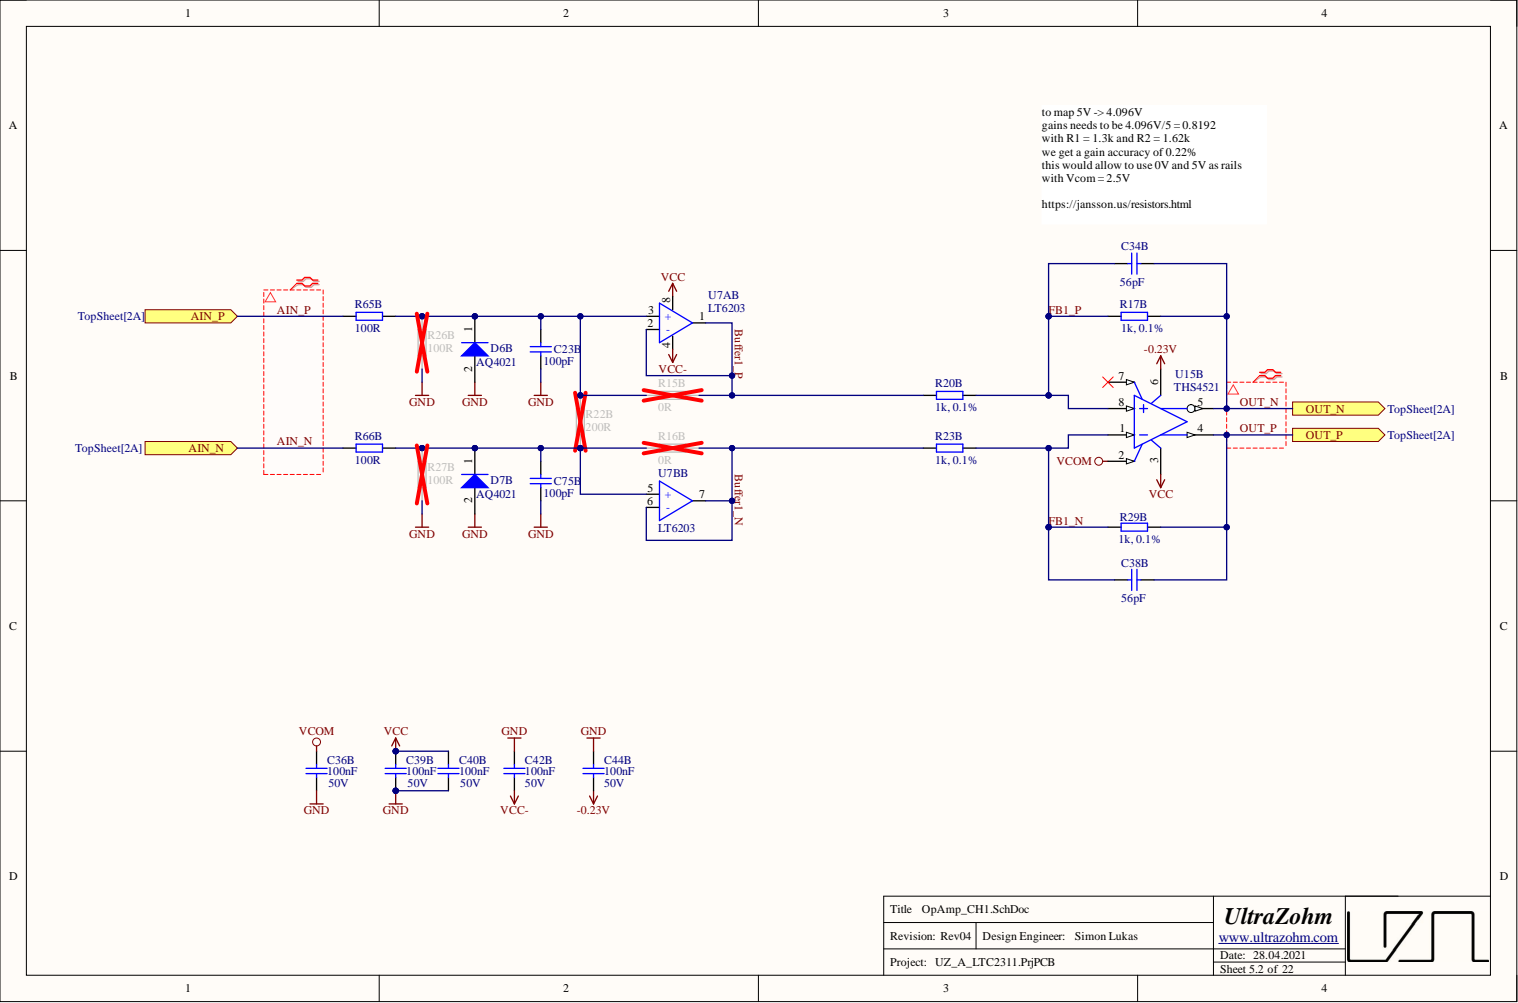
[picture p85: page 8]
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

https://jansson.us/resistors.html

VCC-
R15B

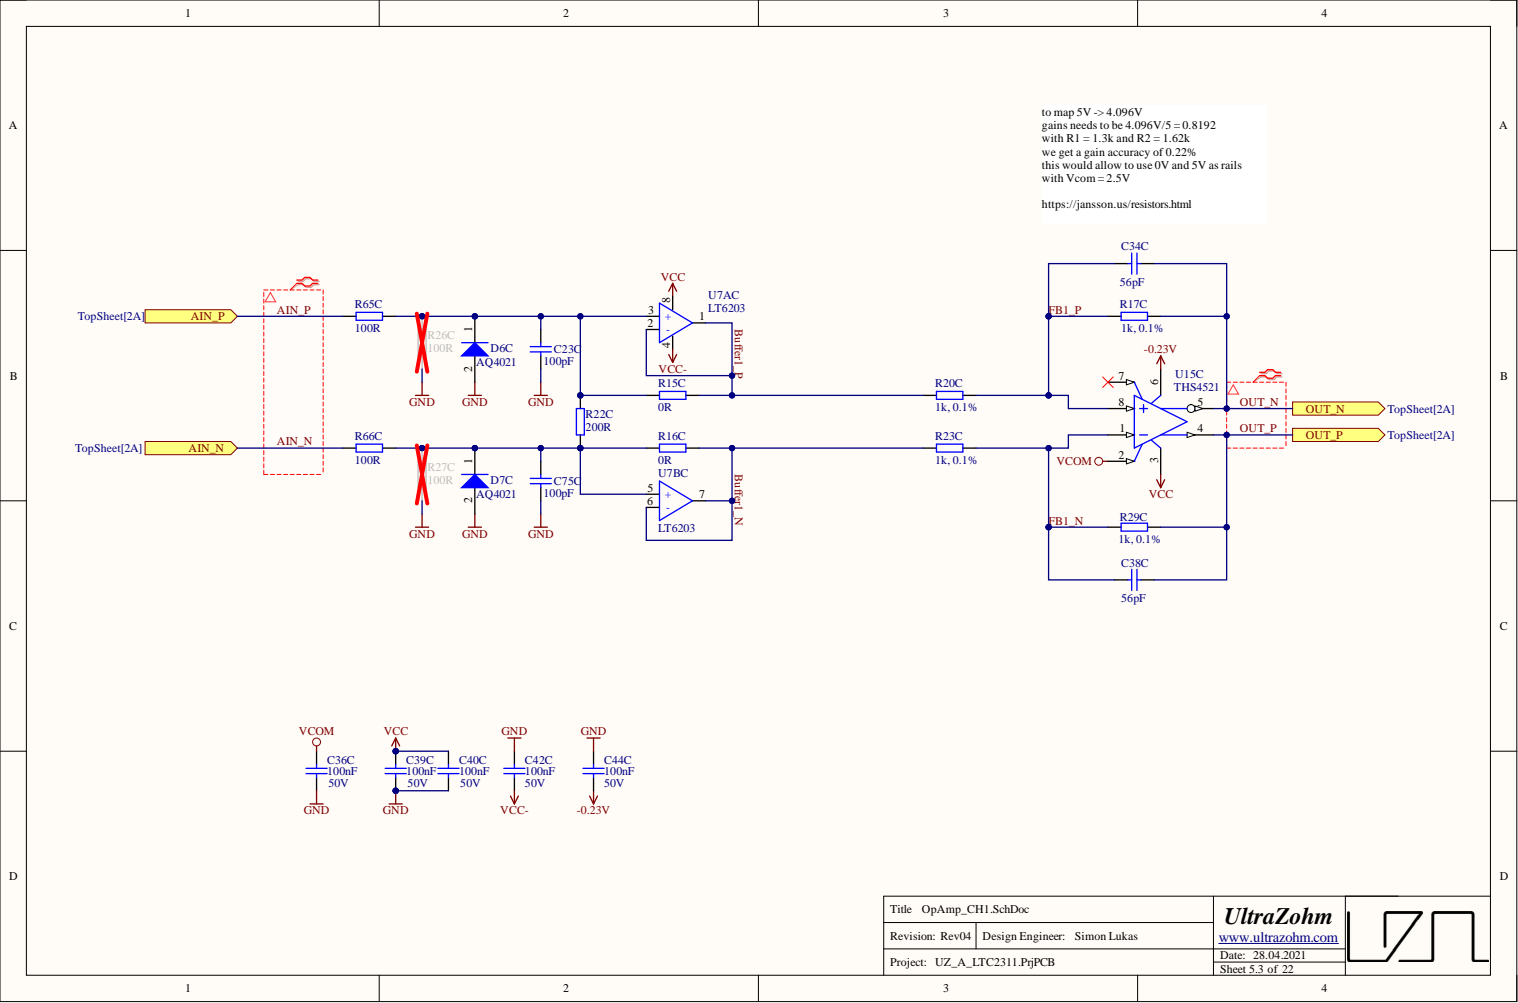
[picture p86: page 9]
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

https://jansson.us/resistors.html

VCC-
R15C

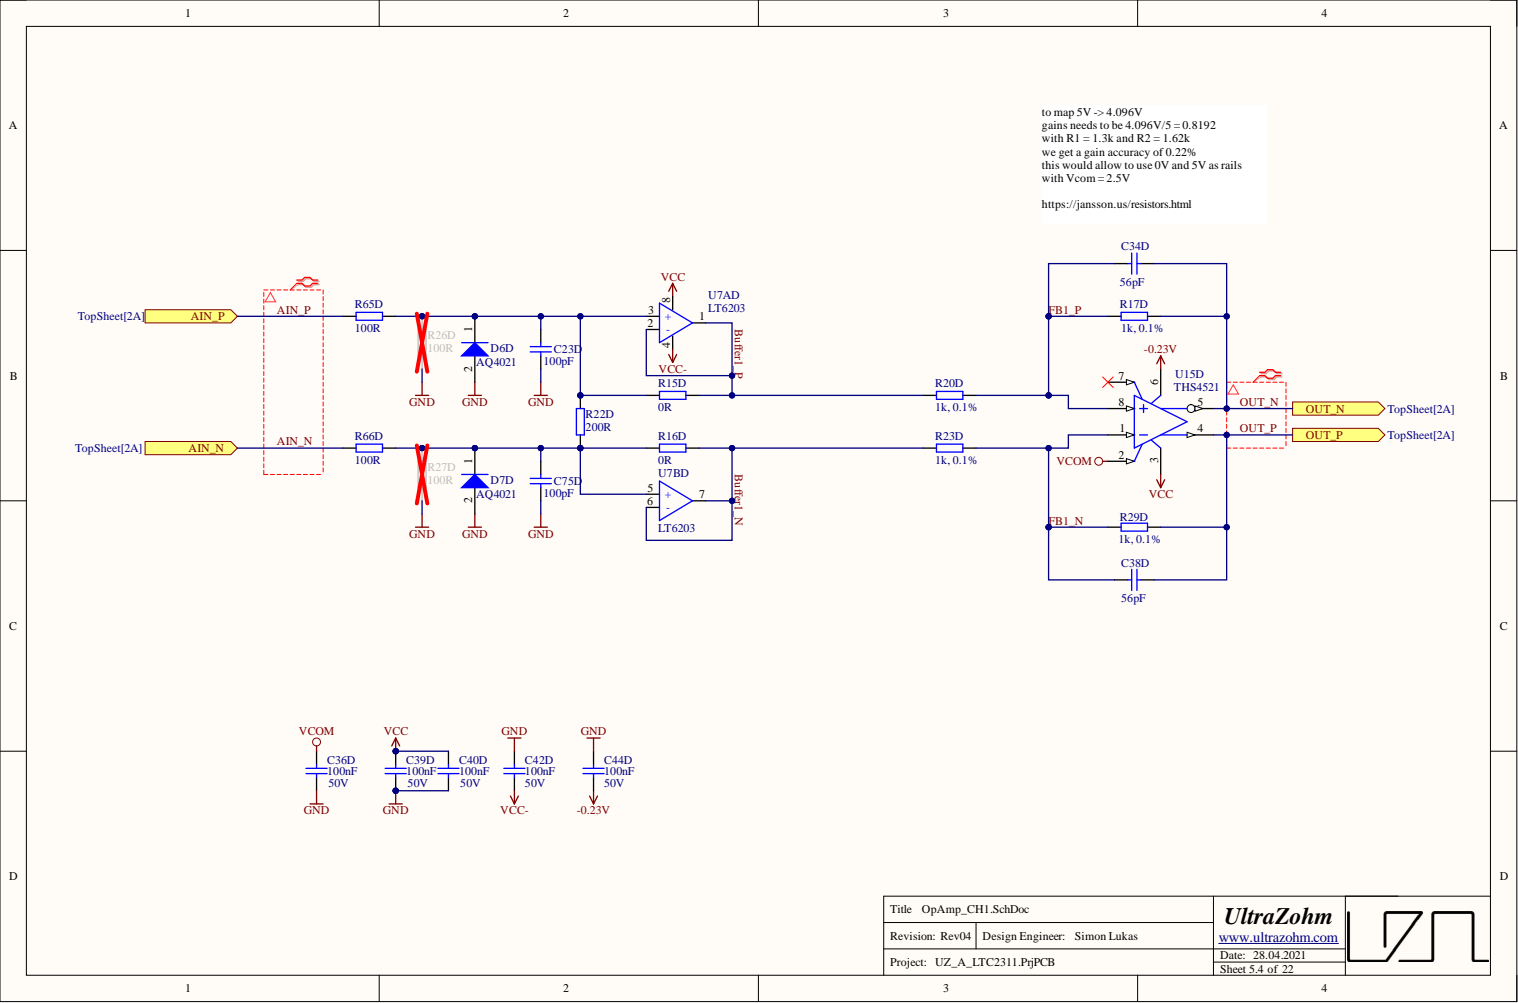
[picture p87: page 10]
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

https://jansson.us/resistors.html

VCC-
R15D

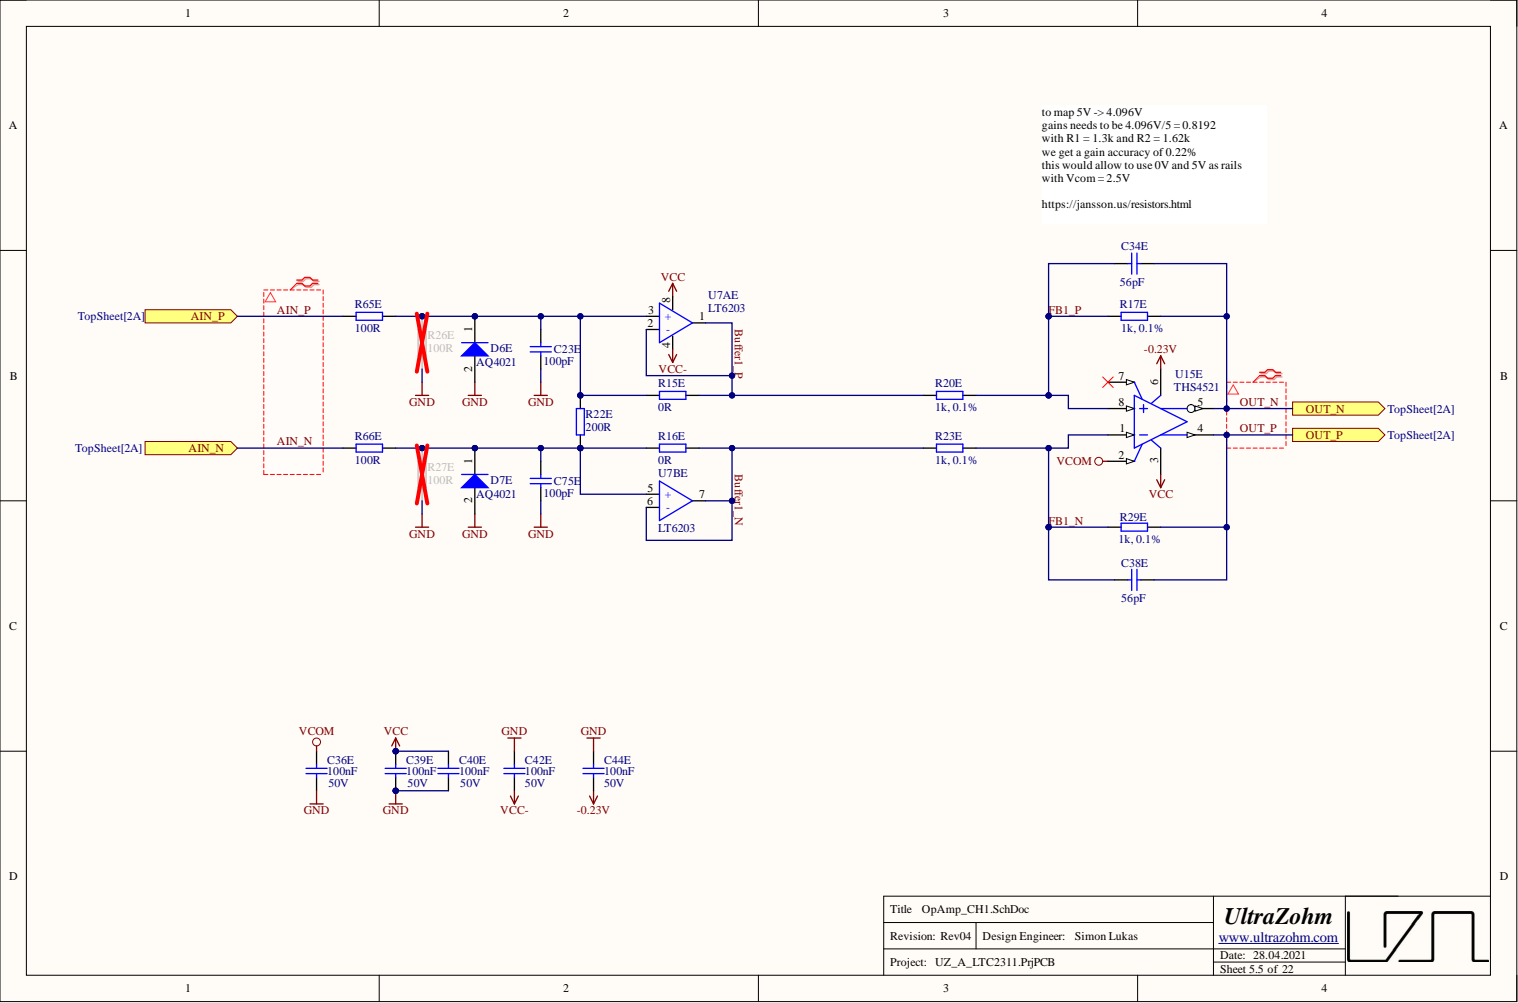
[picture p88: page 11]
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

https://jansson.us/resistors.html

VCC-
R15E

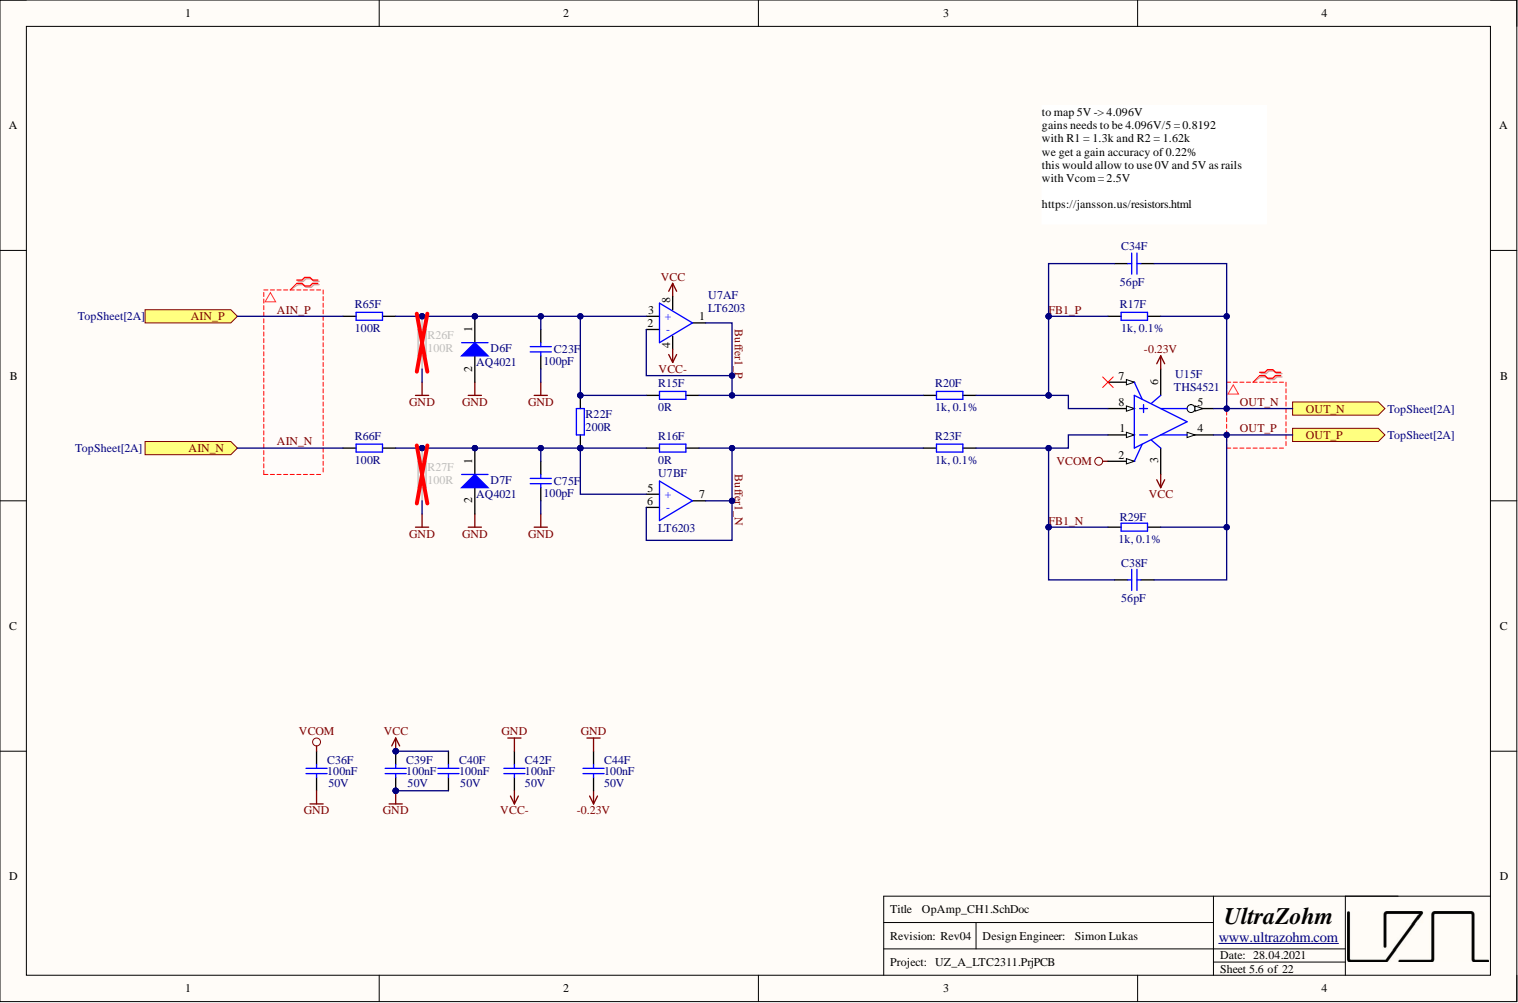
[picture p89: page 12]
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

https://jansson.us/resistors.html

VCC-
R15F

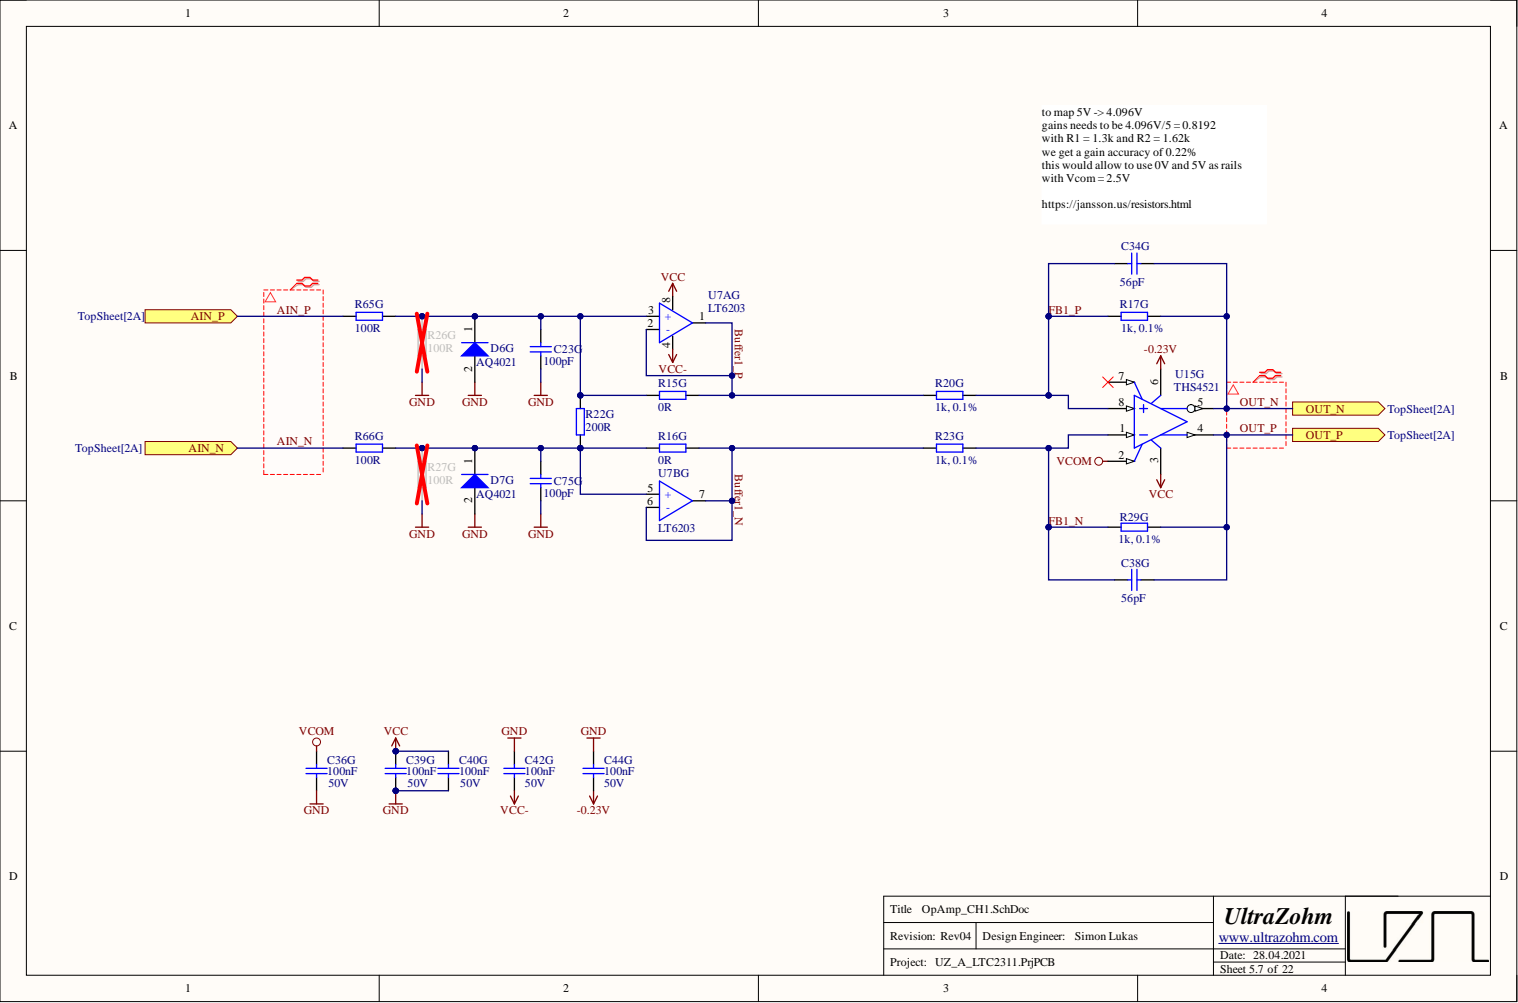
[picture p90: page 13]
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

https://jansson.us/resistors.html

VCC-
R15G

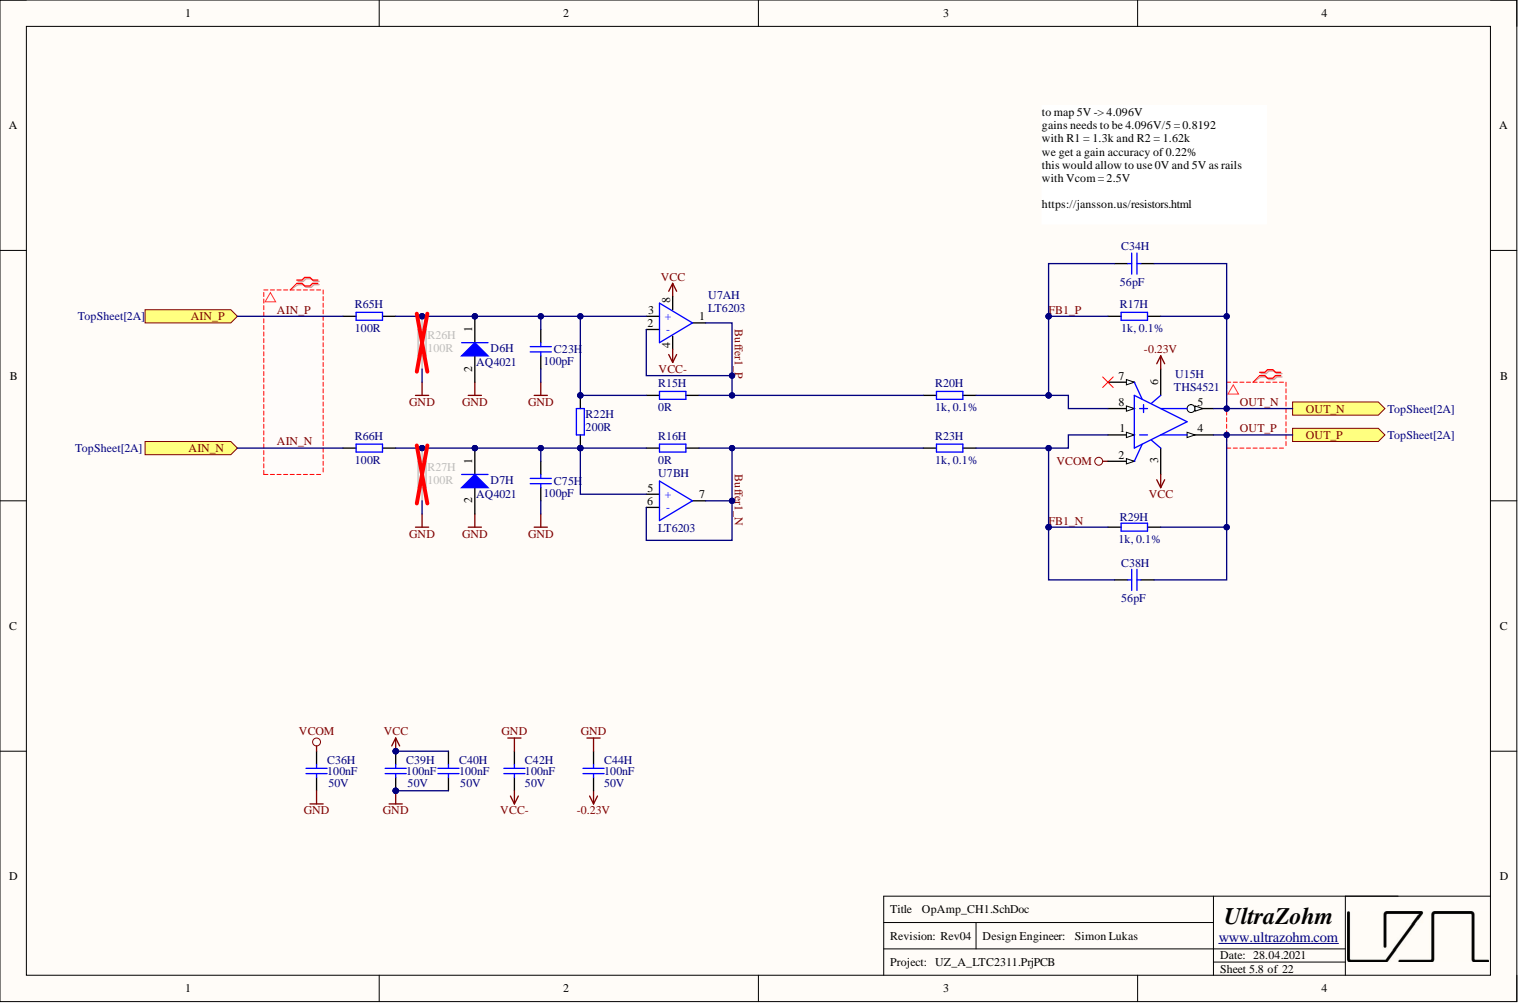
[picture p91: page 14]
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

https://jansson.us/resistors.html

VCC-
R15H

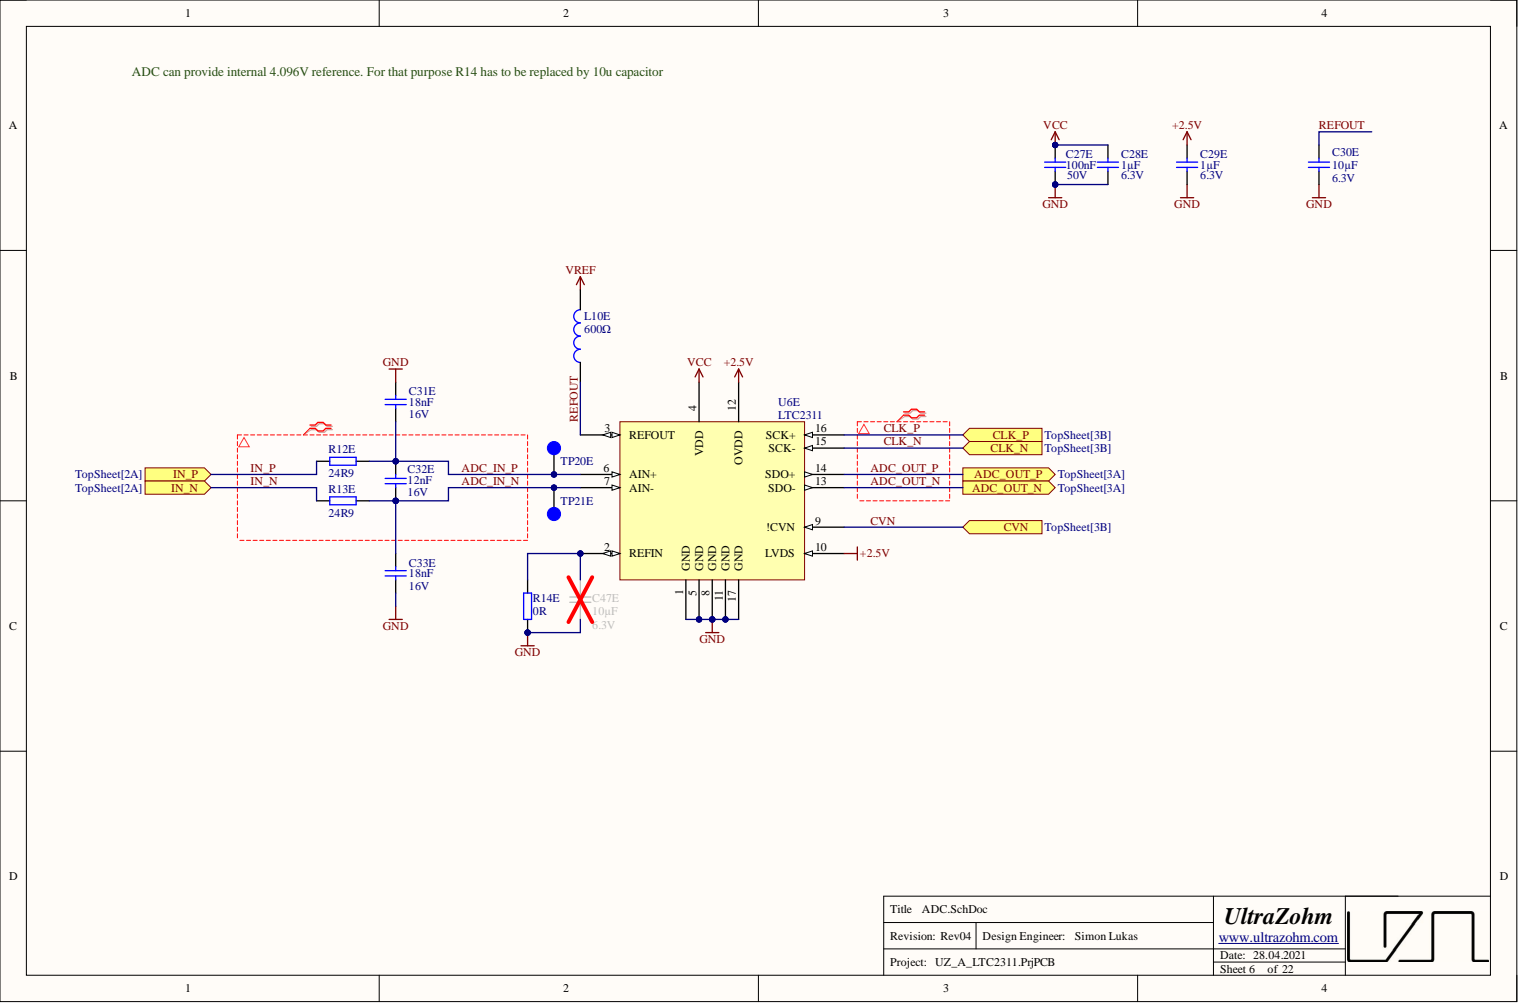
[picture p92: page 15]

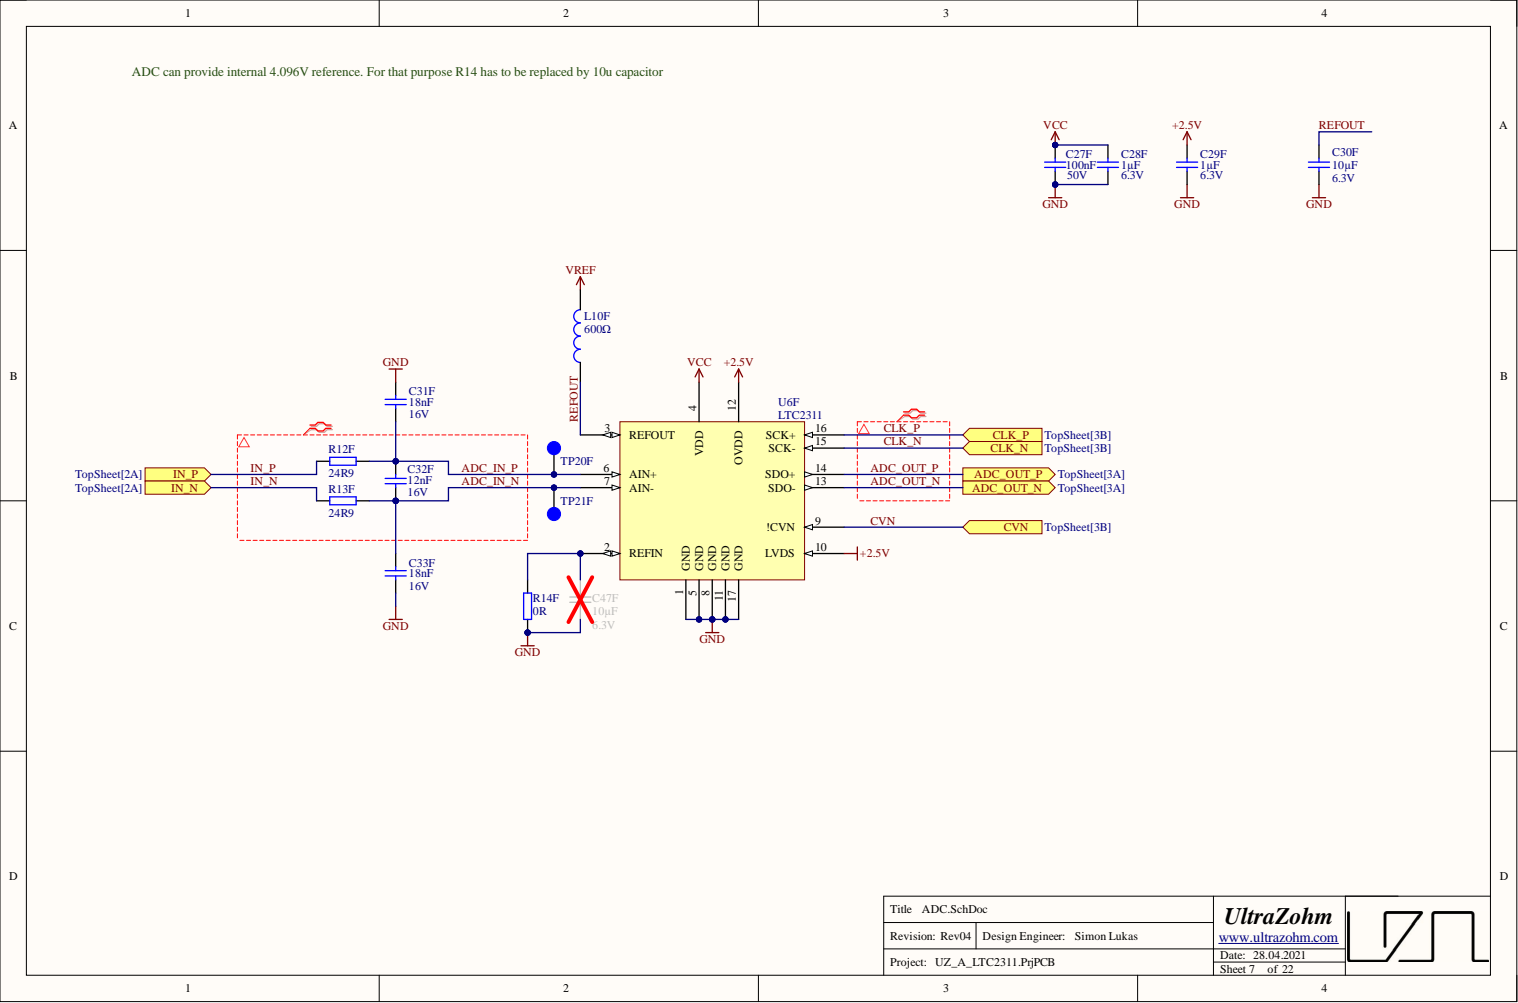
[picture p93: page 16]

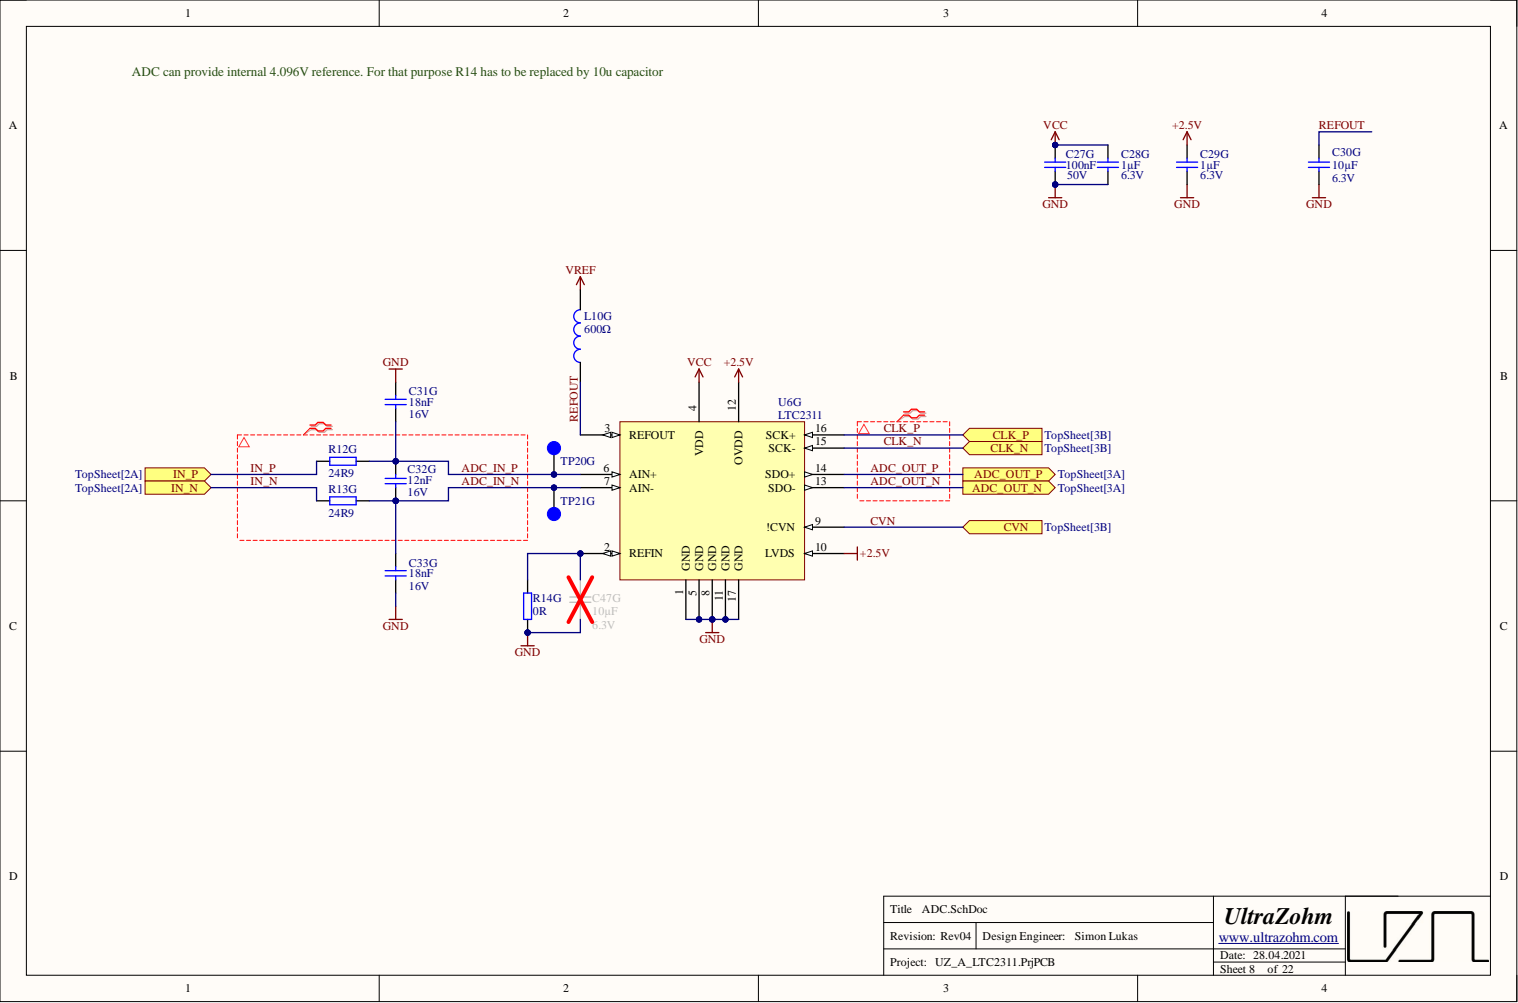
[picture p94: page 17]

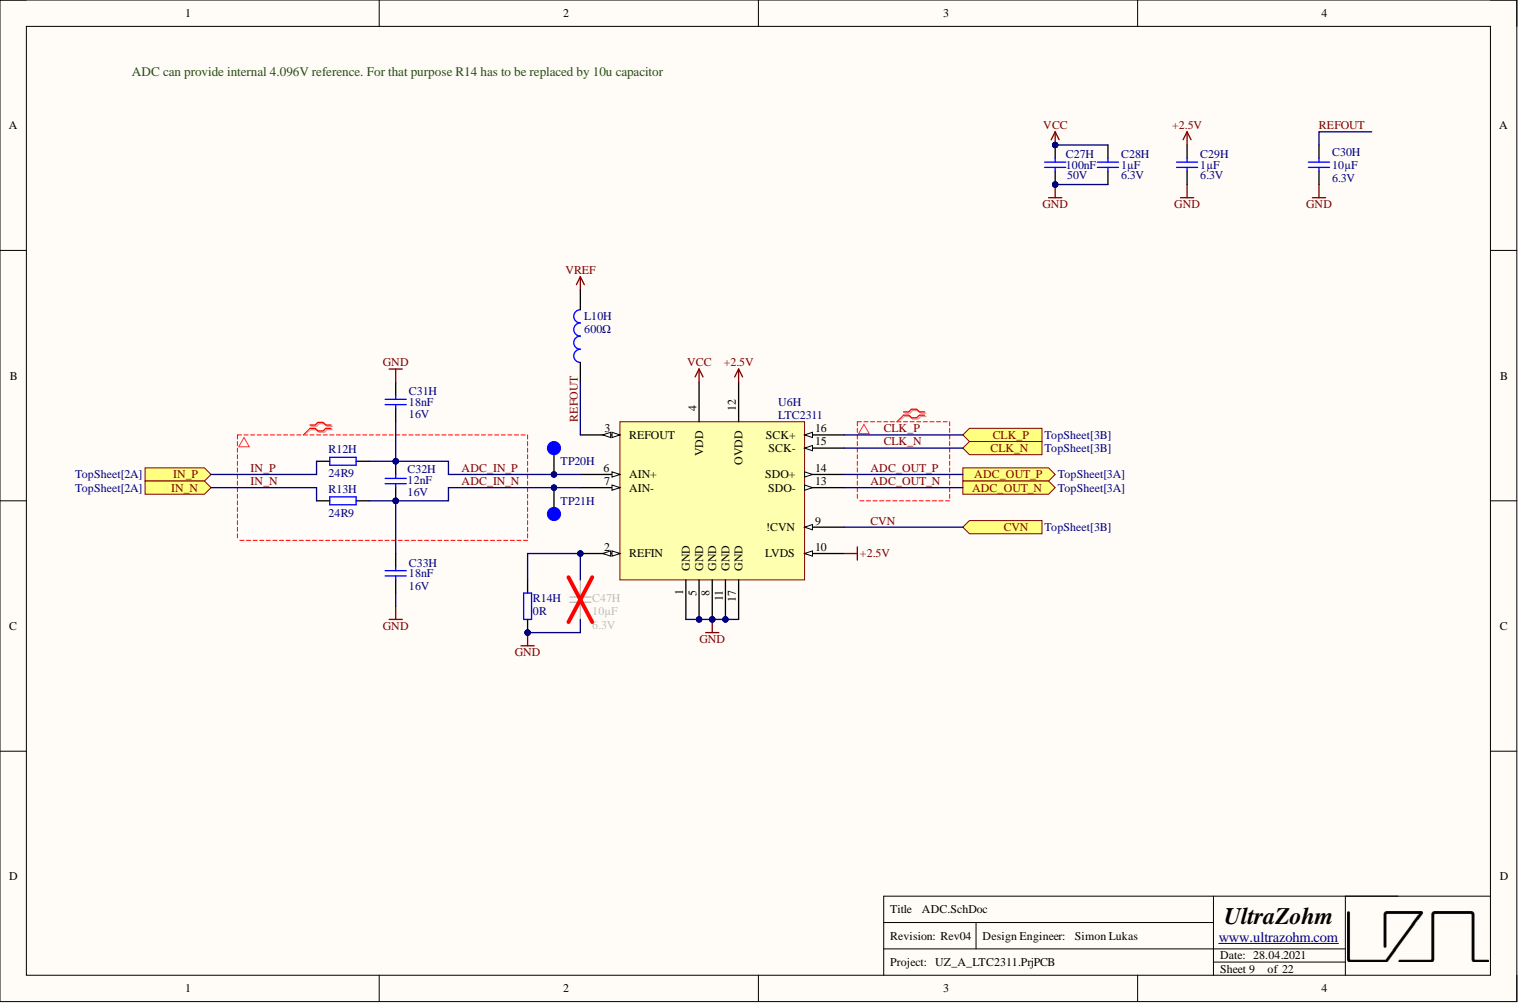
[picture p95: page 18]

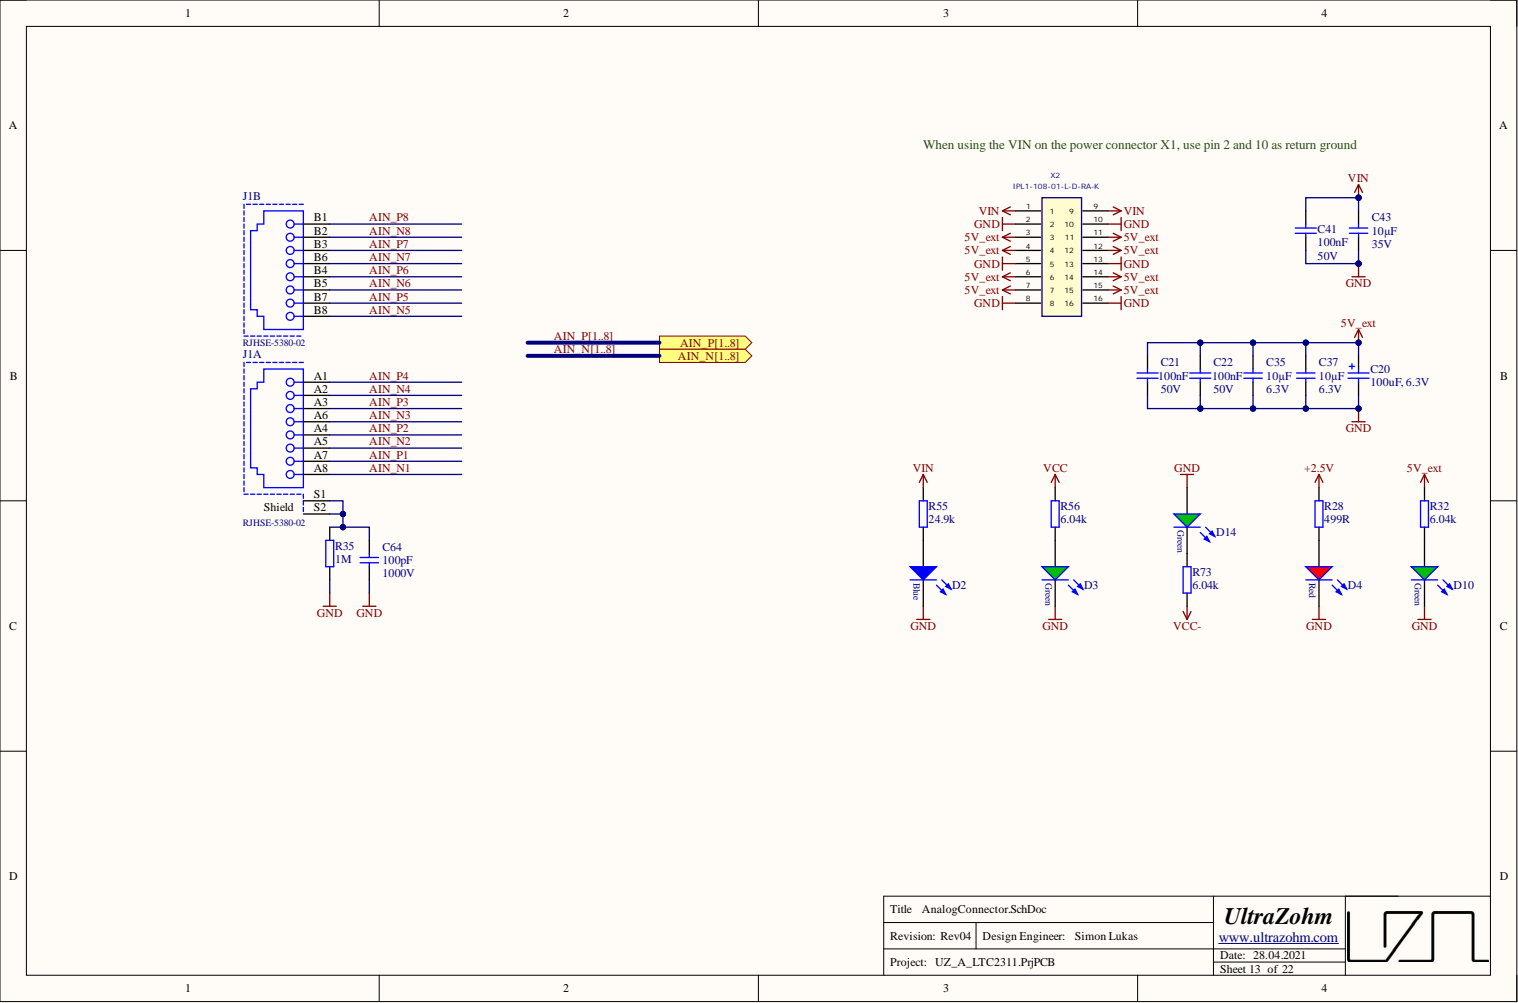
[picture p96: page 19]

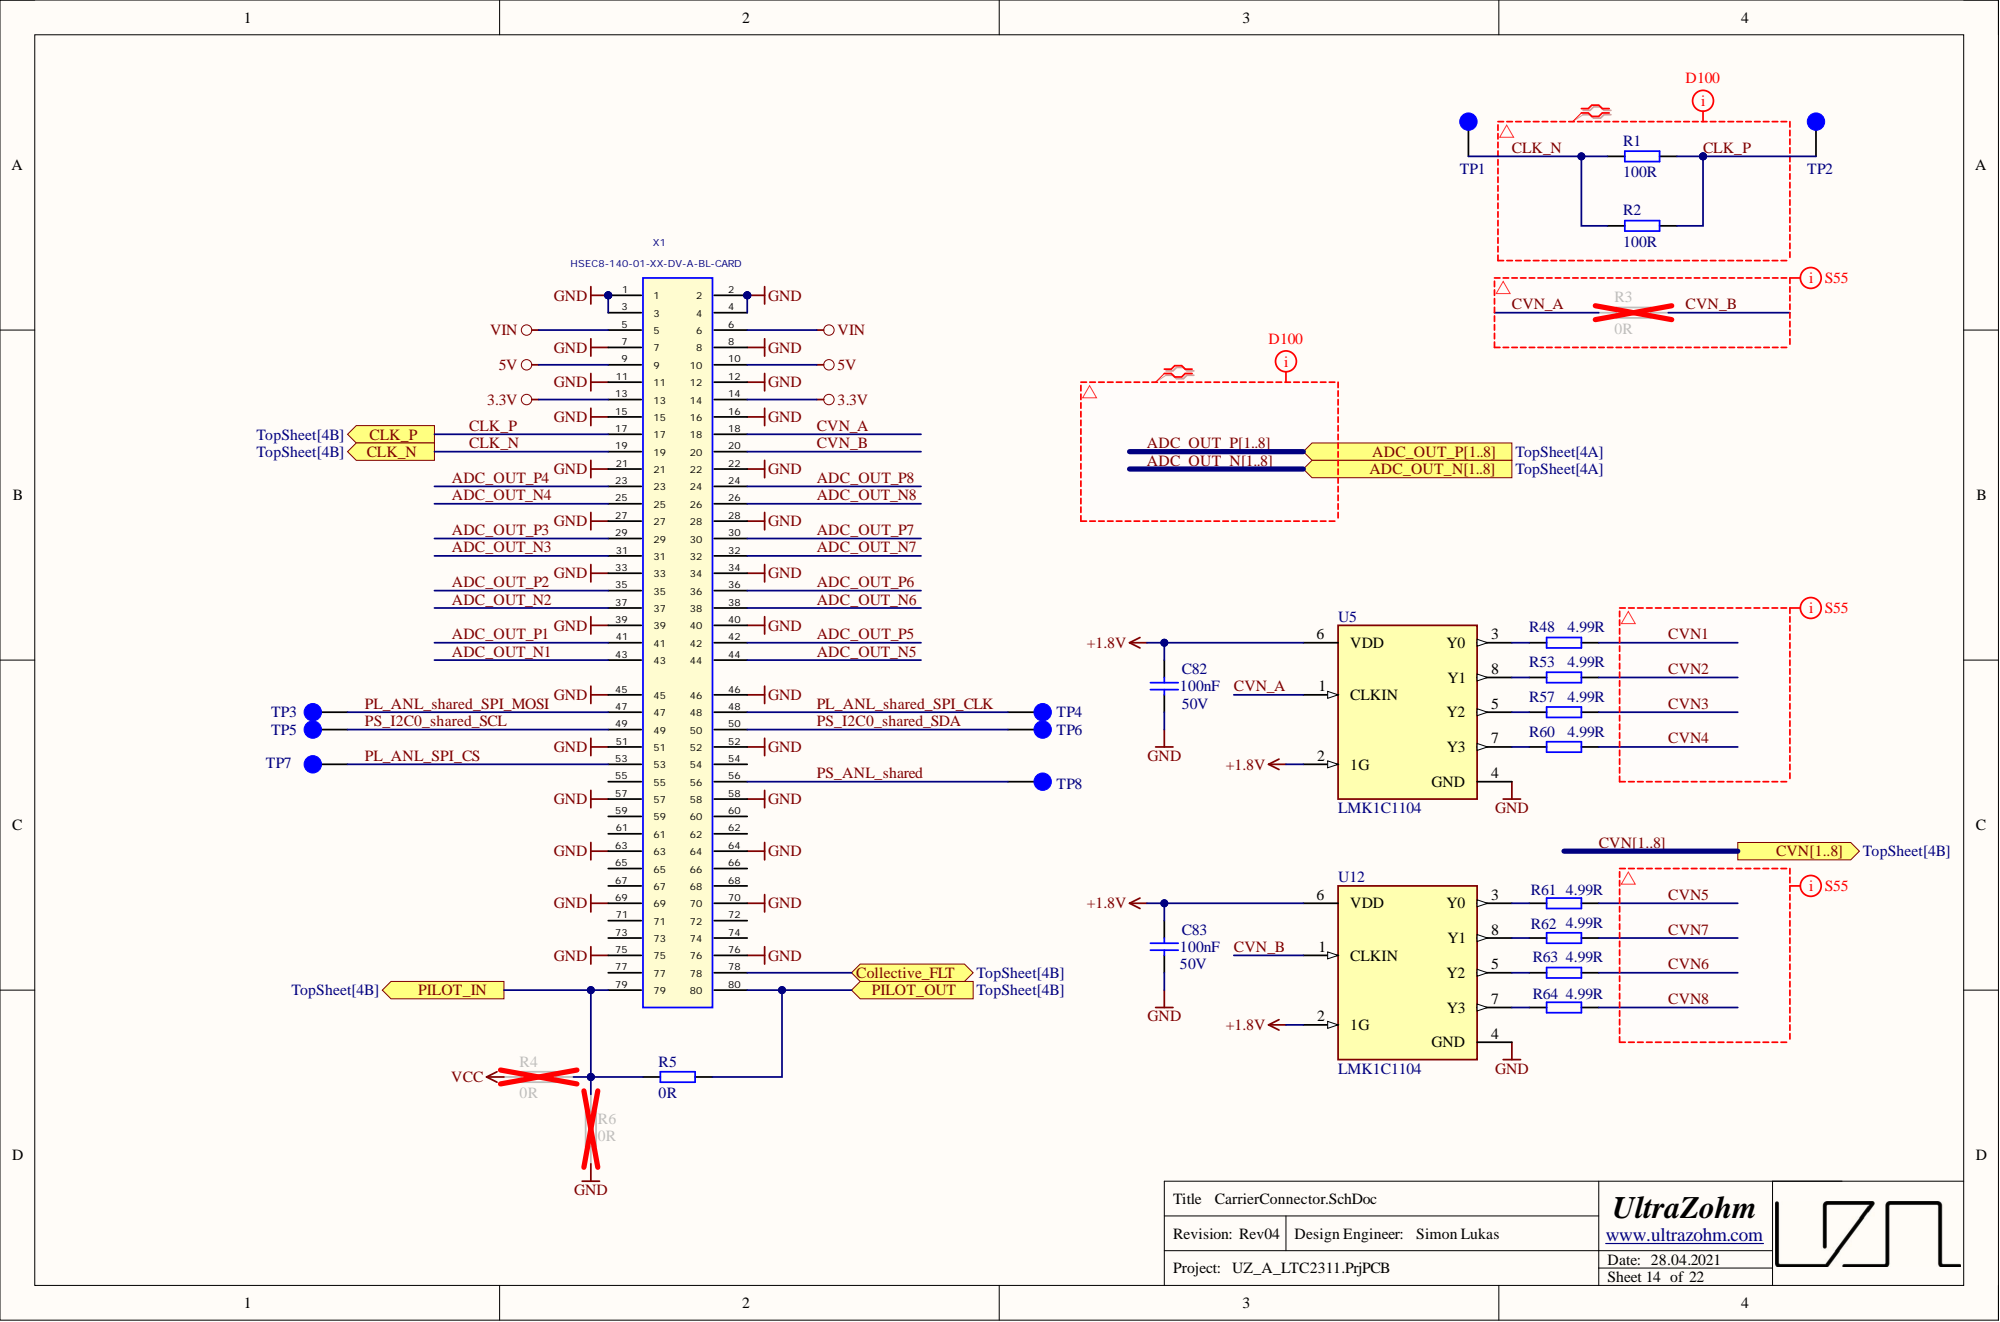
[picture p97: page 20]

HSEC8-140-01-XX-DV-A-BL-CARD

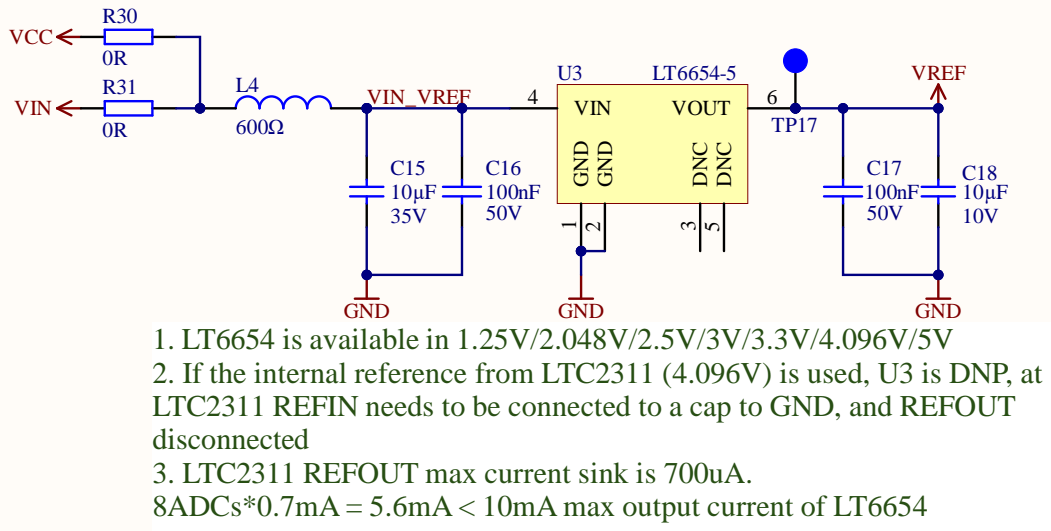
[picture p98: page 21]

max output current of

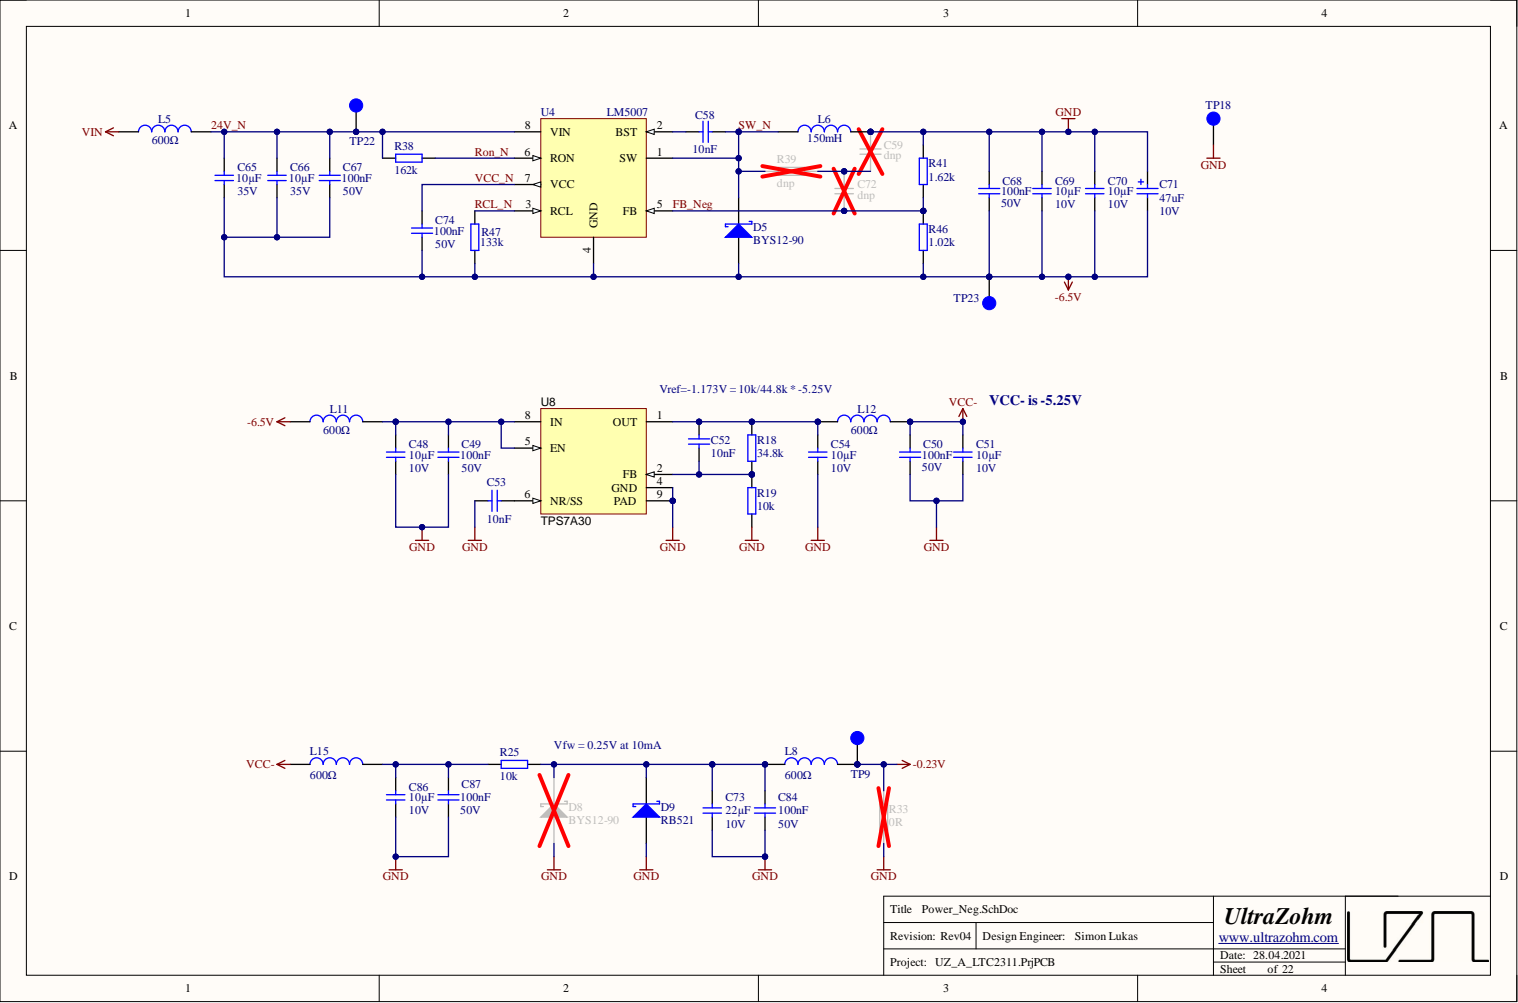
[picture p99: page 22]
