ultrazohm/uz_a_ltc2311-16/Bestuecker_Files/Rev.03/SCH_UltraZohm_ADC_3v03.pdf

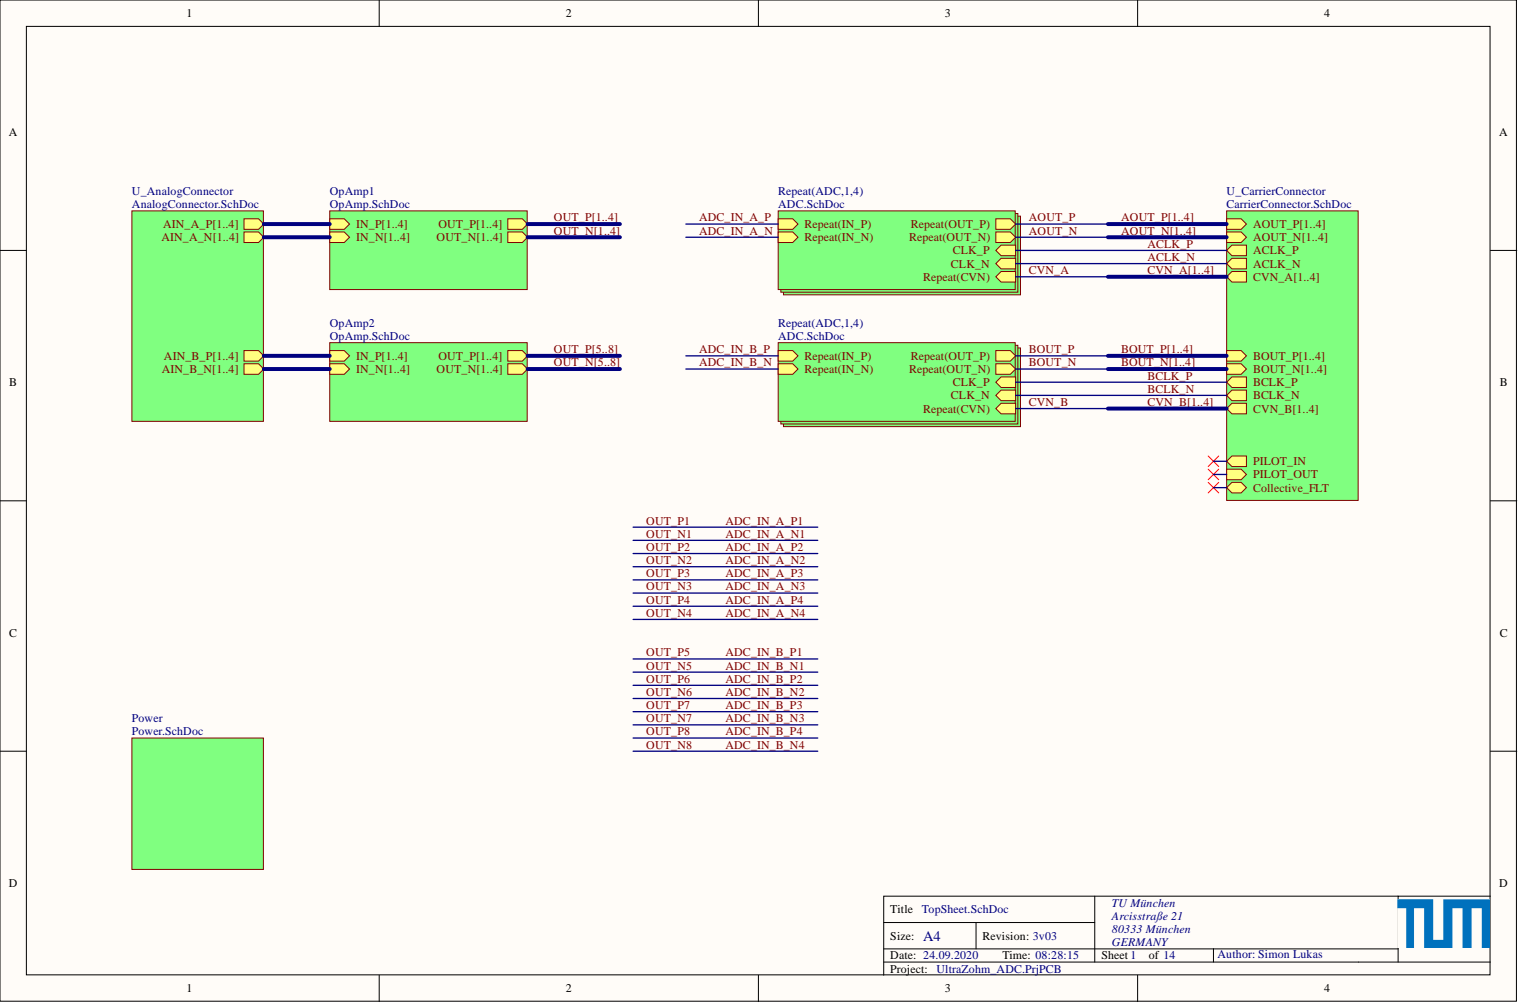
[picture p100: page 1]

Title TopSheet.SchDoc | TU München Arcisstraße 21 80333 München GERMANY

Size: A4 | Revision: 3v03
Date: 24.09.2020 Time: 08:28:15 | Sheet of 14 | Author: Simon Lukas

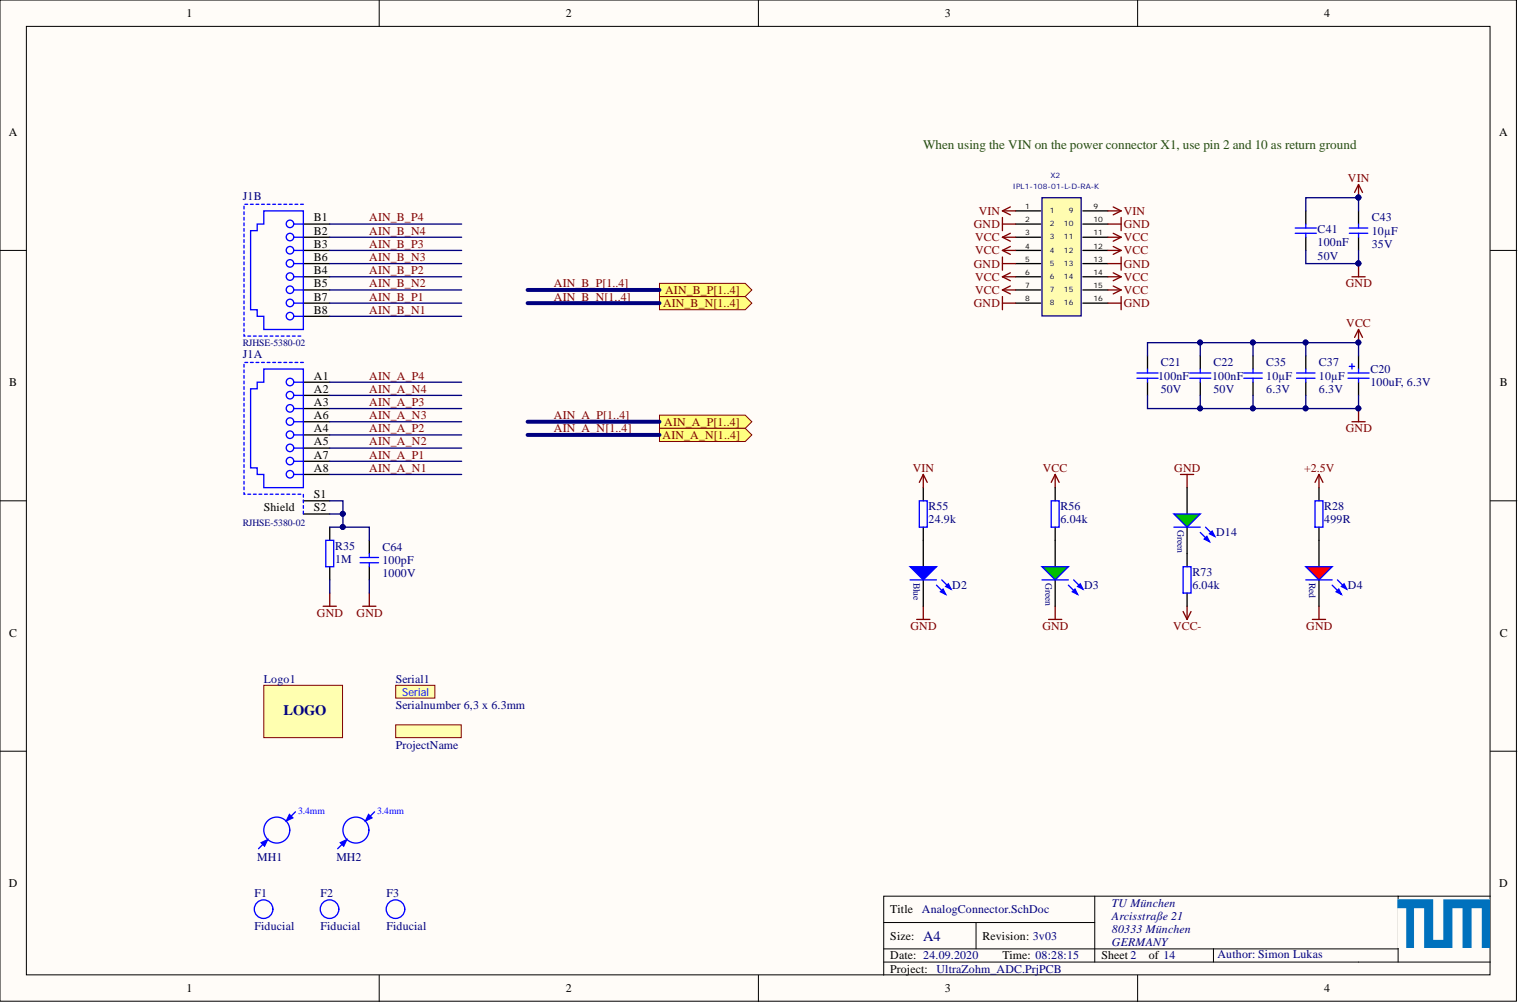
[picture p101: page 2]

When using the VIN on the power connector X1, use pin 2 and 10 as return ground

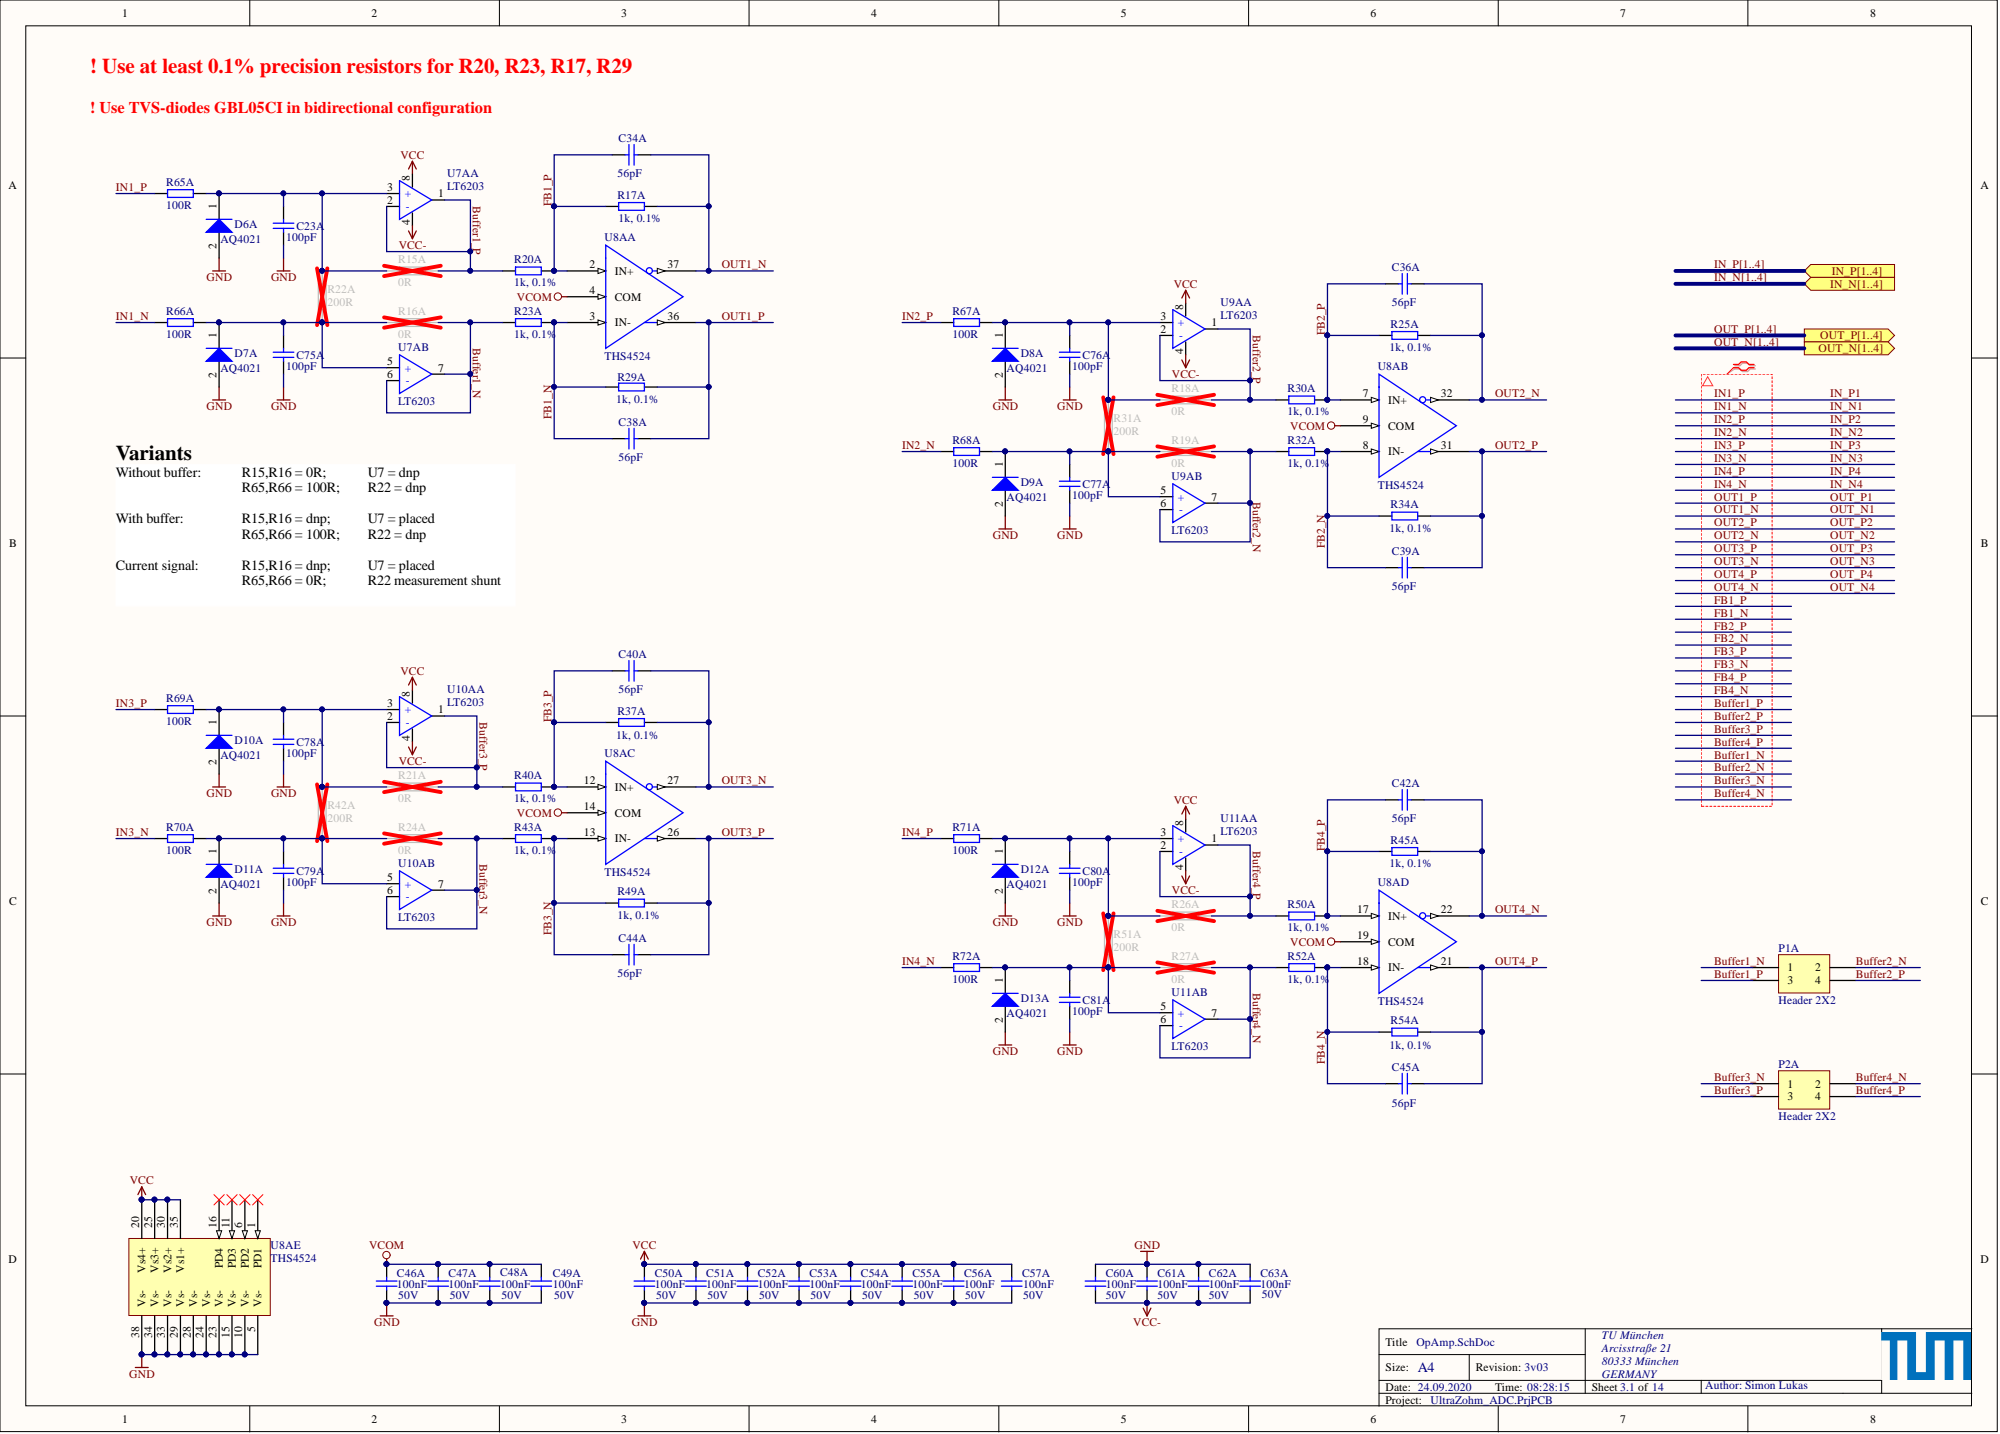
[picture p102: page 3]

! Use at least 0.1% precision resistors fo

T i t l e O p Amp.Sch D o c | TU M ü nchen A rci s s t r aße 2 3 M ü nchen G ER MANY

A | Rev i s i o n : v

T ime: : : | Sheet o f | A u t h or: Simo n L u kas

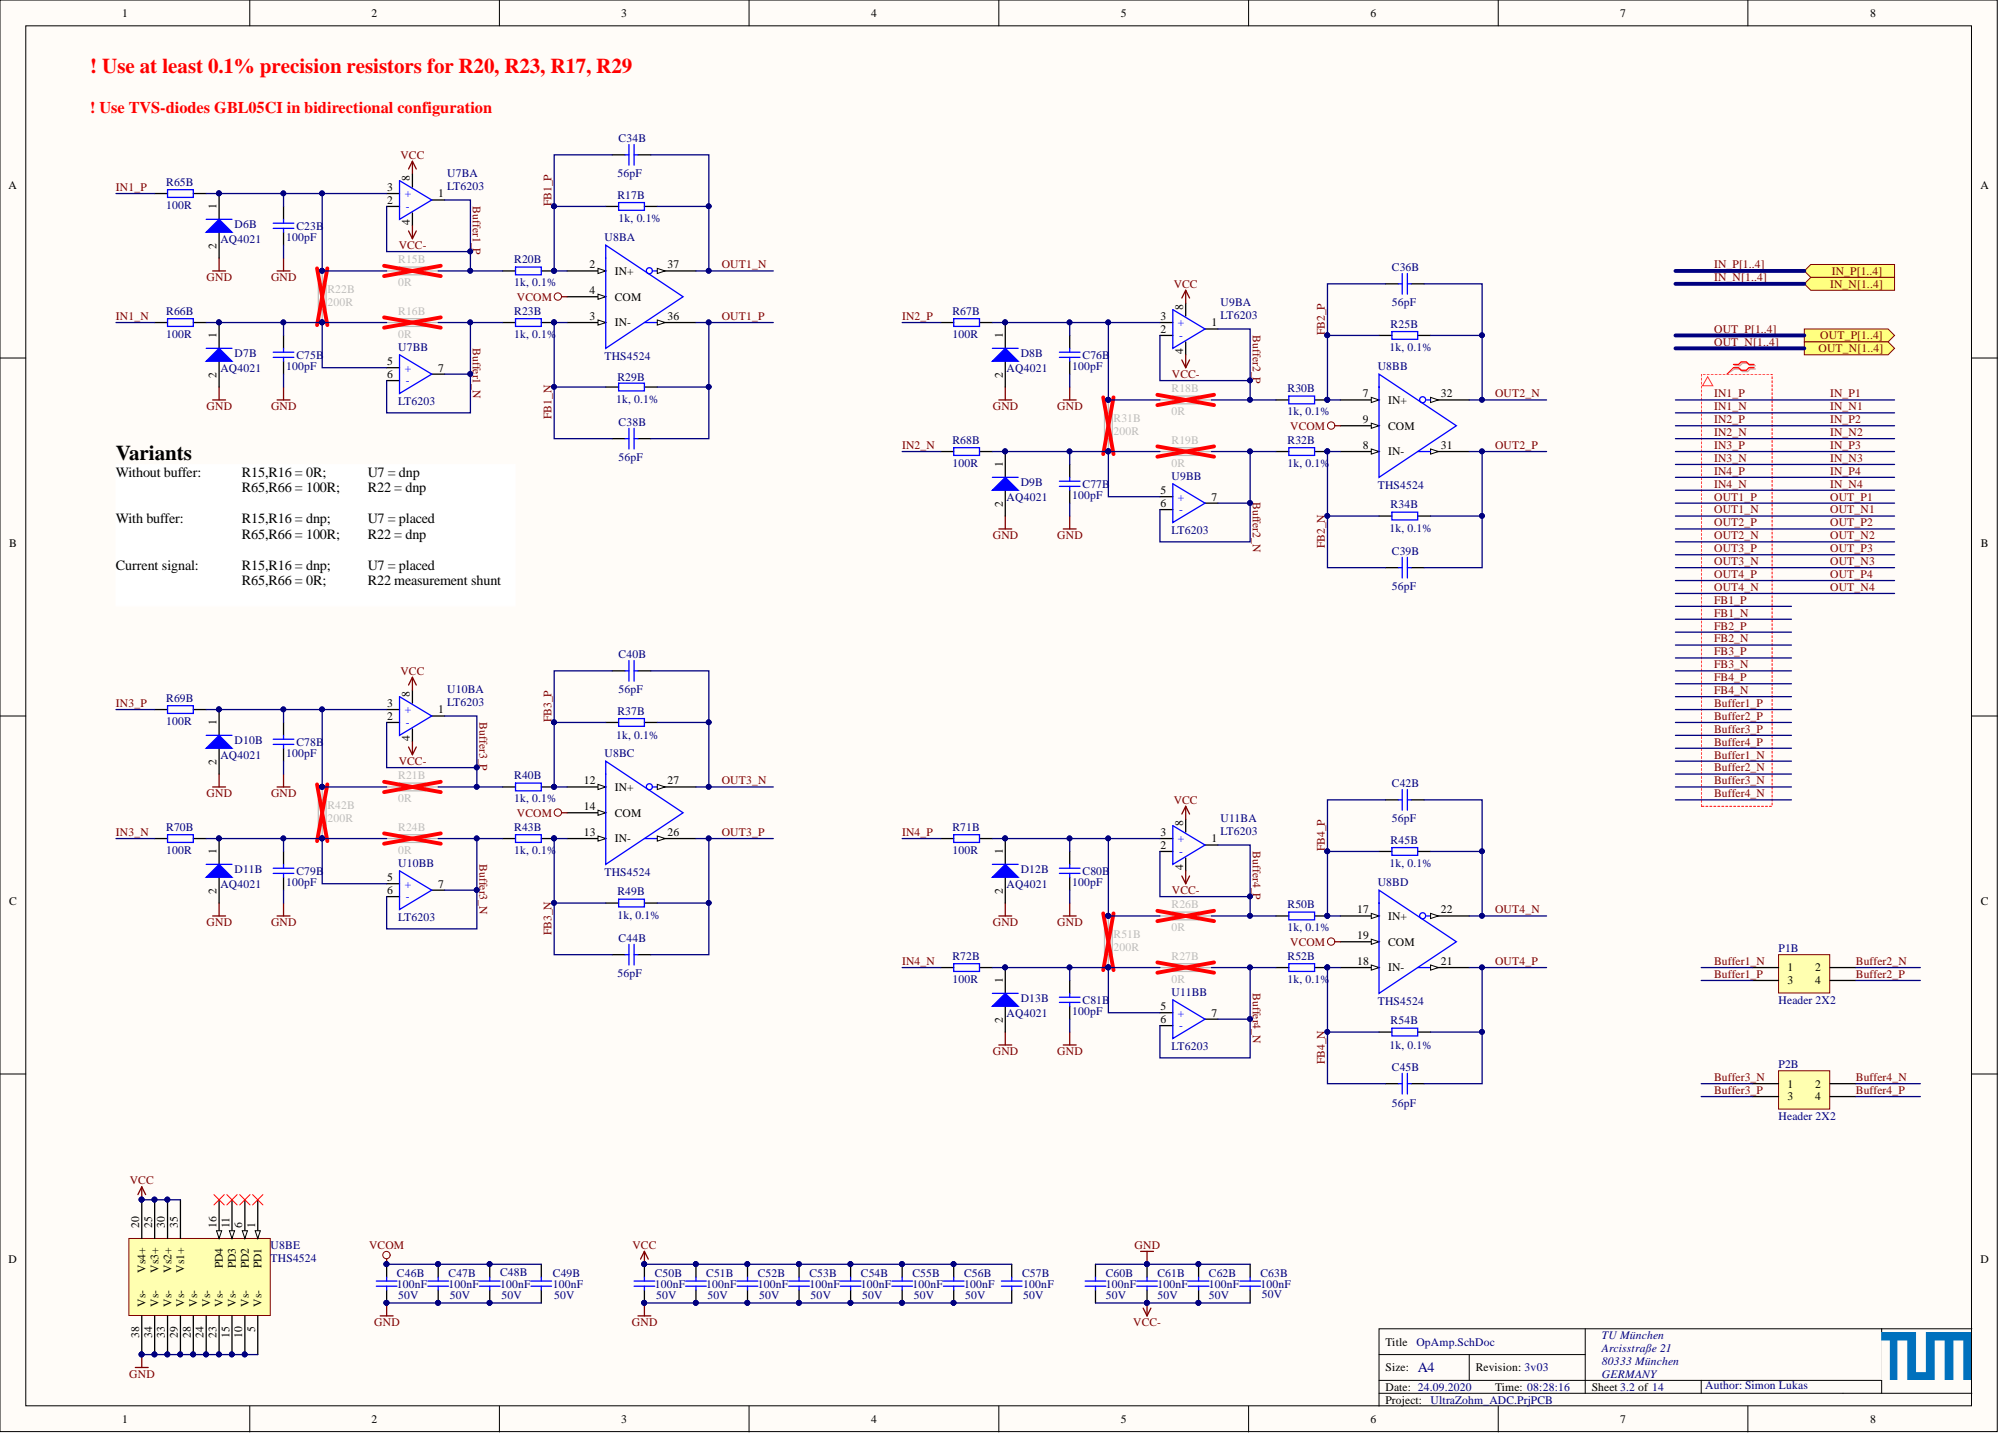
[picture p103: page 4]

! Use at least 0.1% precision resistors fo

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

A | Rev i s i o n : v

T ime: : : | Sheet o f | A u t h or: Simo n L u kas

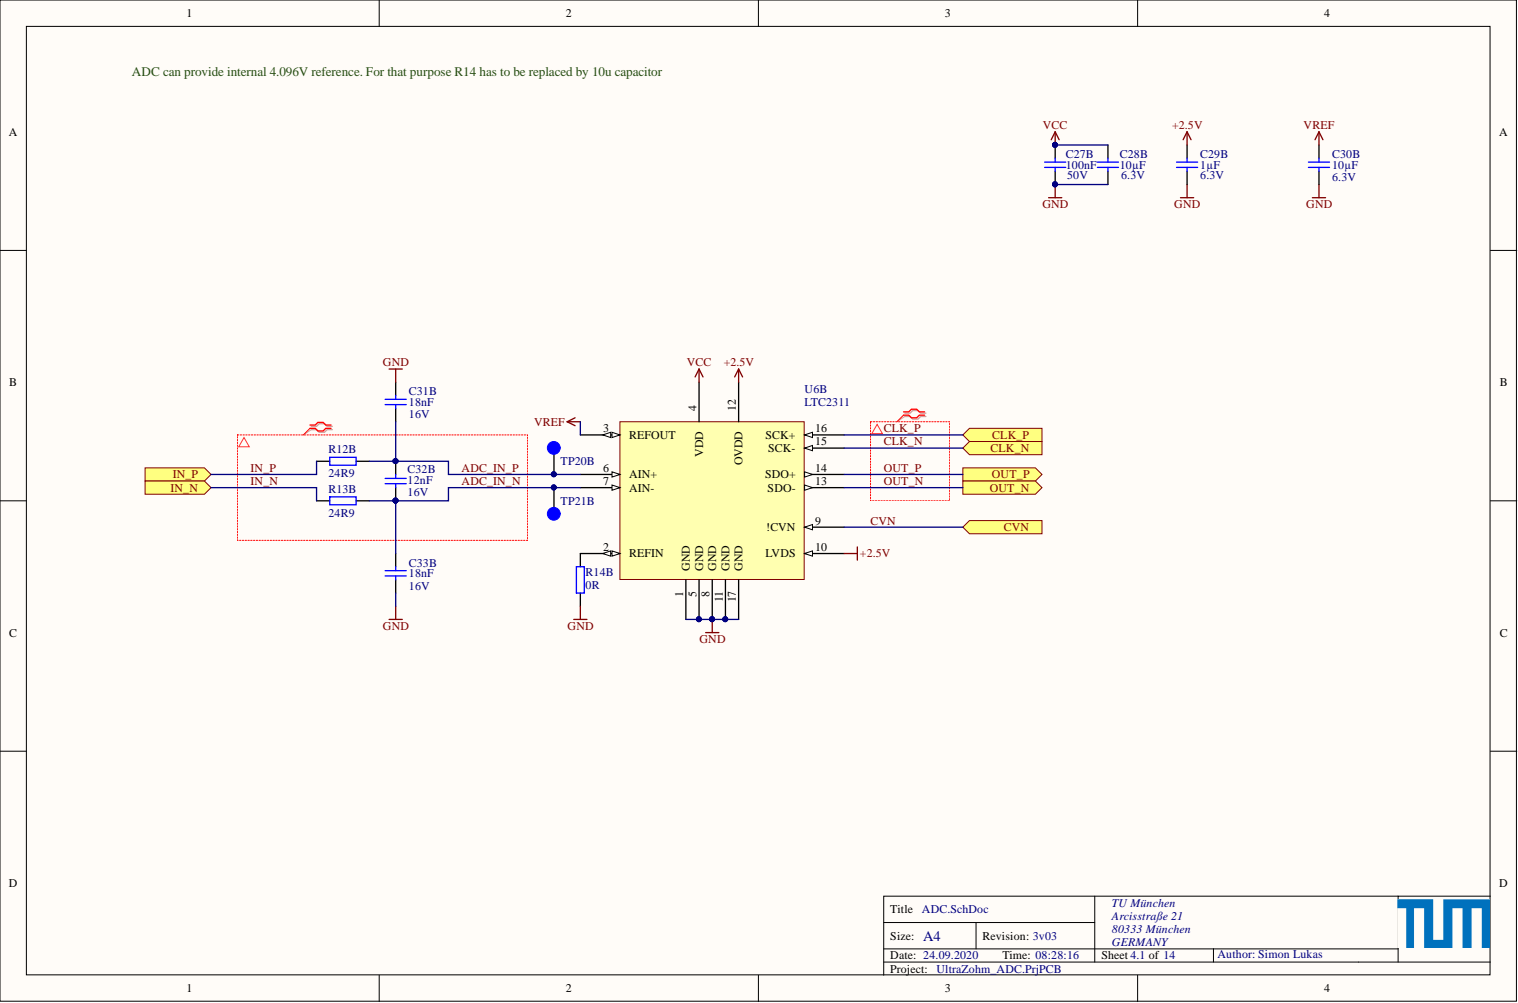
[picture p104: page 5]

ADC can provide internal 4.096V reference. For that purpose R14 has to be replaced by 10u capacitor

IN_P
IN_N ADC_IN_N | | AIN- 7

16V | | | REFIN 2

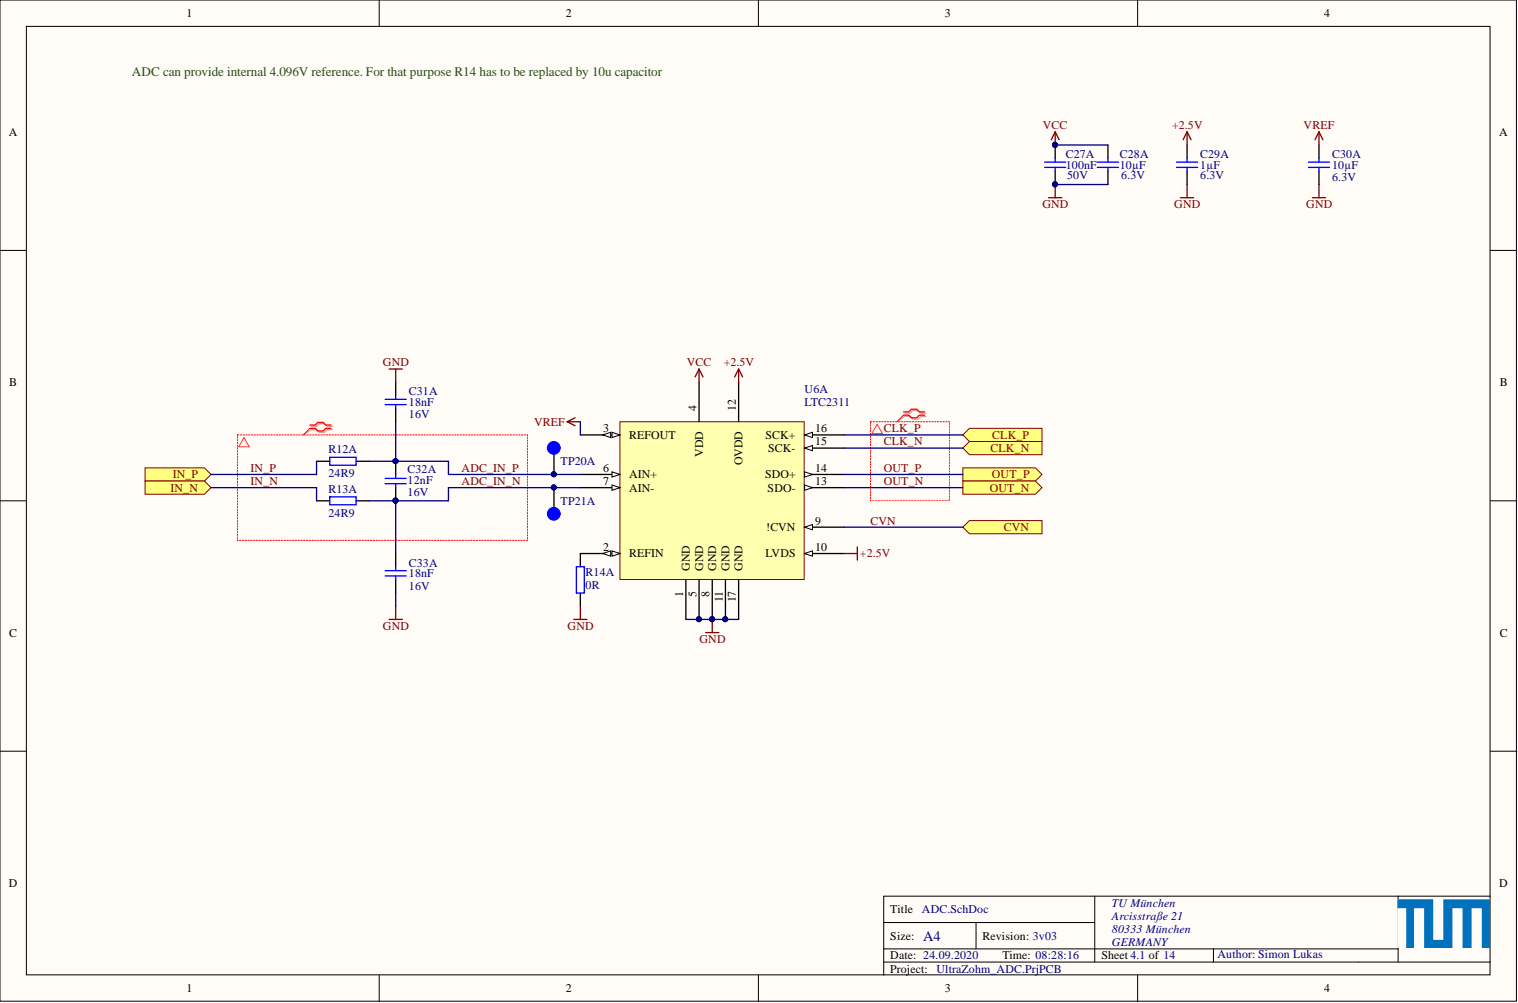
[picture p105: page 6]

IN_P
IN_N ADC_IN_N | | AIN- 7

16V | | | REFIN 2

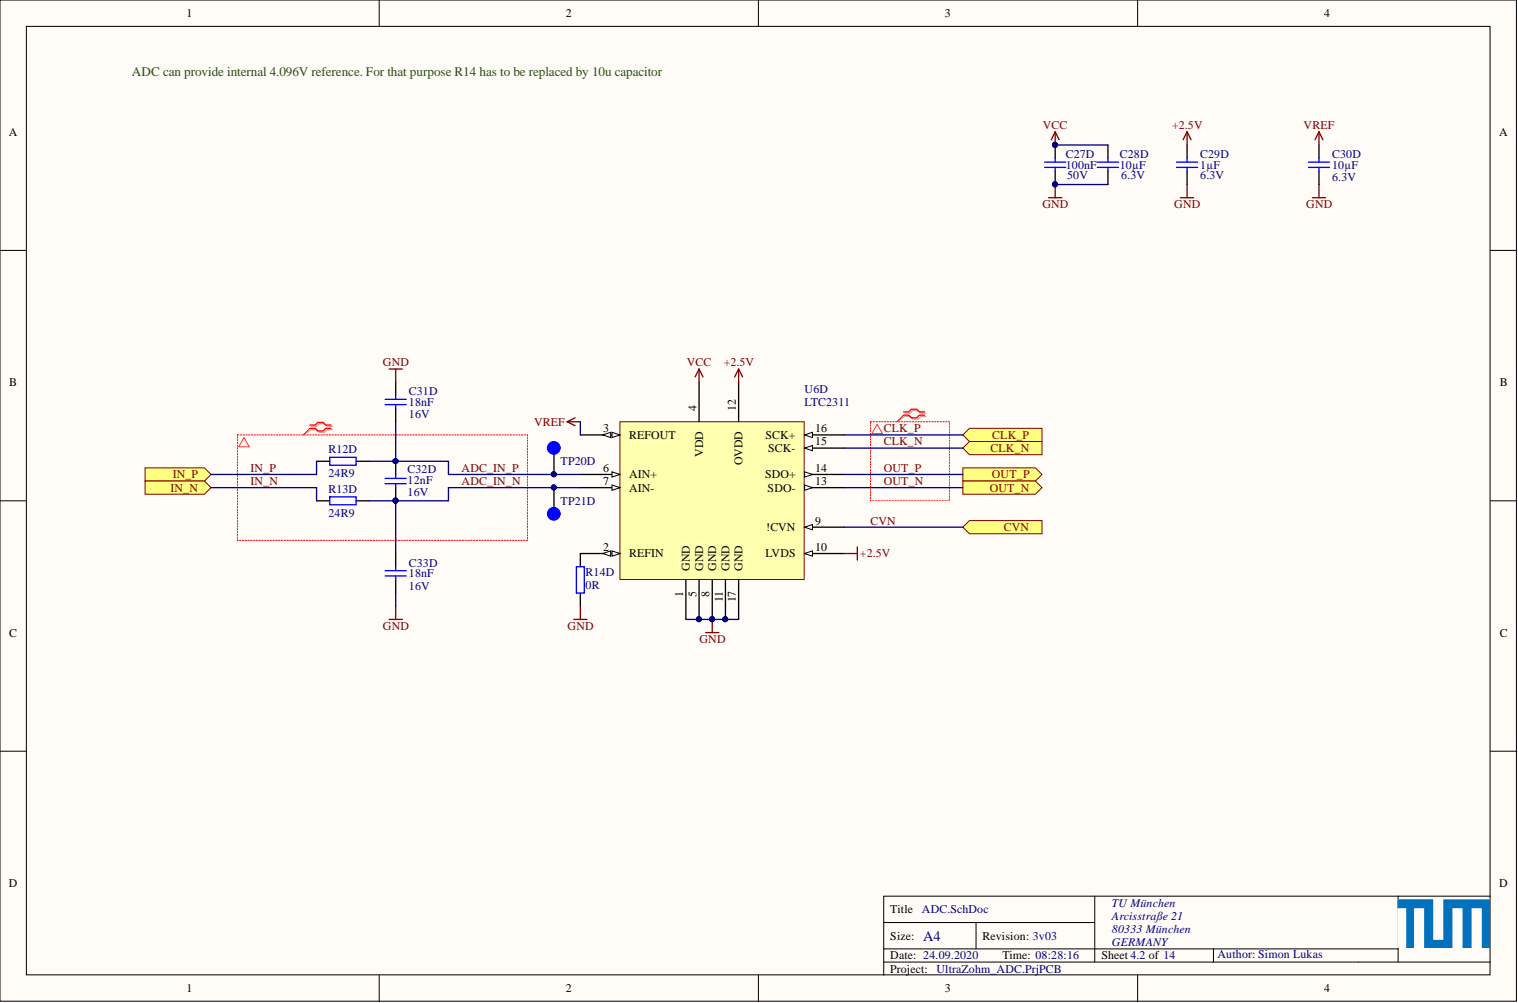
[picture p106: page 7]

IN_P
IN_N ADC_IN_N | | AIN- 7

16V | | | REFIN 2

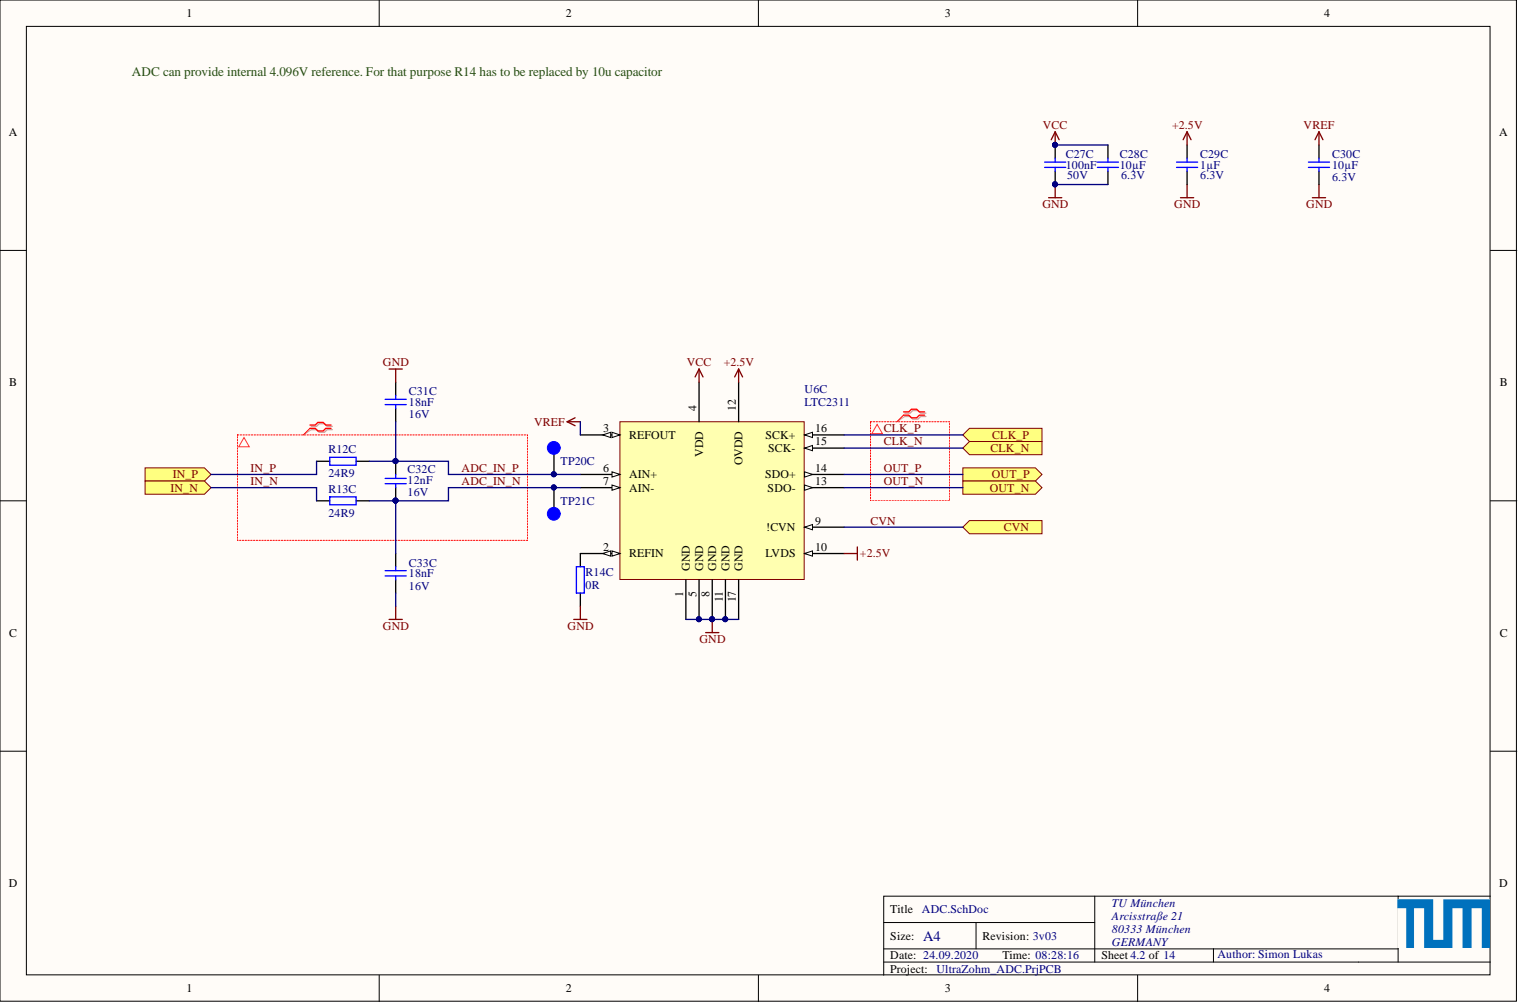
[picture p107: page 8]

IN_P
IN_N ADC_IN_N | | AIN- 7

16V | | | REFIN 2

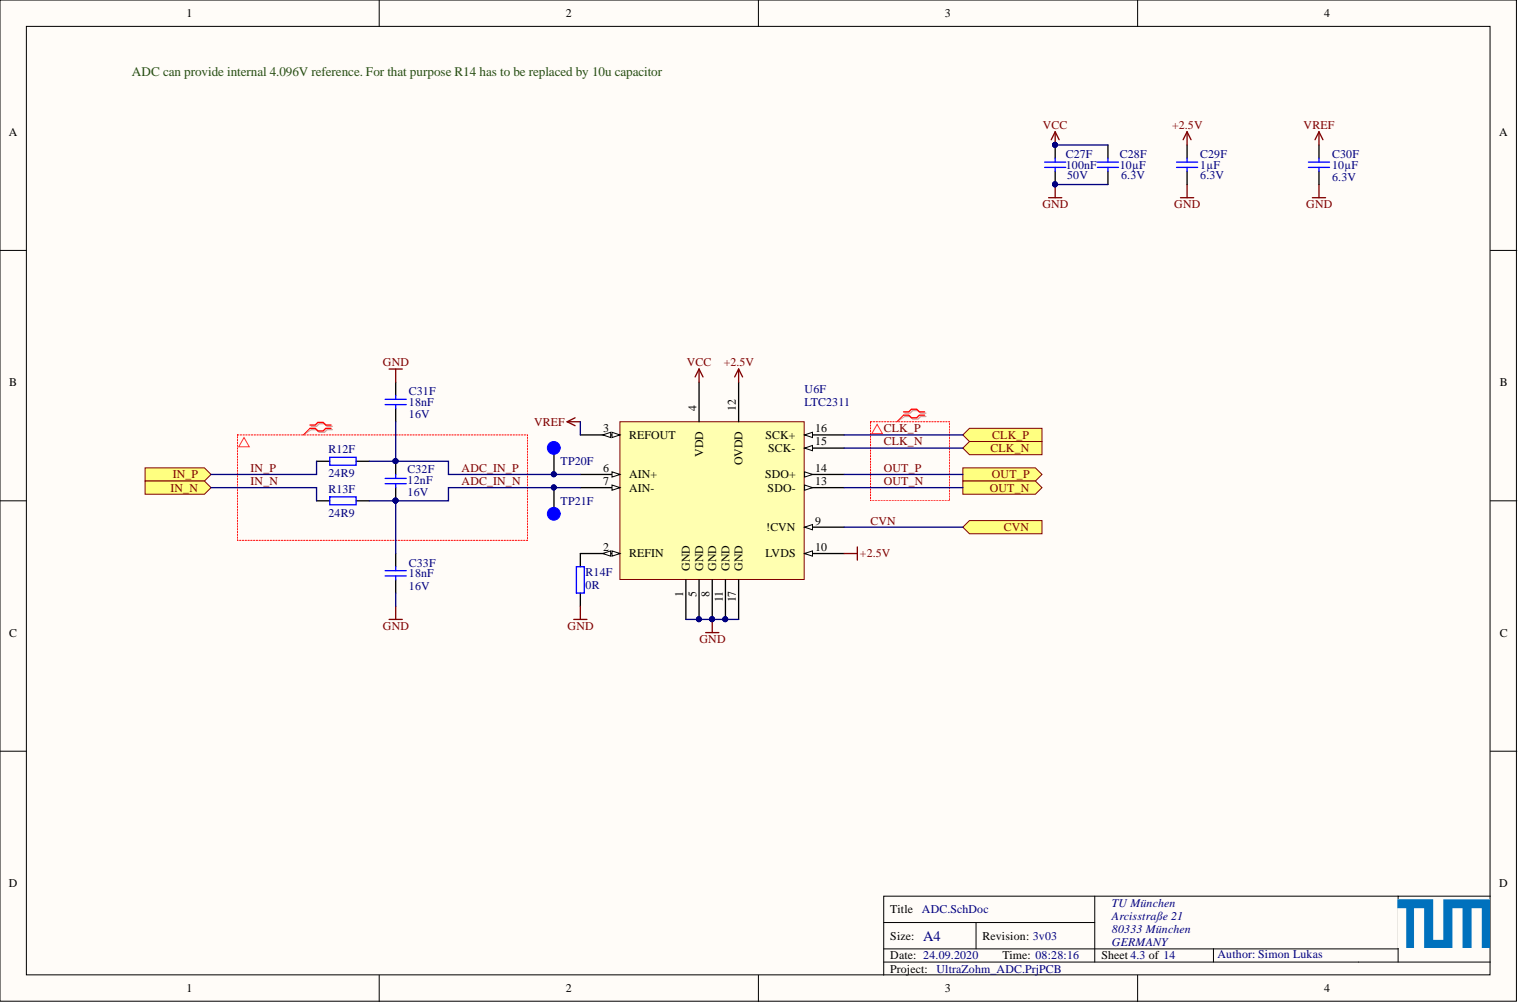
[picture p108: page 9]

IN_P
IN_N ADC_IN_N | | AIN- 7

16V | | | REFIN 2

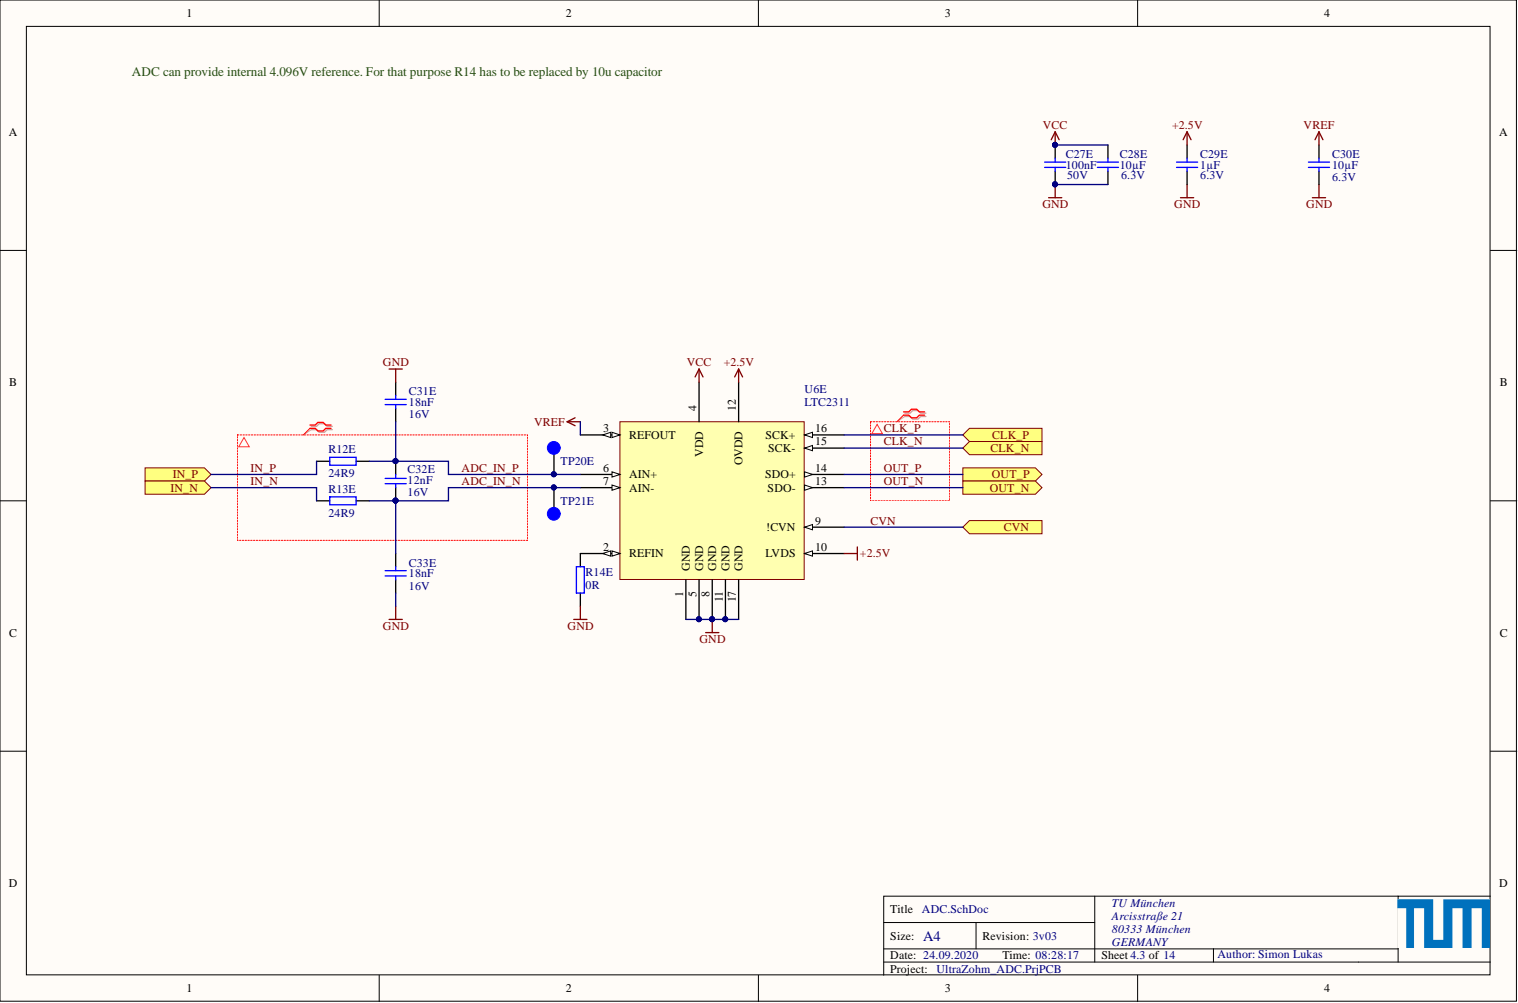
[picture p109: page 10]

IN_P
IN_N ADC_IN_N | | AIN- 7

16V | | | REFIN 2

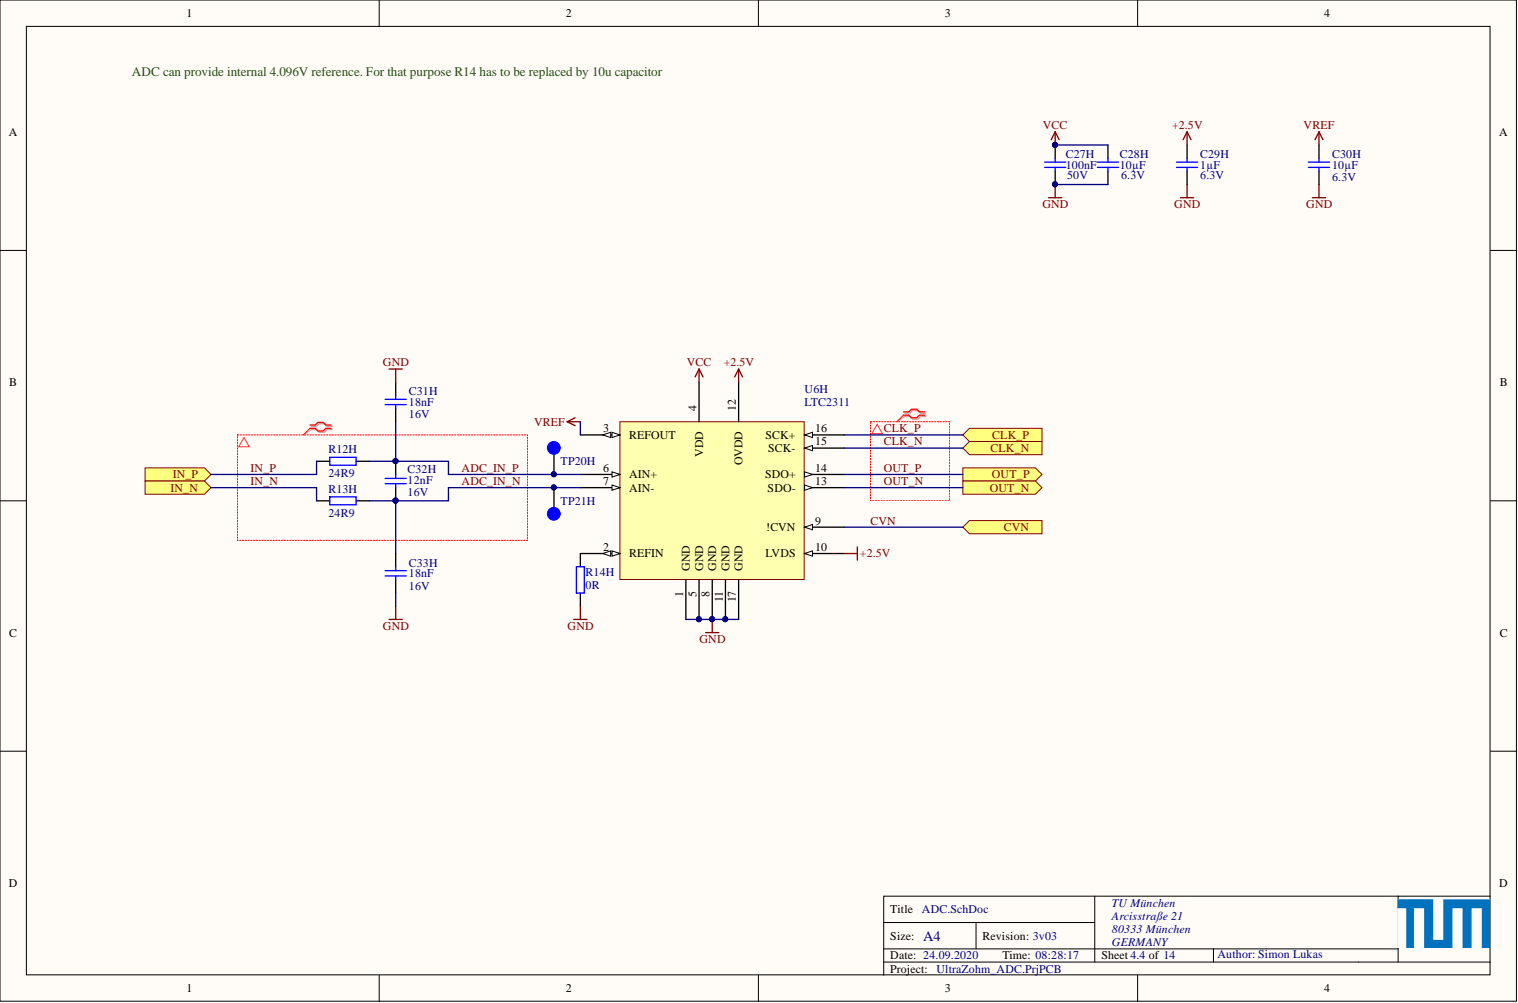
[picture p110: page 11]

IN_P
IN_N ADC_IN_N | | AIN- 7

16V | | | REFIN 2

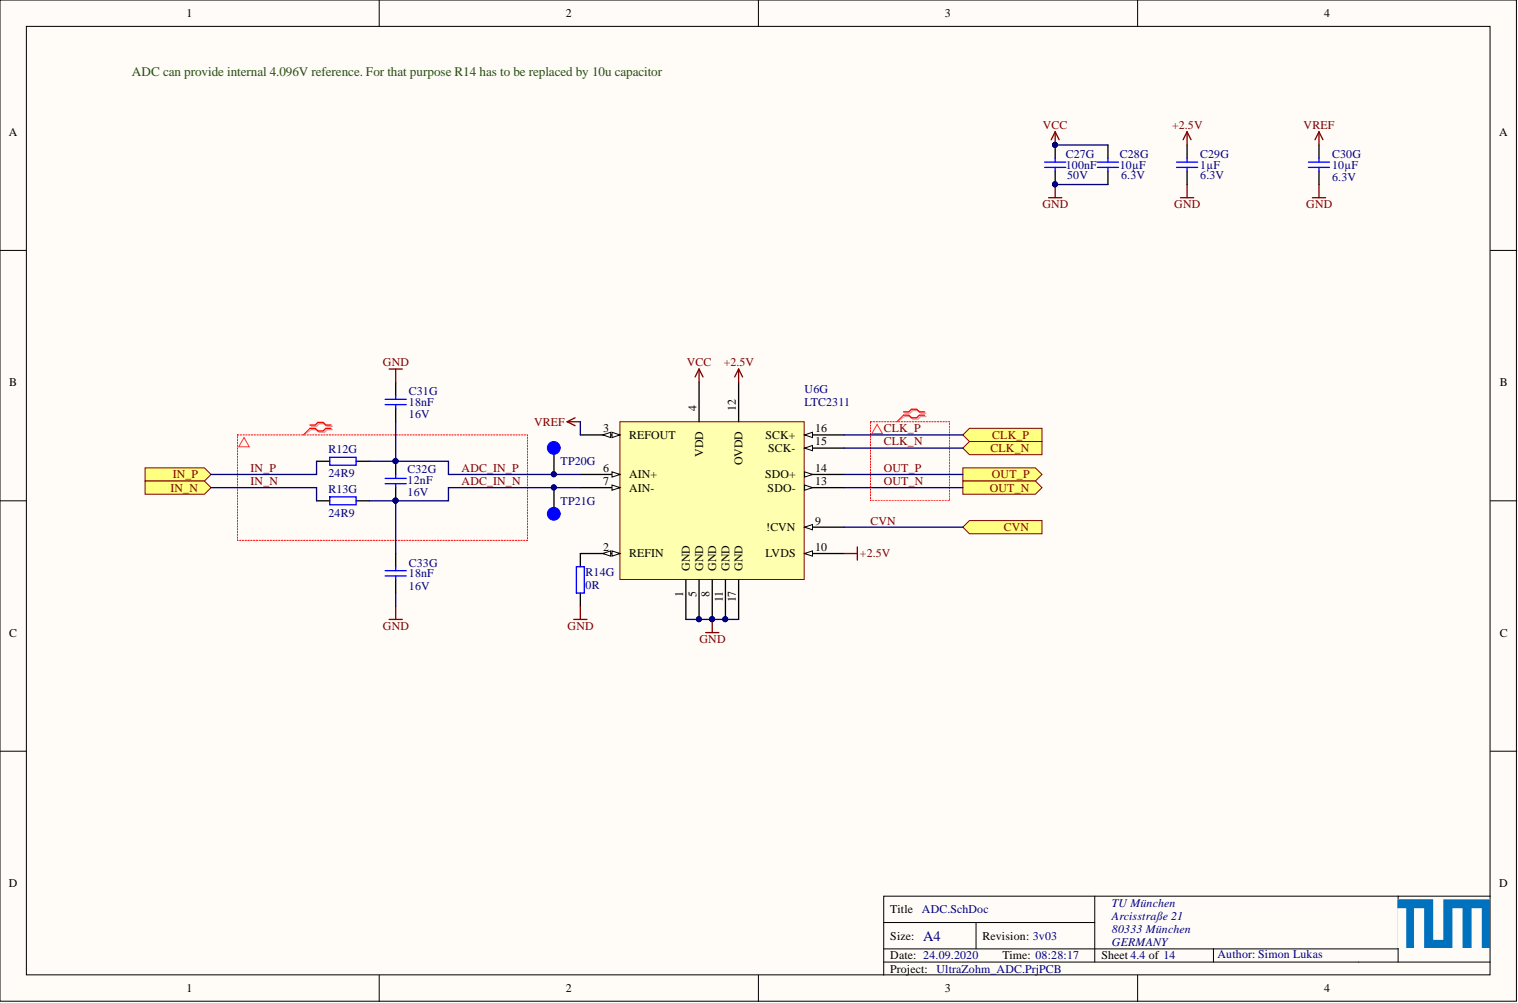
[picture p111: page 12]

IN_P
IN_N ADC_IN_N | | AIN- 7

16V | | | REFIN 2

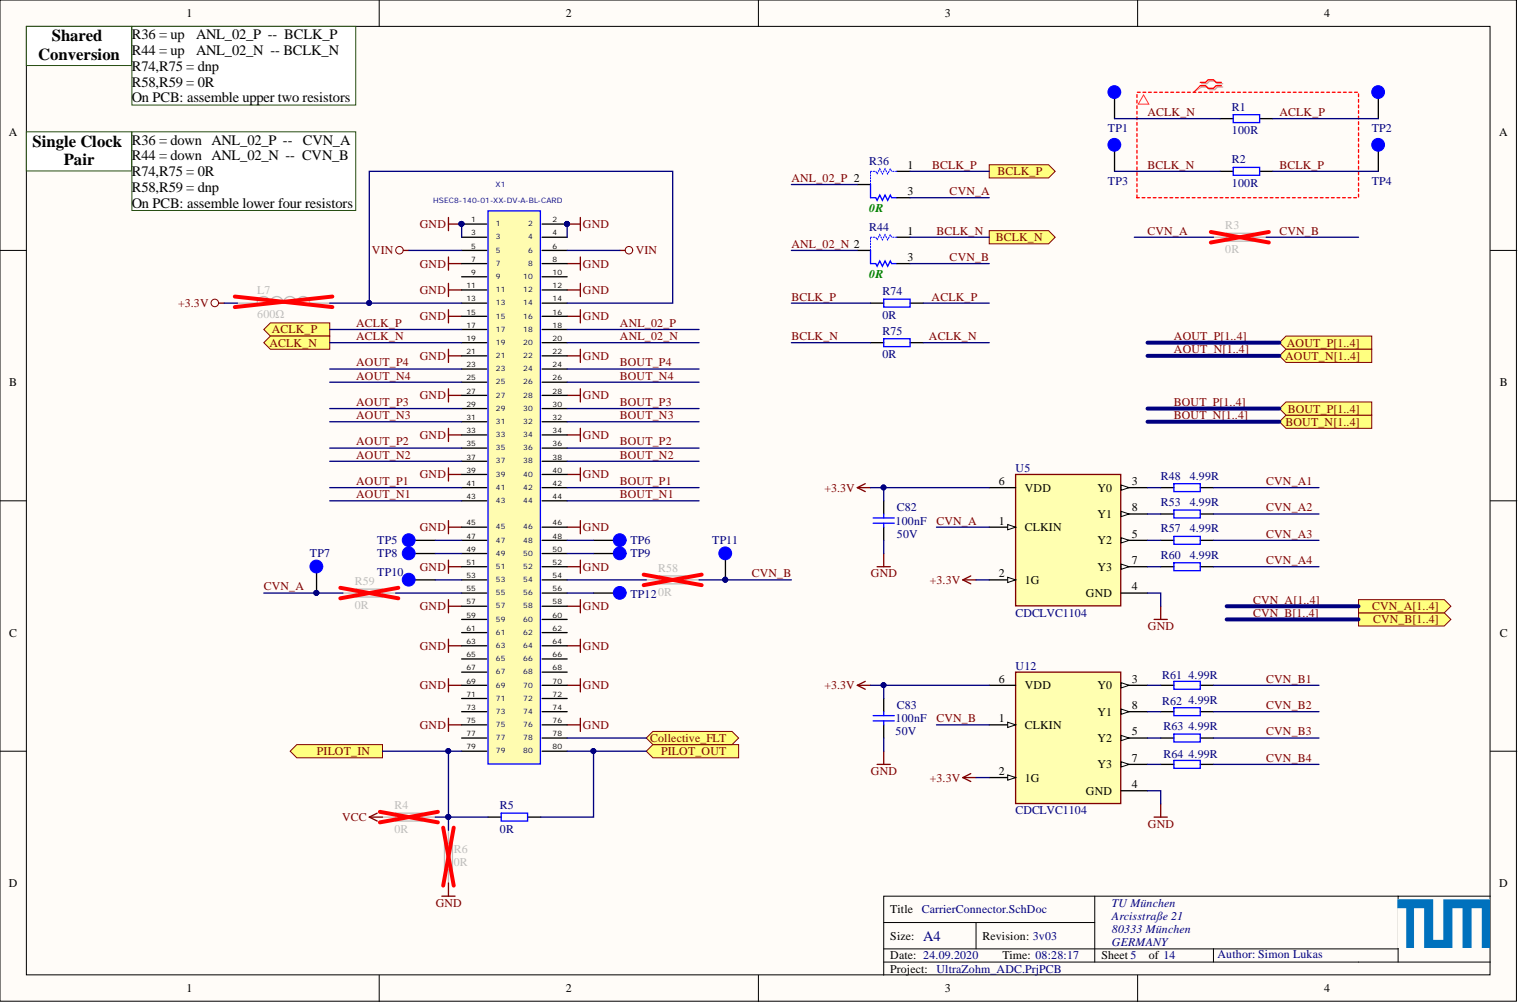
[picture p112: page 13]

HSEC8-140-01-XX-DV-A-BL-CARD

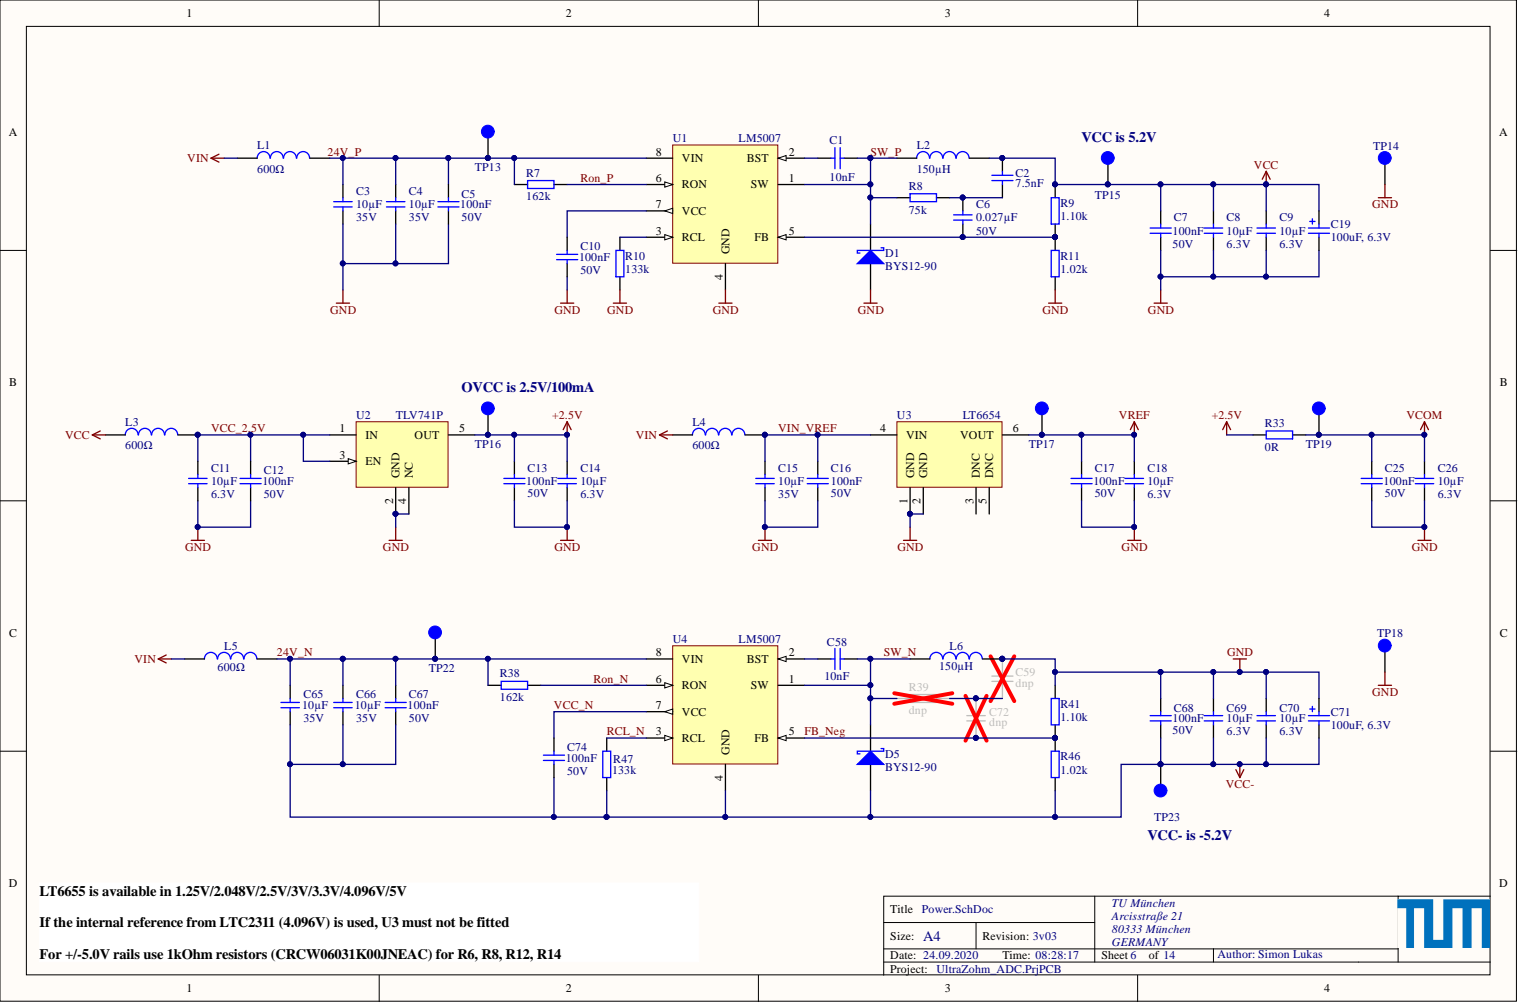
[picture p113: page 14]

If the internal reference from LTC2311 (4.096V) is used, U3 must not be fitted

For +/-5.0V rails use 1kOhm resistors (CRCW06031K00JNEAC) for R6, R8, R12, R14
