ultrazohm/uz_a_ltc2311-16/Project Outputs for UZ_A_LTC2311/Rev07/ASM_UZ_A_LTC2311_Standard_Rev07.PDF

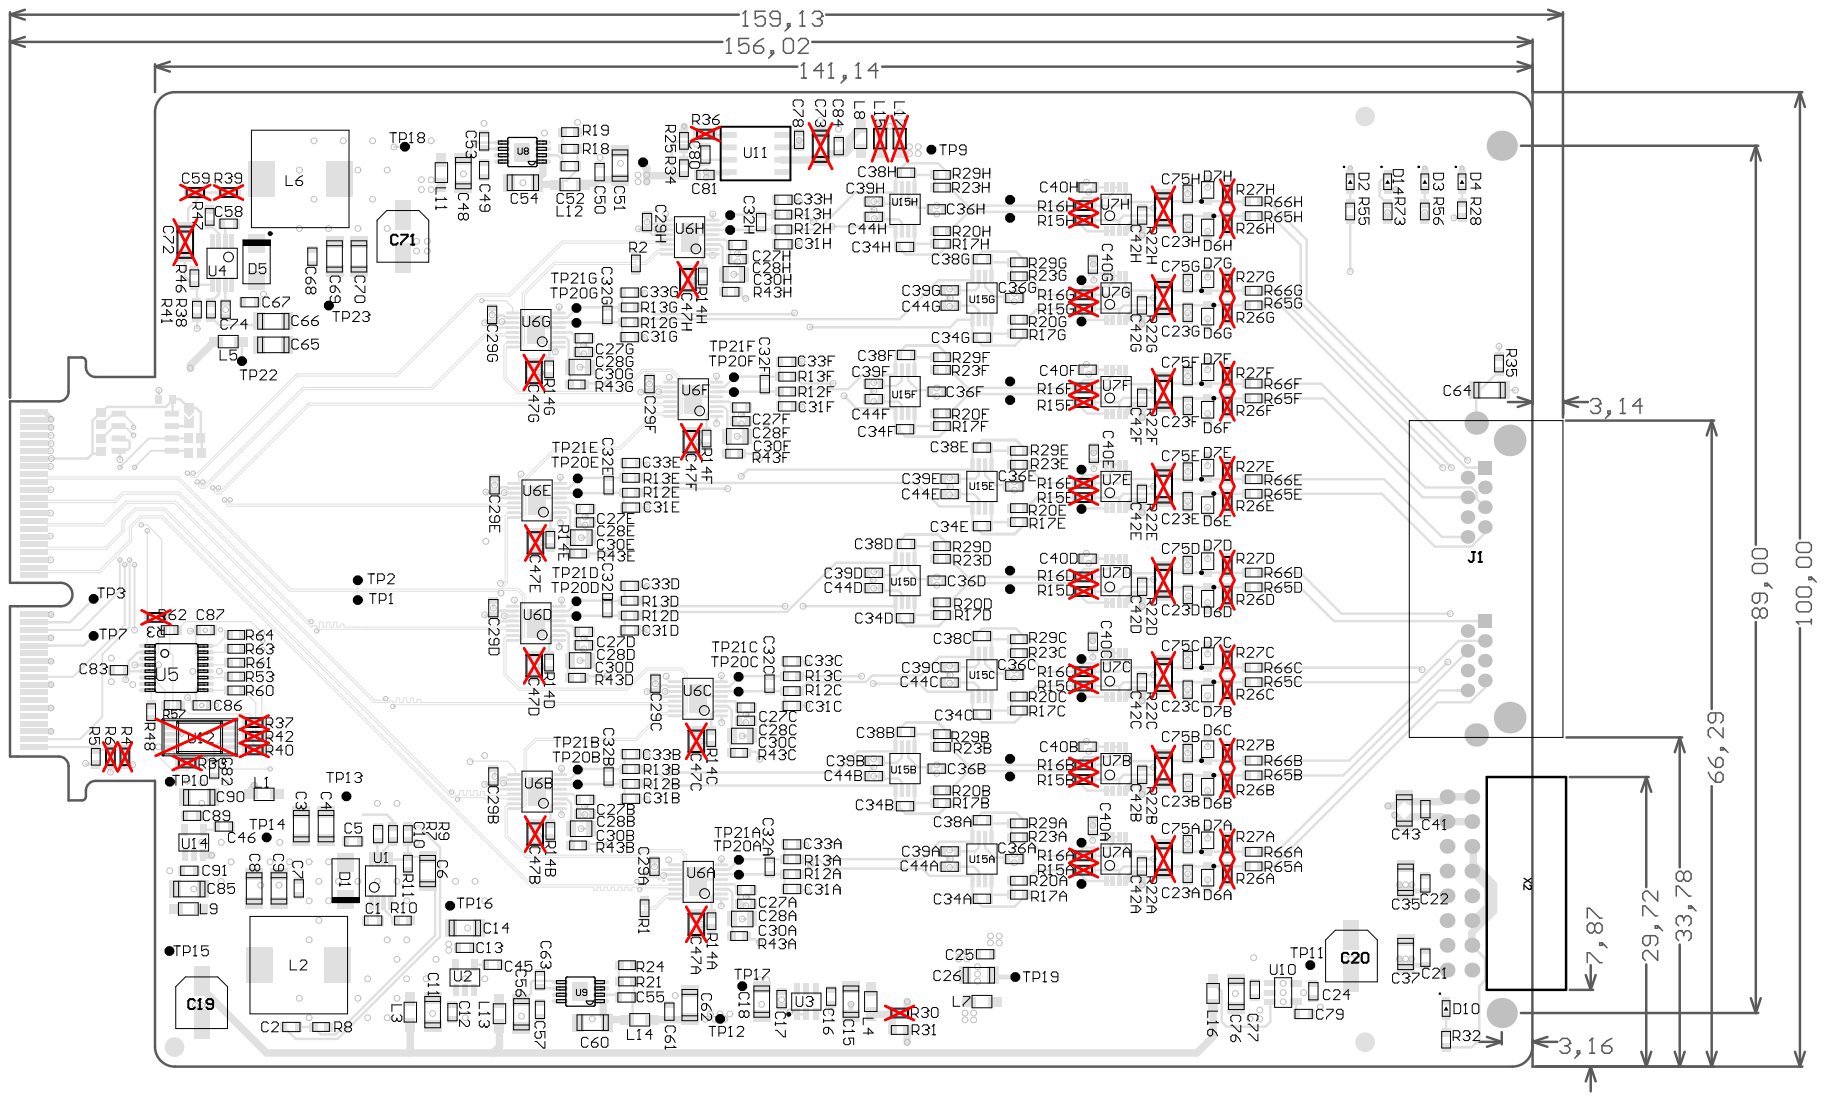
[picture p114: page 1]

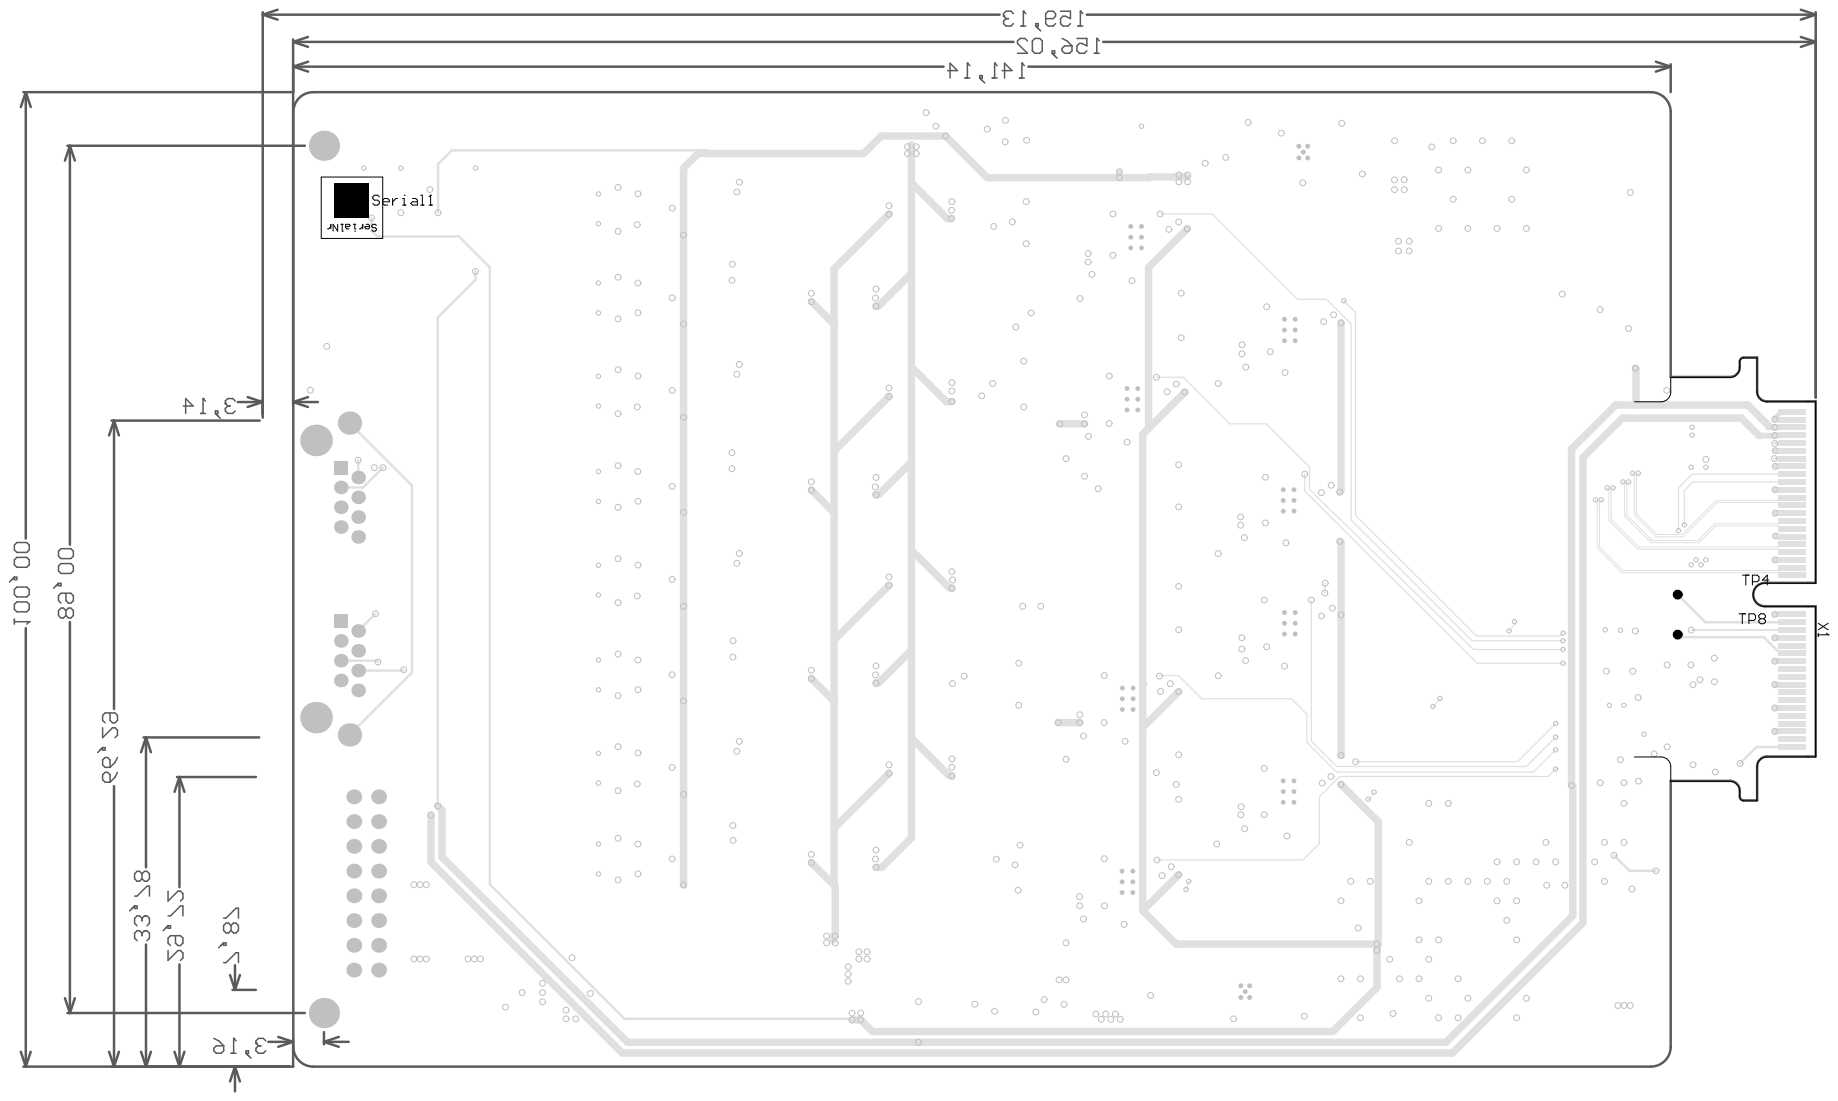
[picture p115: page 2]
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
