ultrazohm/uz_a_ltc2311-16/Bestuecker_Files/Rev.05/ASM_UZ_A_LTC2311_Standard_Rev05.PDF

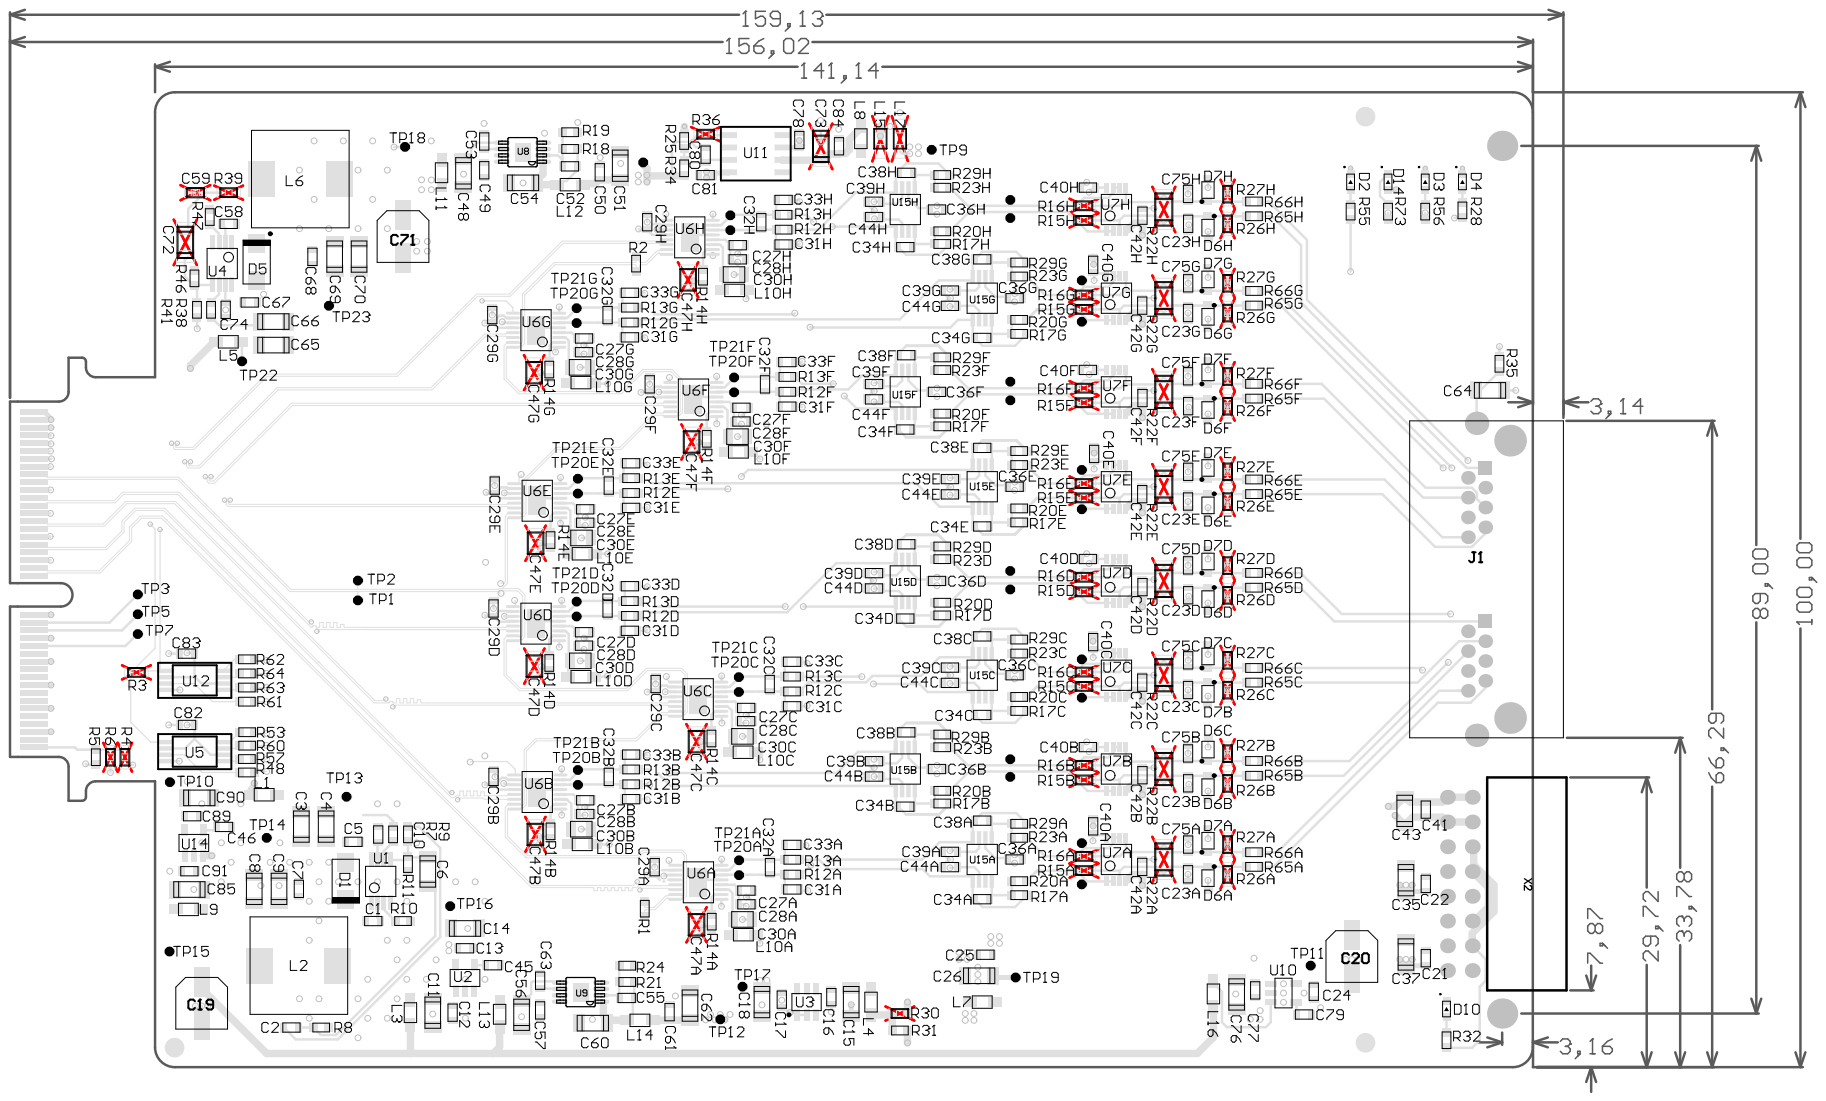
[picture p118: page 1]

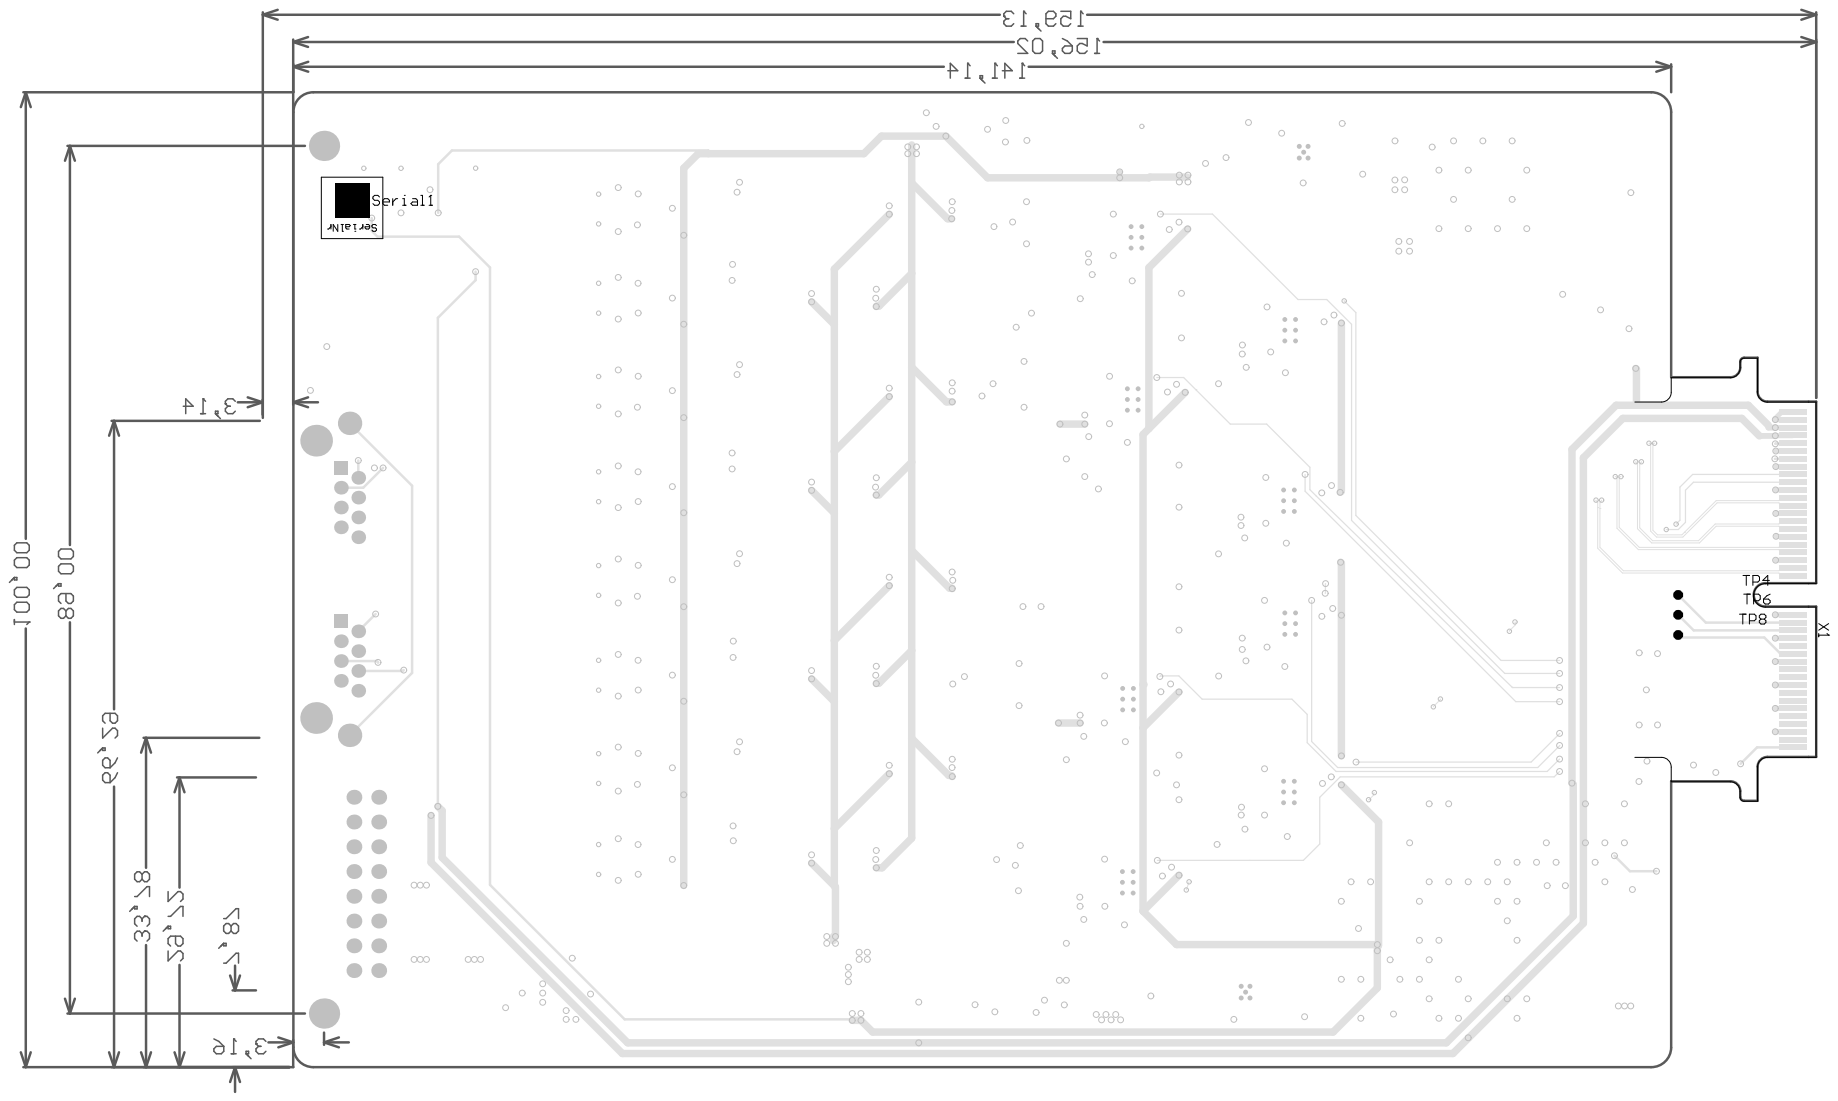
[picture p119: page 2]
