ultrazohm/uz_a_ltc2311-16/Project Outputs for UZ_A_LTC2311/Rev04/ASM_UZ_A_LTC2311_Standard_Rev04.PDF

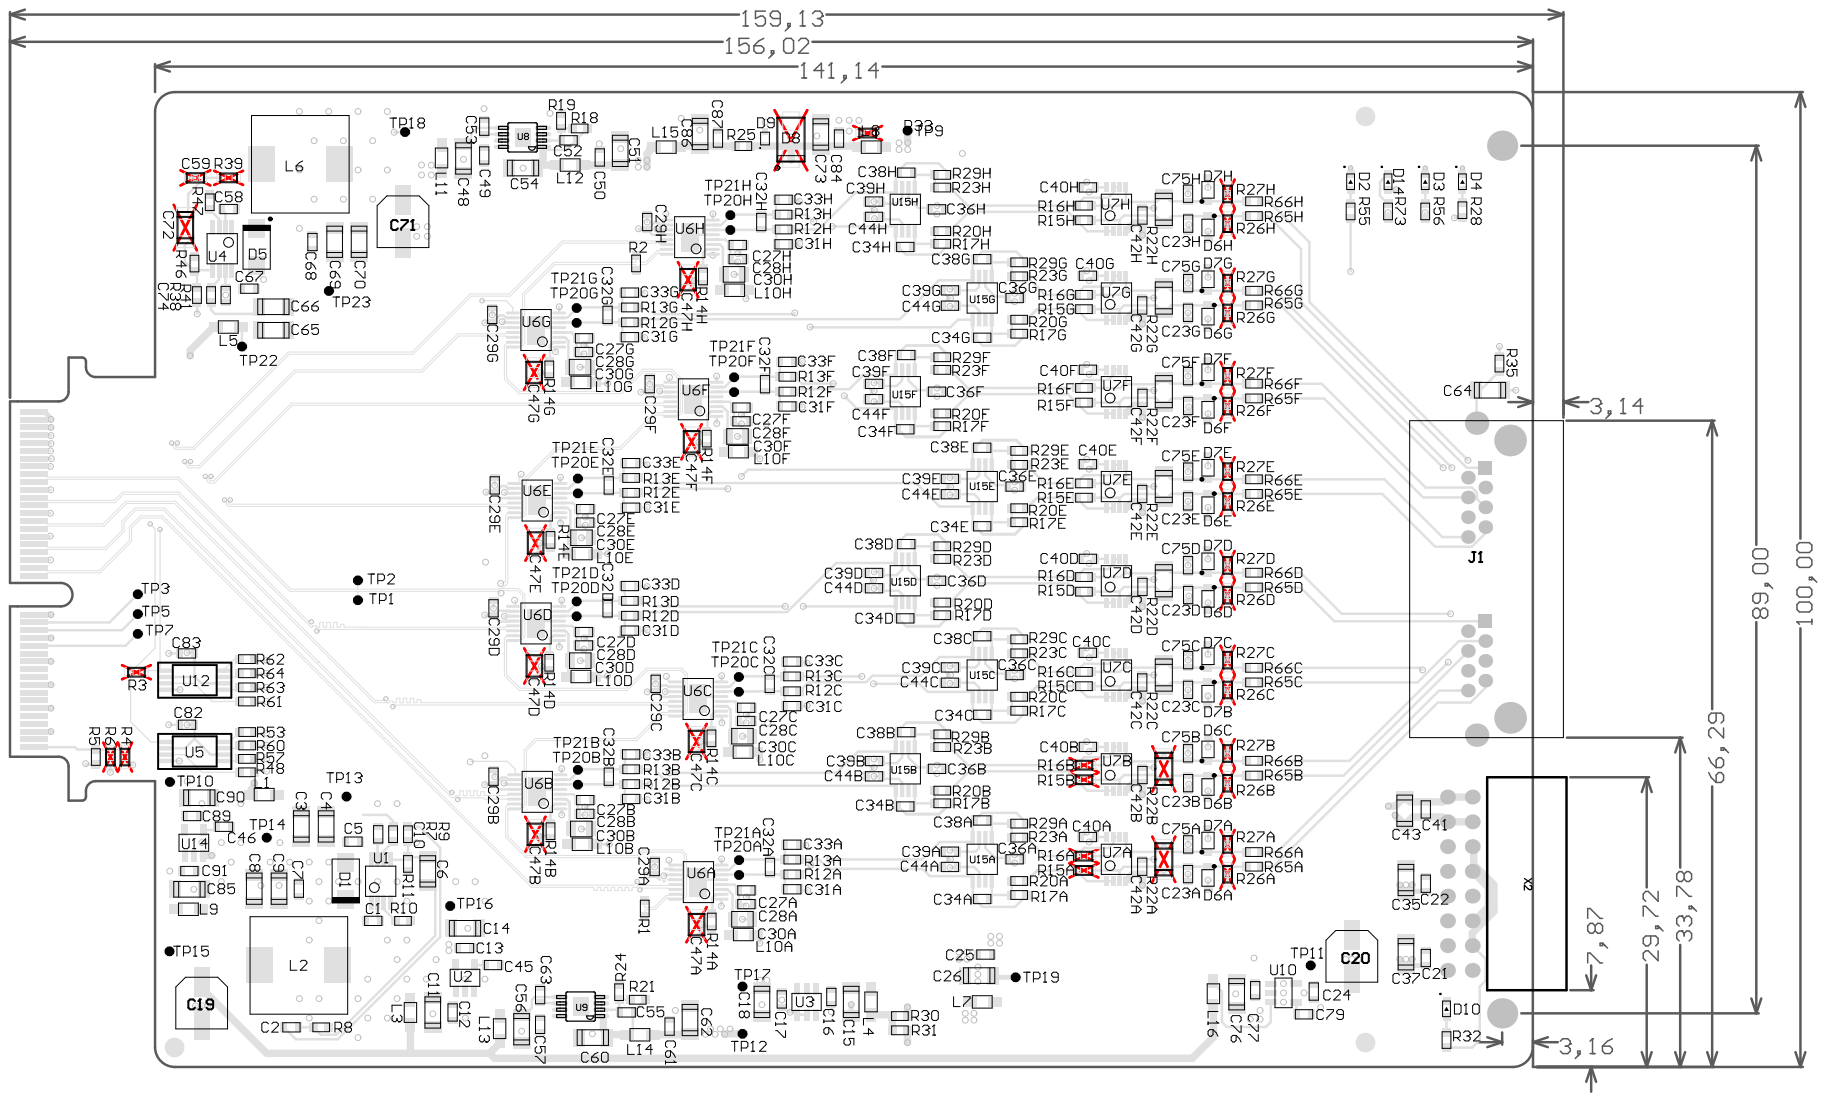
[picture p120: page 1]

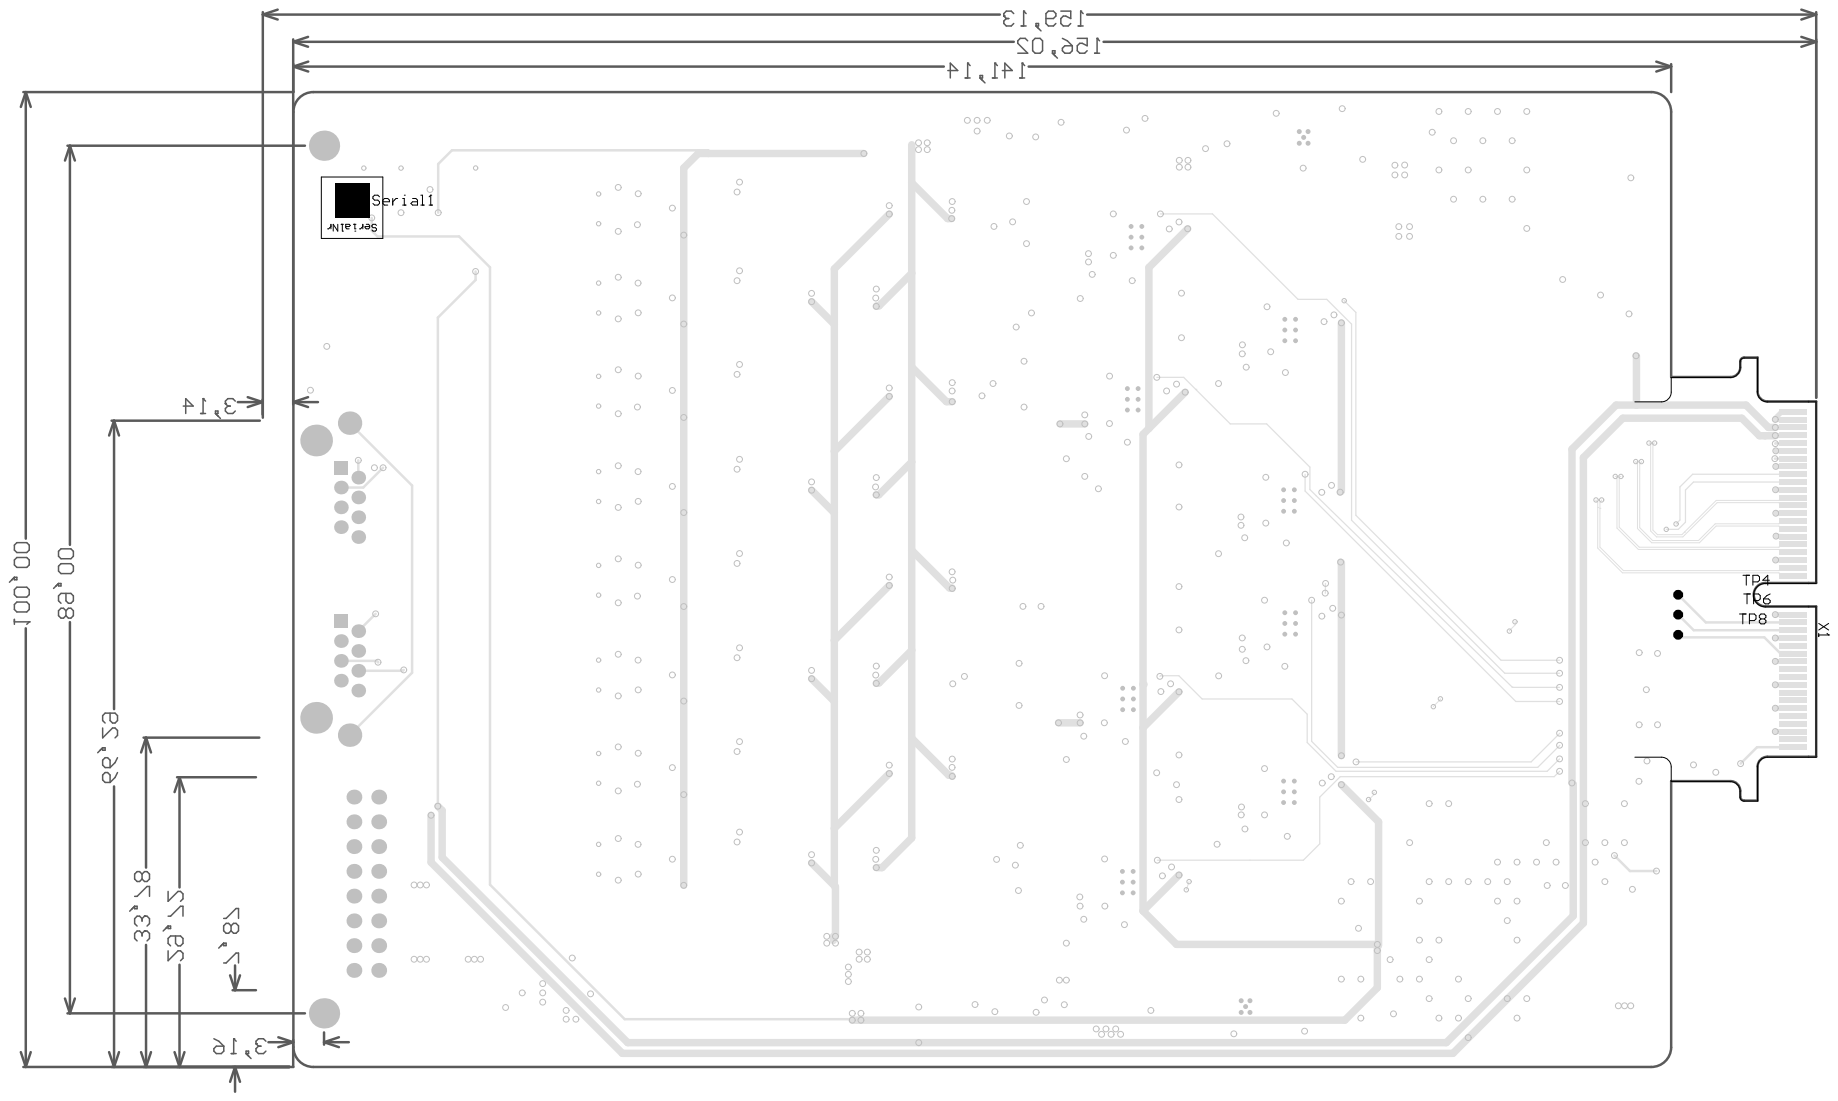
[picture p121: page 2]
