ultrazohm/uz_a_ltc2311-16/LTspice Simulations/schottky_dioge_neg_voltage.asc

C1: cap; 10e-6
D1: schottky; RB521CS-30
I1: current; PULSE(0e-3 5e-3 0.05 1e-9 0 2)
R1: res; 20k
R2: res; 10
V1: voltage; -6.5
Named nets: 0
.tran 0.1
.MODEL DI_SD103CWS D  ( IS=8.65u RS=0.120 BV=20.0 IBV=5.00u 
+ CJO=53.0p  M=0.333 N=1.70 TT=14.4n )
