ultrazohm/uz_a_ltc2311-16/LTspice Simulations/24-V Input and 5-V Output using Buck Converter LM5164.asc

C1: cap; 220µ
C3: cap; 10µ
C4: cap; 47µ
C5: cap; 47µ
Cac: cap; 1.8n; Rser=1m
Cbst: cap; 2.2n; Rser=1
Cbyp: cap; 10µ
Cin: cap; 10µ; Rser=5m
Cout: cap; 22µ; Rser=3.6m
Cr: cap; 3.3n; Rser=785m
L1: ind; 37µ; Rser=5m
Rfbb: res; 10k
Rfbt: res; 32k
Ron: res; 45k
Rout: res; 100
Rr: res; 87k
U1: LM5164-Q1_TRANS
U2: 0805_742792040_600ohm
Vin: voltage; 24
Named nets: 0, OUT
.tran 0.005
