ultrazohm/uz_a_ltc2311-16/LTspice Simulations/24-V Input and -5-V Output Inverting Buck Converter LM5007.asc

C1: cap; 100n
C2: cap; 47µ; V=10
C3: cap; 47µ; V=10
C4: cap; 220µ; V=35
Cac: cap; 0.027µ
CBST: cap; 10n
Cbyp: cap; 0.1µ
CIN1: cap; 10µ; V=35
CIN2: cap; 10µ; V=35
Cr: cap; 7.5n
Cvcc: cap; 1µ; V=25
D1: schottky
L2: ind; 150µ; Rser=1m
R1: res; 100
RCL: res; 133k
RFB1: res; 1k
RFB2: res; 1k
RON: res; 162k
Rr: res; 75k
U1: LM5007_TRANS
U2: 0805_742792040_600ohm
VIN: voltage; 24
Named nets: 0, OUT
.tran 0.005
