ultrazohm/uz_a_ltc2311-16/LTspice Simulations/AnalogLTC2311-16_with_THS4521/LTC2311_Rev05.asc

A1: inv
C1: cap; 10p
C2: cap; 10p
C3: cap; 100p
C4: cap; 100p
C5: cap; {Cdiff}
C9: cap; {Cop}
C10: cap; {Cop}
C11: cap; {Ccm}
C12: cap; {Ccm}
R1: res; {Rop}
R2: res; {Rop}
R3: res; {Rfilt}
R4: res; {Rfilt}
R5: res; {Rop}
R6: res; {Rop}
R7: res; 100
R8: res; 100
R9: res; 15
R10: res; 15
S1: sw; mySW
S2: sw; mySW
S3: sw; mySW
S4: sw; mySW
U1: LT6204
U2: LT6204
U3: THS4561
V1: voltage; PULSE(0 5 171.5n 1n 1n 28.5n 500n)
V2: voltage; -5.4
V3: voltage; 4.8; AC 1
V4: voltage; 5.2
V5: voltage; 0.2
V6: voltage; 2.5
Named nets: SW_ACQ, ADCP, ADCM, 0, SW_CNV, V_ADCin+, V_ADCin-, V_outADCdriver, V_outADCdriverInv, 5V, -Vs, Buffer+, Vin+, Vin-, Buffer-, VCOM
.model mySw SW(Ron=15 Vt=0.5)
SAR ADC input ADC 2 LTC2311 16 Bit 5 MSPS
.tran 0 2000n 0 0.000000001
.param Rop=1k
.param Cop=10p
.param Rfilt=24.9 Ccm=47p Cdiff=470p
.param Rfilt=24.9 Ccm=18n Cdiff=12n
.ac dec 1000 10k 10Meg
.param Rfilt=15 Ccm=470p Cdiff=470p
.param Rfilt=10 Ccm=1000p Cdiff=1000p
