ultrazohm/uz_a_ltc2311-16/LTspice Simulations/buck_boost/Buck_Boost_Constant_on_Time.asc

C1: cap; 300µ
D1: diode; MyIdealDiode
L1: ind; {220u}
R1: res; 10
S1: sw; MySwitch
V1: voltage; PULSE(0 24 1n 10n 10n 100m)
V2: voltage; PULSE(0 1 1n 1n 1n {Ton} {Ton/D})
Named nets: 0
.model MySwitch SW(Ron=.01 Roff=1Meg Vt=0.5)
.param D=0.184 fSW=300k Tsw={1/fSW} Ton=300n
.tran 0 20m {20m-10*Tsw}
.model MyIdealDiode D(Ron=.1 Roff=1Meg Vfwd=.4)
.step param L 100u 500u 50u
