ultrazohm/uz_a_ltc2311-16/(list of files, drawings)

Other design files:
-5V_PCB/PowerManagement_neg5V/Amplifier.SchDoc
-5V_PCB/PowerManagement_neg5V/neg5V.PcbLib
-5V_PCB/PowerManagement_neg5V/neg5V.SCHLIB
-5V_PCB/PowerManagement_neg5V/PCBdesign.SchDoc
-5V_PCB/PowerManagement_neg5V/Power.SchDoc
-5V_PCB/PowerManagement_neg5V/PowerManagement_neg5V.PcbDoc
-5V_PCB/PowerManagement_neg5V/PowerManagement_neg5V.PrjPcb
-5V_PCB/PowerManagement_neg5V/PowerSupply.SchDoc
-5V_PCB/PowerManagement_neg5V/UltraZohm_ADC.SCHLIB
ADC.SchDoc
ADC_Interface_Opamp_NegRail_bu.SchDoc
ADC_Reference.SchDoc
AnalogConnector.SchDoc
CarrierConnector.SchDoc
LTspice Simulations/THS4561/ths4561.dsn
LTspice Simulations/THS4561/ths4561.opj
OpAmp_CH1.SchDoc
OpAmp_CH4.SchDoc
Power_Neg.SchDoc
Power_Pos.SchDoc
TopSheet.SchDoc
UltraZohm_ADC.PrjPCB
UltraZohm_ADC.SCHLIB
UZ_A_LTC2311.PrjPCB
