ultrazohm/uz_a_ltc2311-16/(commit log)

2020-03-24 Inverting buck-boost converter with LM5007 DC/DC (Synchronous) Buck IC (first try to generate -5V)
    [Power.SchDoc]
2020-03-31 Updated Reassinging of system ground
    [Power.SchDoc]
2020-03-31 Refresh Project
    [UltraZohm_ADC.PrjPCB]
2020-03-31 LTspice simulation of 24V to +5V conversion
2020-03-31 LTspice simulation of 24V to -5V conversion
2020-04-06 - moved libraries to main simulation folder and changed absolute path in .asy files - added resistive loads to converter - tried to get -5V running, but failed :) - added gitignore for temp files
2020-04-10 - updated files by using libraries in simulation-folder - 24V to +5V conversion by using a LM5164 synchronous buck converter (not realy smooth voltage-characteristic) - Inverting Buck Converter (to g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
    [LM5007Calculator.xls]
2020-04-23 - created new folder for -5V Power Supply PCB - schematic of voltage-conversion by the using LM5007 - PCB to test the voltage conversion (PCB - still to do: power planes, pin header for external conn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
    [Power.SchDoc, PowerManagement_neg5V.PcbDoc, PowerManagement_neg5V.PrjPcb, UltraZohm_ADC.SCHLIB, neg5V.PcbLib]
2020-04-26 - changed power plane connector style - added vias
    [PowerManagement_neg5V.PcbDoc]
2020-04-28 feedback zur ersten layout version und slides des emv seminars
2020-05-06 added PCBdesign.SchDoc PowerSupply -5V testing pcb: - edited board shape (100x100) - +5V also on pcb - integrated and updated libraries - added netlabels - adjusted Bypass-Capasitor (35V), added addi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
    [Amplifier.SchDoc, PCBdesign.SchDoc, Power.SchDoc, PowerManagement_neg5V.PcbDoc, PowerManagement_neg5V.PrjPcb, PowerSupply.SchDoc, UltraZohm_ADC.SCHLIB]
2020-05-13 Revision of -5V_PowerSupply_PCB: - modified netlabels - input power connector (size, silk screen) - larger input cap for both converters - removed 0R resistors - modified power planes (ground plane o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
    [Amplifier.SchDoc, PCBdesign.SchDoc, PowerManagement_neg5V.PcbDoc, PowerManagement_neg5V.PrjPcb, PowerSupply.SchDoc, UltraZohm_ADC.SCHLIB, neg5V.SCHLIB]
2020-05-14 2nd Revision of -5V_poweSupply_PCB: - new pinout and additional silkscreen for screw terminal - changed polygon connect style (thermal relief) - aligned components and designators - modified footprin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
    [Amplifier.SchDoc, PCBdesign.SchDoc, PowerManagement_neg5V.PcbDoc, PowerManagement_neg5V.PrjPcb, PowerSupply.SchDoc]
2020-05-15 - added bnc input - silk screen rearranged - generated output files
    [Amplifier.SchDoc, BOM_PowerManagement_neg5V_1v03.xls, PCBdesign.SchDoc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]
2020-05-15 last changes
    [BOM_PowerManagement_neg5V_1v03.xls, PowerManagement_neg5V.PcbDoc]
2020-05-15 tiny changes
    [PowerManagement_neg5V.PcbDoc]
2020-05-15 - changed "u" to "my" at capacitors - moved designators (top overlay, mechanical5) - managed component values (for uniform BOM)
    [Amplifier.SchDoc, BOM_PowerManagement_neg5V_1v03.xlsx, PowerManagement_neg5V.PcbDoc, PowerManagement_neg5V.PrjPcb, PowerSupply.SchDoc]
2020-05-21 - changed GND of shielding (Ethernet_Port RJ45) - repositioned jumper resistors next to the voltage follower IC - adapted CarrierConnector (changed board height and Connector-Footprint)
    [AnalogConnector.SchDoc, BOM_PowerManagement_neg5V_1v03.xlsx, Power.SchDoc, UltraZohm_ADC.PrjPCB]
2020-05-22 final project outputs of -5V pcb
    [BOM_PowerManagement_neg5V_1v03.xls, BOM_PowerManagement_neg5V_1v03_Eyke.xls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]
2020-06-04 added buck boost simulation with constant on time
2020-06-16 - set PD to logic high (+5V, 0.3mm trace) - new Gain Components for diff_amp: Rf, Rg = 10k, 0.1% - Minimum Ripple Configuration disabled (Rr, Cr, Cac: dnp) - added TUM-Logo - Warning of THS4521 suppl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
    [Amplifier.SchDoc, PCBdesign.SchDoc, PowerManagement_neg5V.PrjPcb, PowerSupply.SchDoc, neg5V.SCHLIB]
2020-06-21 - corrected crossover frequency formula (silkscreen on pcb) - improved routing of traces to the carrier-connector
    [PowerManagement_neg5V.PrjPcb]
2020-06-23 - LTspice simulation for the AnalogLTC2311-16 with the THS4521 as on the -5V-Testing-PCB - Single-ended-Measurements: ADC_LTC2311-16_-5V_Testing_PCB_FBresistors (Excel sheet) - Silkscreen (gain/resis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
    [ADC_LTC2311-16_-5V_Testing_PCB_FBresistors.xlsx, LM5007Calculator.xls, PowerManagement_neg5V.PrjPcb]
2020-07-12 1. new folder with measurements of -5V_testing_PCB 2. -5V_testing_PCB changes: - added 100Ohm input series resistors, 100pF input capacitors, transient voltage supressors (GBLCxx) - modified bottom o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
    [ADC_LTC2311-16_-5VTestingPCB_ExternalPowerSupply_FBresistors.xlsx, ADC_LTC2311-16_-5VTestingPCB_InternalPowerSupply_5.0Vrails.xlsx, ADC_LTC2311-16_-5VTestingPCB_InternalPowerSupply_5.2Vrails.xlsx, ADC_LTC2311-16_-5V_Testing_PCB_FBresistors.xlsx, Amplifier.SchDoc, PowerManagement_neg5V.PrjPcb, PowerSupply.SchDoc, neg5V.SCHLIB]
2020-07-14 - created rooms (and component classes) on -5V_testing_PCB: +5V, -5V, amplifier_circuit - updated UltraZohm_ADC.SCHLIB and UltraZohm_PcbLib with missing components
    [UltraZohm_ADC.SCHLIB]
2020-07-14 update pcb
    [ADC.SchDoc]
2020-07-16 added components (schematic and PCB) for 24V to -5V conversion by using a buck-boost converter to the UltraZohm project (next steps: routing, placement, ... )
    [Power.SchDoc, UltraZohm_ADC.PrjPCB]
2020-07-17 placed buck-boost converter on PCB, added Polygons [D [D [D [D [D [D [D [D [D [D [D [D [D [D [D [D [D [D [D [D [D [D [D [D [D [D [D [D [D [D [D [D [D [D [D [D [D [D [D [D [D [D [Dand routed buck-boos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
    [AnalogConnector.SchDoc, CarrierConnector.SchDoc, Power.SchDoc, UltraZohm_ADC.SCHLIB]
2020-07-23 - completed output buffer for conversion pin - realigned designators and schematic-commits - corrected some errors (design rule check) - added capacitors to voltage followers - added AnalogConnector 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
    [ADC.SchDoc, AnalogConnector.SchDoc, CarrierConnector.SchDoc, OpAmp.SchDoc, Power.SchDoc, TopSheet.SchDoc, UltraZohm_ADC.SCHLIB]
2020-07-24 added resistors, capacitors and suppressor diodes at signal inputs
    [OpAmp.SchDoc]
2020-07-24 added -5v_LED, 100nF buffer bypass caps, testpoints, changed VCC to 2.5V
    [ADC.SchDoc, AnalogConnector.SchDoc, CarrierConnector.SchDoc, OpAmp.SchDoc, Power.SchDoc, UltraZohm_ADC.PrjPCB, UltraZohm_ADC.SCHLIB]
2020-07-27 GND stiching and 3.3V connection fixed
    [AnalogConnector.SchDoc, CarrierConnector.SchDoc]
2020-07-27 modified component parameters (for uniform BOM) and top overlay of the PCB
    [ADC.SchDoc, AnalogConnector.SchDoc, BOM_UltraZohm_ADC_3v02.xlsx, OpAmp.SchDoc, Power.SchDoc, UltraZohm_ADC.PrjPCB]
2020-07-28 changed bus structure for CVN_A B[1..4]
    [CarrierConnector.SchDoc]
2020-07-28 updated schematic template
    [ADC.SchDoc, AnalogConnector.SchDoc, CarrierConnector.SchDoc, OpAmp.SchDoc, Power.SchDoc, TopSheet.SchDoc, UltraZohm_ADC.PrjPCB]
2020-07-31 new measurements of the test-PCB: - Best-fit curve - Buffer LT6203 - Alternatives for input buffer
    [ADC_LTC2311-16_-5VTestingPCB_ExternalPowerSupply_VoltageFollowers.xlsx, ADC_LTC2311-16_-5VTestingPCB_InternalPowerSupply_5.2Vrails.xlsx, ADC_LTC2311-16_-5VTestingPCB_InternalPowerSupply_5.2Vrails_BestFitCurve.xlsx, ADC_LTC2311-16_-5VTestingPCB_InternalPowerSupply_BufferLT6203.xlsx]
2020-08-21 -added 2x2 pin headers after buffer amplifiers - changed output filter (133kHz) - replaced some designators - moved LEDs downward - changed resistors behind conversion buffer to 4.99 Ohm - ...
    [ADC.SchDoc, AnalogConnector.SchDoc, CarrierConnector.SchDoc, OpAmp.SchDoc, Power.SchDoc, UltraZohm_ADC.PrjPCB]
2020-08-25 Reordered FPGA Pins to use only one clock -- Issue 31
    [CarrierConnector.SchDoc, TopSheet.SchDoc]
2020-08-26 - added notification for using bidirectional TVS diodes - created new variation BUFFER SHARED CONVERSION - modified notification for resistor assembly for different conversion-variations - replaced 1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
    [CarrierConnector.SchDoc, OpAmp.SchDoc, UltraZohm_ADC.PrjPCB, UltraZohm_ADC.SCHLIB]
2020-08-26 few changes concerning the last commit: modified notifications in schematic, changed names of variations, flipped R_config
    [CarrierConnector.SchDoc, OpAmp.SchDoc, UltraZohm_ADC.PrjPCB]
2020-08-27 changed 3way jumper foot print
2020-09-01 updated schematics to optimize BOM
    [ADC.SchDoc, AnalogConnector.SchDoc, CarrierConnector.SchDoc, OpAmp.SchDoc, Power.SchDoc, UltraZohm_ADC.PrjPCB, UltraZohm_ADC.SCHLIB]
2020-09-02 round edges replaced TVS diode replaced THT caps optimized BOM
    [AnalogConnector.SchDoc, BOM_UltraZohm_ADC_3v02.xlsx, OpAmp.SchDoc, Power.SchDoc, UltraZohm_ADC.SCHLIB]
2020-09-02 ordered this version 3v3 at JLCPCB and sent this BOM to Haushofer for ordering the parts
    [BOM_UltraZohm_ADC_3v03.xls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]
2020-09-02 saved project file
    [UltraZohm_ADC.PrjPCB]
2020-09-03 changes to fix production error, some traces were too close to each other -violating the rules of JLCPCB
    [AnalogConnector.SchDoc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]
2020-09-29 - comparison of buffer amplifiers LT6203 vs. ADA4807 on UltraZohm Analog LTC2311-16 3v2: "ADC_LTC2311-16_3v2_BufferAmplifiers" - LTspice simulation with THS4521, especially for adjusting the anti-ali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
    [ADC_LTC2311-16_3v2_BufferAmplifiers.xlsx]
2020-10-05 updated bestuecker files to fix voltage level of the level shifter of conversion pins with bodge wire fix on the pcb
    [AnalogConnector.SchDoc, BOM_UltraZohm_ADC_3v03.xls, Power.SchDoc, UltraZohm_ADC.PrjPCB]
2021-03-10 first try, but sketchy :)
    [ADC.SchDoc, TopSheet.SchDoc, UltraZohm_ADC.PrjPCB]
2021-03-10 i think i fixed it :)
    [ADC.SchDoc, CarrierConnector.SchDoc, TopSheet.SchDoc]
2021-03-10 fixed it - nice :)
    [ADC.SchDoc, CarrierConnector.SchDoc, Power.SchDoc, TopSheet.SchDoc]
2021-03-10 slight clean ups
    [CarrierConnector.SchDoc, Power.SchDoc]
2021-03-10 saved project
    [UltraZohm_ADC.PrjPCB]
2021-03-10 - added LM7705 component to libraries (CMP-0064-00159-3) - generation of -0.23V to implement true zero volts for differential amps using the LM7705 (+ C24, C73, C84, C85, C86, C87, C88, L8, TP9) - re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
    [OpAmp.SchDoc, Power.SchDoc, UltraZohm_ADC.PrjPCB, UltraZohm_ADC.SCHLIB]
2021-03-11 - modified generation of -0.23V: 22uF at CRES and Vout of LM7705 - modified CMP-0064-00159-3 (LM7705) component to have no footprint-elements on M13 layer
    [Power.SchDoc, UltraZohm_ADC.PrjPCB, UltraZohm_ADC.SCHLIB]
2021-03-12 - added TLV74118PDBVR 1.8V LDO to libraries - implemented circuit to generate +1.8V using the TLV74118 on Power.SchDoc - changed CDCLVC1104 supply voltage and 1G enable connect to 1.8V - removed L7
    [CarrierConnector.SchDoc, Power.SchDoc, UltraZohm_ADC.SCHLIB]
2021-03-13 designed pcb layout of new CNV buffer power supply (1.8V)
2021-03-13 updated component description (parameters, links) of RJHSE-5380-02 and the corresponding parts on schematic
    [AnalogConnector.SchDoc, UltraZohm_ADC.PrjPCB, UltraZohm_ADC.SCHLIB]
2021-03-13 - rerouted CVN_A and CVN_B trace - updated components: added/modified links, i.e. manufacturer and datasheet, in description (142-0701-801, 1714955, 1725656, 5-1634503-1, 5006, B82464G4154M, BYS12-90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
    [CarrierConnector.SchDoc, Power.SchDoc, UltraZohm_ADC.PrjPCB, UltraZohm_ADC.SCHLIB]
2021-03-14 - Replaced op amps with single channel version THS4521 on schematic - TO DO: update PCB and place&route single channel op amps on PCB
    [OpAmp.SchDoc, UltraZohm_ADC.PrjPCB]
2021-03-15 Replaced op amps with single channel version THS4521: - updated PCB - created component classes DiffAmp1 ... DiffAmp8 - created room definitions DiffAmp1 ... DiffAmp8 - place & route within DiffAmp-R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
2021-03-16 Replaced op amps with single channel version THS4521: - placed and routed op amps (part A and B) - tuned trace lengths (of diff. pairs) - TO DO: remove GND and power plane directly under the amplifie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
2021-03-16 Replaced op amps with single channel version THS4521: - removed GND and power plane directly under the amplifiers - rearranged designators (top overlay and M5)
    Rerouted CLK_N and CLK_P trace (former violation)
2021-03-17 wrapped orthogonal schematic-rooms around components
    [UltraZohm_ADC.PrjPCB]
2021-03-20 corrected cutoff frequency formula on bottom overlay
    [UltraZohm_ADC.PrjPCB]
2021-03-20 updated components: added/modified links, i.e. manufacturer and datasheet, in description (HSEC8-140-01-XX-DV-A-BL, LED_YELLOW_0603, LM5007, LT6202C, LT6203_MSOP8, LT6654, LTC2311-16, THS4521IDGKR, T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
    [ADC.SchDoc, CarrierConnector.SchDoc, OpAmp.SchDoc, Power.SchDoc, UltraZohm_ADC.PrjPCB, UltraZohm_ADC.SCHLIB]
2021-03-22 supplied TLV741P18P (for generation of 1.8V) with VCC=5V -> placed 1.8V power supply beneath CNV buffers
    [Power.SchDoc, UltraZohm_ADC.PrjPCB]
2021-03-24 -updated schematic template - added ultrazohm logo - page numbering update
    [ADC.SchDoc, AnalogConnector.SchDoc, CarrierConnector.SchDoc, OpAmp.SchDoc, Power.SchDoc, TopSheet.SchDoc, UltraZohm_ADC.PrjPCB]
2021-03-25 - modified op_amp to 1 channel per sheet and updated pcb accordingly
    [ADC.SchDoc, AnalogConnector.SchDoc, CarrierConnector.SchDoc, OpAmp.SchDoc, OpAmp_CH1.SchDoc, OpAmp_CH4.SchDoc, Power.SchDoc, TopSheet.SchDoc]
2021-03-28 - started editing silk screen on top overlay (opamp-boxes) - changed signal denomination (AIN_N, AIN_P) and modified top sheet to get clearity and to resolve violations
    [AnalogConnector.SchDoc, OpAmp_CH1.SchDoc, TopSheet.SchDoc, UltraZohm_ADC.PrjPCB]
2021-03-28 - generated LMK1C1104 as component in schematic-library with FP-PW0008A-MFG footprint - replaced CNV buffers (LMK1C1104 instead of CDCLVC1104)
    [CarrierConnector.SchDoc, UltraZohm_ADC.PrjPCB, UltraZohm_ADC.SCHLIB]
2021-03-31 rearragned op amp circuits to align
    [UltraZohm_ADC.PrjPCB]
2021-04-21 - reworked power supplies to use LDOs - added simulation for adc kick-back
    [ADC.SchDoc, CarrierConnector.SchDoc, OpAmp_CH1.SchDoc, Power.SchDoc, Power_Neg.SchDoc, TopSheet.SchDoc, UltraZohm_ADC.SCHLIB]
2021-04-23 working on pcb
    [OpAmp_CH1.SchDoc, Power.SchDoc, UltraZohm_ADC.PrjPCB]
2021-04-28 finalized rev04 and renamed project
    [AnalogConnector.SchDoc, CarrierConnector.SchDoc, OpAmp_CH1.SchDoc, Power.SchDoc, Power_Neg.SchDoc, TopSheet.SchDoc, UZ_A_LTC2311.PrjPCB, UltraZohm_ADC.SCHLIB]
2021-04-28 rerouted LVDS signals with 100R trace impedance
    [CarrierConnector.SchDoc, Power_Neg.SchDoc, UZ_A_LTC2311.PrjPCB]
2021-04-29 added production files for Rev04
    [ADC_Reference.SchDoc, BOM_UltraZohm_ADC_3v02_Eyke.xls, BOM_UltraZohm_ADC_3v03_2.xls, BOM_UltraZohm_ADC_3v03_Eyke.xls, Bill of Materials-UZ_A_LTC2311(Standard).xls, PickPlace_UZ_A_LTC2311_Rev04.csv, TopSheet.SchDoc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]
2021-05-17 updated variants.
    [ADC_Reference.SchDoc, AnalogConnector.SchDoc, Bill of Materials-UZ_A_LTC2311(Standard).xls, Bill of Materials-UZ_A_LTC2311_Eyke.xls, CarrierConnector.SchDoc, OpAmp_CH1.SchDoc, Power_Neg.SchDoc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]
2021-06-23 small redesign after assembling Rev04 once
    [ADC.SchDoc, ADC_Reference.SchDoc, AnalogConnector.SchDoc, CarrierConnector.SchDoc, OpAmp_CH1.SchDoc, Power_Neg.SchDoc, UZ_A_LTC2311.PrjPCB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]
2021-06-25 production files for Rev05
    [ADC_Interface_Opamp_NegRail_bu.SchDoc, Bill of Materials-UZ_A_LTC2311(Standard).xls, Bill of Materials-UZ_A_LTC2311_Eyke.xls, UZ_A_LTC2311.PrjPCB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]
2021-07-04 - fixed clearances after review of JLC falied - regenerated all production files and send them into produciton
    [PickPlace_UZ_A_LTC2311_Rev05.csv, UZ_A_LTC2311.PrjPCB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]
2021-09-17 final production files for Rev.05
    [ADC.SchDoc, ADC_Reference.SchDoc, AnalogConnector.SchDoc, BOM_UltraZohm_ADC_3v03.xls, Bill of Materials-UZ_A_LTC2311(Standard).xls, Haushofer_Beistellung.xlsx, OpAmp_CH1.SchDoc, PickPlace_UZ_A_LTC2311_Rev05.csv]
2022-01-25 update to Rev06 by using LMK1C1108, see issue #57
    [ADC.SchDoc, CarrierConnector.SchDoc, Haushofer_Beistellung_Sept2021.xlsx, OpAmp_CH1.SchDoc, Power_Neg.SchDoc, UZ_A_LTC2311.PrjPCB, UltraZohm_ADC.SCHLIB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]
2022-01-25 production files rev 06
    [Bill of Materials-UZ_A_LTC2311(Standard).xls, UZ_A_LTC2311.PrjPCB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]
2022-02-14 beistellungsliste für haushofer
    [Haushofer_Beistellung_März2022.xlsx]
2022-02-18 updated beistellung
    [Haushofer_Beistellung_März2022.xlsx]
2022-02-22 updated haushofer part provision list
    [Haushofer_Beistellung_März2022.xlsx]
2023-04-14 - fix issue that forced the manual drill/remove of a via. - repour all polygons was the fix -fml
2024-04-03 add EEPROM
    [CarrierConnector.SchDoc, UZ_A_LTC2311.PrjPCB]
2024-04-03 routing of EEPROM
    [AnalogConnector.SchDoc, CarrierConnector.SchDoc]
2024-04-03 generate BOM
    [Bill of Materials-UZ_A_LTC2311(Standard).xls, CarrierConnector.SchDoc]
2024-04-09 generate output files
    [Bill of Materials-UZ_A_LTC2311(Standard).xls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]
2024-04-09 TopOverlay cosmetic; Gerber File generation
    [UltraZohm_ADC.GBL, UltraZohm_ADC.GBO, UltraZohm_ADC.GBP, UltraZohm_ADC.GBS, UltraZohm_ADC.GM1, UltraZohm_ADC.GTL, UltraZohm_ADC.GTO, UltraZohm_ADC.GTP]
2024-04-18 generate output for assembly
    [Bill of Materials-UZ_A_LTC2311(Standard).xls]
2024-10-15 added alignment holes for jlc pcb production, otherwise identical to Rev07
    [TopSheet.SchDoc, UZ_A_LTC2311.PrjPCB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]
2024-11-28 fix X1 position and PCB outline on M1
    close issue #61
2024-11-28 add M6 to output job to verify alignment of X1 outline and M1
    increment rev number to 09 for next production run
    [UZ_A_LTC2311.PrjPCB]
